markyen001/DR4/IMG_20181126_221511.jpg

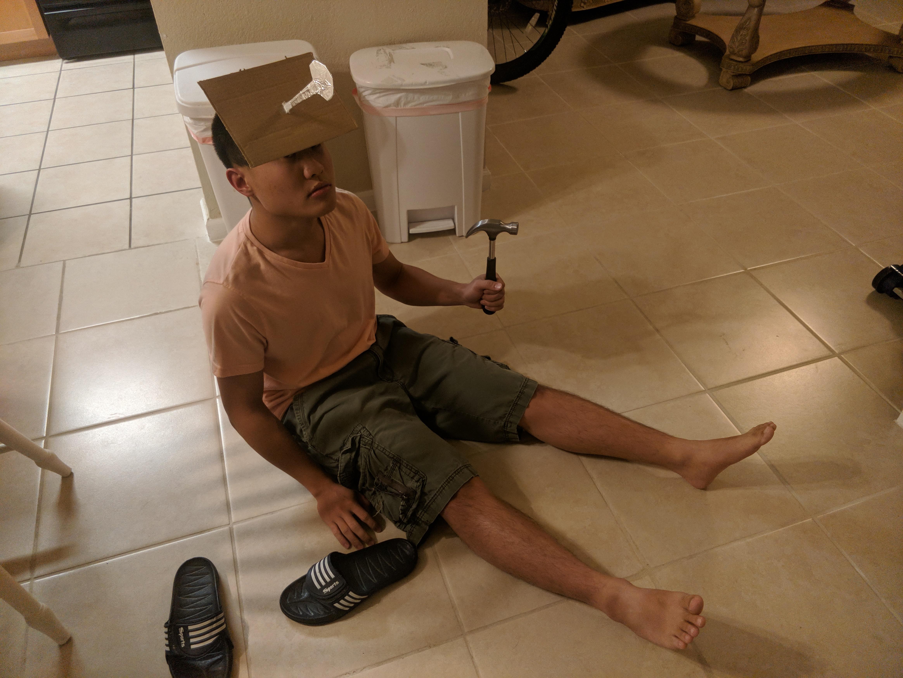
IMG_20181126_221511.jpg
