markyen001/DR4/IMG-1021442271.jpg

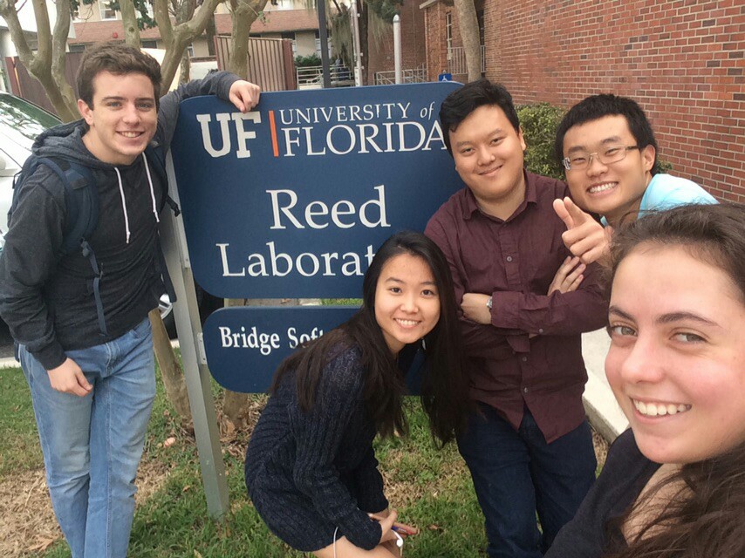
IMG-1021442271.jpg
