markyen001/DR4/Cover Pages.docx

Appendix E: Final Budget & Purchase Orders

Appendix F: Engineering Change Notice Forms

Appendix H: Final Assembly Drawings & BOM
