markyen001/DR4/Memes.docx

When you pull a few all-nighters in succession for a DR submission.

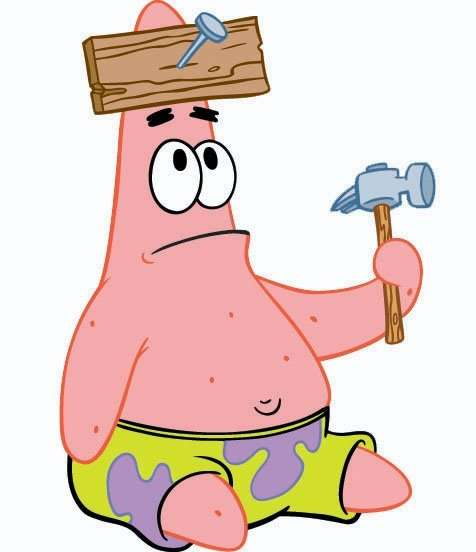
[picture p3: figure]
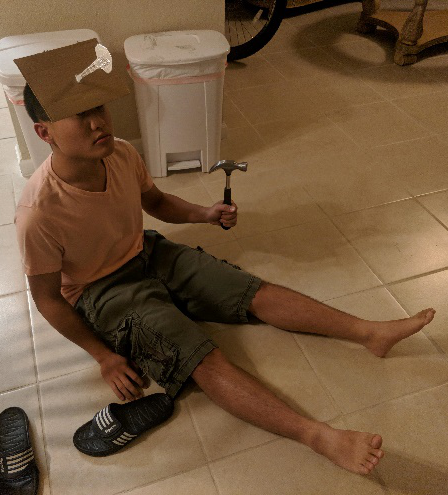
[picture p4: figure]
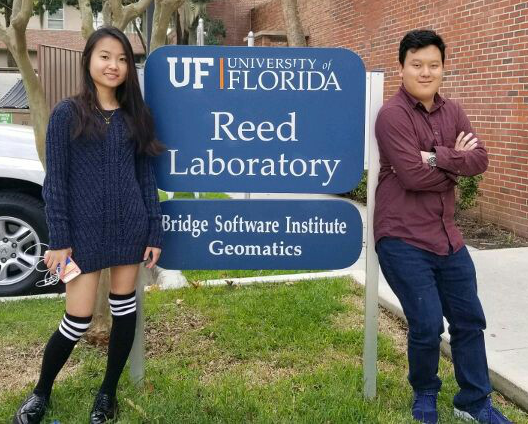
[picture p5: figure]
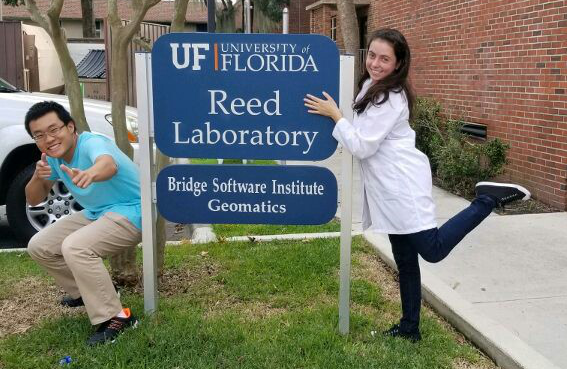
[picture p6: figure]
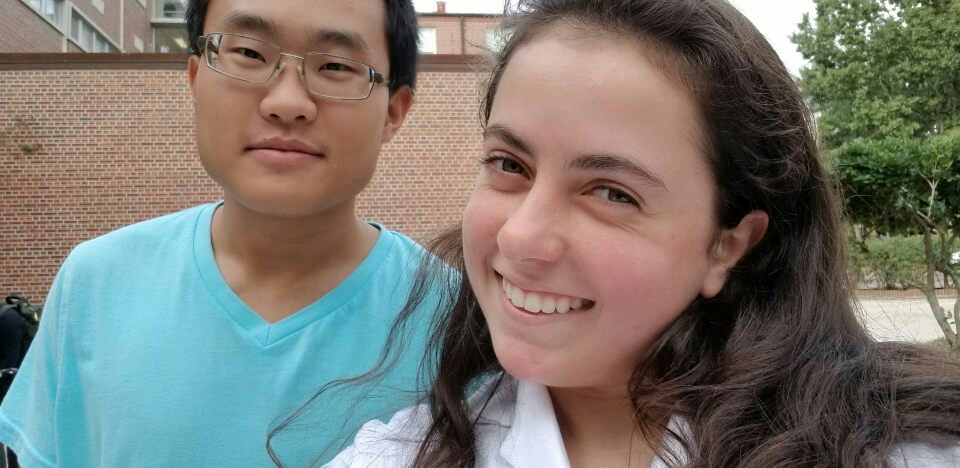
[picture p7: figure]
