markyen001/DR4/IMG714396138.jpg

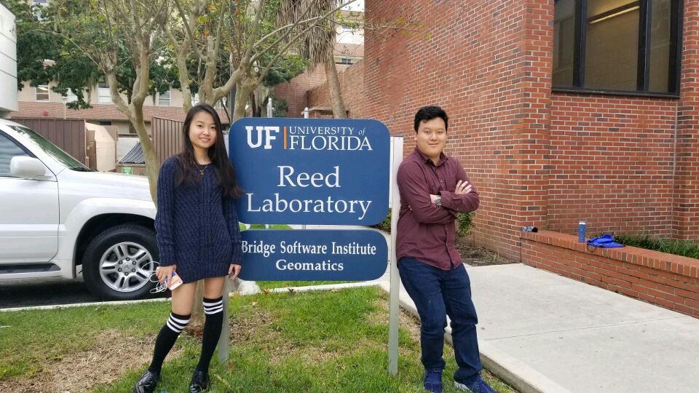
IMG714396138.jpg
