markyen001/DR4/IMG-729822996.jpg

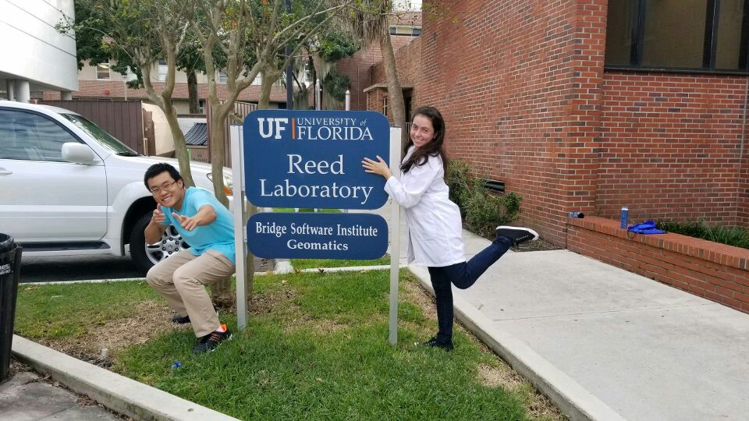
IMG-729822996.jpg
