markyen001/DR4/Drawings for PRINT/order of documents.docx

1. 0001 – 80/20 EXTRUSION
2. TITANIUM COUNTERWEIGHT
3. RUBBER PADS
4. A9 – BALL MANIPULATOR TOTAL ASSEMBLY
  a. 0034 – BALL MANIPULATOR CHANNEL
  b. A6 – CLAW ASSEMBLY
    i. 0004 – 80/20 90 DEG ANGLE BRACKET
    ii. 0007 – 80/20 STRAIGHT BRACKET
    iii. 0037 – 80/20 LINEAR SLIDE
    iv. 0039 – 10-24 LINEAR ACTUATOR MOUNT
    v. 0040 – 30 IPM SPAL LINEAR ACTUATOR (2in)
  c. A7 – CLAW MOUNT
  d. A8 – GLOBE MOTOR BRACKET ASSEMBLY
  e. A12 – 4.5 RPM GLOBE MOTOR
5. A16 – PLATFORM WITH BOX/HOPPER/BUCKET
  a. A14 – HOPPER/BUCKET ASSEMBLY
    i. A5 – BUCKET MANIPULATOR TOTAL ASSEMBLY
      1. A4 – BUCKET MANIPULATOR
        a. A10 – 90-DEGREE BRACKET ASSEMBLY
        b. A11 – STRAIGHT BRACKET ASSEMBLY
    ii. A13 – HOPPER ASSEMBLY
      1. 0018 – BALL HOPPER
  b. A15 – PLATFORM WITH CONTROL BOX
    i. 0017 – CONTROL BOX
    ii. A3 – PLATFORM WITH WHEELS
      1. 0016 – 5 in CASTER WHEEL
      2. A1 – MOBILE PLATFORM FRAME
      3. A2 – WHEEL AND MOTOR ASSEMBLY
        a. 0008 – 44 RPM ENTSTORT RIGHT ANGLE MOTOR
        b. 0009 – ENTSTORT MOTOR MOUNT
        c. 0011 – DRIVE WHEEL HUB
        d. 0012 – 10 in WHEEL
