markyen001/DR4/Drawings for PRINT/Assembly BOM.xls

ITEM NO. | PART NUMBER | DESCRIPTION | QTY.
A0 | EML2322L-A-000 | FINAL TOTAL ASSEMBLY | 1
A1 | EML2322L-A-001 | MOBILE PLATFORM FRAME ASSEMBLY | 1
A2 | EML2322L-A-002 | WHEEL AND MOTOR ASSEMBLY | 1
A3 | EML2322L-A-003 | PLATFORM WITH WHEELS ASSEMBLY | 1
A4 | EML2322L-A-004 | BUCKET MANIPULATOR ASSEMBLY | 1
A5 | EML2322L-A-005 | BUCKET MANIPULATOR TOTAL ASSEMBLY | 1
A6 | EML2322L-A-006 | CLAW ASSEMBLY | 1
A7 | EML2322L-A-007 | CLAW MOUNT ASSEMBLY | 1
A8 | EML2322L-A-008 | GLOBE MOTOR BRACKET ASSEMBLY | 1
A9 | EML2322L-A-009 | BALL MANIPULATOR TOTAL ASSEMBLY | 1
A10 | EML2322L-A-010 | 90-DEGREE BRACKET ASSEMBLY | 1
A11 | EML2322L-A-011 | STRAIGHT BRACKET ASSEMBLY | 1
A12 | EML2322L-A-012 | 4.5 RPM GLOBE MOTOR ASSEMBLY | 1
A13 | EML2322L-A-013 | HOPPER ASSEMBLY | 1
A14 | EML2322L-A-014 | HOPPER/BUCKET ASSEMBLY | 1
A15 | EML2322L-A-015 | PLATFORM WITH CONTROL BOX ASSEMBLY | 1
A16 | EML2322L-A-016 | PLATFORM WITH BOX/HOPPER/BUCKET ASSEMBLY | 1
