markyen001/DR4/Part and Assembly Files/BM MASTER ASM.SLDASM

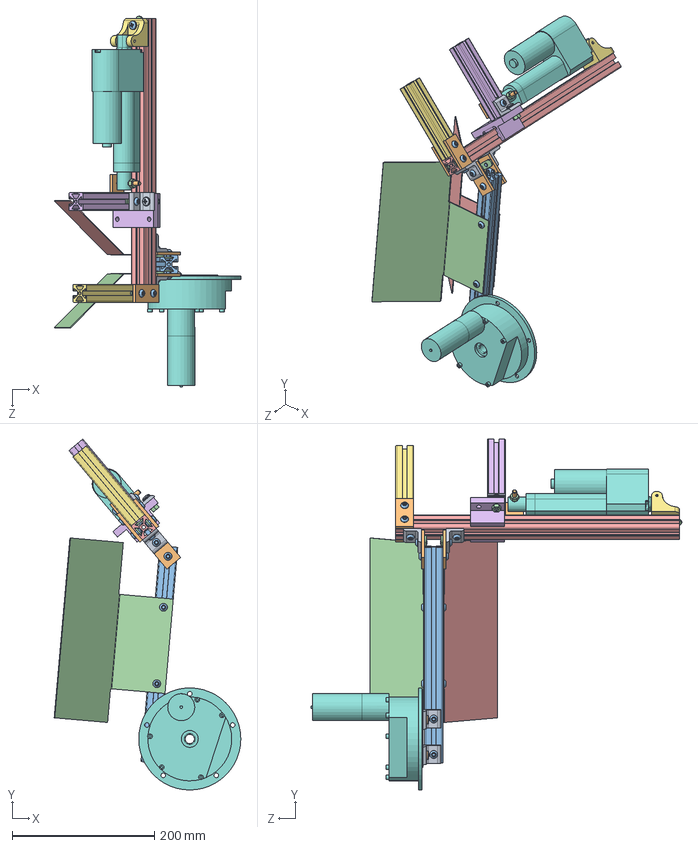
[picture p10: CAD file, 2018-11-24]
Part and Assembly Files/BM MASTER ASM.SLDASM
262.6 x 493.8 x 521.4 mm
80-20 90 Degree Angle Bracket x 5
80-20 Straight Bracket x 5
0.25-20 Button Head Cap Screw (BHCS) x 18
80-20 0.25-20 T-NUT x 17
BM 8020
80-20 Linear Slide
Linear Actuator Mount (10-24)
30 IPM Spal Linear Actuator (2in)
90272A540_ZINC-PLTD STL PAN HEAD PHILLIPS MACHINE SCREW
91306A281_ZINC-PLATED ALLOY STEEL BUTTON-HEAD CAP SCREW
90272A539_ZINC-PLTD STL PAN HEAD PHILLIPS MACHINE SCREW
94895A029_ZINC YELLOW-CHROMATE PLATED STEEL HEX NUT x 2
91251A249_BLACK-OXIDE ALLOY STEEL SOCKET HEAD SCREW
80-20 Extrusion 4.5 inch
80-20 Extrusion 5 inch (simplified)
4.5 RPM Globe Gear Motor
4.5 RPM Globe Gear Motor Face Hub
M6x1 - 12mm GLOBE MOTOR SCREW x 2
BM ARM
BM ARM CHANNEL GM SIDE
BM ARM CHANNEL LEFT, ECN 15
