markyen001/DR4/Part and Assembly Files/BM Mounting SUBASM.SLDASM

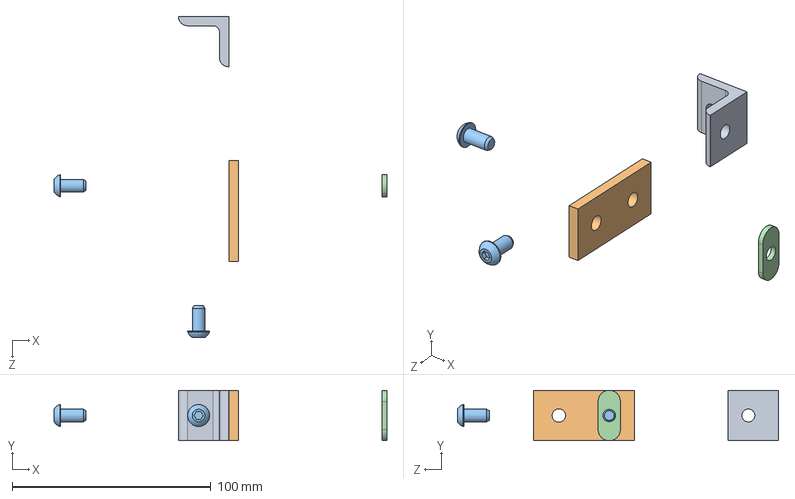
[picture p11: CAD file, 2018-11-24]
Part and Assembly Files/BM Mounting SUBASM.SLDASM
167.6 x 25.4 x 161.7 mm
80-20 90 Degree Angle Bracket
80-20 Straight Bracket
0.25-20 Button Head Cap Screw (BHCS) x 2
80-20 0.25-20 T-NUT
