markyen001/DR4/Globe Motor Drawings/4.5 RPM Globe Gear Motor Assembly.SLDASM

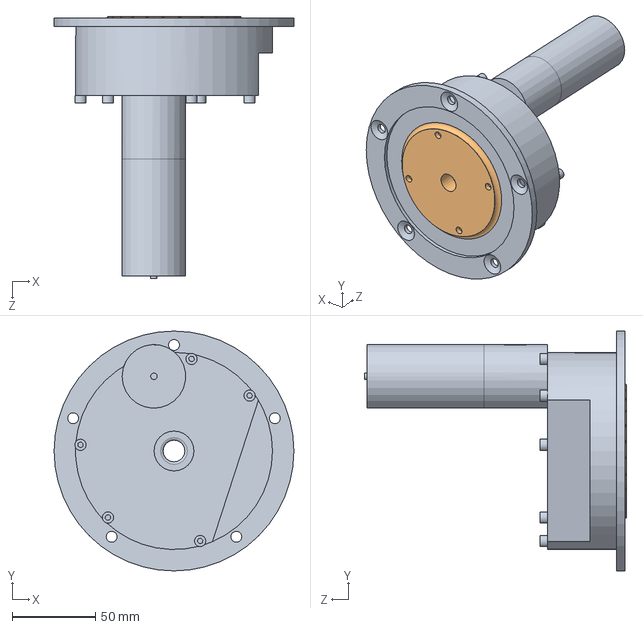
[picture p12: CAD file, 2018-11-23]
Globe Motor Drawings/4.5 RPM Globe Gear Motor Assembly.SLDASM
143.6 x 143.6 x 156.9 mm
4.5 RPM Globe Gear Motor
4.5 RPM Globe Gear Motor Face Hub
