markyen001/DR4/Part and Assembly Files/BM Claw SUBASM.SLDASM

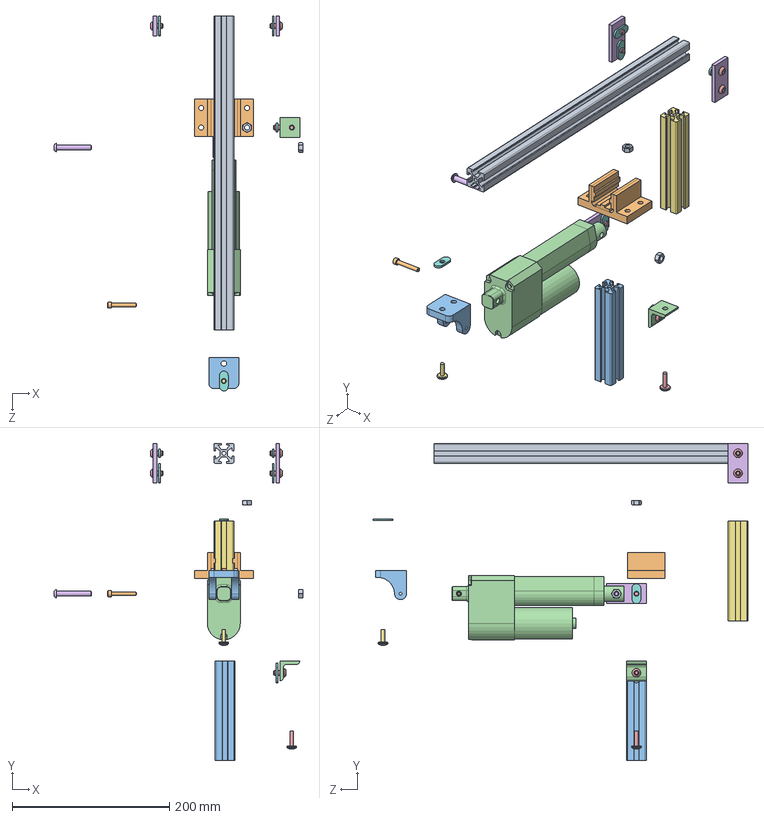
[picture p13: CAD file, 2018-11-24]
Part and Assembly Files/BM Claw SUBASM.SLDASM
316.6 x 403.7 x 476.9 mm
BM 8020
80-20 Linear Slide
Linear Actuator Mount (10-24)
30 IPM Spal Linear Actuator (2in)
90272A540_ZINC-PLTD STL PAN HEAD PHILLIPS MACHINE SCREW
91306A281_ZINC-PLATED ALLOY STEEL BUTTON-HEAD CAP SCREW
90272A539_ZINC-PLTD STL PAN HEAD PHILLIPS MACHINE SCREW
80-20 0.25-20 T-NUT x 7
94895A029_ZINC YELLOW-CHROMATE PLATED STEEL HEX NUT x 2
91251A249_BLACK-OXIDE ALLOY STEEL SOCKET HEAD SCREW
80-20 Extrusion 4.5 inch
80-20 90 Degree Angle Bracket
0.25-20 Button Head Cap Screw (BHCS) x 6
80-20 Straight Bracket x 3
80-20 Extrusion 5 inch (simplified)
