markyen001/DR4/Part and Assembly Files/Bucket Manipulator Total Assembly.SLDASM

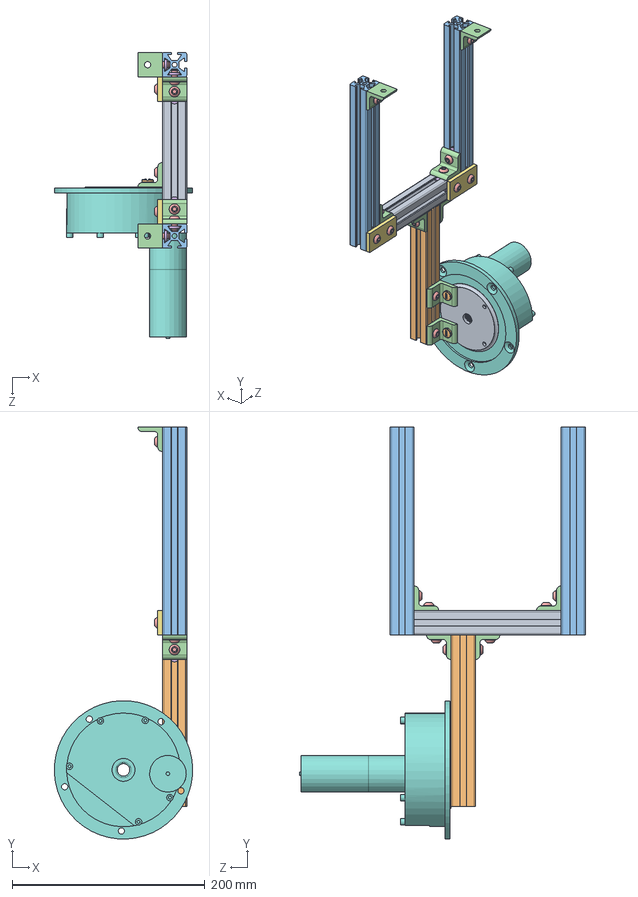
[picture p14: CAD file, 2018-11-23]
Part and Assembly Files/Bucket Manipulator Total Assembly.SLDASM
143.5 x 427.7 x 296.9 mm
80-20 Extrusion 6 in
80-20 Extrusion 7 inch (simplified)
80-20 Extrusion 8.5 inch (simplified) x 2
80-20 90 Degree Angle Bracket x 8
0.25-20 Button Head Cap Screw (BHCS) x 16
80-20 0.25-20 T-NUT x 16
80-20 Straight Bracket x 2
4.5 RPM Globe Gear Motor
4.5 RPM Globe Gear Motor Face Hub
M6x1 - 12mm GLOBE MOTOR SCREW x 2
