markyen001/DR4/Part and Assembly Files/Hopper and Bucket Manipulator Assembly.SLDASM

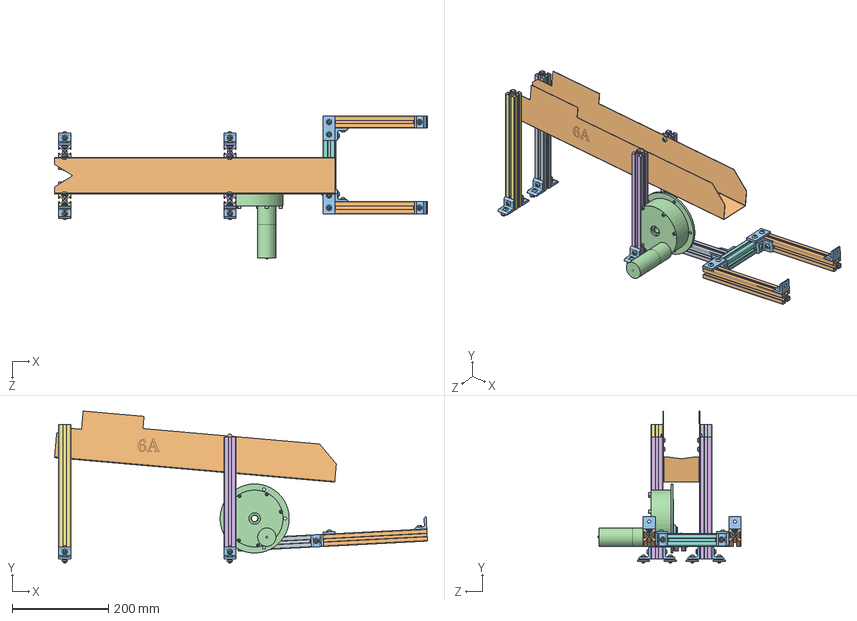
[picture p15: CAD file, 2018-11-23]
Part and Assembly Files/Hopper and Bucket Manipulator Assembly.SLDASM
774.5 x 315.4 x 296.9 mm
0019 BALL HOPPER
80-20 90 Degree Angle Bracket x 16
0.25-20 Button Head Cap Screw (BHCS) x 36
80-20 0.25-20 T-NUT x 38
80-20 Extrusion 10 in x 2
80-20 Extrusion 11 in x 2
80-20 Extrusion 6 in
80-20 Extrusion 7 inch (simplified)
80-20 Extrusion 8.5 inch (simplified) x 2
80-20 Straight Bracket x 2
4.5 RPM Globe Gear Motor
4.5 RPM Globe Gear Motor Face Hub
M6x1 - 12mm GLOBE MOTOR SCREW x 2
0.25-20 x 1 in FLAT HEAD SCREW x 2
