markyen001/DR4/Part and Assembly Files/GM ASM.SLDASM

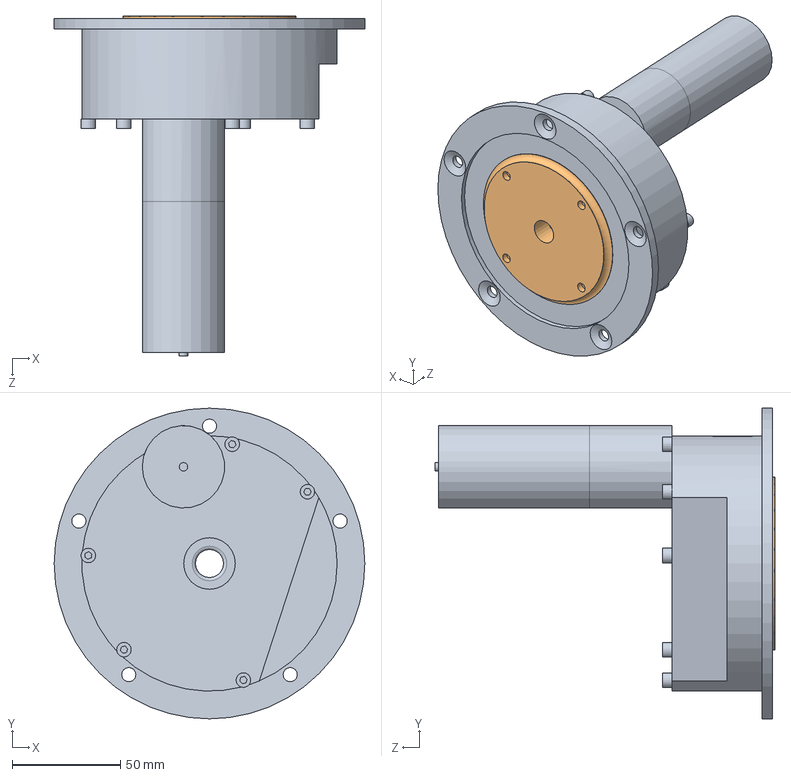
[picture p16: CAD file, 2018-11-23]
Part and Assembly Files/GM ASM.SLDASM
143.6 x 143.6 x 157.2 mm
4.5 RPM Globe Gear Motor
4.5 RPM Globe Gear Motor Face Hub
