markyen001/DR4/Part and Assembly Files/PLATFORM WITH WHEELS.SLDASM

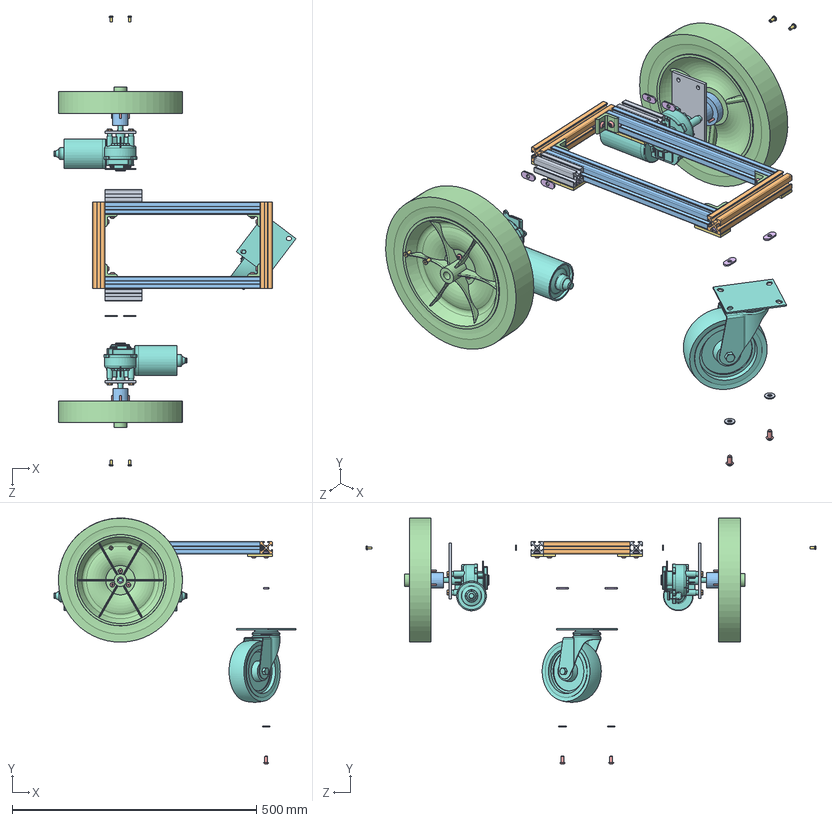
[picture p17: CAD file, 2018-11-23]
Part and Assembly Files/PLATFORM WITH WHEELS.SLDASM
495.7 x 503.6 x 920.9 mm
80-20 Extrusion 3 inch (simplified) x 2
80-20 Extrusion 7 inch (simplified) x 2
80-20 Extrusion 12.5 inch (simplified) x 2
80-20 90 Degree Angle Bracket x 4
0.25-20 Button Head Cap Screw (BHCS) x 26
80-20 0.25-20 T-NUT x 30
80-20 Straight Bracket x 8
44 RPM Entstort Right Angle Gear Motor x 2
Motor Mount x 2
Entstort Screw x 6
Wheel Hub x 2
10 Inch Wheel x 2
0013 10-24 x 1.25 in PHILIPS HEAD SCREW x 6
M8 x 1.25 mm HEX NUT x 2
10-24 x 3-8 Socket Screw for Mount x 4
Caster Wheel
WASHER x 2
