markyen001/DR4/Part and Assembly Files/90-DEGREE BRACKET ASSEMBLY.SLDASM

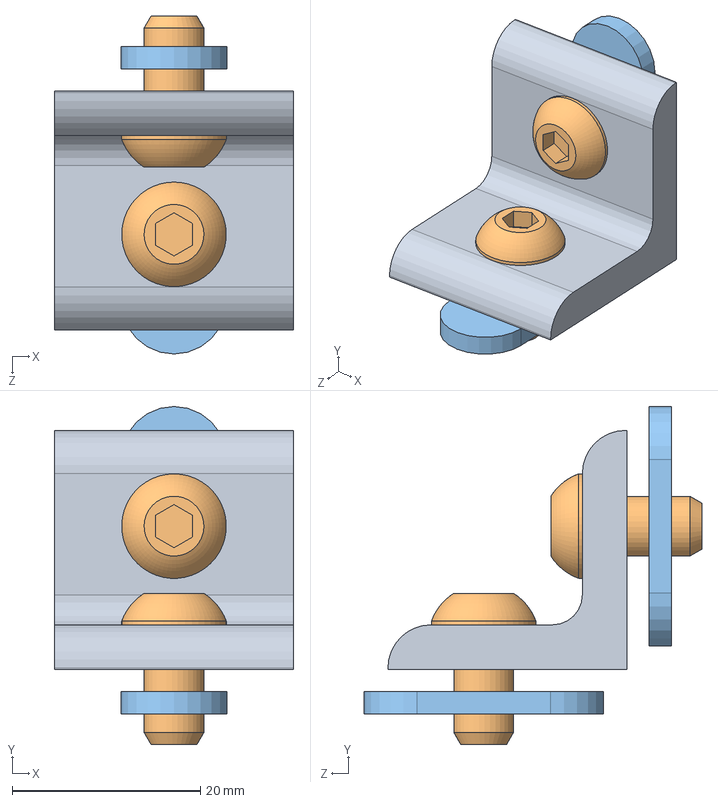
[picture p18: CAD file, 2018-11-22]
Part and Assembly Files/90-DEGREE BRACKET ASSEMBLY.SLDASM
25.4 x 35.9 x 35.9 mm
80-20 90 Degree Angle Bracket
0.25-20 Button Head Cap Screw (BHCS) x 2
80-20 0.25-20 T-NUT x 2
