markyen001/DR4/Part and Assembly Files/MOBILE PLATFORM FRAME.SLDASM

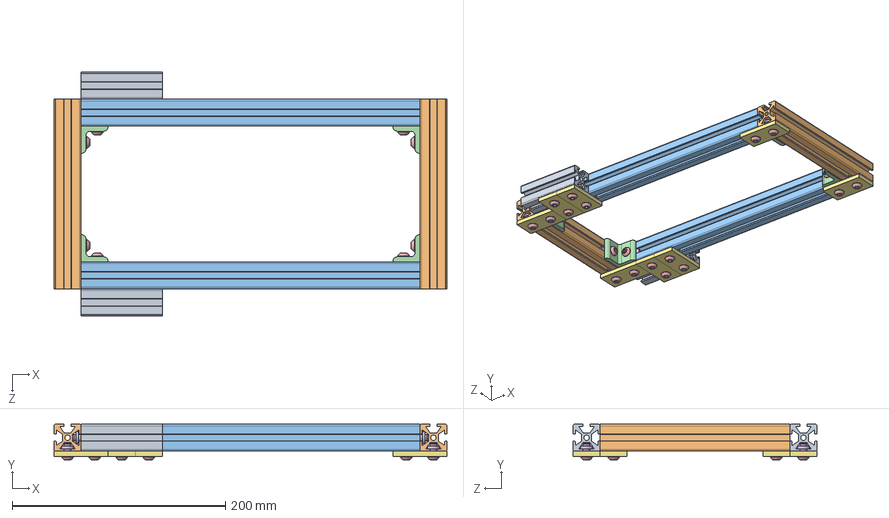
[picture p19: CAD file, 2018-11-22]
Part and Assembly Files/MOBILE PLATFORM FRAME.SLDASM
368.3 x 33.5 x 228.6 mm
80-20 Extrusion 3 inch (simplified) x 2
80-20 Extrusion 7 inch (simplified) x 2
80-20 Extrusion 12.5 inch (simplified) x 2
80-20 90 Degree Angle Bracket x 4
0.25-20 Button Head Cap Screw (BHCS) x 24
80-20 0.25-20 T-NUT x 24
80-20 Straight Bracket x 8
