markyen001/DR4/Part and Assembly Files/STRAIGHT BRACKET ASSEMBLY.SLDASM

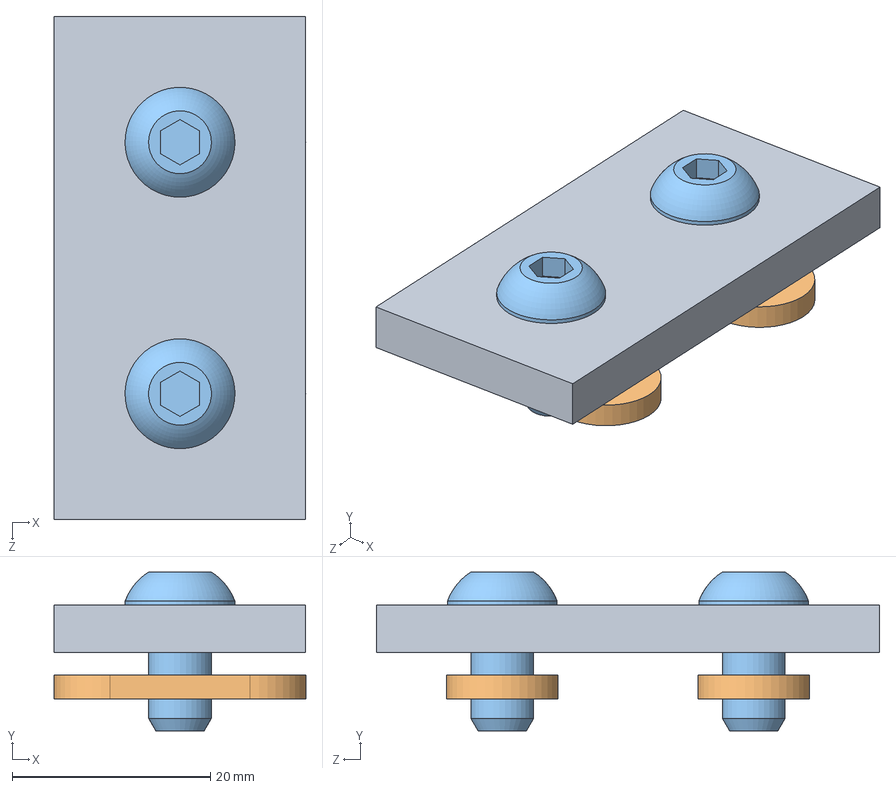
[picture p20: CAD file, 2018-11-22]
Part and Assembly Files/STRAIGHT BRACKET ASSEMBLY.SLDASM
25.4 x 16.1 x 50.8 mm
80-20 Straight Bracket
80-20 0.25-20 T-NUT x 2
0.25-20 Button Head Cap Screw (BHCS) x 2
