markyen001/DR4/Part and Assembly Files/BUCKET GRABBER ASSEMBLY.SLDASM

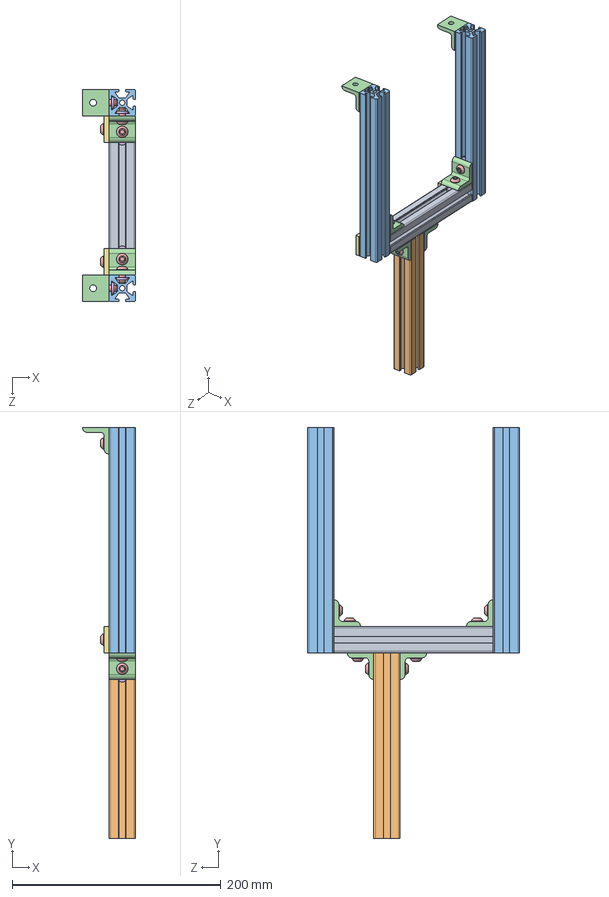
[picture p21: CAD file, 2018-11-22]
Part and Assembly Files/BUCKET GRABBER ASSEMBLY.SLDASM
50.8 x 393.7 x 203.2 mm
80-20 Extrusion 6 in
80-20 Extrusion 7 inch (simplified)
80-20 Extrusion 8.5 inch (simplified) x 2
80-20 90 Degree Angle Bracket x 6
0.25-20 Button Head Cap Screw (BHCS) x 14
80-20 0.25-20 T-NUT x 14
80-20 Straight Bracket x 2
