markyen001/DR4/Part and Assembly Files/80-20 Extrusion - List.SLDASM

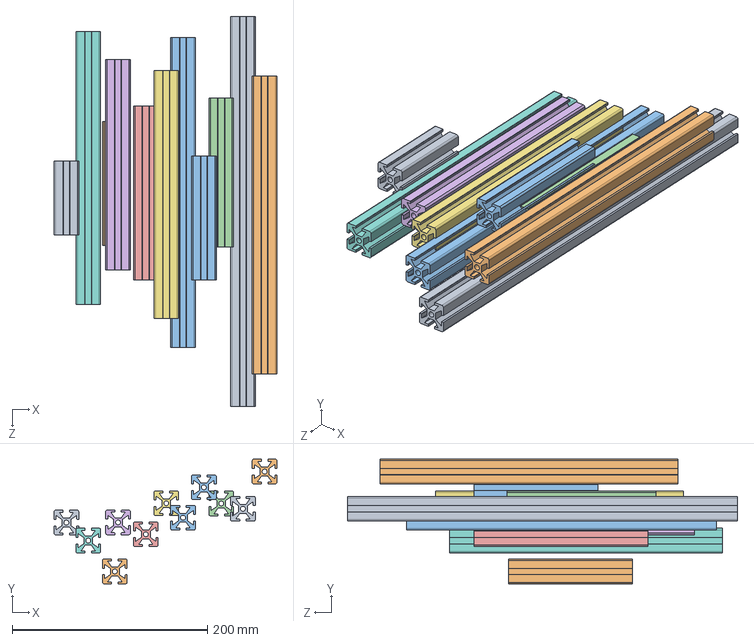
[picture p22: CAD file, 2018-11-22]
Part and Assembly Files/80-20 Extrusion - List.SLDASM
228.4 x 127.7 x 399.5 mm
