markyen001/DR4/Part and Assembly Files/A013 HOPPER ASSEMBLY.SLDASM

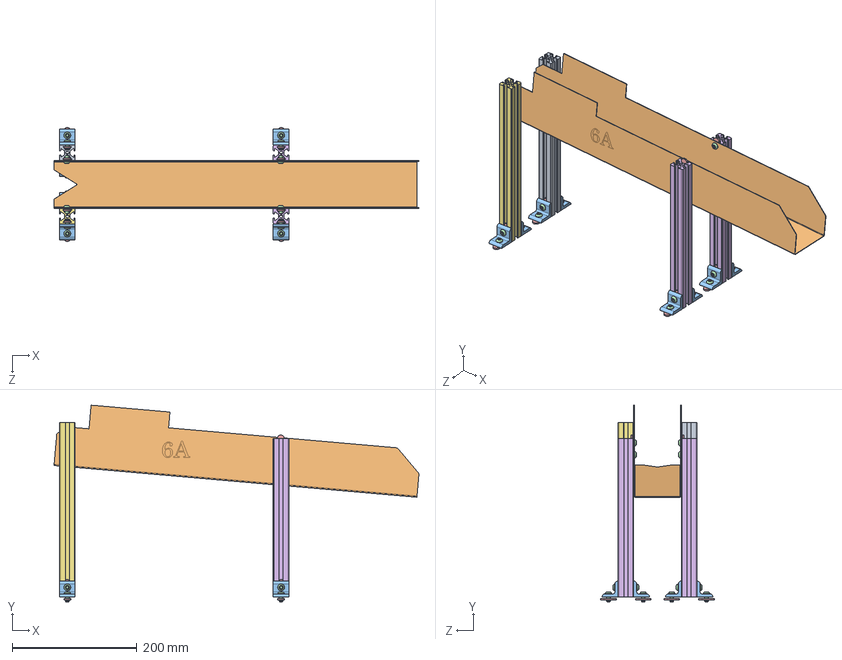
[picture p23: CAD file, 2018-11-22]
Part and Assembly Files/A013 HOPPER ASSEMBLY.SLDASM
585.3 x 315.4 x 182.9 mm
0019 BALL HOPPER
80-20 90 Degree Angle Bracket x 8
0.25-20 Button Head Cap Screw (BHCS) x 20
80-20 0.25-20 T-NUT x 20
80-20 Extrusion 10 in x 2
80-20 Extrusion 11 in x 2
