markyen001/DR4/Part and Assembly Files/Wheel Hub Assembly.SLDASM

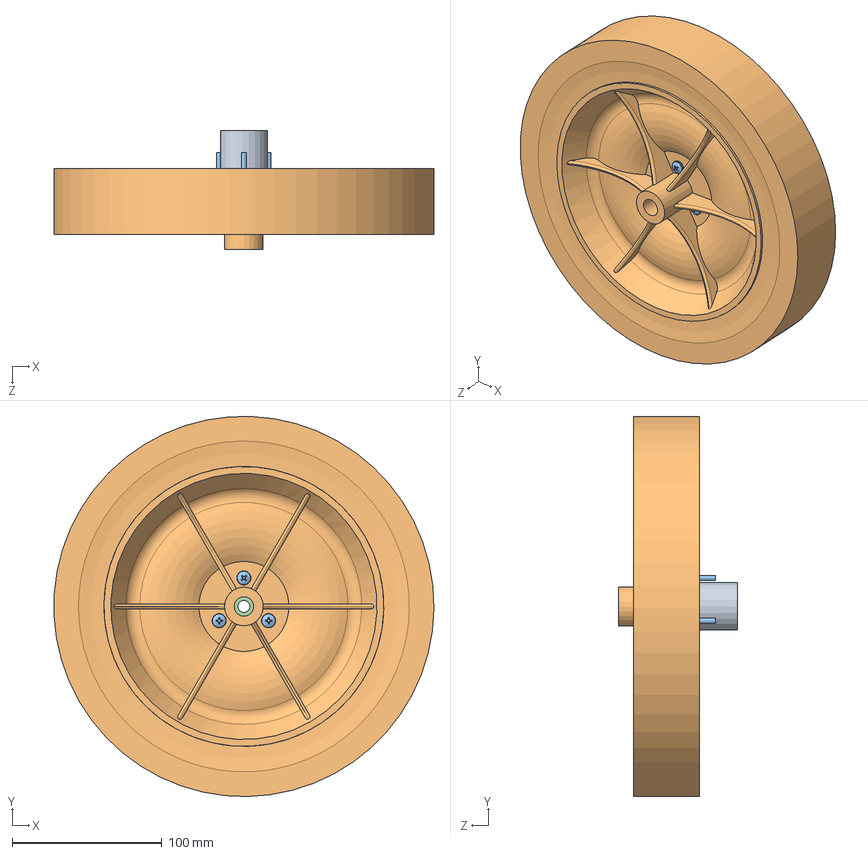
[picture p25: CAD file, 2018-11-03]
Part and Assembly Files/Wheel Hub Assembly.SLDASM
253.8 x 253.9 x 79.4 mm
Wheel Hub
10 Inch Wheel
0013 10-24 x 1.25 in PHILIPS HEAD SCREW x 3
M8 x 1.25 mm HEX NUT
