markyen001/DR4/Part and Assembly Files/Wheel and Motor Total Assembly.SLDASM

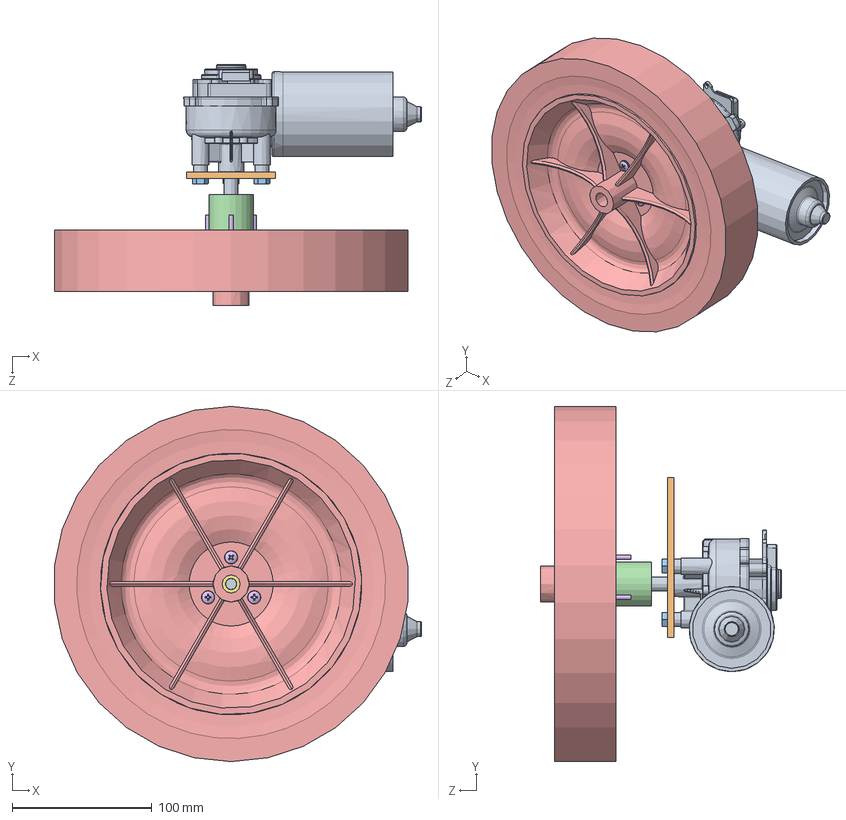
[picture p26: CAD file, 2018-11-03]
Part and Assembly Files/Wheel and Motor Total Assembly.SLDASM
262.4 x 254.0 x 172.4 mm
44 RPM Entstort Right Angle Gear Motor
Motor Mount
Entstort Screw x 3
Wheel Hub
10 Inch Wheel
0013 10-24 x 1.25 in PHILIPS HEAD SCREW x 3
M8 x 1.25 mm HEX NUT
