markyen001/DR4/Part and Assembly Files/Motor Mount Assembly.SLDASM

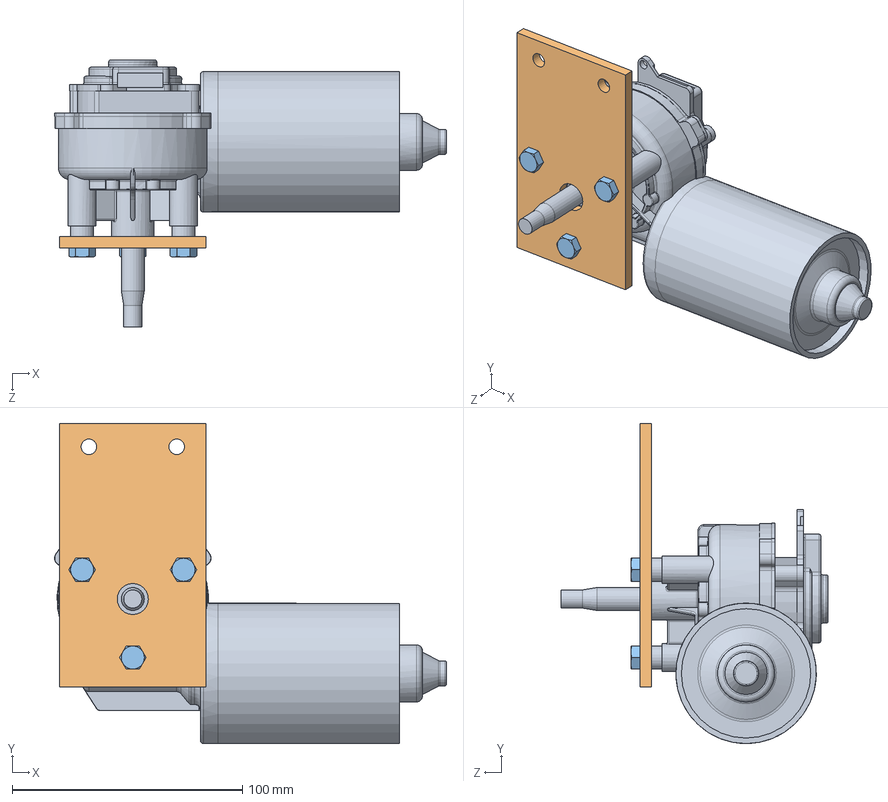
[picture p27: CAD file, 2018-11-03]
Part and Assembly Files/Motor Mount Assembly.SLDASM
170.1 x 138.9 x 116.0 mm
44 RPM Entstort Right Angle Gear Motor
Motor Mount
Entstort Screw x 3
