markyen001/DR4/Part and Assembly Files/BM 5IN CLAW SUBASM.SLDASM

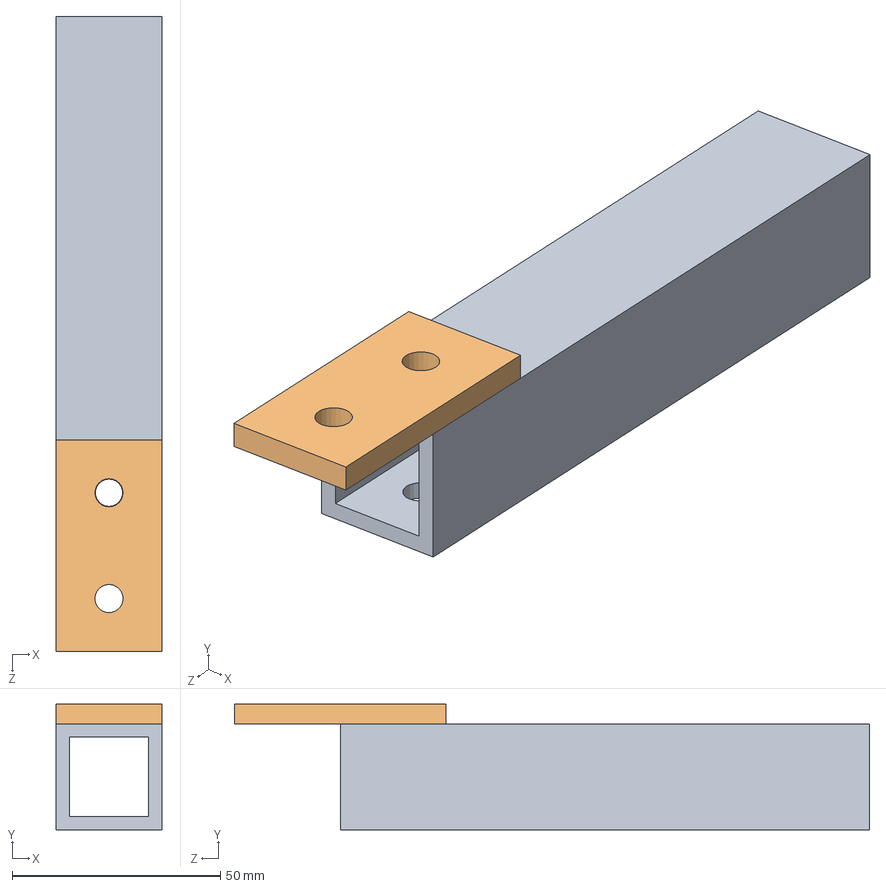
[picture p28: CAD file, 2018-10-13]
Part and Assembly Files/BM 5IN CLAW SUBASM.SLDASM
25.4 x 30.2 x 152.4 mm
BM 5in CLAW
80-20 Straight Bracket
