markyen001/DR4/Globe Motor Drawings/4.5 RPM Globe Gear Motor.SLDPRT

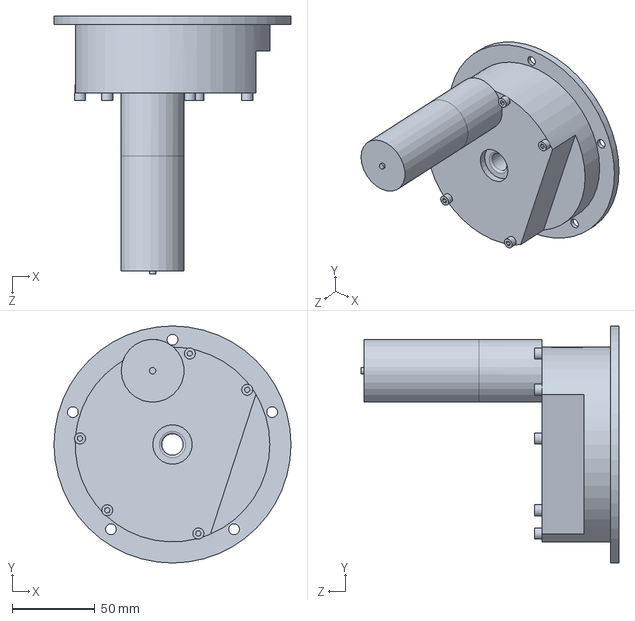
[picture p29: CAD file, 2018-11-23]
Globe Motor Drawings/4.5 RPM Globe Gear Motor.SLDPRT
143.6 x 143.6 x 156.1 mm
