markyen001/DR4/Globe Motor Drawings/4.5 RPM Globe Gear Motor Face Hub.SLDPRT

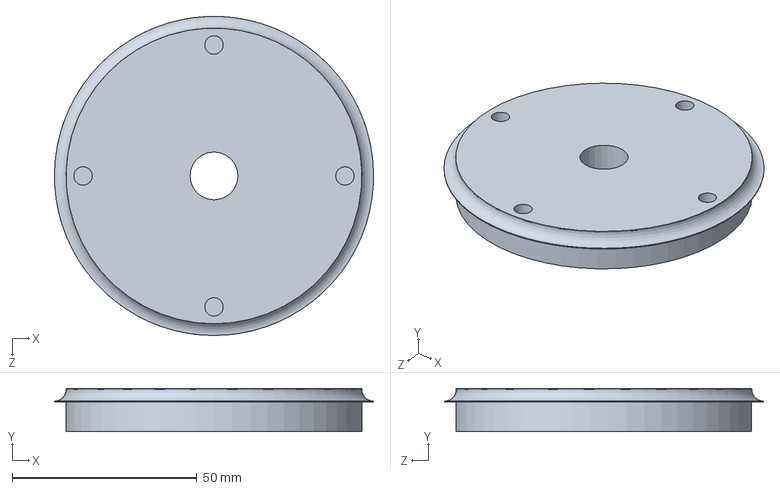
[picture p30: CAD file, 2018-11-23]
Globe Motor Drawings/4.5 RPM Globe Gear Motor Face Hub.SLDPRT
86.3 x 11.7 x 86.3 mm
