markyen001/DR4/Part and Assembly Files/RUBBER PADS.SLDPRT

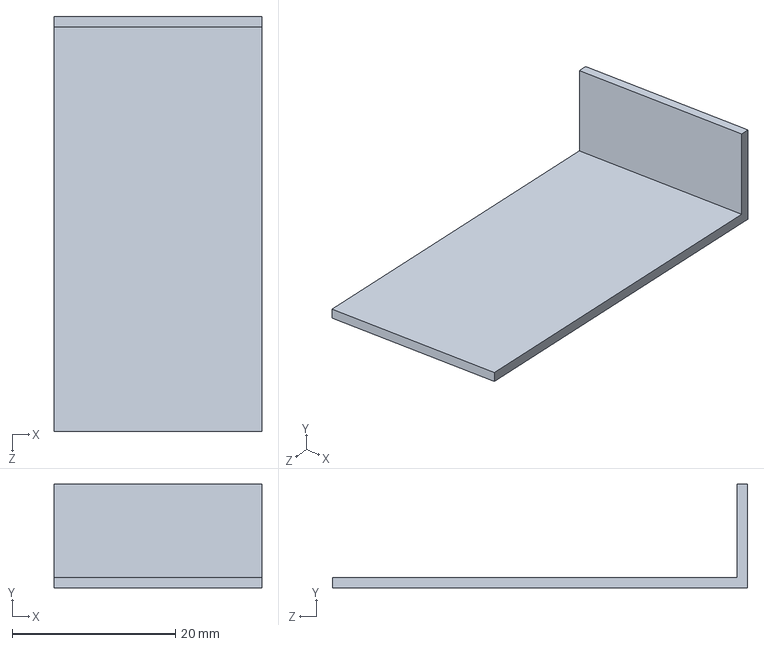
[picture p31: CAD file, 2018-11-23]
Part and Assembly Files/RUBBER PADS.SLDPRT
25.4 x 12.7 x 50.8 mm
