markyen001/DR4/Part and Assembly Files/TITANIUM COUNTERWEIGHT.SLDPRT

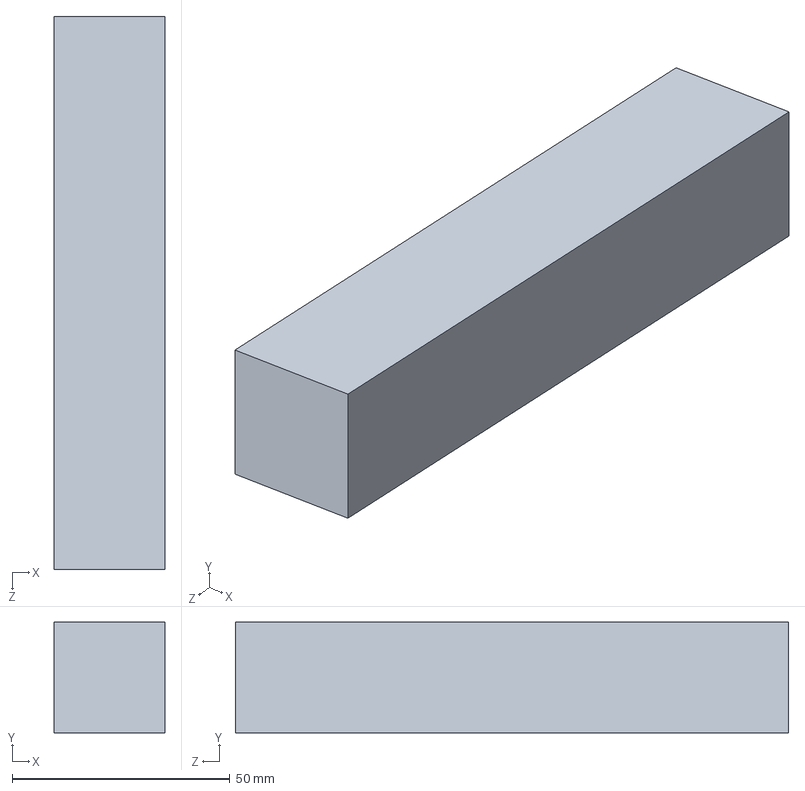
[picture p32: CAD file, 2018-11-23]
Part and Assembly Files/TITANIUM COUNTERWEIGHT.SLDPRT
25.4 x 25.4 x 127.0 mm
