markyen001/DR4/Part and Assembly Files/80-20 Extrusion 11 in.SLDPRT

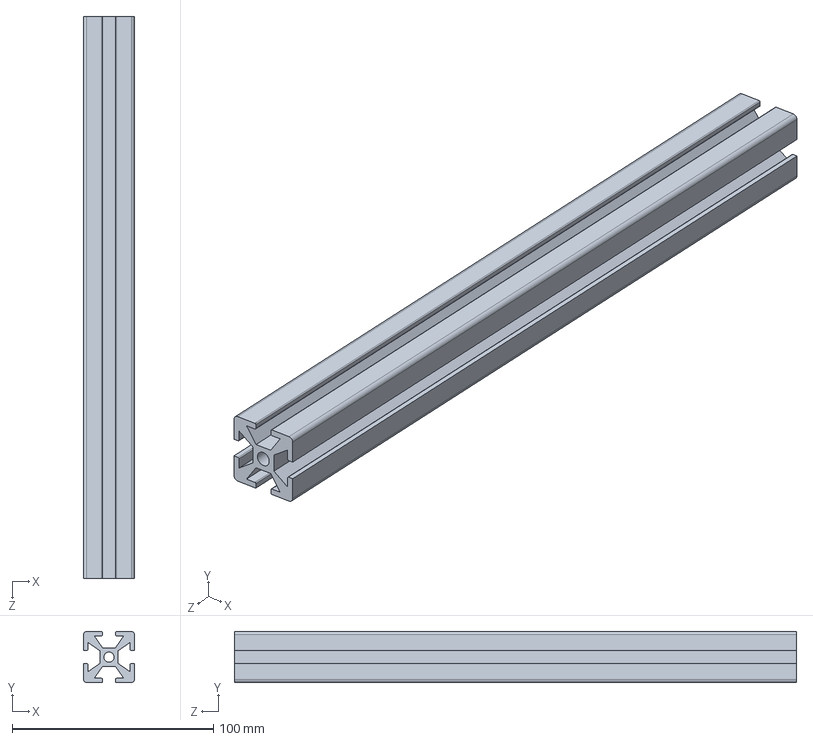
[picture p33: CAD file, 2018-11-22]
Part and Assembly Files/80-20 Extrusion 11 in.SLDPRT
25.4 x 25.4 x 279.4 mm
