markyen001/DR4/Part and Assembly Files/0019 BALL HOPPER.SLDPRT

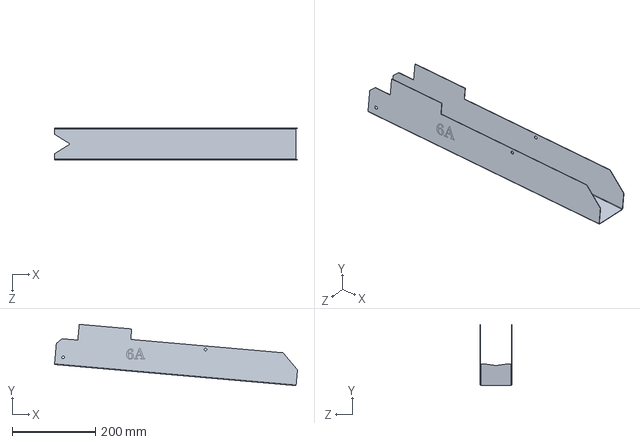
[picture p34: CAD file, 2018-11-08]
Part and Assembly Files/0019 BALL HOPPER.SLDPRT
585.3 x 147.7 x 76.2 mm
