markyen001/DR4/Part and Assembly Files/BM ARM CHANNEL UNFOLDED.SLDPRT

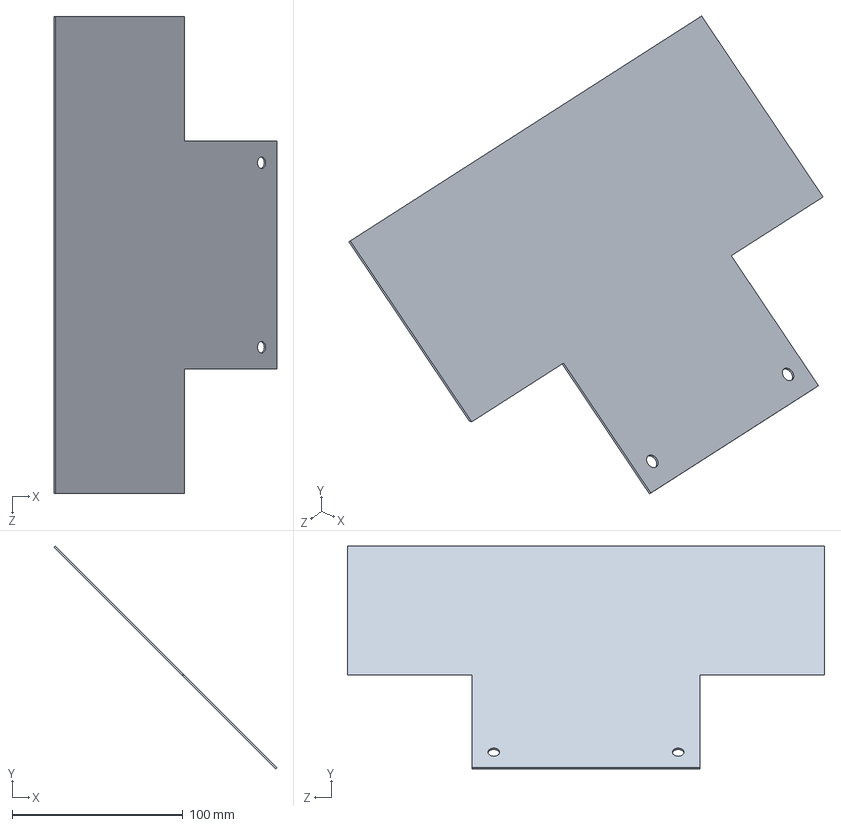
[picture p35: CAD file, 2018-11-07]
Part and Assembly Files/BM ARM CHANNEL UNFOLDED.SLDPRT
130.5 x 130.5 x 279.4 mm
