markyen001/DR4/Part and Assembly Files/BM ARM CHANNEL LEFT, ECN 15.SLDPRT

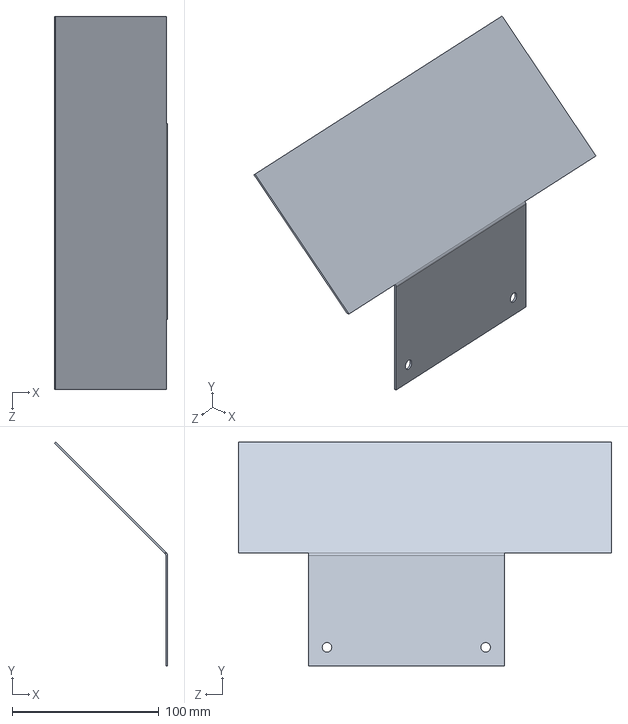
[picture p36: CAD file, 2018-11-01]
Part and Assembly Files/BM ARM CHANNEL LEFT, ECN 15.SLDPRT
77.1 x 152.4 x 254.0 mm
