markyen001/DR4/Part and Assembly Files/BM ARM CHANNEL LEFT, UNFOLDED,  ECN 15.SLDPRT

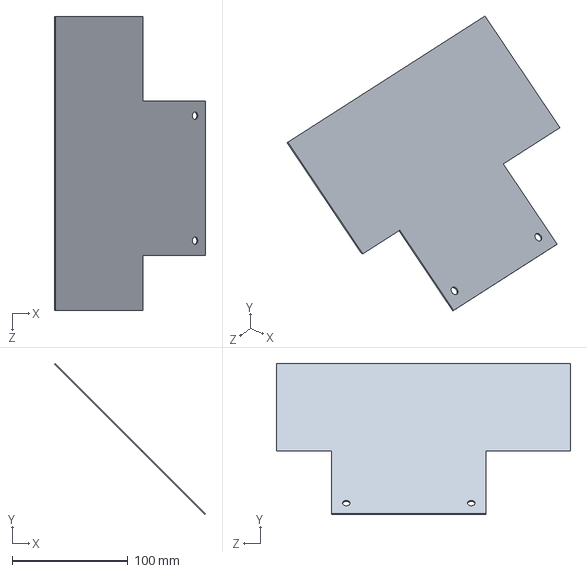
[picture p37: CAD file, 2018-11-01]
Part and Assembly Files/BM ARM CHANNEL LEFT, UNFOLDED, ECN 15.SLDPRT
130.5 x 130.5 x 254.0 mm
