markyen001/DR4/Part and Assembly Files/80-20 Extrusion 6 in.SLDPRT

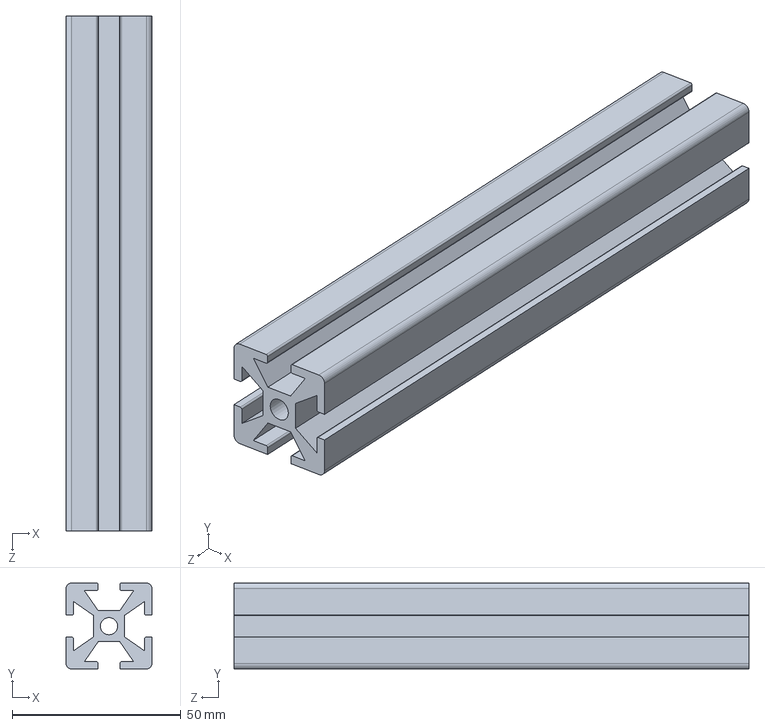
[picture p38: CAD file, 2018-11-01]
Part and Assembly Files/80-20 Extrusion 6 in.SLDPRT
25.4 x 25.4 x 152.4 mm
