markyen001/DR4/Part and Assembly Files/Caster Wheel.SLDPRT

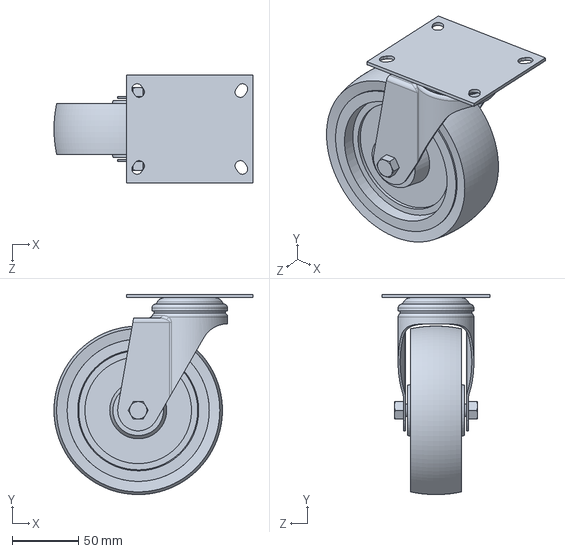
[picture p39: CAD file, 2018-10-30]
Part and Assembly Files/Caster Wheel.SLDPRT
149.9 x 150.8 x 81.3 mm
