markyen001/DR4/Part and Assembly Files/4.5 RPM Globe Gear Motor Face Hub.SLDPRT

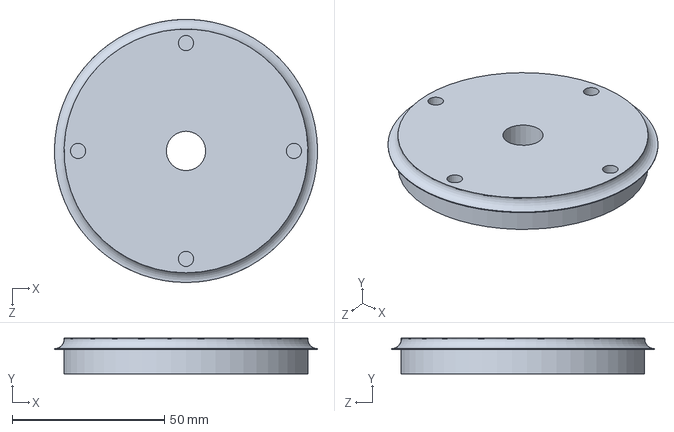
[picture p40: CAD file, 2018-10-25]
Part and Assembly Files/4.5 RPM Globe Gear Motor Face Hub.SLDPRT
86.3 x 11.7 x 86.3 mm
