markyen001/DR4/Part and Assembly Files/30 IPM Spal Linear Actuator (2in).SLDPRT

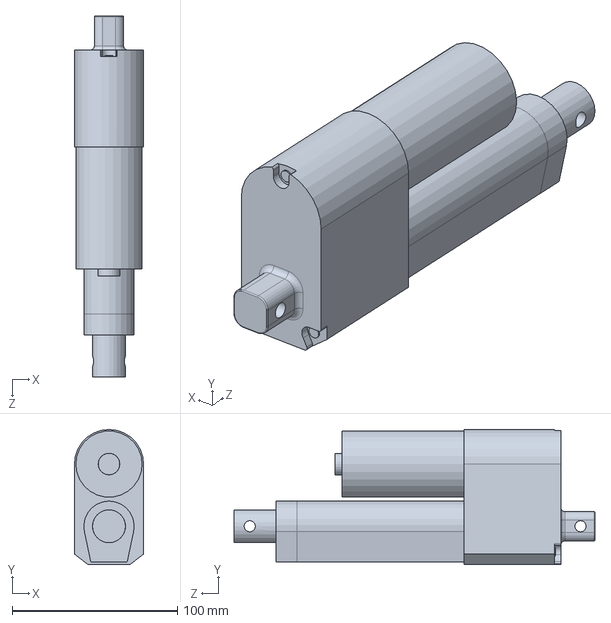
[picture p41: CAD file, 2018-10-25]
Part and Assembly Files/30 IPM Spal Linear Actuator (2in).SLDPRT
41.9 x 81.8 x 218.6 mm
