markyen001/DR4/Part and Assembly Files/Linear Actuator Mount (10-24).SLDPRT

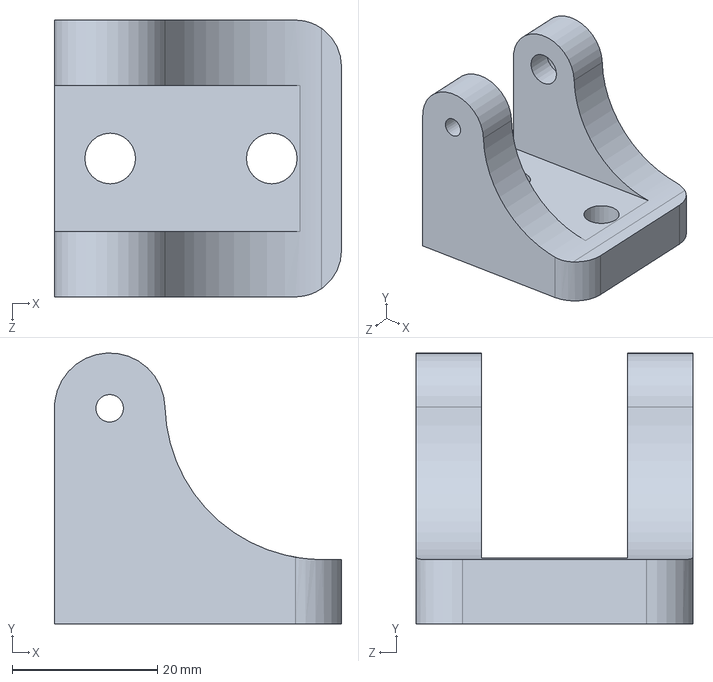
[picture p42: CAD file, 2018-10-25]
Part and Assembly Files/Linear Actuator Mount (10-24).SLDPRT
39.5 x 37.3 x 38.1 mm
