markyen001/DR4/Part and Assembly Files/80-20 Extrusion 4.5 inch.SLDPRT

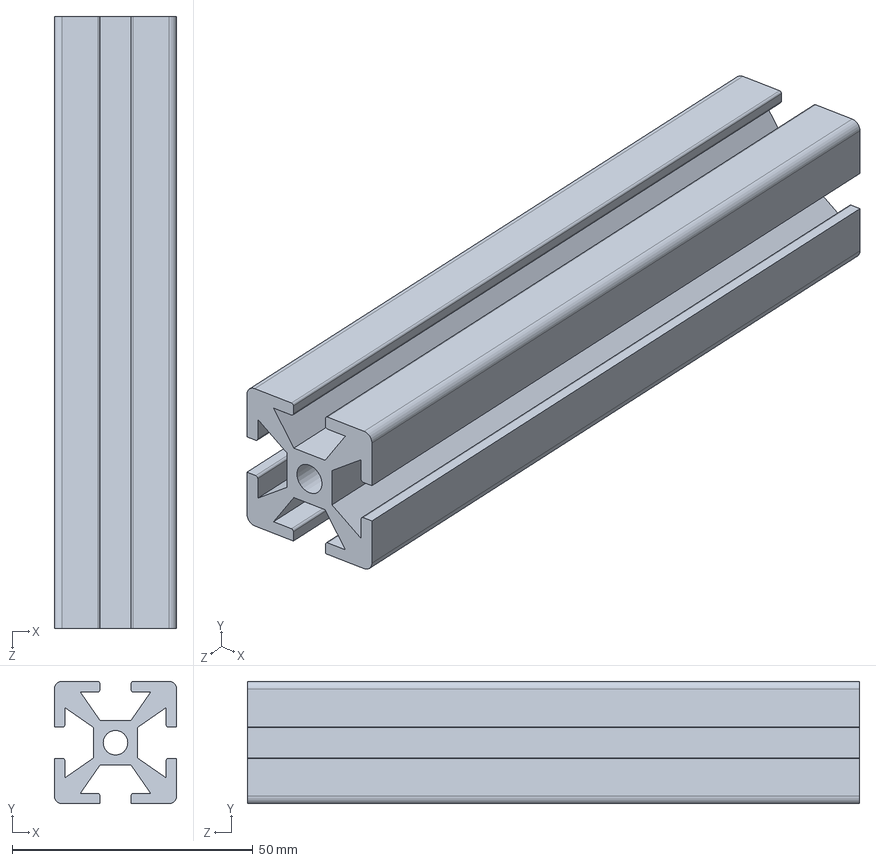
[picture p43: CAD file, 2018-10-25]
Part and Assembly Files/80-20 Extrusion 4.5 inch.SLDPRT
25.4 x 25.4 x 127.0 mm
