markyen001/DR4/Part and Assembly Files/80-20 Extrusion 8.5 inch (simplified).SLDPRT

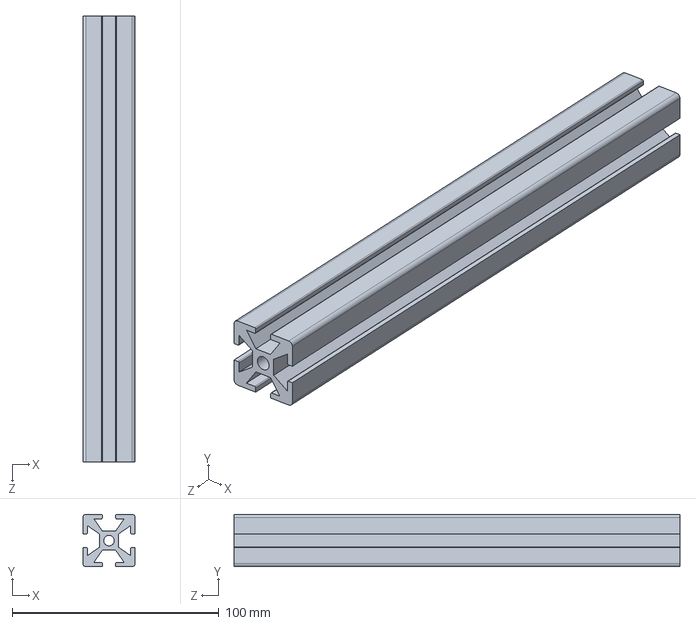
[picture p44: CAD file, 2018-10-15]
Part and Assembly Files/80-20 Extrusion 8.5 inch (simplified).SLDPRT
25.4 x 25.4 x 215.9 mm
