markyen001/DR4/Part and Assembly Files/BM 8020.SLDPRT

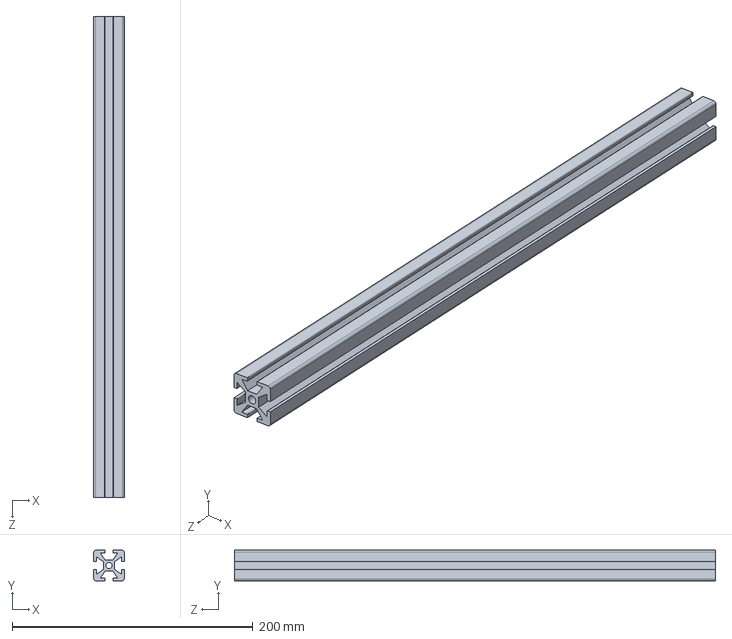
[picture p45: CAD file, 2018-10-15]
Part and Assembly Files/BM 8020.SLDPRT
25.4 x 25.4 x 399.5 mm
