markyen001/DR4/Part and Assembly Files/80-20 Extrusion 3 inch (simplified).SLDPRT

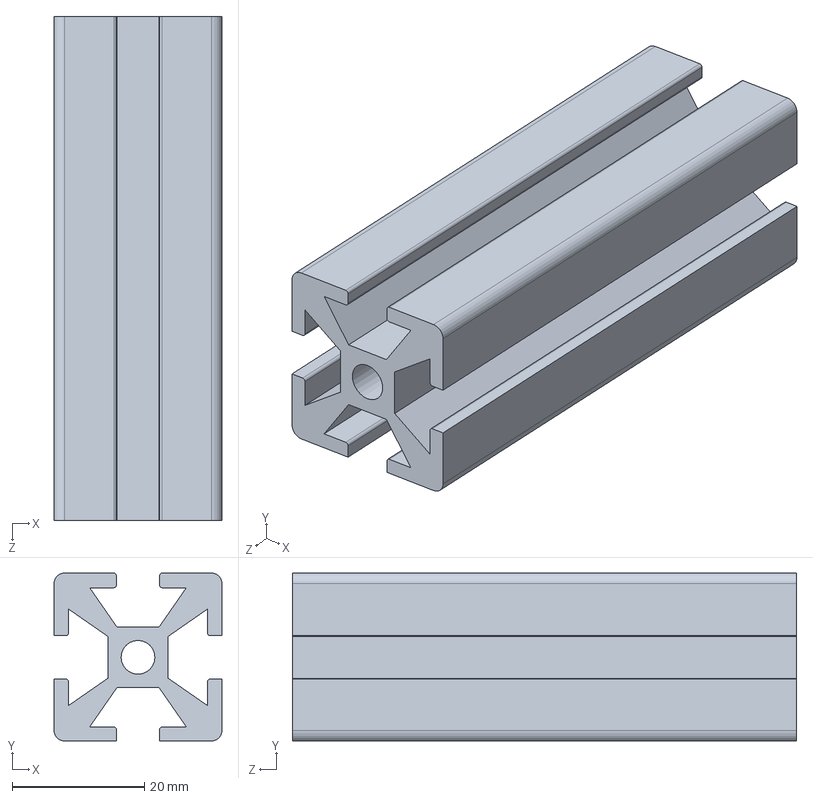
[picture p46: CAD file, 2018-10-15]
Part and Assembly Files/80-20 Extrusion 3 inch (simplified).SLDPRT
25.4 x 25.4 x 76.2 mm
