markyen001/DR4/Part and Assembly Files/80-20 Extrusion 10 in.SLDPRT

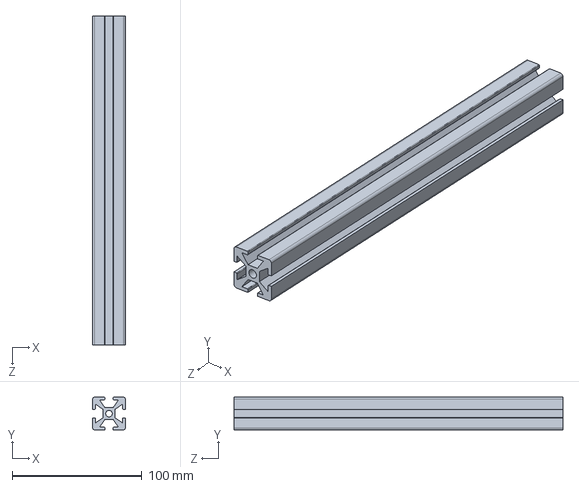
[picture p47: CAD file, 2018-10-15]
Part and Assembly Files/80-20 Extrusion 10 in.SLDPRT
25.4 x 25.4 x 254.0 mm
