markyen001/DR4/Part and Assembly Files/80-20 Extrusion 7 inch (simplified).SLDPRT

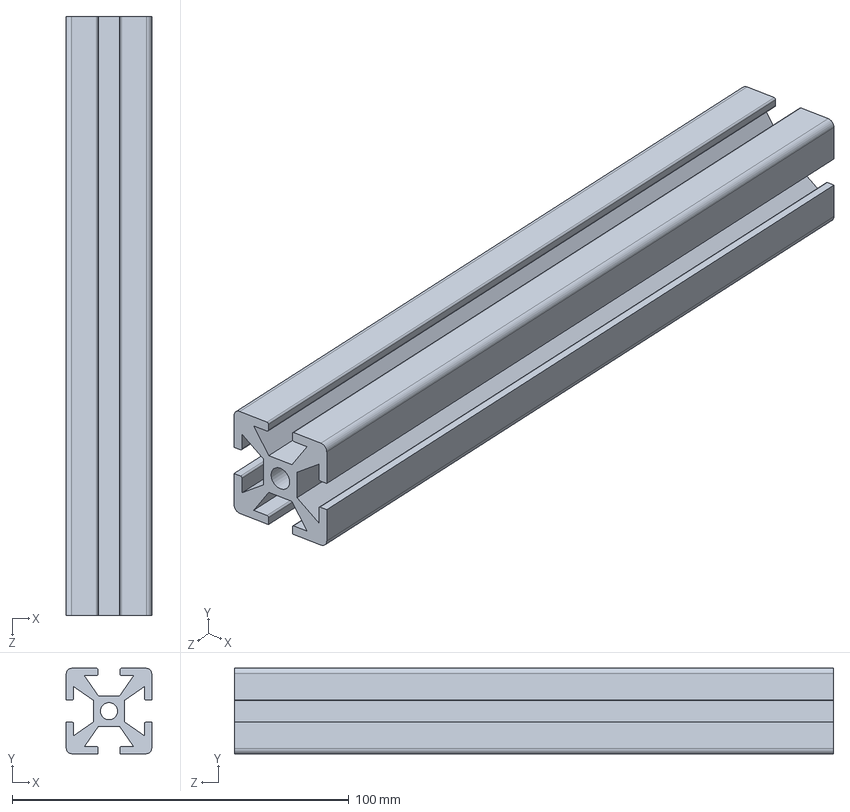
[picture p49: CAD file, 2018-10-15]
Part and Assembly Files/80-20 Extrusion 7 inch (simplified).SLDPRT
25.4 x 25.4 x 177.8 mm
