markyen001/DR4/Part and Assembly Files/BM ARM.SLDPRT

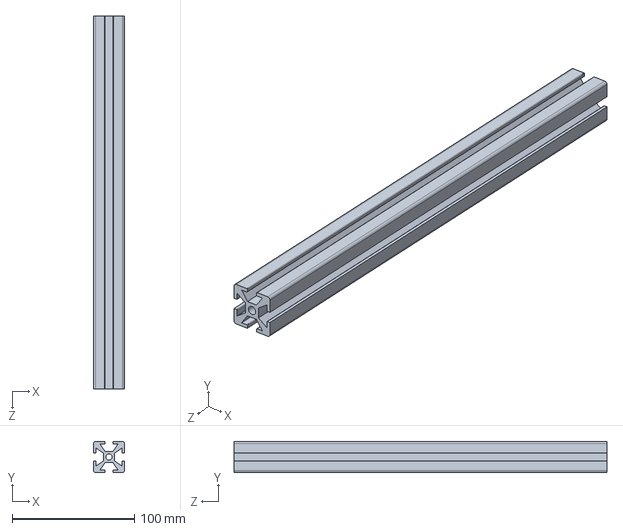
[picture p50: CAD file, 2018-10-15]
Part and Assembly Files/BM ARM.SLDPRT
25.4 x 25.4 x 304.8 mm
