markyen001/DR4/Part and Assembly Files/Wheel Hub.SLDPRT

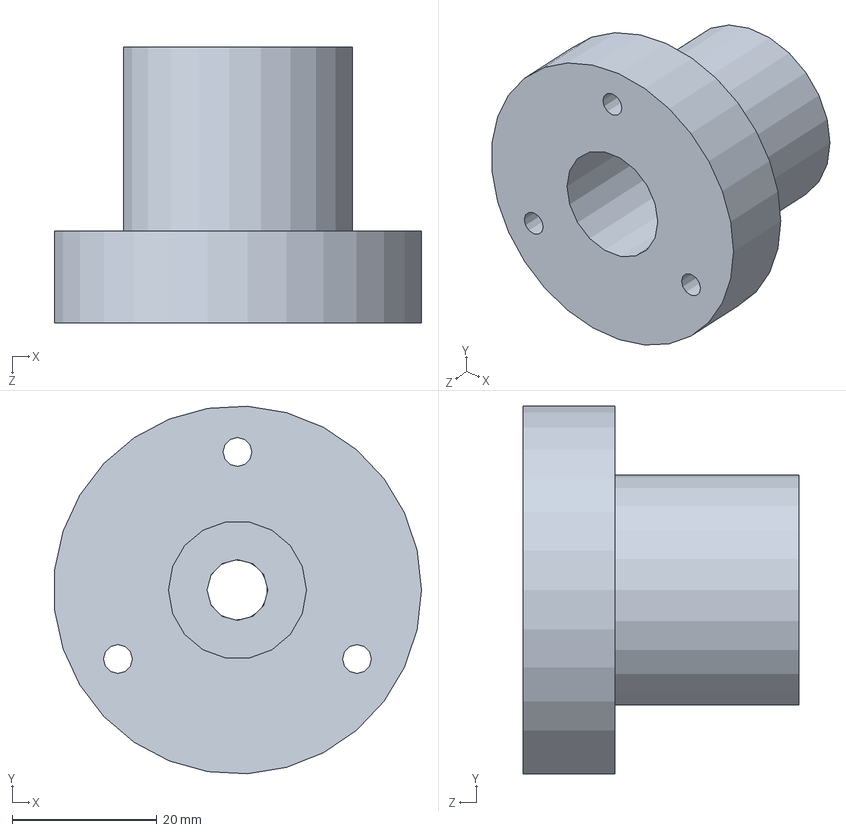
[picture p51: CAD file, 2018-10-15]
Part and Assembly Files/Wheel Hub.SLDPRT
50.7 x 50.7 x 38.1 mm
