markyen001/DR4/Part and Assembly Files/80-20 Linear Slide.SLDPRT

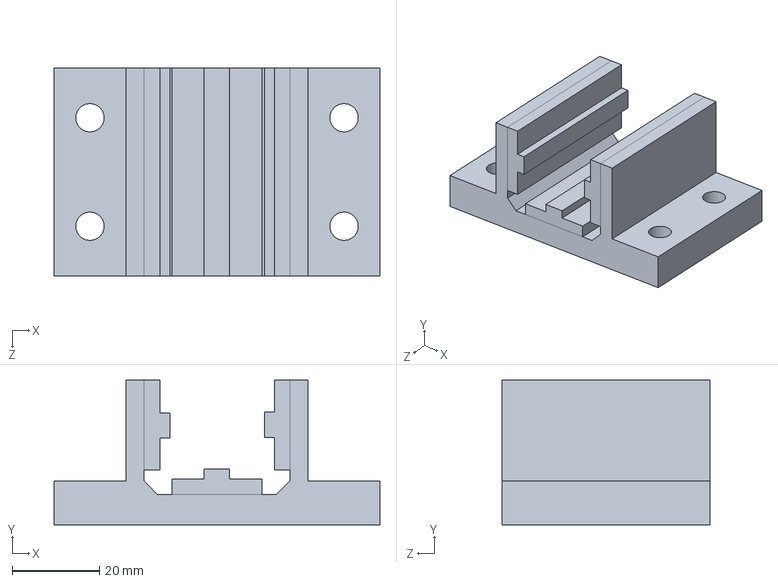
[picture p52: CAD file, 2018-10-14]
Part and Assembly Files/80-20 Linear Slide.SLDPRT
74.8 x 33.2 x 47.8 mm
