markyen001/DR4/Part and Assembly Files/BM 4.5in CLAW.SLDPRT

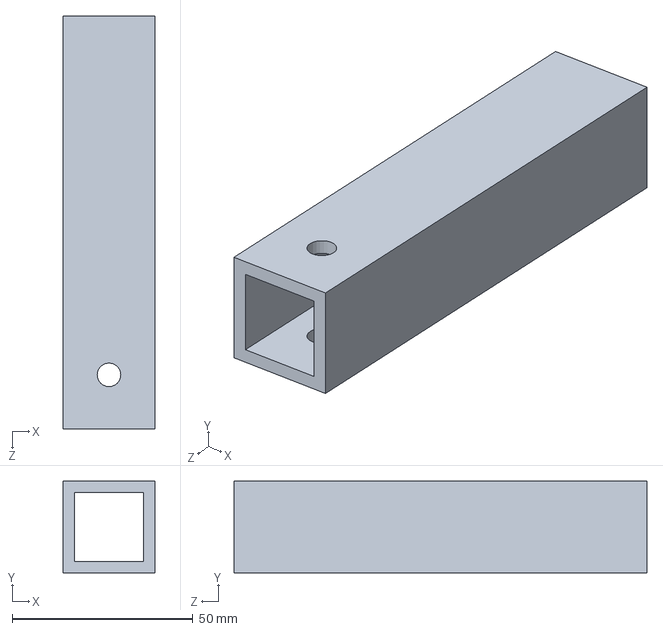
[picture p54: CAD file, 2018-10-14]
Part and Assembly Files/BM 4.5in CLAW.SLDPRT
25.4 x 25.4 x 114.3 mm
