markyen001/DR4/Part and Assembly Files/80-20 Straight Bracket.SLDPRT

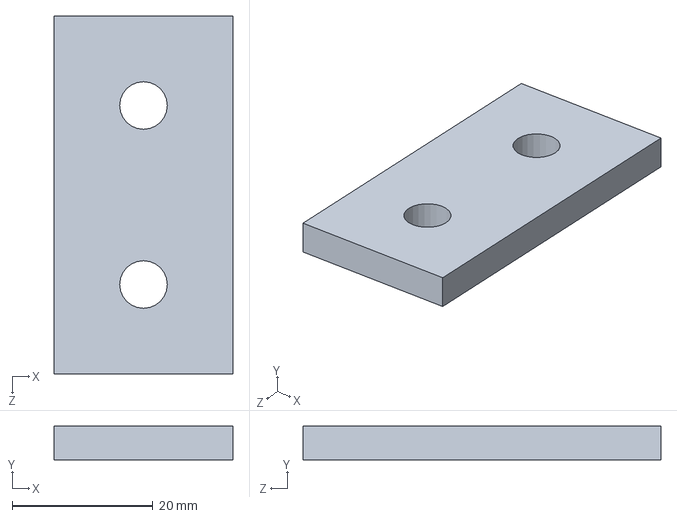
[picture p55: CAD file, 2018-10-13]
Part and Assembly Files/80-20 Straight Bracket.SLDPRT
25.4 x 4.76 x 50.8 mm
