markyen001/DR4/Part and Assembly Files/BM ARM CHANNEL.SLDPRT

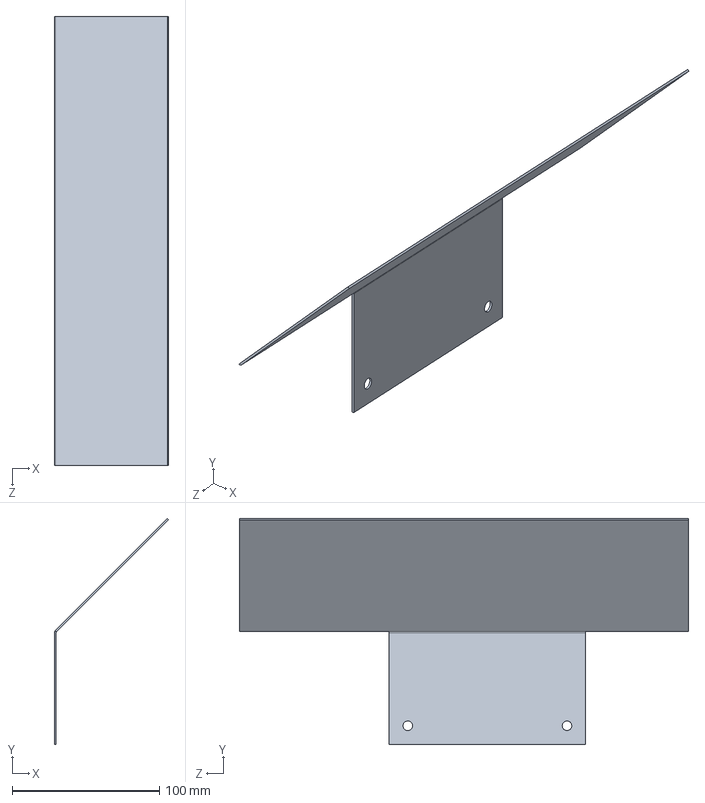
[picture p56: CAD file, 2018-10-13]
Part and Assembly Files/BM ARM CHANNEL.SLDPRT
77.4 x 153.3 x 304.8 mm
