markyen001/DR4/Part and Assembly Files/80-20 90 Degree Angle Bracket.SLDPRT

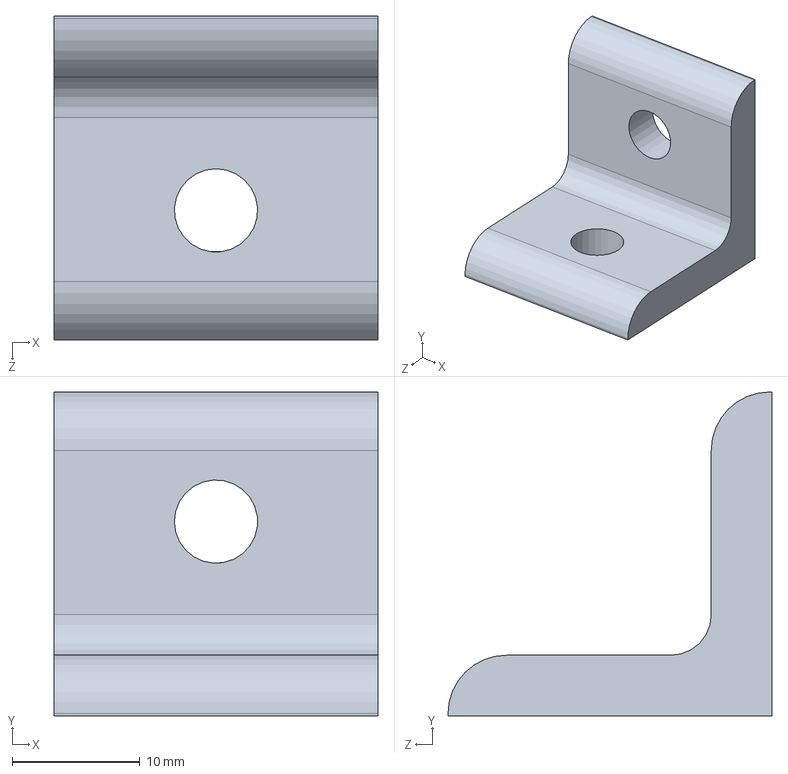
[picture p57: CAD file, 2018-10-13]
Part and Assembly Files/80-20 90 Degree Angle Bracket.SLDPRT
25.4 x 25.4 x 25.4 mm
