markyen001/DR4/Part and Assembly Files/Motor Mount.SLDPRT

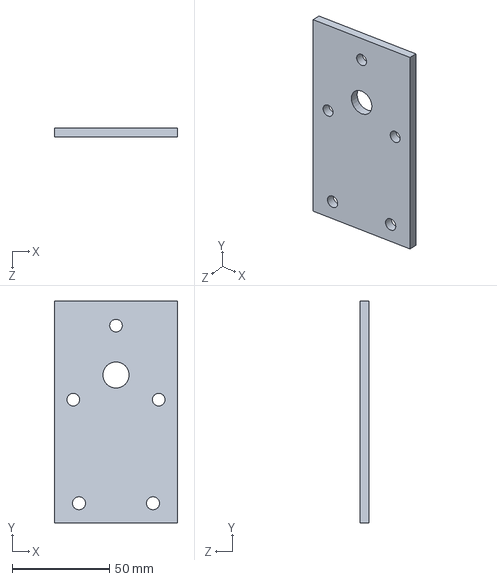
[picture p58: CAD file, 2018-10-13]
Part and Assembly Files/Motor Mount.SLDPRT
63.5 x 114.3 x 4.83 mm
