markyen001/DR4/Part and Assembly Files/ALSQ TUBING.SLDPRT

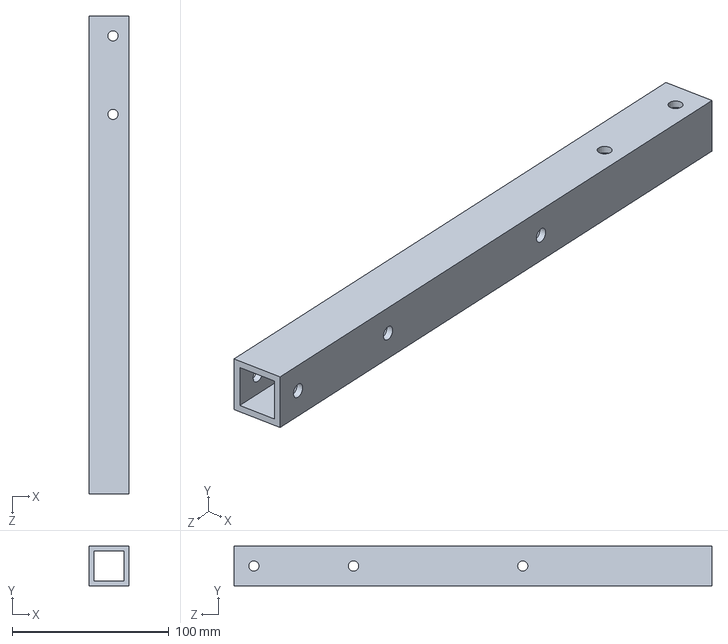
[picture p59: CAD file, 2018-10-13]
Part and Assembly Files/ALSQ TUBING.SLDPRT
25.4 x 25.4 x 304.8 mm
