markyen001/DR4/Part and Assembly Files/10 Inch Wheel.SLDPRT

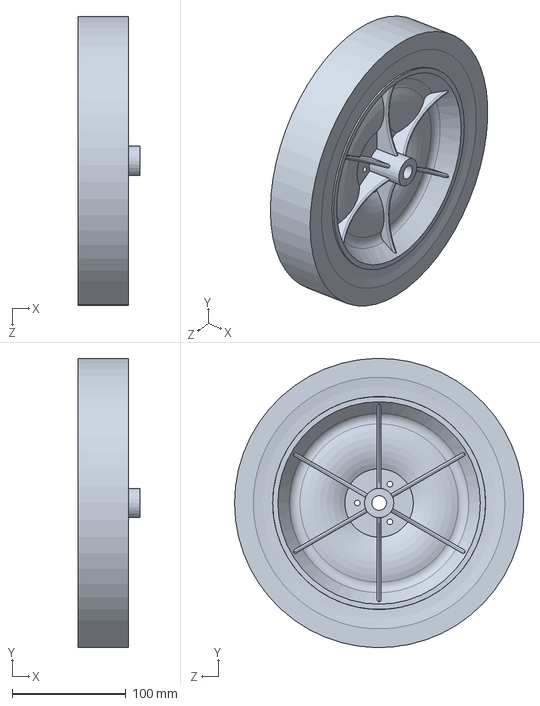
[picture p60: CAD file, 2018-10-13]
Part and Assembly Files/10 Inch Wheel.SLDPRT
54.2 x 253.9 x 253.8 mm
