markyen001/DR4/Part and Assembly Files/44 RPM Entstort Right Angle Gear Motor.SLDPRT

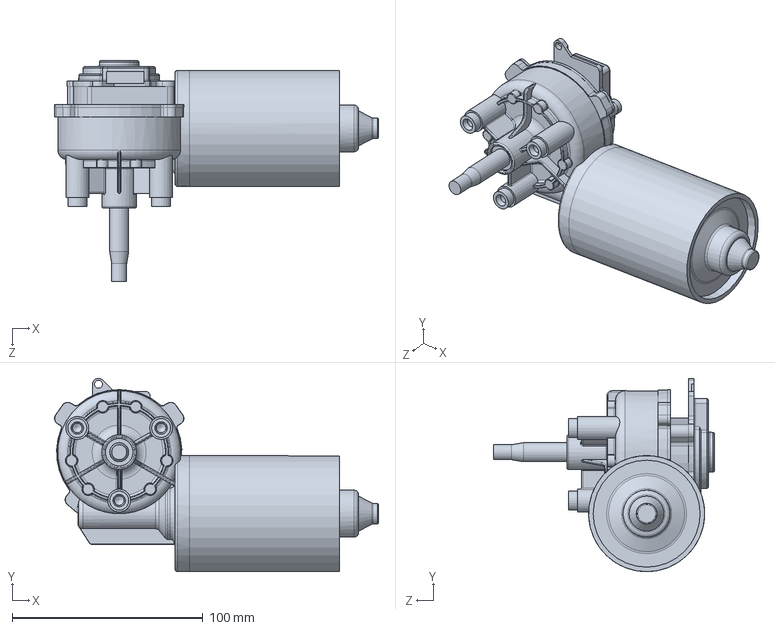
[picture p61: CAD file, 2018-10-13]
Part and Assembly Files/44 RPM Entstort Right Angle Gear Motor.SLDPRT
170.1 x 101.5 x 116.0 mm
