markyen001/DR4/(list of files, cad)

Other CAD files:
Part and Assembly Files/BM ARM CHANNEL GM SIDE.SLDPRT
Part and Assembly Files/4.5 RPM Globe Gear Motor.SLDPRT
Part and Assembly Files/80-20 Extrusion 5 inch (simplified).SLDPRT
Part and Assembly Files/5-inch AL tube.SLDPRT
Part and Assembly Files/BM ARM CHANNEL GM SIDE UNFOLDED.SLDPRT
Globe Motor Drawings/4.5 RPM Globe Gear Motor Specs.SLDDRW
Globe Motor Drawings/4.5 RPM Globe Gear Motor.SLDDRW
Part and Assembly Files/0.25-20 Button Head Cap Screw (BHCS).SLDPRT
Part and Assembly Files/0.25-20 x 1 in FLAT HEAD SCREW.SLDPRT
Part and Assembly Files/0013 10-24 x 1.25 in PHILIPS HEAD SCREW.SLDPRT
Part and Assembly Files/0019 BALL HOPPER True Scale.SLDDRW
Part and Assembly Files/0019 BALL HOPPER.SLDDRW
Part and Assembly Files/10-24 HEX NUT.SLDPRT
Part and Assembly Files/10-24 Thread 0.5 Inch Length Screw for Motor Hub.SLDPRT
Part and Assembly Files/10-24 Thread 1.25 Length Socket Screw.SLDPRT
Part and Assembly Files/10-24 Thread 1.5 Length Socket Head Screw.SLDPRT
Part and Assembly Files/10-24 Thread 2 Length Socket Head Screw.SLDPRT
Part and Assembly Files/10-24 x 3-8 Socket Screw for Mount.SLDPRT
Part and Assembly Files/30 IPM Spal Linear Actuator.SLDDRW
Part and Assembly Files/4.5 RPM Globe Gear Motor.SLDDRW
Part and Assembly Files/44 RPM Entstort Right Angle Gear Motor.SLDDRW
Part and Assembly Files/80-20 0.25-20 T-NUT.SLDPRT
Part and Assembly Files/80-20 90 Degree Angle Bracket.SLDDRW
Part and Assembly Files/80-20 Extrusion DRAWING.SLDDRW
Part and Assembly Files/80-20 Linear Slide.SLDDRW
Part and Assembly Files/80-20 Straight Bracket.SLDDRW
Part and Assembly Files/80-20 Straight Degree Bracket Assy.SLDDRW
Part and Assembly Files/90 degree both parallel.SLDDRW
Part and Assembly Files/90272A539_ZINC-PLTD STL PAN HEAD PHILLIPS MACHINE SCREW.SLDPRT
Part and Assembly Files/90272A540_ZINC-PLTD STL PAN HEAD PHILLIPS MACHINE SCREW.SLDPRT
Part and Assembly Files/91251A249_BLACK-OXIDE ALLOY STEEL SOCKET HEAD SCREW.SLDPRT
Part and Assembly Files/91306A281_ZINC-PLATED ALLOY STEEL BUTTON-HEAD CAP SCREW.SLDPRT
Part and Assembly Files/94895A029_ZINC YELLOW-CHROMATE PLATED STEEL HEX NUT.SLDPRT
Part and Assembly Files/A014.SLDDRW
Part and Assembly Files/BM Drawings.SLDDRW
Part and Assembly Files/BUCKET MANIPULATOR ASSEMBLY.SLDDRW
Part and Assembly Files/Bucket Manipulator Total Assembly.SLDDRW
Part and Assembly Files/Caster Wheel.SLDDRW
Part and Assembly Files/Control Box.SLDDRW
Part and Assembly Files/Drive Wheel Hex Nut.SLDPRT
Part and Assembly Files/Drive Wheel Socket Screws.SLDPRT
Part and Assembly Files/Entstort Screw.SLDPRT
Part and Assembly Files/Entstort Shaft Nut.SLDPRT
Part and Assembly Files/FINAL TOTAL ASSEMBLY - ALL CONFIGURATIONS.SLDDRW
Part and Assembly Files/Globe motor screw.SLDPRT
Part and Assembly Files/HOPPER AND BUCKET ASSEMBLY.SLDDRW
Part and Assembly Files/Linear Actuaor Mount (10-24).SLDDRW
Part and Assembly Files/M3 x 0.5 - 10mm Button Screw for Bucket Motor Mount.SLDPRT
Part and Assembly Files/M3 x 0.5 - 8 mm ROUND HEAD SCREW.SLDPRT
Part and Assembly Files/M6 X 14MM PHILLIPS SCREW.SLDPRT
Part and Assembly Files/M6x1 - 12mm GLOBE MOTOR SCREW.SLDPRT
Part and Assembly Files/M8 x 1.25 mm HEX NUT.SLDPRT
Part and Assembly Files/MOBILE PLATFORM FRAME ASSEMBLY.SLDDRW
Part and Assembly Files/Motor Mount.SLDDRW
Part and Assembly Files/PLATFORM WITH WHEELS ASSEMBLY.SLDDRW
Part and Assembly Files/Platform Wheels Box Hopper Bucket Assembly.SLDDRW
Part and Assembly Files/Platform with Wheels and Control Box.SLDDRW
Part and Assembly Files/RUBBER PADS.SLDDRW
Part and Assembly Files/TITANIUM COUNTERWEIGHT.SLDDRW
Part and Assembly Files/Template for Bill of Materials.SLDDRW
Part and Assembly Files/WASHER.SLDPRT
Part and Assembly Files/Wheel Hub.SLDDRW
Part and Assembly Files/Wheel and Motor Total Assembly.SLDDRW
Part and Assembly Files/hopper assembly.SLDDRW
