markyen001/DR4/Drawings for PRINT/MERGED 0-30.pdf

1. 0001 – 80/20 EXTRUSION
2. TITANIUM COUNTERWEIGHT
3. RUBBER PADS
4. A9 – BALL MANIPULATOR TOTAL ASSEMBLY
a. 0034 – BALL MANIPULATOR CHANNEL
b. A6 – CLAW ASSEMBLY
i. 0004 – 80/20 90 DEG ANGLE BRACKET ii. 0007 – 80/20 STRAIGHT BRACKET
iii. 0037 – 80/20 LINEAR SLIDE
iv. 0039 – 10-24 LINEAR ACTUATOR MOUNT
v. 0040 – 30 IPM SPAL LINEAR ACTUATOR (2in)
c. A7 – CLAW MOUNT
d. A8 – GLOBE MOTOR BRACKET ASSEMBLY
e. A12 – 4.5 RPM GLOBE MOTOR
5. A16 – PLATFORM WITH BOX/HOPPER/BUCKET
a. A14 – HOPPER/BUCKET ASSEMBLY
i. A5 – BUCKET MANIPULATOR TOTAL ASSEMBLY
1. A4 – BUCKET MANIPULATOR
a. A10 – 90-DEGREE BRACKET ASSEMBLY
b. A11 – STRAIGHT BRACKET ASSEMBLY ii. A13 – HOPPER ASSEMBLY
1. 0018 – BALL HOPPER
b. A15 – PLATFORM WITH CONTROL BOX
i. 0017 – CONTROL BOX
ii. A3 – PLATFORM WITH WHEELS
1. 0016 – 5 in CASTER WHEEL
2. A1 – MOBILE PLATFORM FRAME
3. A2 – WHEEL AND MOTOR ASSEMBLY
a. 0008 – 44 RPM ENTSTORT RIGHT ANGLE MOTOR
b. 0009 – ENTSTORT MOTOR MOUNT
c. 0011 – DRIVE WHEEL HUB
d. 0012 – 10 in WHEEL

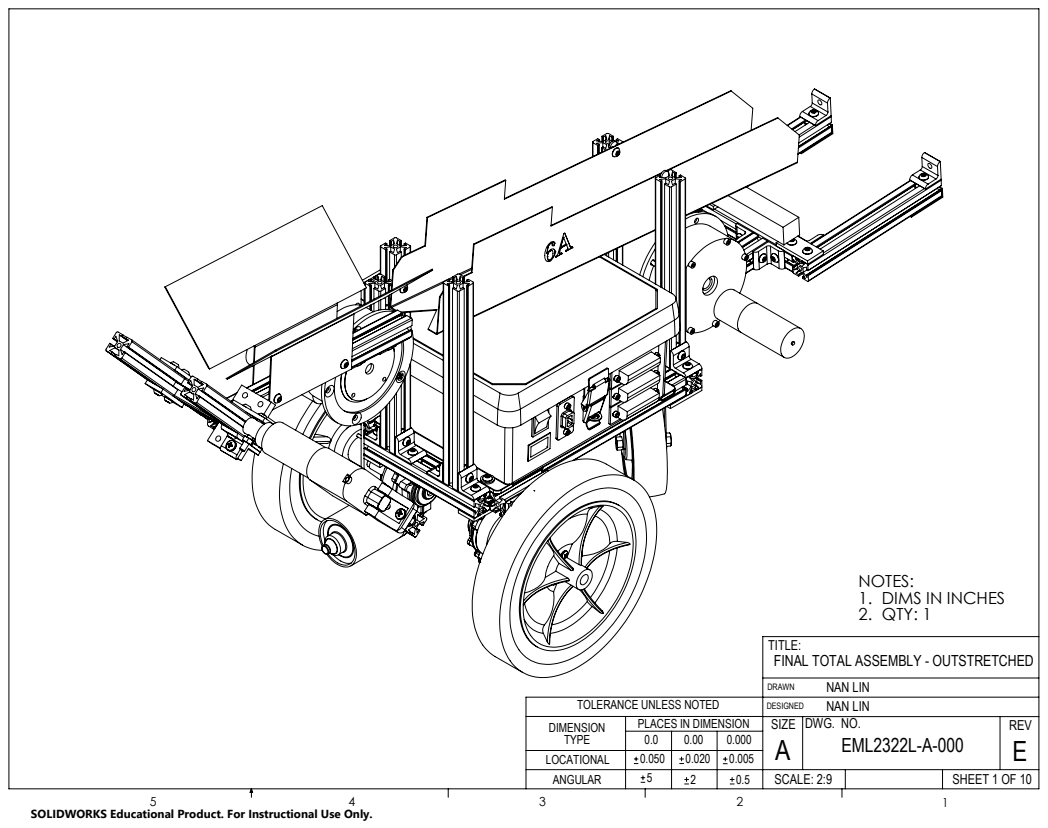
[picture p62: page 2]
SHEET 1 OF 10; REV E; EML2322L-A-000; DRAWN; DESIGNED; ANGULAR; LOCATIONAL; TOLERANCE UNLESS NOTED DIMENSION TYPE; SCALE: 2:9; DIMS IN INCHES; NOTES: 1. 2. QTY: 1

TITLE:
FINAL TOTAL ASSEMBLY - OUTSTRETCHED
NAN LIN
DWG. NO.
SIZE

PLACES IN DIMENSION

SOLIDWORKS Educational Product. For Instructional Use Only.

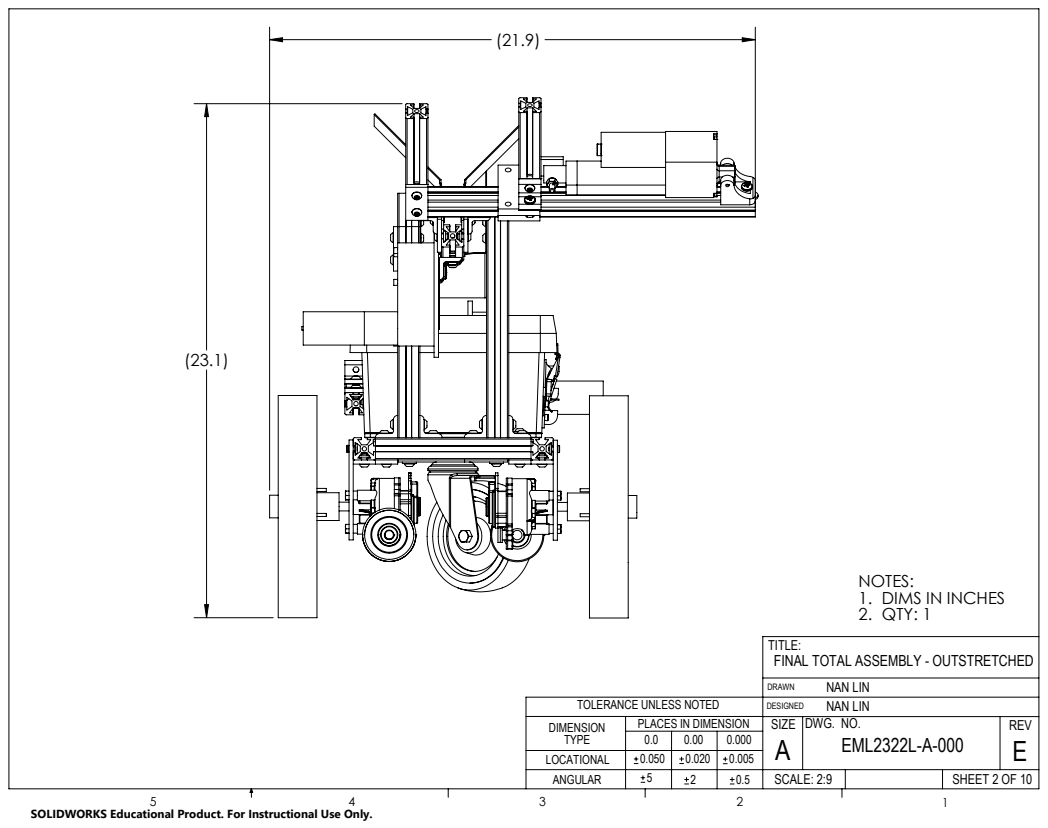
[picture p63: page 3]
REV E; EML2322L-A-000; DRAWN; DESIGNED; SCALE: 2:9; DIMS IN INCHES; NOTES: 1. 2. QTY: 1

TITLE:
FINAL TOTAL ASSEMBLY - OUTSTRETCHED
NAN LIN
DWG. NO.
SIZE

TOLERANCE UNLESS NOTED
DIMENSION
TYPE
LOCATIONAL

PLACES IN DIMENSION

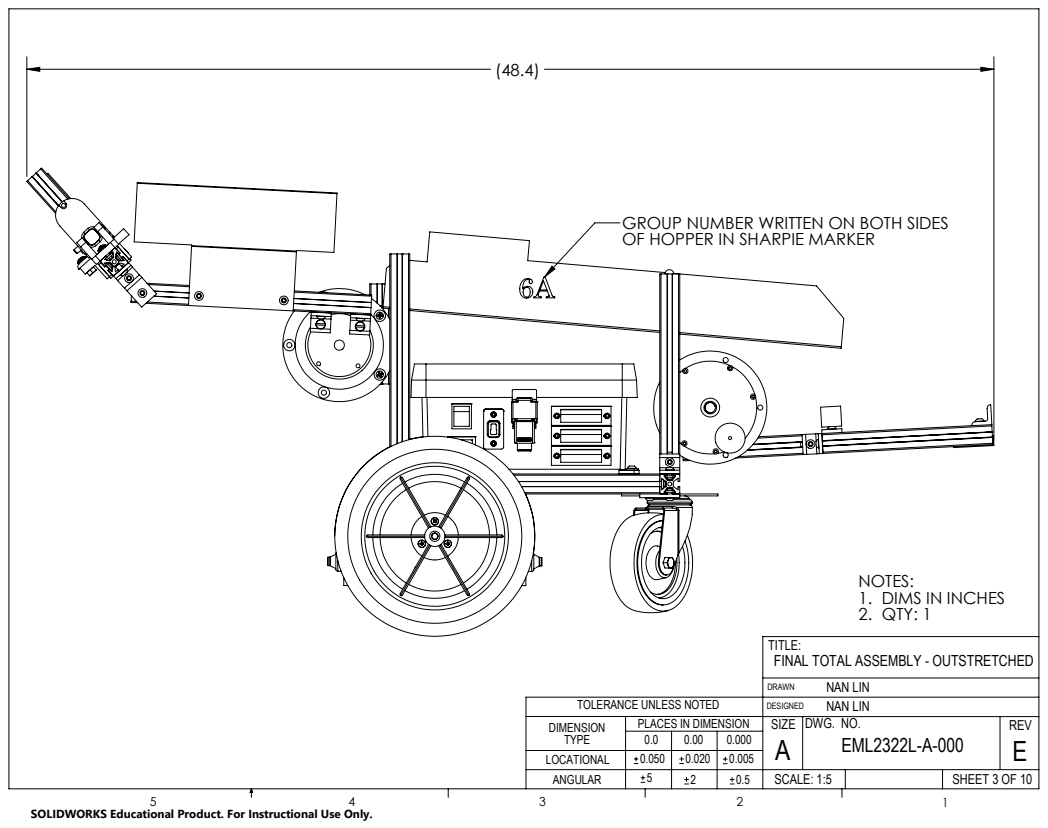
[picture p64: page 4]
REV E; EML2322L-A-000; DRAWN; DESIGNED; SCALE: 1:5; DIMS IN INCHES; NOTES: 1. 2. QTY: 1

GROUP NUMBER WRITTEN ON BOTH SIDES
OF HOPPER IN SHARPIE MARKER

TITLE:
FINAL TOTAL ASSEMBLY - OUTSTRETCHED
NAN LIN
DWG. NO.
SIZE

TOLERANCE UNLESS NOTED
DIMENSION
TYPE
LOCATIONAL

PLACES IN DIMENSION

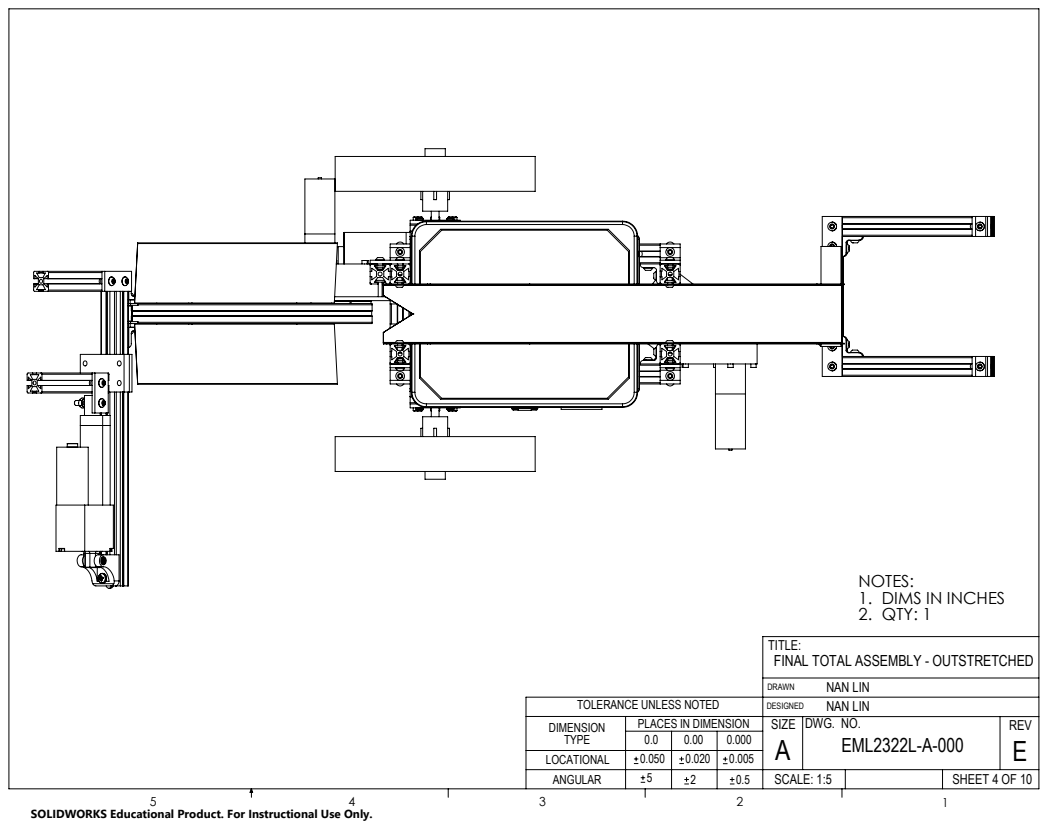
[picture p65: page 5]
REV E; EML2322L-A-000; DRAWN; DESIGNED; SCALE: 1:5; DIMS IN INCHES; NOTES: 1. 2. QTY: 1

TITLE:
FINAL TOTAL ASSEMBLY - OUTSTRETCHED
NAN LIN
DWG. NO.
SIZE

TOLERANCE UNLESS NOTED
DIMENSION
TYPE
LOCATIONAL

PLACES IN DIMENSION

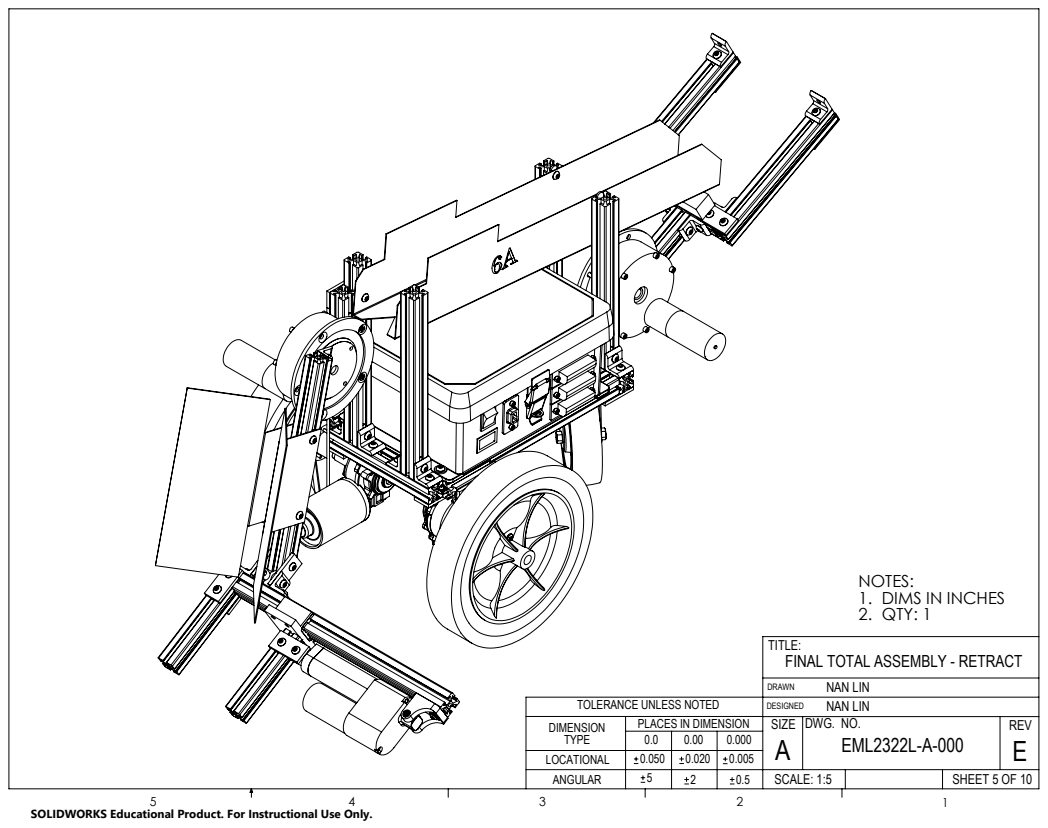
[picture p66: page 6]
REV E; EML2322L-A-000; DRAWN; DESIGNED; SCALE: 1:5; DIMS IN INCHES; NOTES: 1. 2. QTY: 1

TITLE:
FINAL TOTAL ASSEMBLY - RETRACT
NAN LIN
DWG. NO.
SIZE

TOLERANCE UNLESS NOTED
DIMENSION
TYPE
LOCATIONAL

PLACES IN DIMENSION

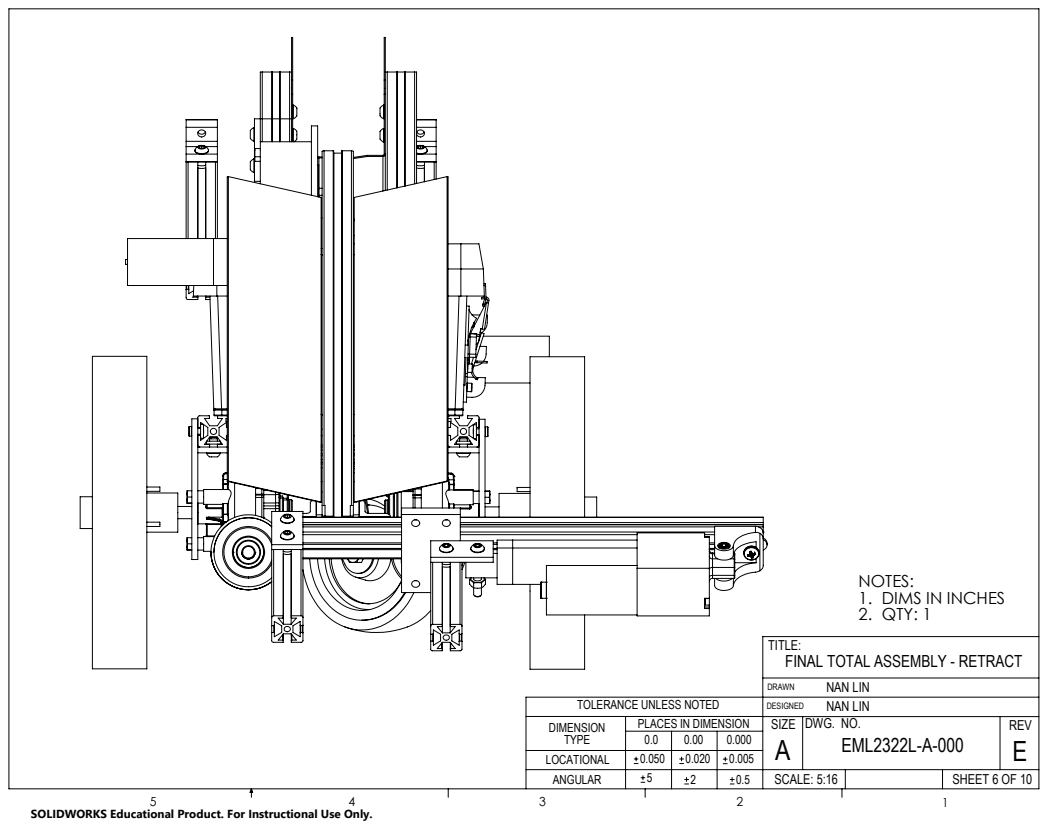
[picture p67: page 7]
REV E; EML2322L-A-000; DRAWN; DESIGNED; SCALE: 5:16; DIMS IN INCHES; NOTES: 1. 2. QTY: 1

TITLE:
FINAL TOTAL ASSEMBLY - RETRACT
NAN LIN
DWG. NO.
SIZE

TOLERANCE UNLESS NOTED
DIMENSION
TYPE
LOCATIONAL

PLACES IN DIMENSION

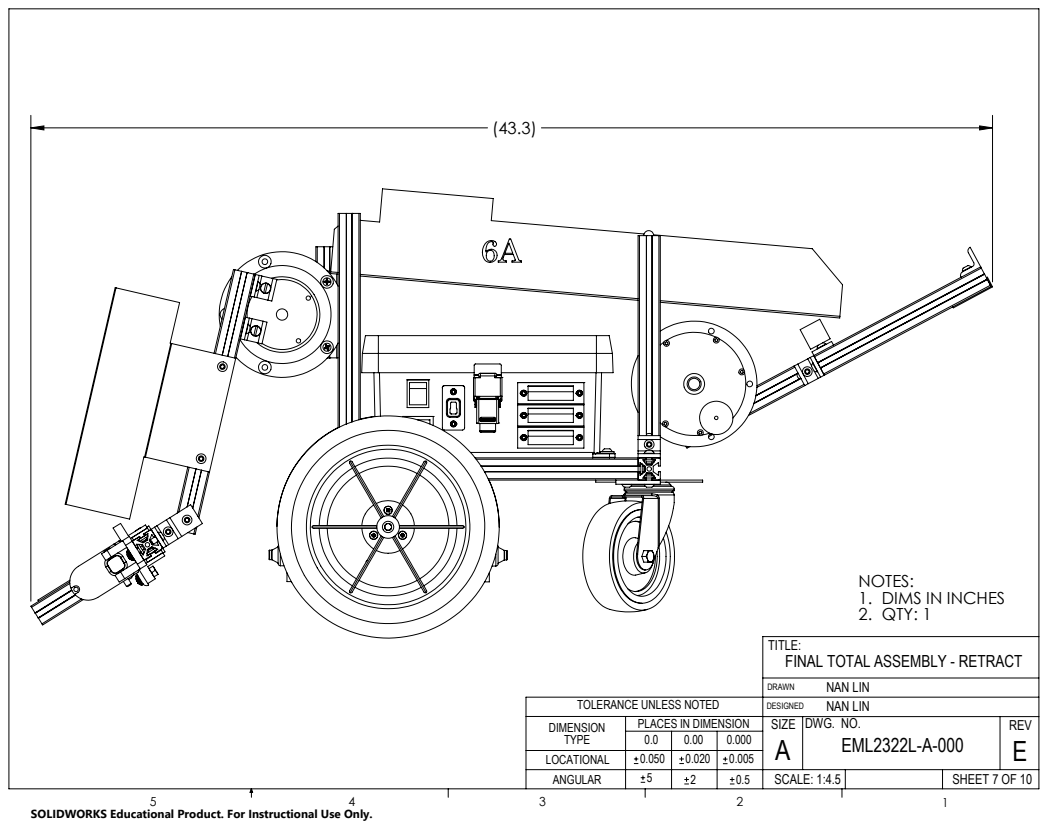
[picture p68: page 8]
REV E; EML2322L-A-000; DRAWN; DESIGNED; SCALE: 1:4.5; DIMS IN INCHES; NOTES: 1. 2. QTY: 1

TITLE:
FINAL TOTAL ASSEMBLY - RETRACT
NAN LIN
DWG. NO.
SIZE

TOLERANCE UNLESS NOTED
DIMENSION
TYPE
LOCATIONAL

PLACES IN DIMENSION

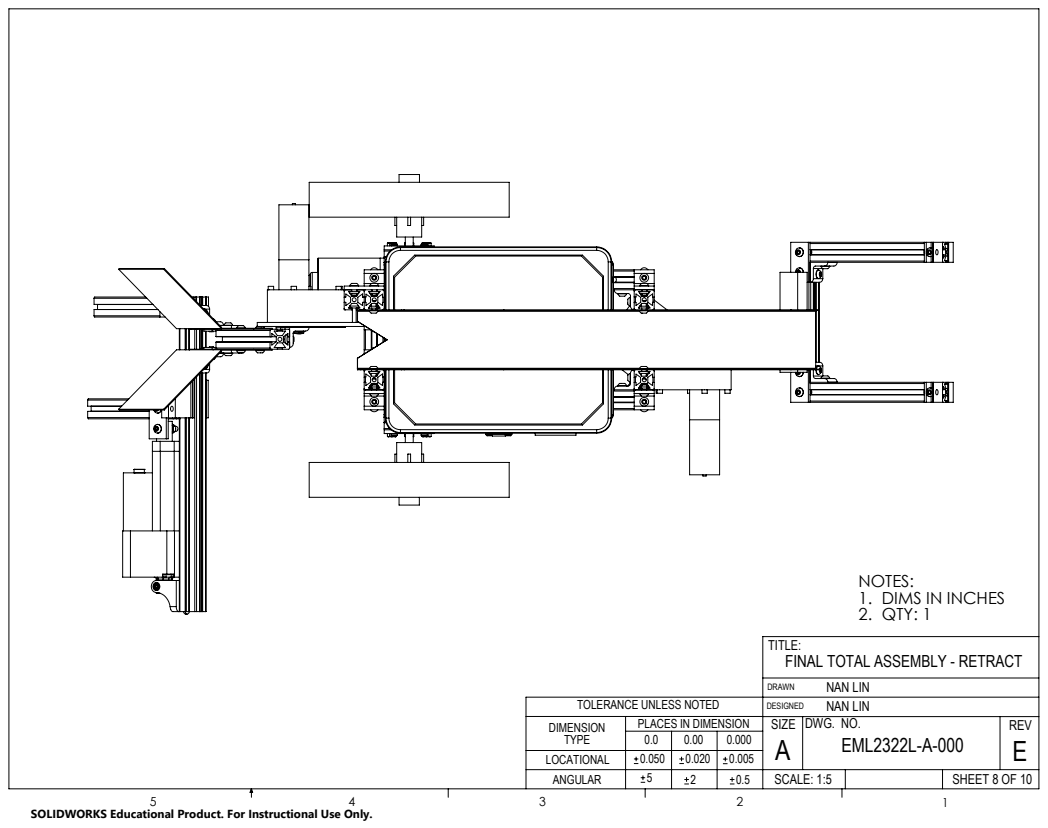
[picture p69: page 9]
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

TITLE:
FINAL TOTAL ASSEMBLY - RETRACT
NAN LIN
DWG. NO.
SIZE

TOLERANCE UNLESS NOTED
DIMENSION
TYPE
LOCATIONAL

PLACES IN DIMENSION

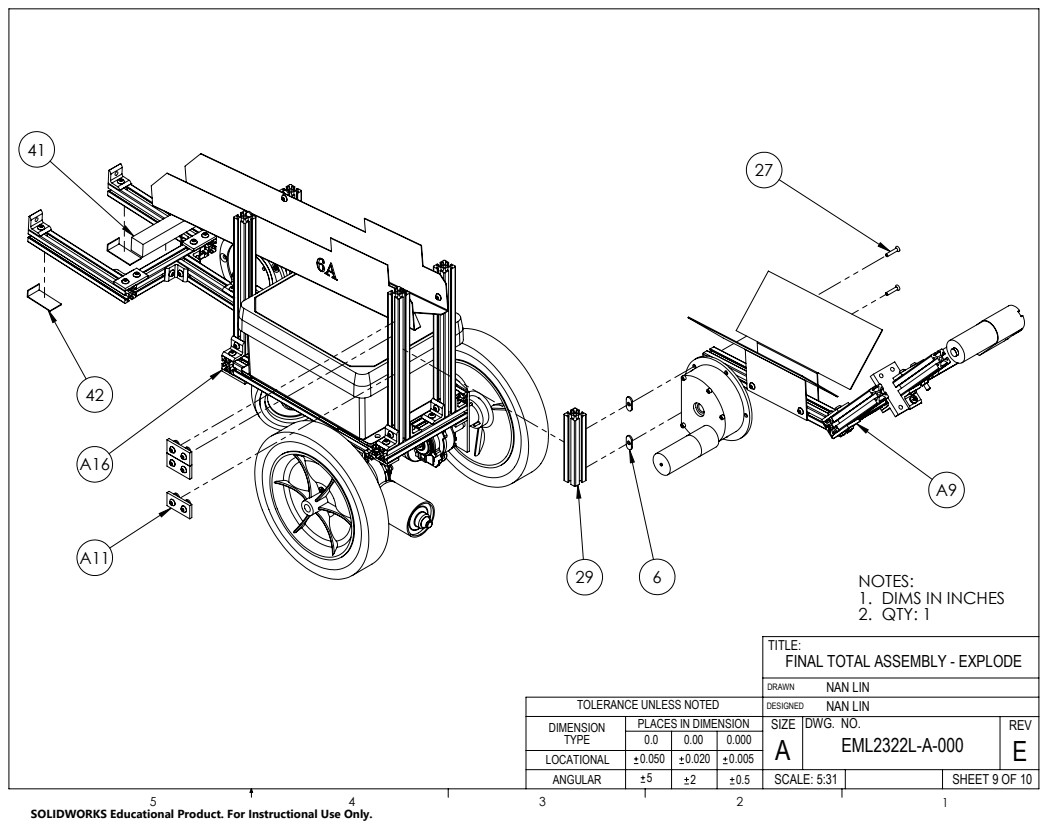
[picture p70: page 10]
REV E; EML2322L-A-000; DRAWN; DESIGNED; SCALE: 5:31; DIMS IN INCHES; NOTES: 1. 2. QTY: 1

TITLE:
FINAL TOTAL ASSEMBLY - EXPLODE
NAN LIN
DWG. NO.
SIZE

TOLERANCE UNLESS NOTED
DIMENSION
TYPE
LOCATIONAL

PLACES IN DIMENSION

ITEM NO. | PART NUMBER | DESCRIPTION | EXPLODE/QTY.
6 | EML2322L-0006 | 1/4-20 T-NUT | 2
27 | EML2322L-0027 | 1/4-20 x 1.0 in FLAT HEAD SCREW | 2
29 | EML2322L-0029 | 80-20 EXTRUSION - 5.0 in | 1
41 | EML2322L-0041 | TITANIUM COUNTERWEIGHT | 1
42 | EML2322L-0042 | RUBBER PADS | 2
A9 | EML2322L-A-009 | BALL MANIPULATOR TOTAL ASSEMBLY | 1
A11 | EML2322L-A-011 | STRAIGHT BRACKET ASSEMBLY | 3
A16 | EML2322L-A-016 | PLATFORM WITH BOX/HOPPER/BUCKET ASSEMBLY | 1

FINAL TOTAL ASSEMBLY - EXPLODE

DWG. NO.

TITLE:

REV
E

SIZE

### A EML2322L-A-000

DRAWN
DESIGNED

NAN LIN
NAN LIN
0.0 | 0.00 | 0.000
0.050 0.020 0.005
LOCATIONAL

TOLERANCE UNLESS NOTED
DIMENSION
TYPE
5 | 2 | SCALE: 1:15

PLACES IN DIMENSION

DIMS IN INCHES

NOTES:
1.
2. QTY: 1

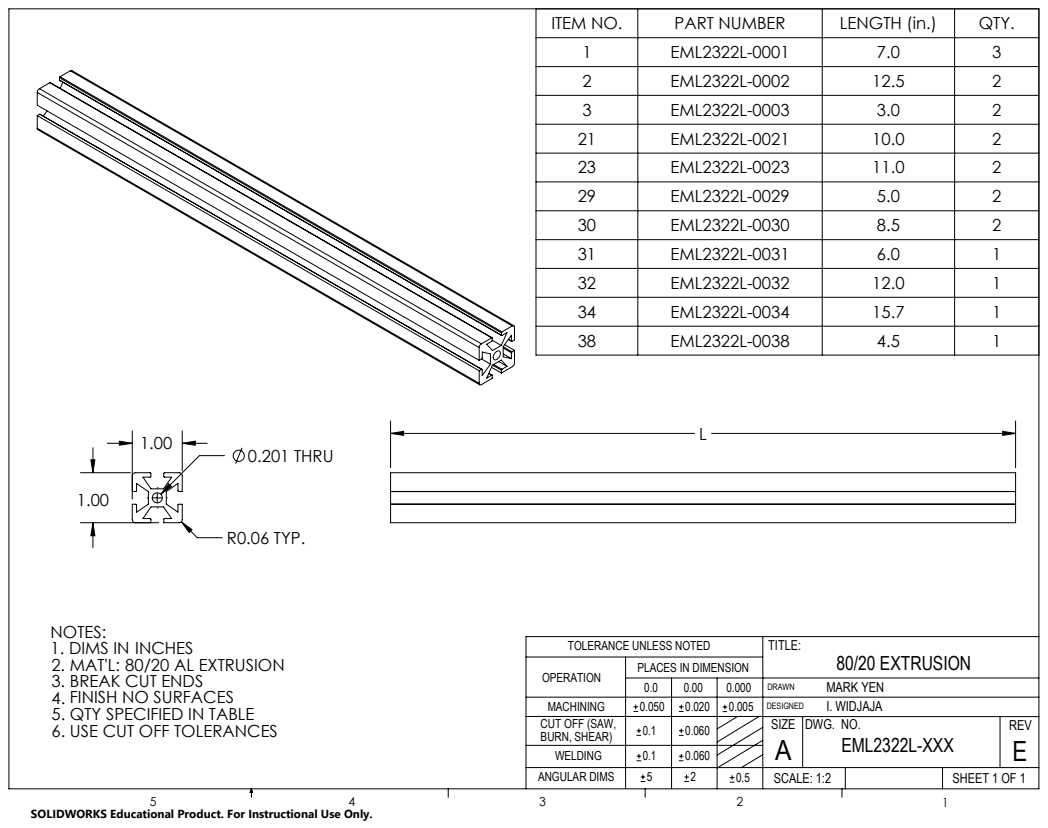
[picture p71: page 12]
R0.06 TYP.; 0.201 THRU; 80/20 EXTRUSION; DWG. NO.; TITLE:; REV E; SIZE; EML2322L-XXX; DRAWN; DESIGNED; MARK YEN I. WIDJAJA; SCALE: 1:2; INCHES

ITEM NO. | PART NUMBER | LENGTH (in.) | QTY.
1 | EML2322L-0001 | 7.0 | 3
2 | EML2322L-0002 | 12.5 | 2
3 | EML2322L-0003 | 3.0 | 2
21 | EML2322L-0021 | 10.0 | 2
23 | EML2322L-0023 | 11.0 | 2
29 | EML2322L-0029 | 5.0 | 2
30 | EML2322L-0030 | 8.5 | 2
31 | EML2322L-0031 | 6.0 | 1
32 | EML2322L-0032 | 12.0 | 1
34 | EML2322L-0034 | 15.7 | 1
38 | EML2322L-0038 | 4.5 | 1

NOTES:
1. DIMS IN
2. MAT'L: 80/20 AL EXTRUSION
3. BREAK CUT ENDS
FINISH NO SURFACES
5. QTY SPECIFIED IN TABLE
6. USE CUT OFF TOLERANCES

TOLERANCE UNLESS NOTED
OPERATION
MACHINING
CUT OFF (SAW,
BURN, SHEAR)
WELDING
ANGULAR DIMS

PLACES IN DIMENSION

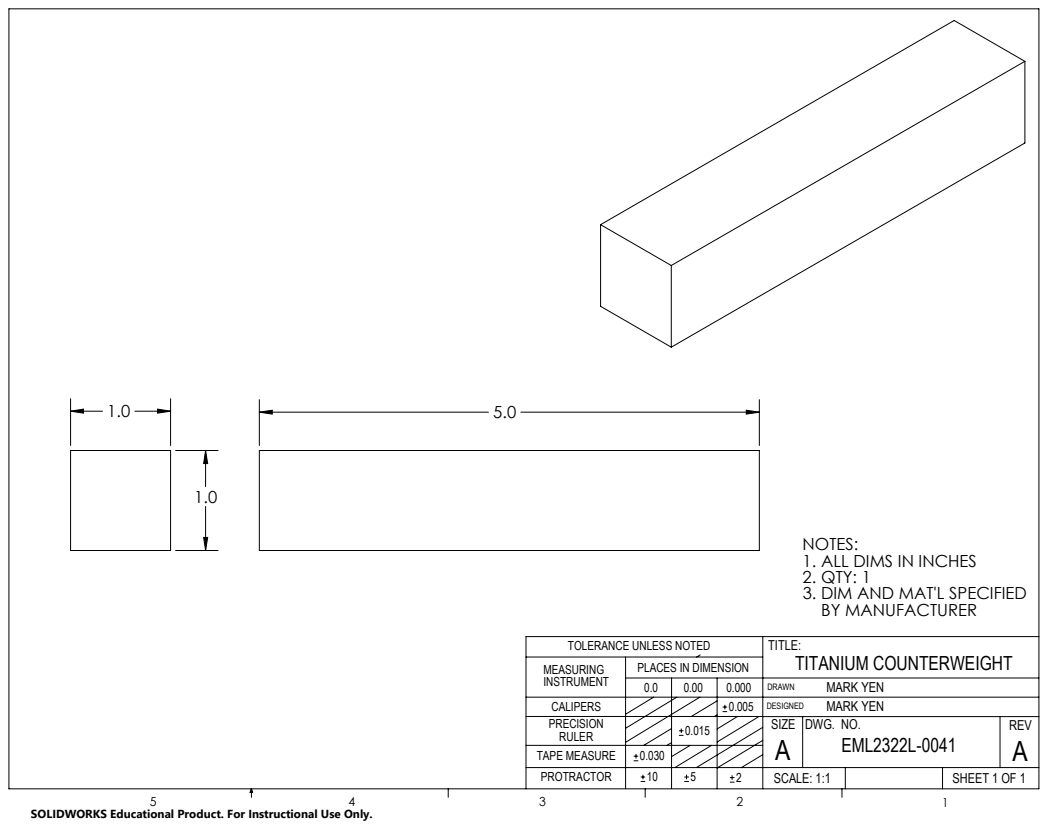
[picture p72: page 13]
SHEET 1 OF 1; TITLE:; REV A; SIZE; EML2322L-0041; DRAWN; DESIGNED; PROTRACTOR; TAPE MEASURE; PRECISION RULER; CALIPERS; TOLERANCE UNLESS NOTED MEASURING INSTRUMENT; SCALE: 1:1

NOTES:
ALL DIMS IN INCHES
QTY: 1
3. DIM AND MAT'L SPECIFIED
BY MANUFACTURER
TITANIUM COUNTERWEIGHT
MARK YEN
DWG. NO.

PLACES IN DIMENSION

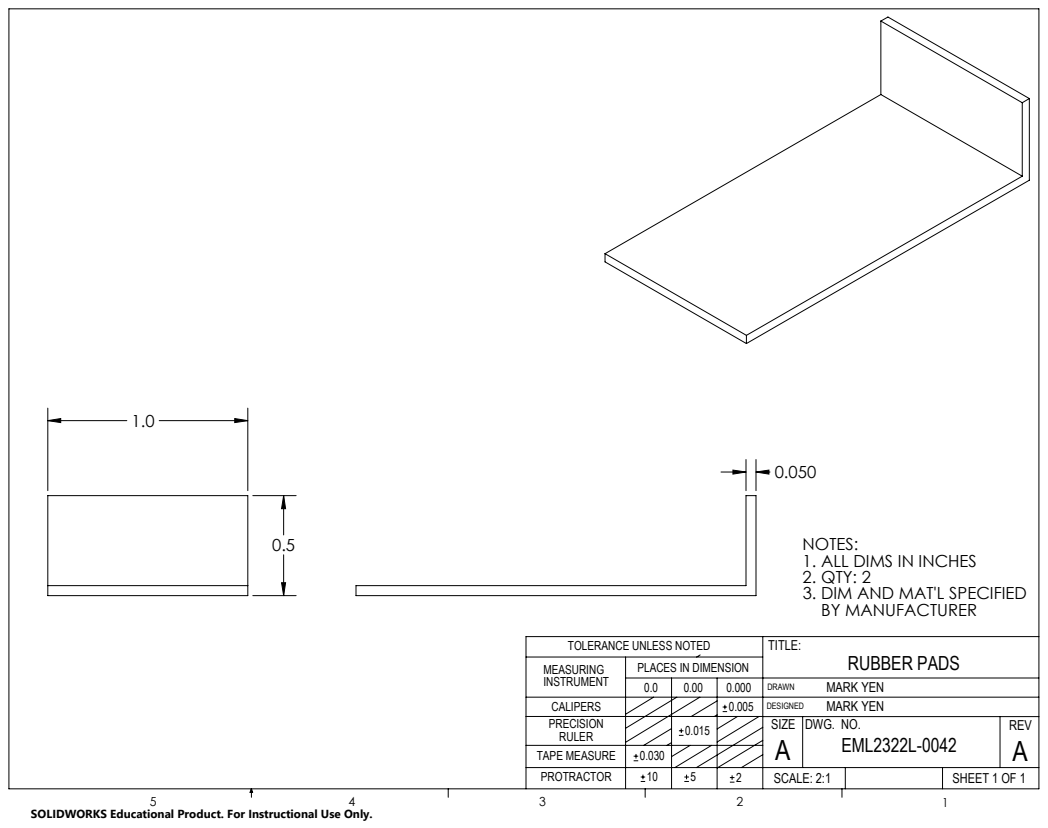
[picture p73: page 14]
SHEET 1 OF 1; TITLE:; REV A; SIZE; EML2322L-0042; DRAWN; DESIGNED; PROTRACTOR; TAPE MEASURE; PRECISION RULER; CALIPERS; TOLERANCE UNLESS NOTED MEASURING INSTRUMENT; SCALE: 2:1

NOTES:
ALL DIMS IN INCHES
QTY: 2
3. DIM AND MAT'L SPECIFIED
BY MANUFACTURER
RUBBER PADS
MARK YEN
DWG. NO.

PLACES IN DIMENSION

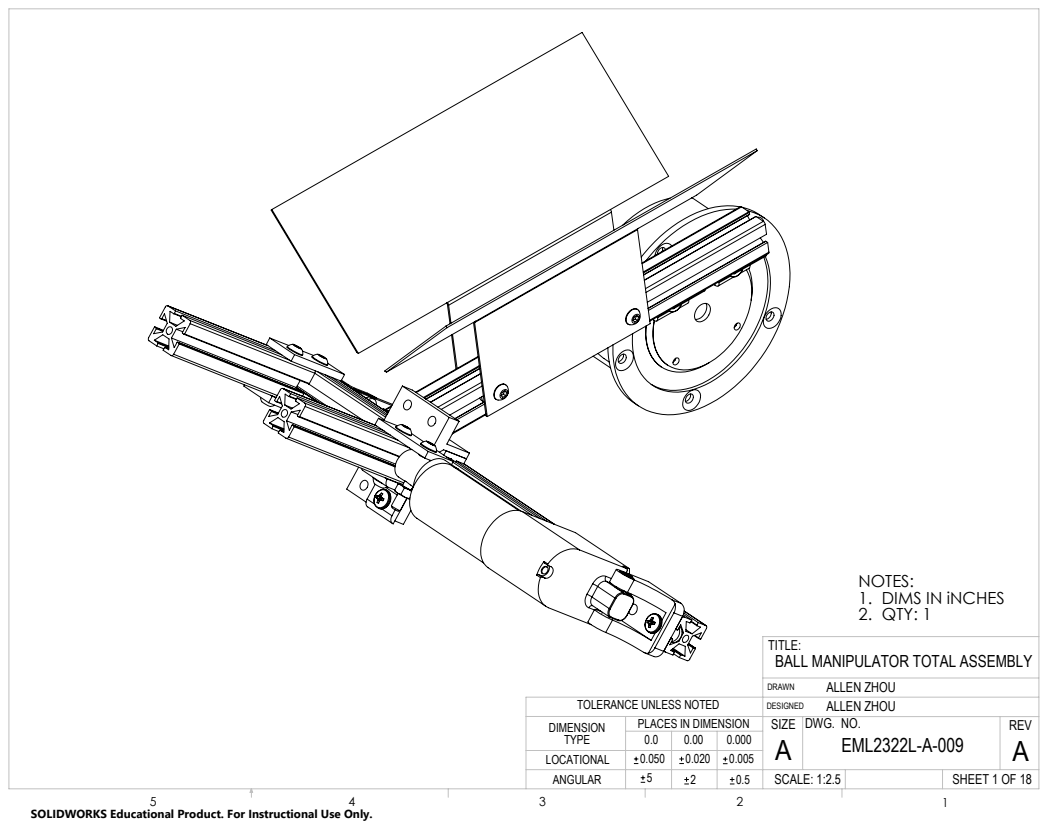
[picture p74: page 15]
REV A; EML2322L-A-009; DRAWN; DESIGNED; SCALE: 1:2.5; DIMS IN iNCHES; NOTES: 1. 2. QTY: 1

TITLE:
BALL MANIPULATOR TOTAL ASSEMBLY
ALLEN ZHOU
DWG. NO.
SIZE

TOLERANCE UNLESS NOTED
DIMENSION
TYPE
LOCATIONAL

PLACES IN DIMENSION

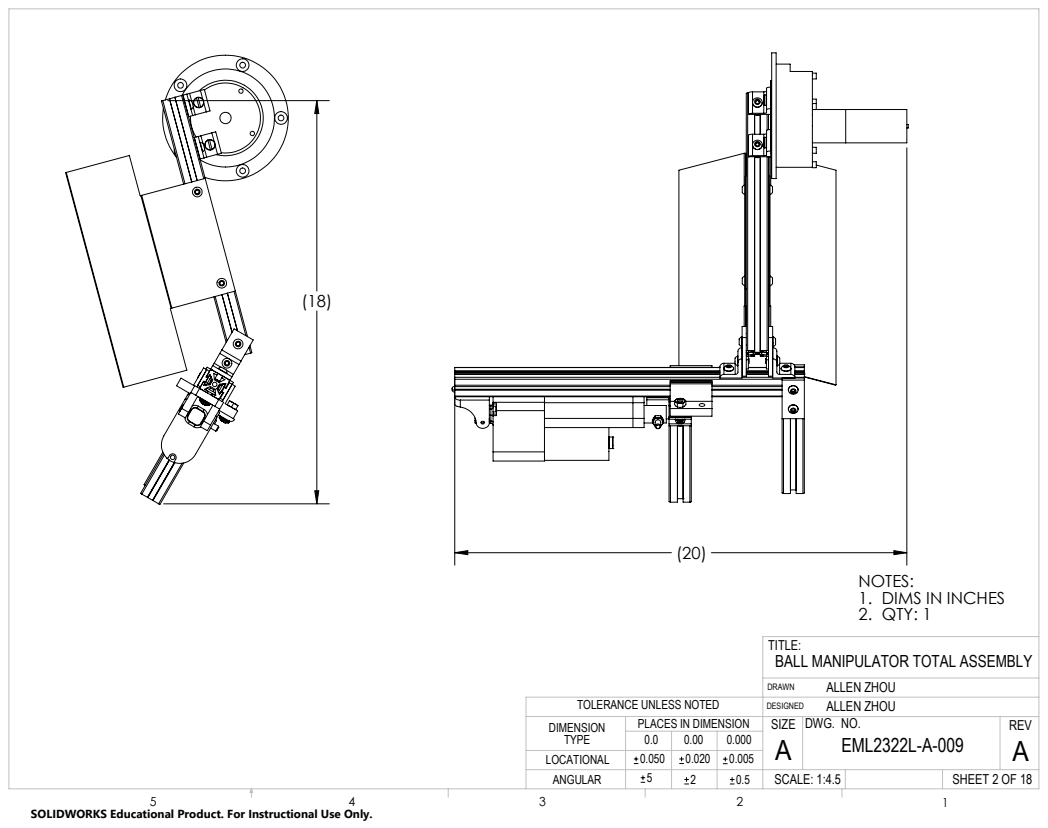
[picture p75: page 16]
REV A; EML2322L-A-009; DRAWN; DESIGNED; SCALE: 1:4.5; DIMS IN INCHES; NOTES: 1. 2. QTY: 1

TITLE:
BALL MANIPULATOR TOTAL ASSEMBLY
ALLEN ZHOU
DWG. NO.
SIZE

TOLERANCE UNLESS NOTED
DIMENSION
TYPE
LOCATIONAL

PLACES IN DIMENSION

ITEM NO. | PART NUMBER | DESCRIPTION | STRETCH/Q TY.
5 | EML2322L-0005 | 1/4-20 x 1/2 in BUTTON HEAD CAP SCREW | 6
6 | EML2322L-0006 | 1/4-20 T-NUT | 8
33 | EML2322L-0033 | BALL MANIPULATOR CHANNEL | 2
32 | EML2322L-0032 | 80/20 EXTRUSION - 12 in | 1
A6 | EML2322L-A-006 | CLAW ASSEMBLY | 1
A7 | EML2322L-A-007 | CLAW MOUNT ASSEMBLY | 2
A8 | EML2322L-A-008 | GLOBE MOTOR BRACKET ASSEMBLY | 2
A12 | EML2322L-A-012 | 4.5 RPM GLOBE MOTOR ASSEMBLY | 1
33 | EML2322L-0033 | BALL MANIPULATOR CHANNEL MOTOR SIDE | 1

BALL MANIPULATOR TOTAL ASSEMBLY

DWG. NO.

TITLE:

REV
A

SIZE

### A EML2322L-A-009

DRAWN
DESIGNED

ALLEN ZHOU
ALLEN ZHOU
0.0 | 0.00 | 0.000
0.050 0.020 0.005
LOCATIONAL

TOLERANCE UNLESS NOTED
DIMENSION
TYPE
5 | 2 | SCALE: 1:8

PLACES IN DIMENSION

DIMS IN INCHES

NOTES:
1.
2. QTY: 1

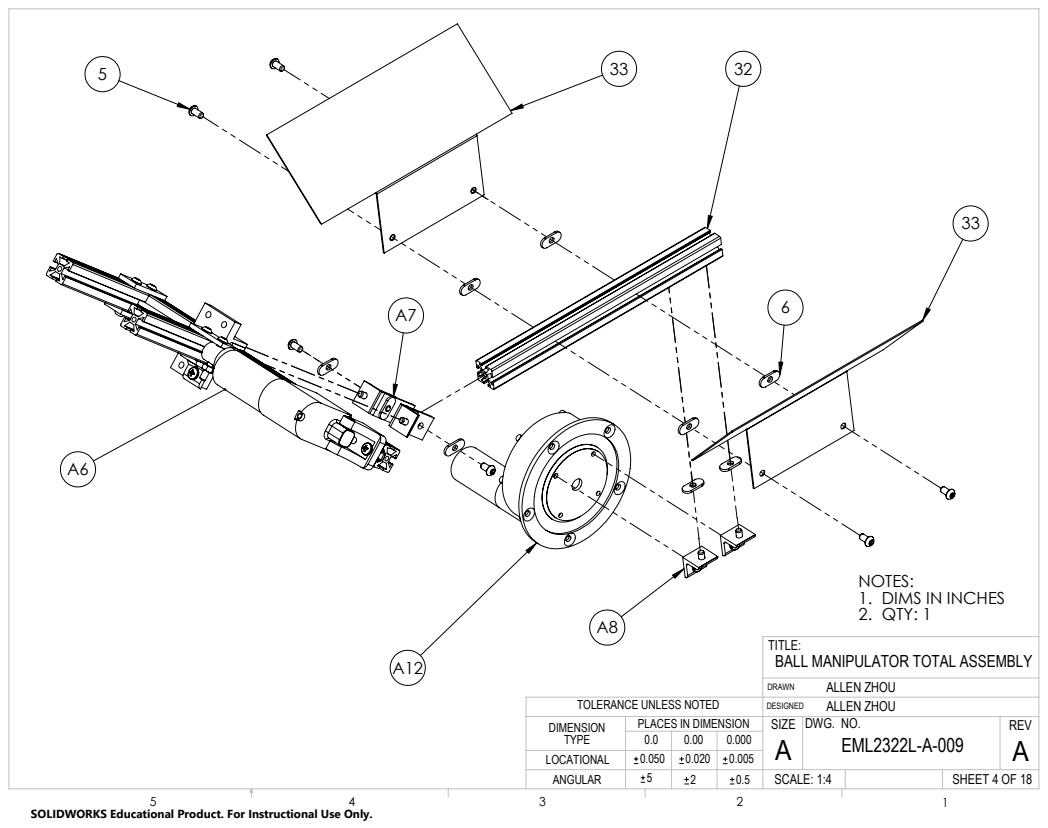
[picture p76: page 18]
REV A; EML2322L-A-009; DRAWN; DESIGNED; SCALE: 1:4; DIMS IN INCHES; NOTES: 1. 2. QTY: 1

TITLE:
BALL MANIPULATOR TOTAL ASSEMBLY
ALLEN ZHOU
DWG. NO.
SIZE

TOLERANCE UNLESS NOTED
DIMENSION
TYPE
LOCATIONAL

PLACES IN DIMENSION

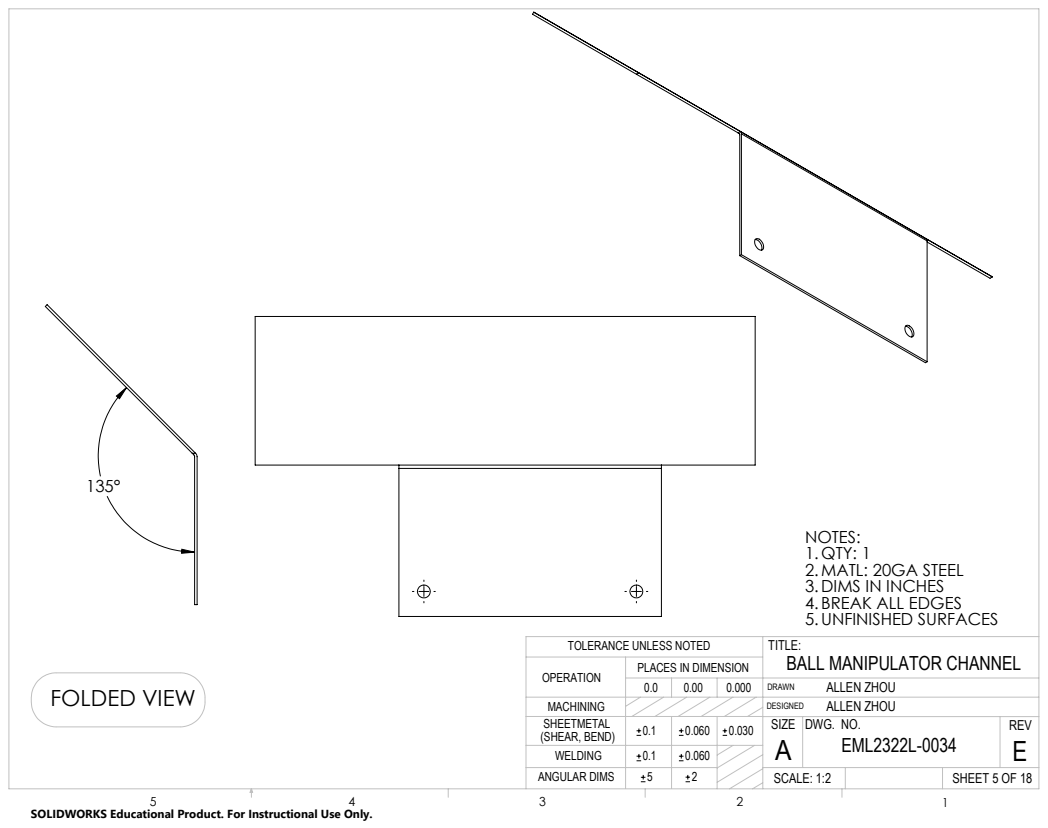
[picture p77: page 19]
BALL MANIPULATOR CHANNEL; SHEET 5 OF 18; DWG. NO.; TITLE:; REV E; SIZE; EML2322L-0034; DRAWN; DESIGNED; ALLEN ZHOU ALLEN ZHOU; SCALE: 1:2; FOLDED VIEW; NOTES: 1. 2. 3. 4. 5.; QTY: 1 DIMS IN INCHES BREAK ALL EDGES; MATL: 20GA STEEL; UNFINISHED SURFACES

TOLERANCE UNLESS NOTED
OPERATION
MACHINING
SHEETMETAL
(SHEAR, BEND)
WELDING
ANGULAR DIMS

PLACES IN DIMENSION

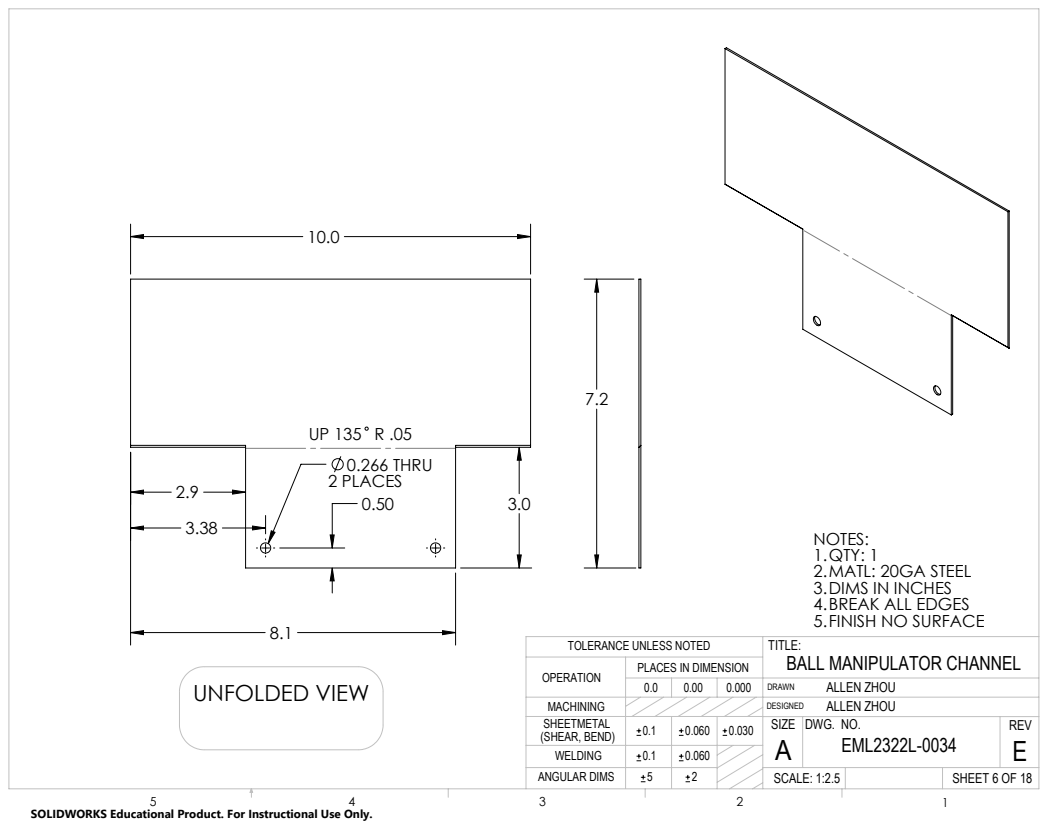
[picture p78: page 20]
0.266 THRU 2 PLACES; BALL MANIPULATOR CHANNEL; SHEET 6 OF 18; DWG. NO.; TITLE:; REV E; SIZE; EML2322L-0034; DRAWN; DESIGNED; ALLEN ZHOU ALLEN ZHOU; SCALE: 1:2.5; UNFOLDED VIEW; QTY: 1; NOTES: 1. 2. 3. 4. 5.; BREAK ALL EDGES; MATL: 20GA STEEL DIMS IN INCHES

FINISH NO SURFACE

TOLERANCE UNLESS NOTED
OPERATION
MACHINING
SHEETMETAL
(SHEAR, BEND)
WELDING
ANGULAR DIMS

PLACES IN DIMENSION

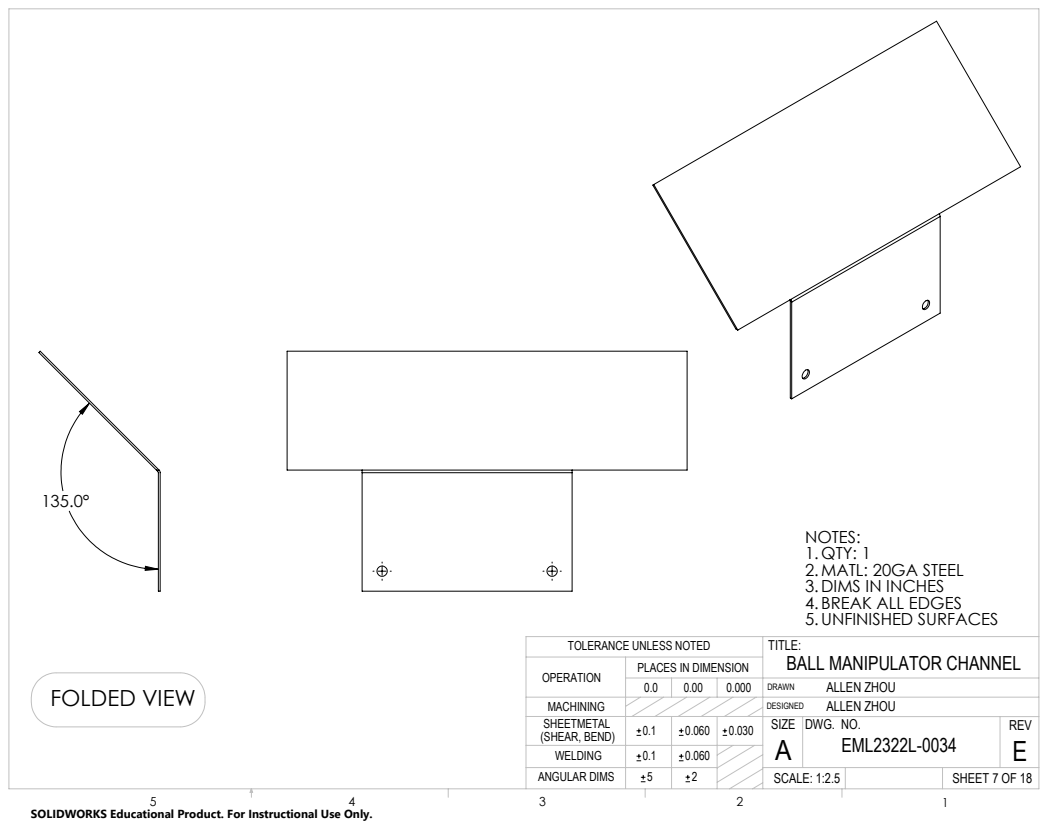
[picture p79: page 21]
BALL MANIPULATOR CHANNEL; SHEET 7 OF 18; DWG. NO.; TITLE:; REV E; SIZE; EML2322L-0034; DRAWN; DESIGNED; ALLEN ZHOU ALLEN ZHOU; SCALE: 1:2.5; FOLDED VIEW; NOTES: 1. 2. 3. 4. 5.; QTY: 1 DIMS IN INCHES BREAK ALL EDGES; MATL: 20GA STEEL; UNFINISHED SURFACES

TOLERANCE UNLESS NOTED
OPERATION
MACHINING
SHEETMETAL
(SHEAR, BEND)
WELDING
ANGULAR DIMS

PLACES IN DIMENSION

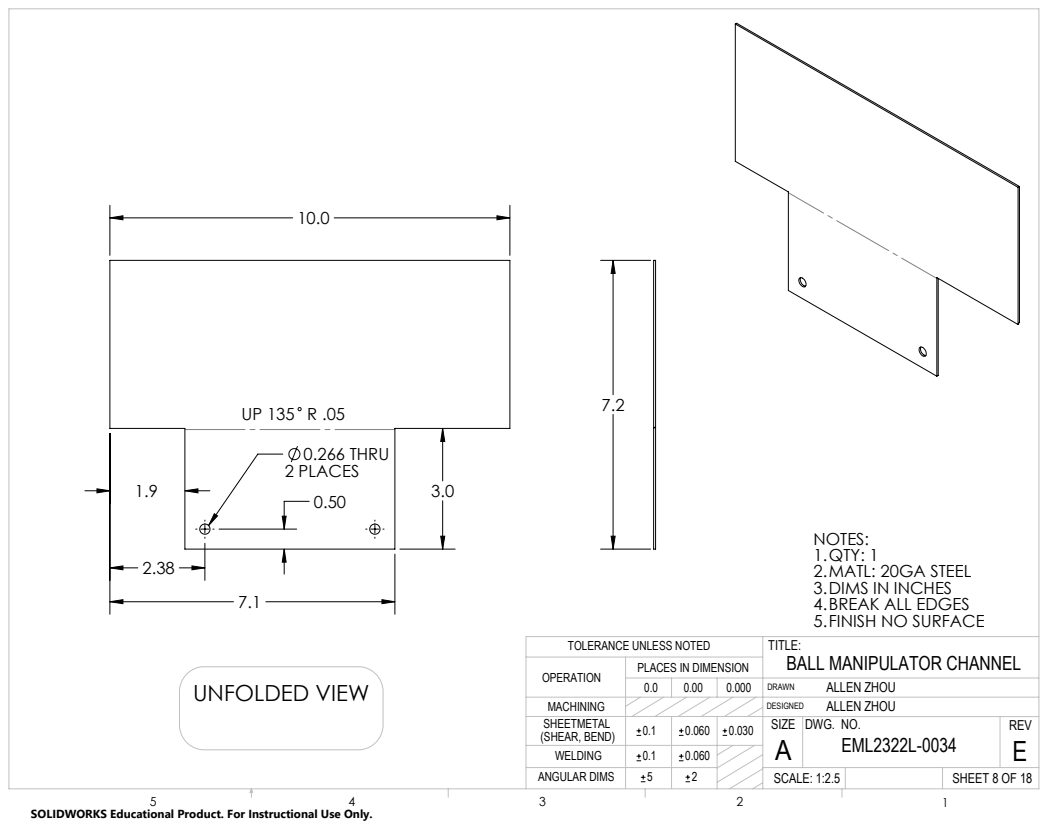
[picture p80: page 22]
0.266 THRU 2 PLACES; BALL MANIPULATOR CHANNEL; SHEET 8 OF 18; DWG. NO.; TITLE:; REV E; SIZE; EML2322L-0034; DRAWN; DESIGNED; ALLEN ZHOU ALLEN ZHOU; SCALE: 1:2.5; UNFOLDED VIEW; QTY: 1; NOTES: 1. 2. 3. 4. 5.; BREAK ALL EDGES; MATL: 20GA STEEL DIMS IN INCHES

FINISH NO SURFACE

TOLERANCE UNLESS NOTED
OPERATION
MACHINING
SHEETMETAL
(SHEAR, BEND)
WELDING
ANGULAR DIMS

PLACES IN DIMENSION

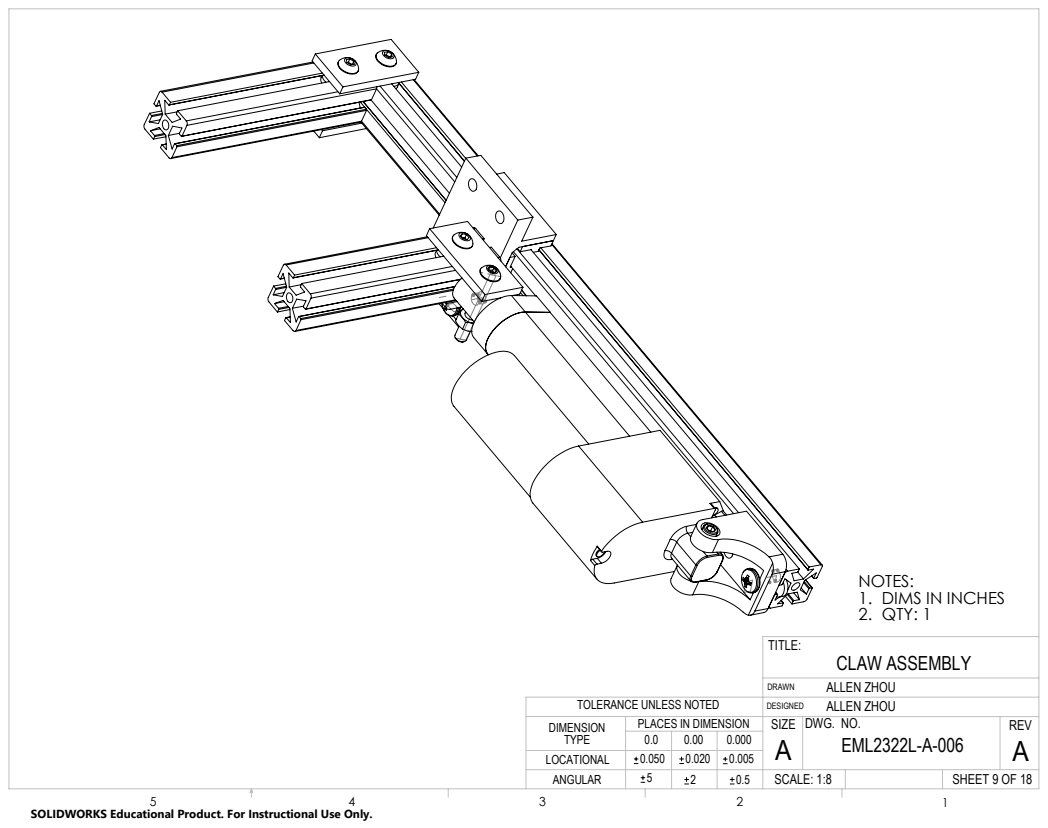
[picture p81: page 23]
TITLE:; REV A; EML2322L-A-006; DRAWN; DESIGNED; SCALE: 1:8

NOTES:
DIMS IN INCHES
2. QTY: 1
CLAW ASSEMBLY
ALLEN ZHOU
DWG. NO.
SIZE

TOLERANCE UNLESS NOTED
DIMENSION
TYPE
LOCATIONAL

PLACES IN DIMENSION

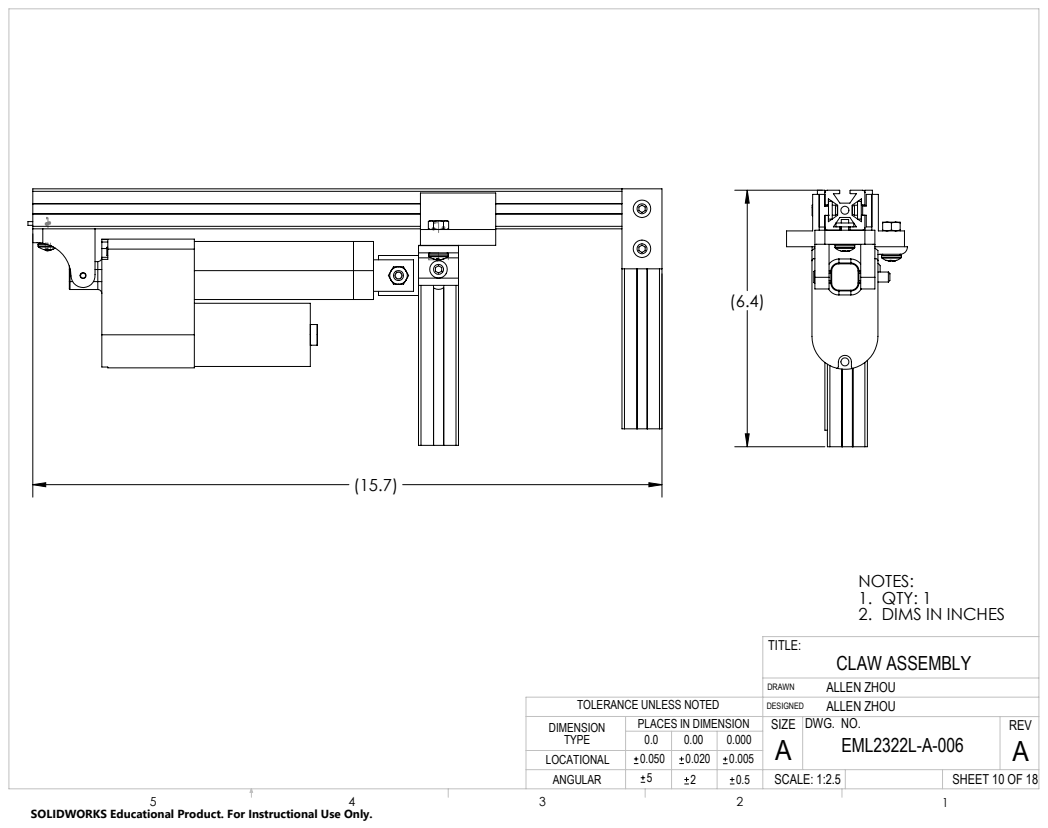
[picture p82: page 24]
TITLE:; REV A; EML2322L-A-006; DRAWN; DESIGNED; SCALE: 1:2.5

NOTES:
QTY: 1
2. DIMS IN INCHES
CLAW ASSEMBLY
ALLEN ZHOU
DWG. NO.
SIZE

TOLERANCE UNLESS NOTED
DIMENSION
TYPE
LOCATIONAL

PLACES IN DIMENSION

ITEM NO. | PART NUMBER | DESCRIPTION | QTY.
6 | EML2322L-0006 | 1/4-20 T-NUT | 1
34 | EML2322L-0034 | 80/20 EXTRUSION - 15.7 in | 1
36 | EML2322L-0036 | 80/20 LINEAR SLIDE | 1
37 | EML2322L-0037 | 10-24 LINEAR ACTUATOR MOUNT | 1
35 | EML2322L-0035 | 30 IPM SPAL LINEAR ACTUATOR (2in) | 1
28 | EML2322L-0028 | 1/4-20 x 3/4 in PAN HEAD SCREW | 1
24 | EML2322L-0024 | 1/4-20 x 1.75 in BUTTON HEAD SCREW | 1
22 | EML2322L-0022 | 1/4-20 x 5/8 in PAN HEAD SCREW | 1
20 | EML2322L-0020 | 1/4-20 in HEX NUT | 2
19 | EML2322L-0019 | 10-24 x 1.25 in SOCKET HEAD SCREW | 1
38 | EML2322L-0038 | 80-20 EXTRUSION - 4.5 in | 1
A10 | EML2322L-A-010 | 90-DEGREE BRACKET ASSEMBLY | 1
A11 | EML2322L-A-011 | STRAIGHT BRACKET ASSEMBLY | 1
29 | EML2322L-0029 | 80-20 EXTRUSION - 5.0 in | 1
A11 | EML2322L-A-011 | STRAIGHT BRACKET ASSEMBLY | 2

### CLAW ASSEMBLY

DWG. NO.

TITLE:

REV
A

SIZE

### A EML2322L-A-006

DRAWN
DESIGNED

ALLEN ZHOU
ALLEN ZHOU
0.0 | 0.00 | 0.000
0.050 0.020 0.005
LOCATIONAL

TOLERANCE UNLESS NOTED
DIMENSION
TYPE
5 | 2 | SCALE: 1:8

PLACES IN DIMENSION

QTY: 1

NOTES:
1.
2. ALL DIMS IN INCHES

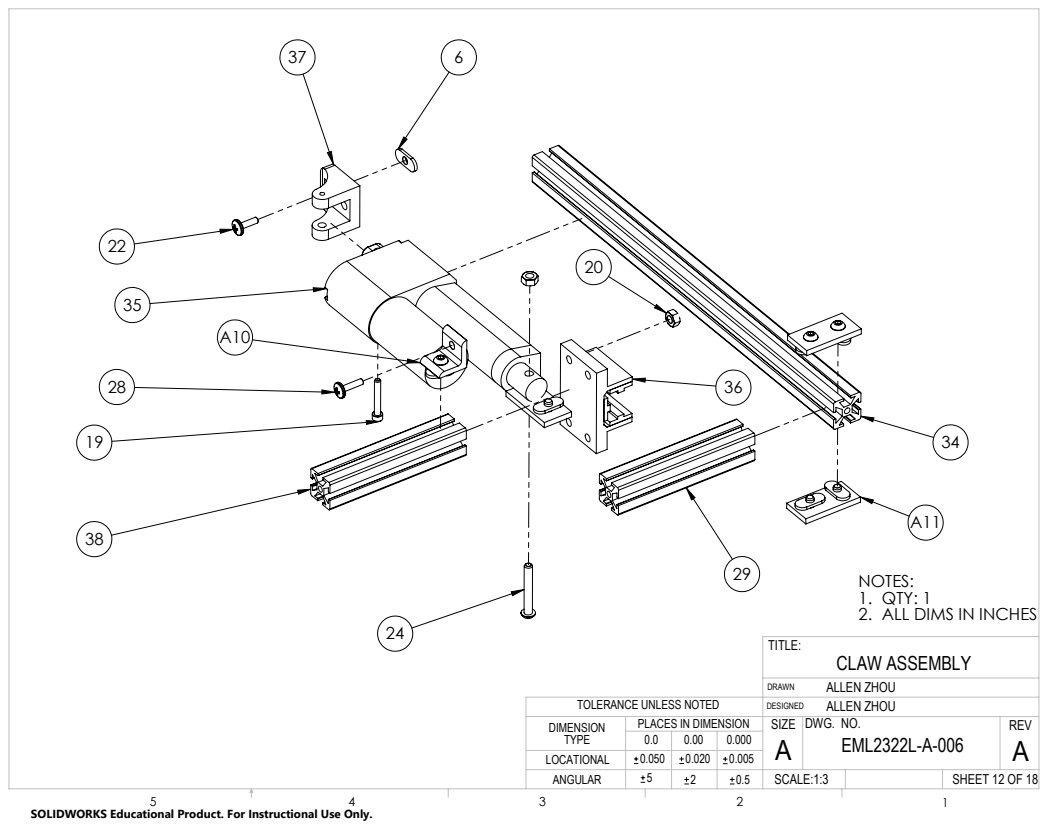
[picture p83: page 26]
TITLE:; REV A; EML2322L-A-006; DRAWN; DESIGNED; SCALE:1:3

NOTES:
QTY: 1
2. ALL DIMS IN INCHES
CLAW ASSEMBLY
ALLEN ZHOU
DWG. NO.
SIZE

TOLERANCE UNLESS NOTED
DIMENSION
TYPE
LOCATIONAL

PLACES IN DIMENSION

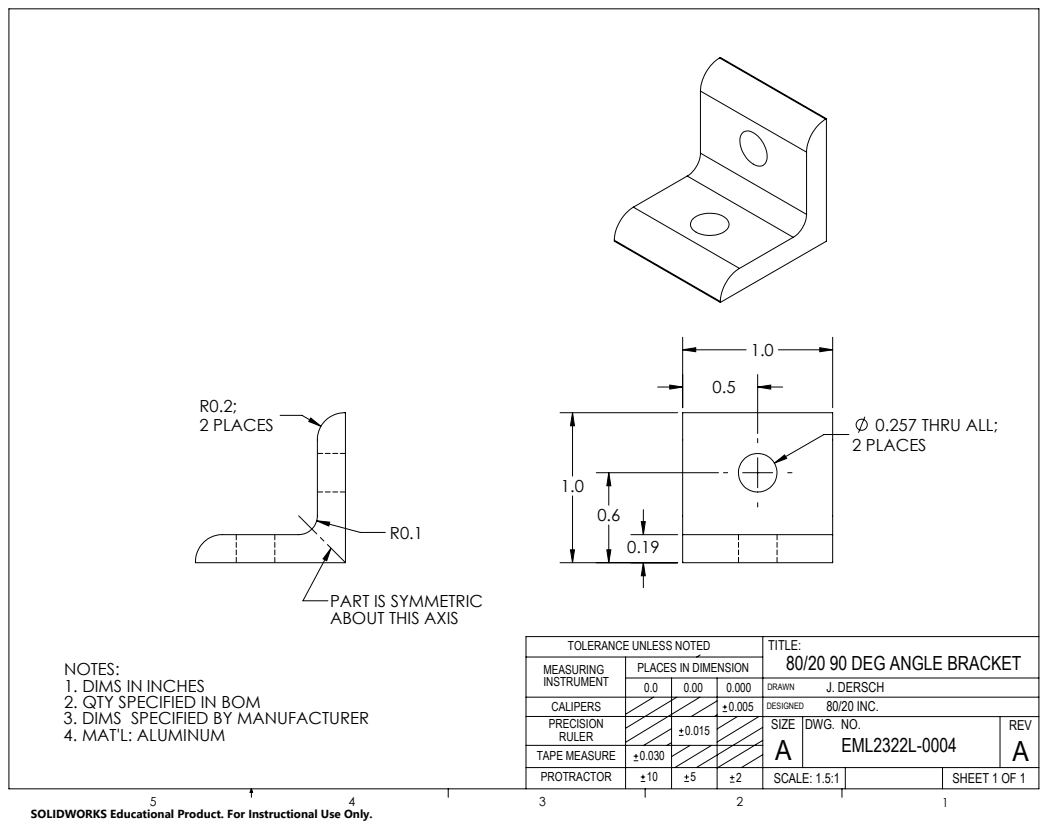
[picture p84: page 27]
R0.2; 2 PLACES; 0.257 THRU ALL; 2 PLACES; SHEET 1 OF 1; REV A; SIZE; EML2322L-0004; DRAWN; DESIGNED; PROTRACTOR; TAPE MEASURE; PRECISION RULER; CALIPERS; TOLERANCE UNLESS NOTED MEASURING INSTRUMENT; SCALE: 1.5:1; INCHES

PART IS SYMMETRIC
ABOUT THIS AXIS

TITLE:
80/20 90 DEG ANGLE BRACKET
J. DERSCH
80/20 INC.
DWG. NO.

NOTES:
1. DIMS IN
2. QTY SPECIFIED IN BOM
3. DIMS SPECIFIED BY MANUFACTURER
4. MAT'L: ALUMINUM

PLACES IN DIMENSION

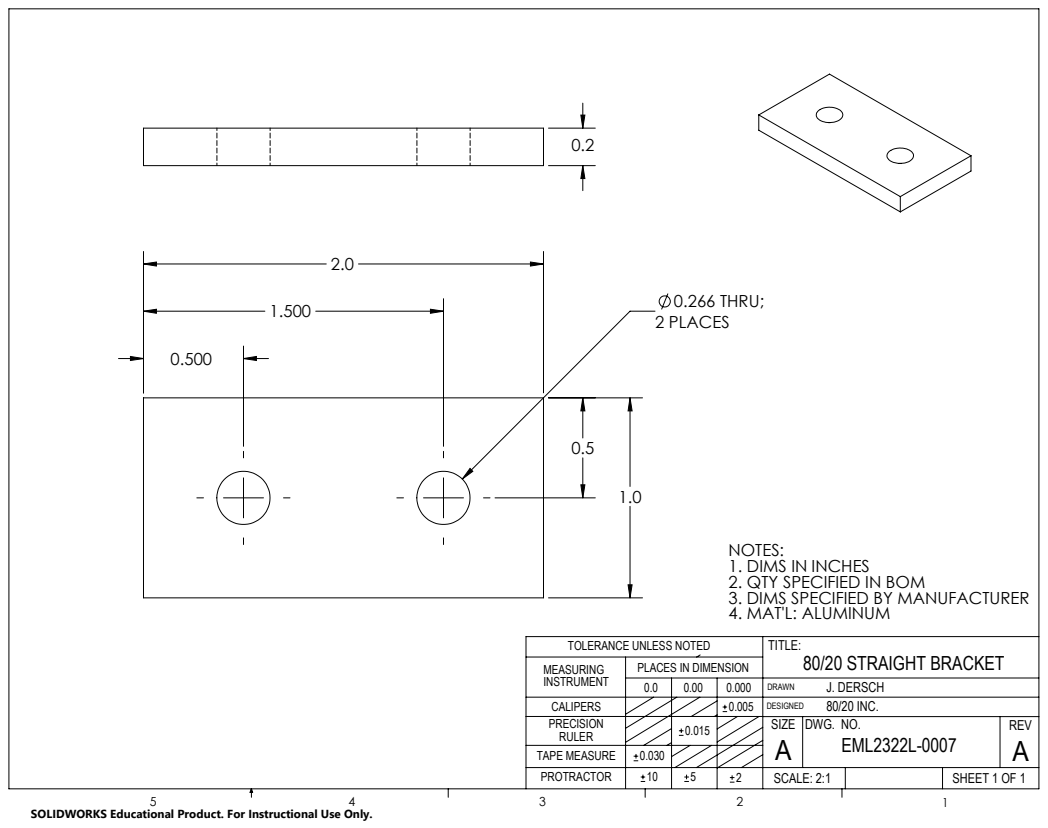
[picture p85: page 28]
0.266 THRU; 2 PLACES; SHEET 1 OF 1; REV A; SIZE; EML2322L-0007; DRAWN; DESIGNED; PROTRACTOR; TAPE MEASURE; PRECISION RULER; CALIPERS; TOLERANCE UNLESS NOTED MEASURING INSTRUMENT; SCALE: 2:1; INCHES

NOTES:
1. DIMS IN
2. QTY SPECIFIED IN BOM
3. DIMS SPECIFIED BY MANUFACTURER
4. MAT'L: ALUMINUM
TITLE:
80/20 STRAIGHT BRACKET
J. DERSCH
80/20 INC.
DWG. NO.

PLACES IN DIMENSION

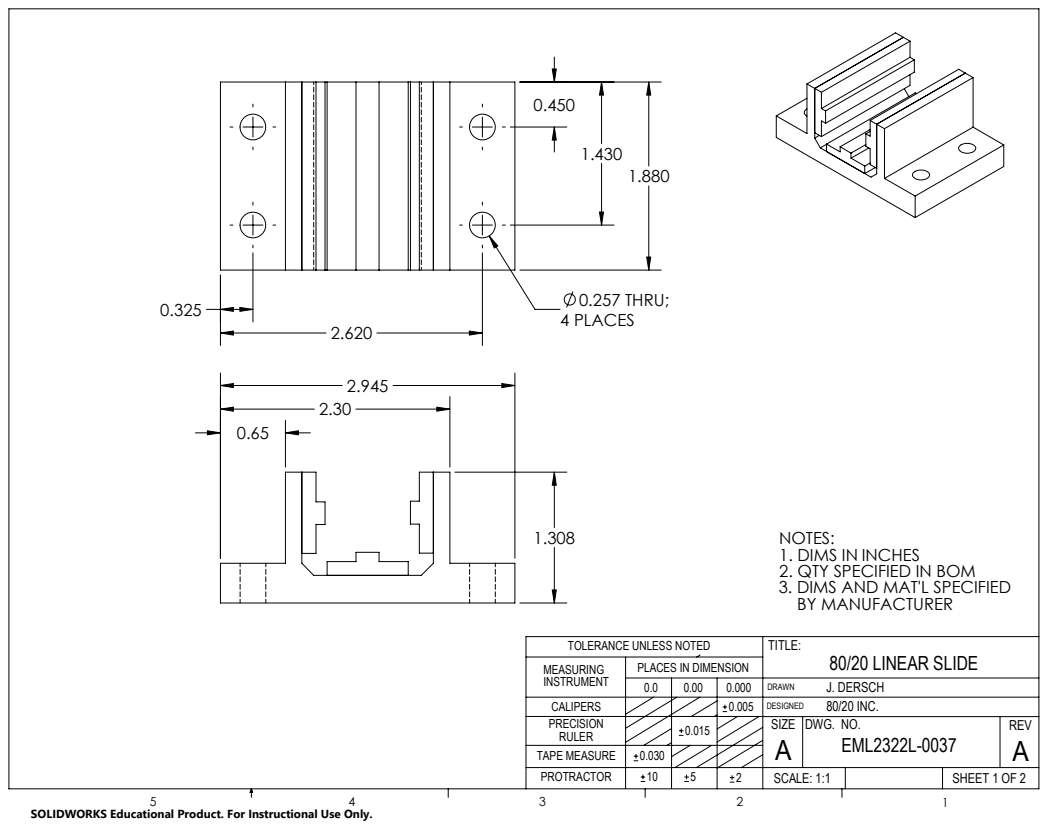
[picture p86: page 29]
0.257 THRU; 4 PLACES; 80/20 LINEAR SLIDE; SHEET 1 OF 2; DWG. NO.; TITLE:; REV A; SIZE; EML2322L-0037; DRAWN; DESIGNED; J. DERSCH 80/20 INC.; PROTRACTOR; TAPE MEASURE; PRECISION RULER; CALIPERS; TOLERANCE UNLESS NOTED MEASURING INSTRUMENT; SCALE: 1:1; INCHES

NOTES:
1. DIMS IN
2. QTY SPECIFIED IN BOM
3. DIMS AND MAT'L SPECIFIED
BY MANUFACTURER

PLACES IN DIMENSION

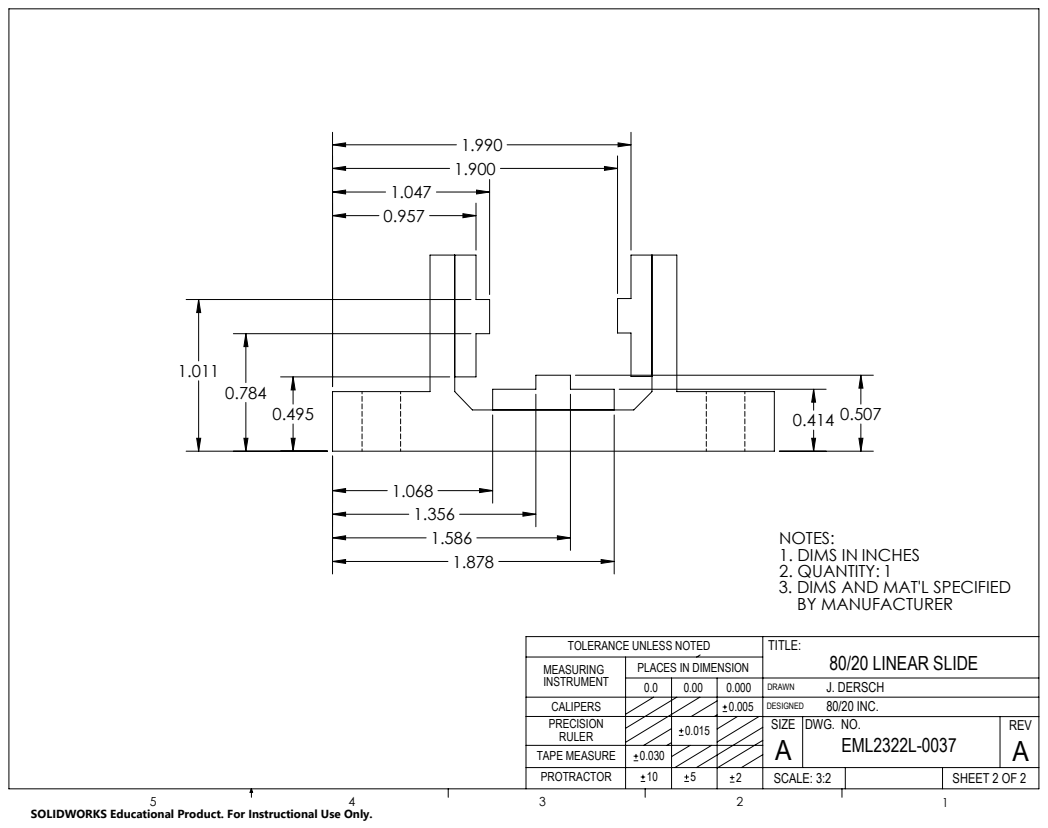
[picture p87: page 30]
80/20 LINEAR SLIDE; SHEET 2 OF 2; DWG. NO.; TITLE:; REV A; SIZE; EML2322L-0037; DRAWN; DESIGNED; J. DERSCH 80/20 INC.; PROTRACTOR; TAPE MEASURE; PRECISION RULER; CALIPERS; TOLERANCE UNLESS NOTED MEASURING INSTRUMENT; SCALE: 3:2; INCHES 1

NOTES:
1. DIMS IN
2. QUANTITY:
3. DIMS AND MAT'L SPECIFIED
BY MANUFACTURER

PLACES IN DIMENSION

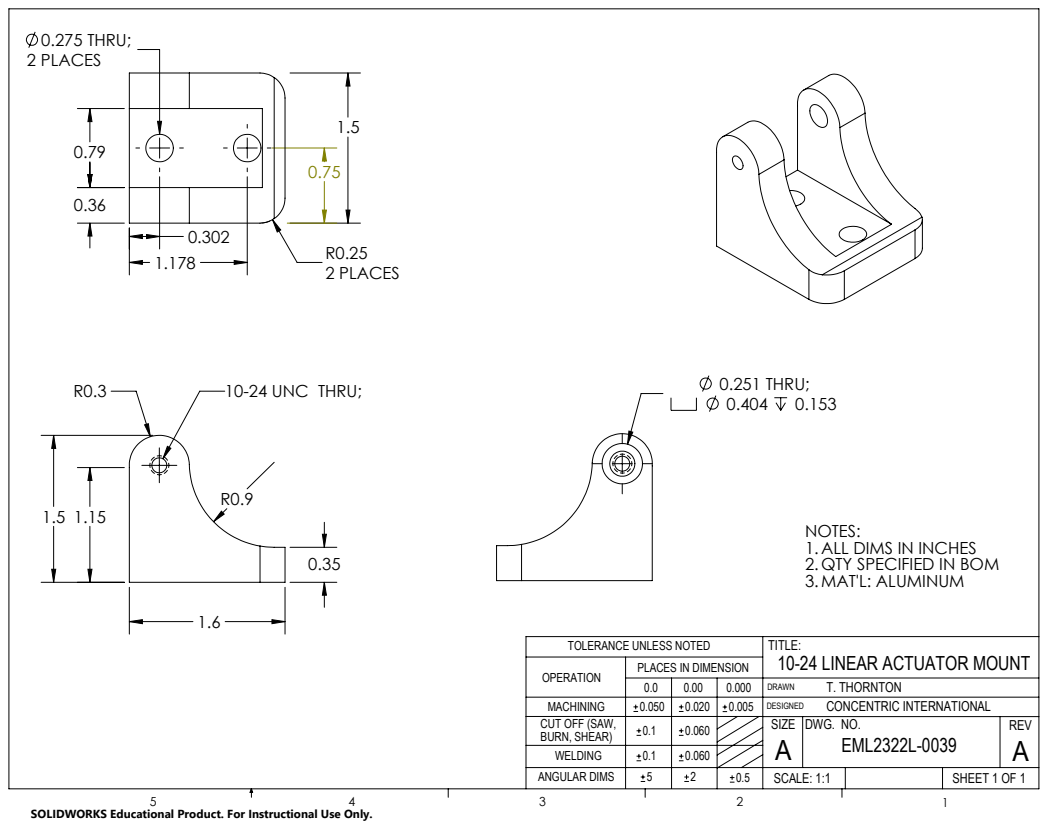
[picture p88: page 31]
10-24 UNC THRU;; 0.275 THRU; 2 PLACES; R0.25 2 PLACES; 0.251 THRU; 0.404 0.153; REV A; SIZE; EML2322L-0039; DRAWN; DESIGNED; SCALE: 1:1

NOTES:
ALL DIMS IN INCHES
QTY SPECIFIED IN BOM
MAT'L: ALUMINUM

TOLERANCE UNLESS NOTED
OPERATION
MACHINING
CUT OFF (SAW,
BURN, SHEAR)
WELDING
ANGULAR DIMS

TITLE:
10-24 LINEAR ACTUATOR MOUNT
T. THORNTON
CONCENTRIC INTERNATIONAL
DWG. NO.

PLACES IN DIMENSION

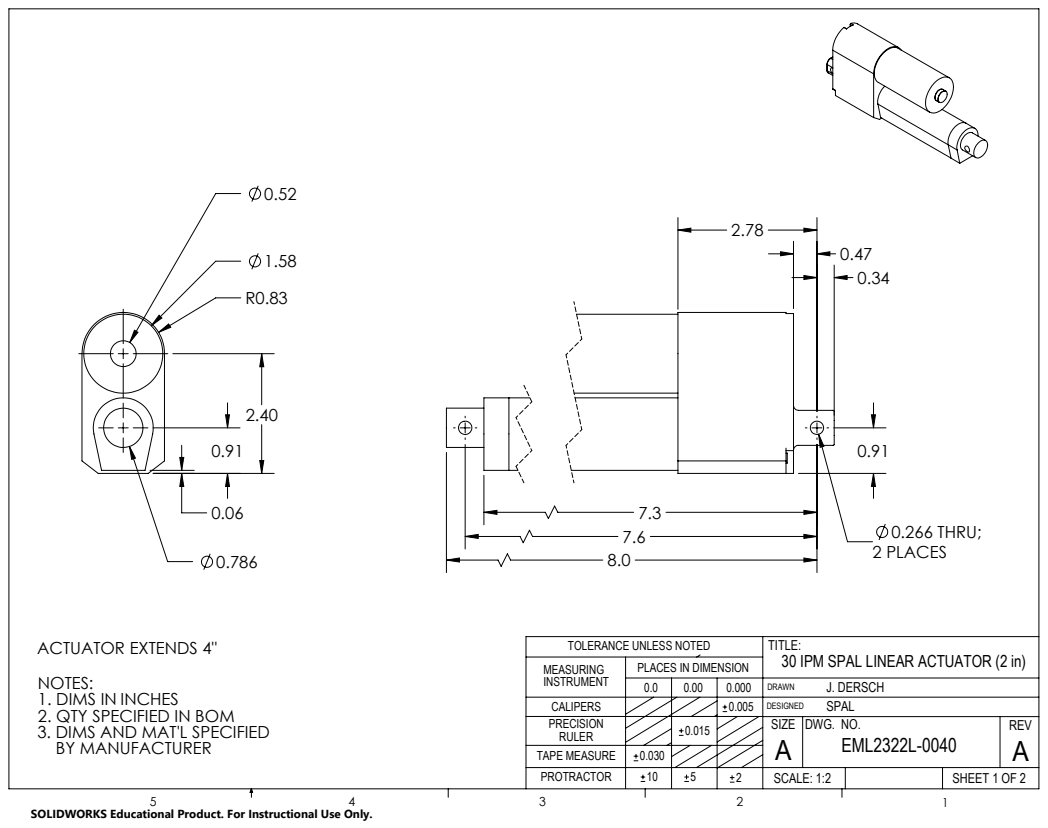
[picture p89: page 32]
0.266 THRU; 2 PLACES; SHEET 1 OF 2; REV A; SIZE; EML2322L-0040; DRAWN; DESIGNED; PROTRACTOR; TAPE MEASURE; PRECISION RULER; CALIPERS; TOLERANCE UNLESS NOTED MEASURING INSTRUMENT; SCALE: 1:2; INCHES

ACTUATOR EXTENDS 4"
NOTES:
1. DIMS IN
2. QTY SPECIFIED IN BOM
3. DIMS AND MAT'L SPECIFIED
BY MANUFACTURER

TITLE:
30 IPM SPAL LINEAR ACTUATOR (2 in)
J. DERSCH
SPAL
DWG. NO.

PLACES IN DIMENSION

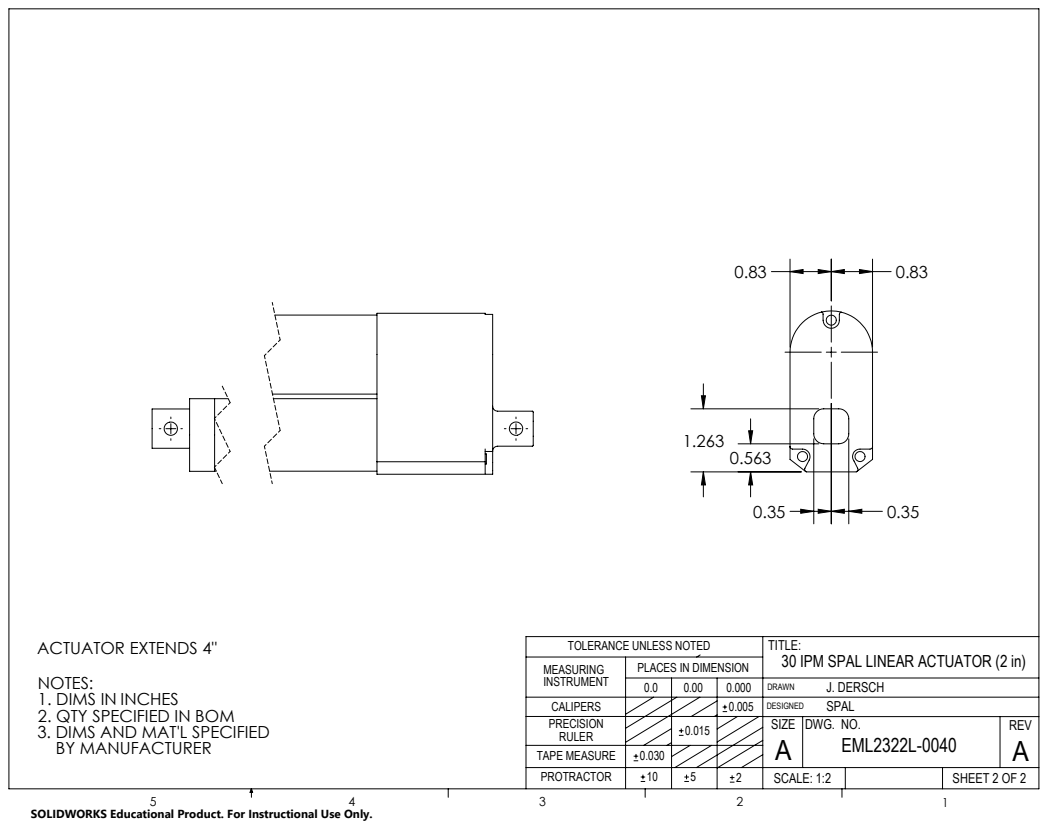
[picture p90: page 33]
SHEET 2 OF 2; REV A; SIZE; EML2322L-0040; DRAWN; DESIGNED; PROTRACTOR; TAPE MEASURE; PRECISION RULER; CALIPERS; TOLERANCE UNLESS NOTED MEASURING INSTRUMENT; SCALE: 1:2; INCHES

ACTUATOR EXTENDS 4"
NOTES:
1. DIMS IN
2. QTY SPECIFIED IN BOM
3. DIMS AND MAT'L SPECIFIED
BY MANUFACTURER

TITLE:
30 IPM SPAL LINEAR ACTUATOR (2 in)
J. DERSCH
SPAL
DWG. NO.

PLACES IN DIMENSION

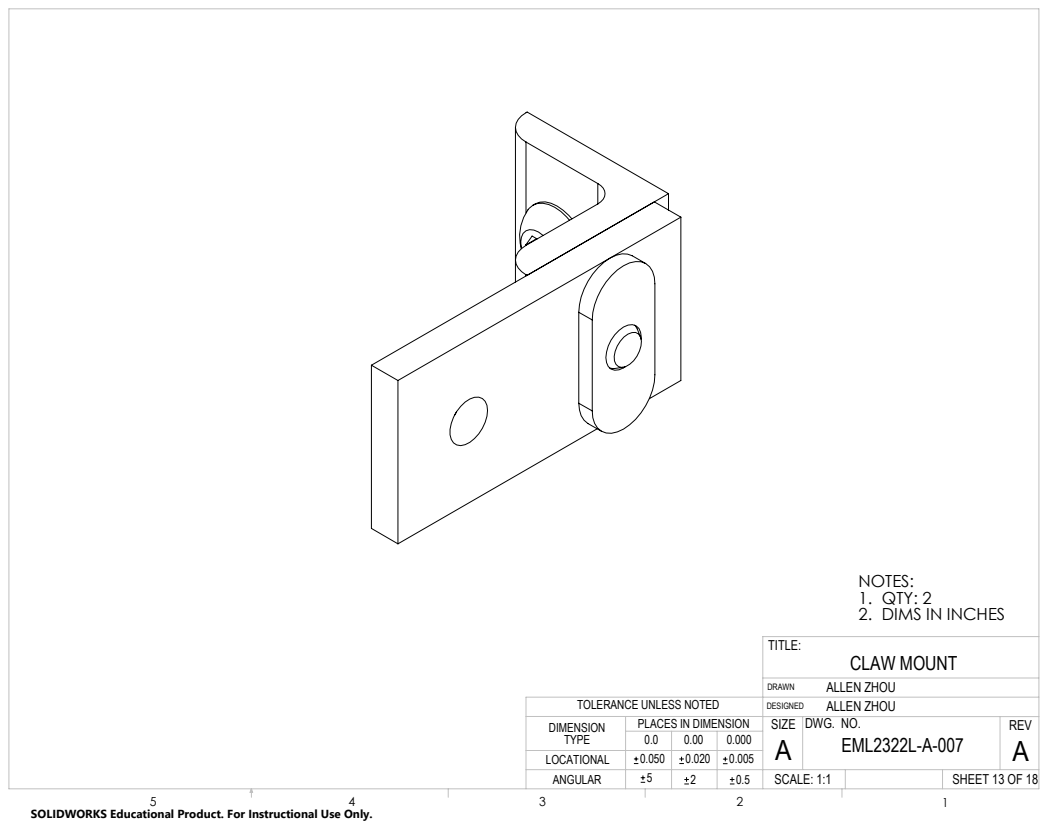
[picture p91: page 34]
TITLE:; REV A; EML2322L-A-007; DRAWN; DESIGNED; SCALE: 1:1

NOTES:
QTY: 2
2. DIMS IN INCHES
CLAW MOUNT
ALLEN ZHOU
DWG. NO.
SIZE

TOLERANCE UNLESS NOTED
DIMENSION
TYPE
LOCATIONAL

PLACES IN DIMENSION

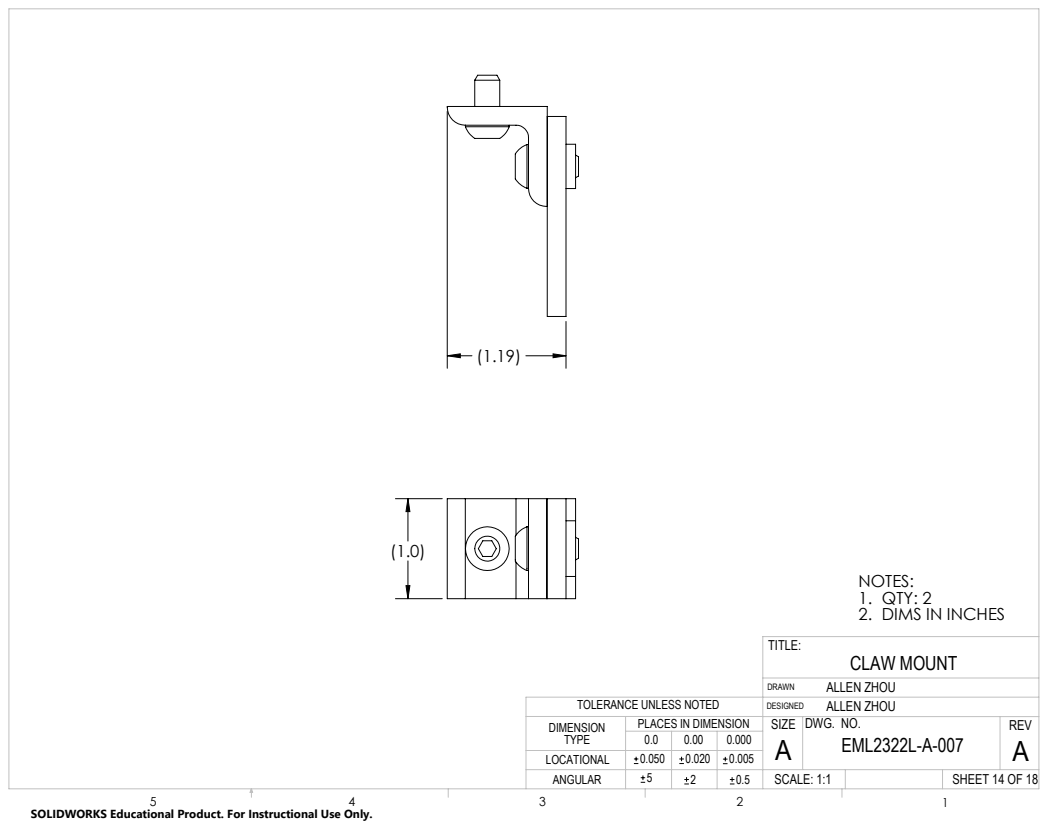
[picture p92: page 35]
TITLE:; REV A; EML2322L-A-007; DRAWN; DESIGNED; SCALE: 1:1

NOTES:
QTY: 2
2. DIMS IN INCHES
CLAW MOUNT
ALLEN ZHOU
DWG. NO.
SIZE

TOLERANCE UNLESS NOTED
DIMENSION
TYPE
LOCATIONAL

PLACES IN DIMENSION

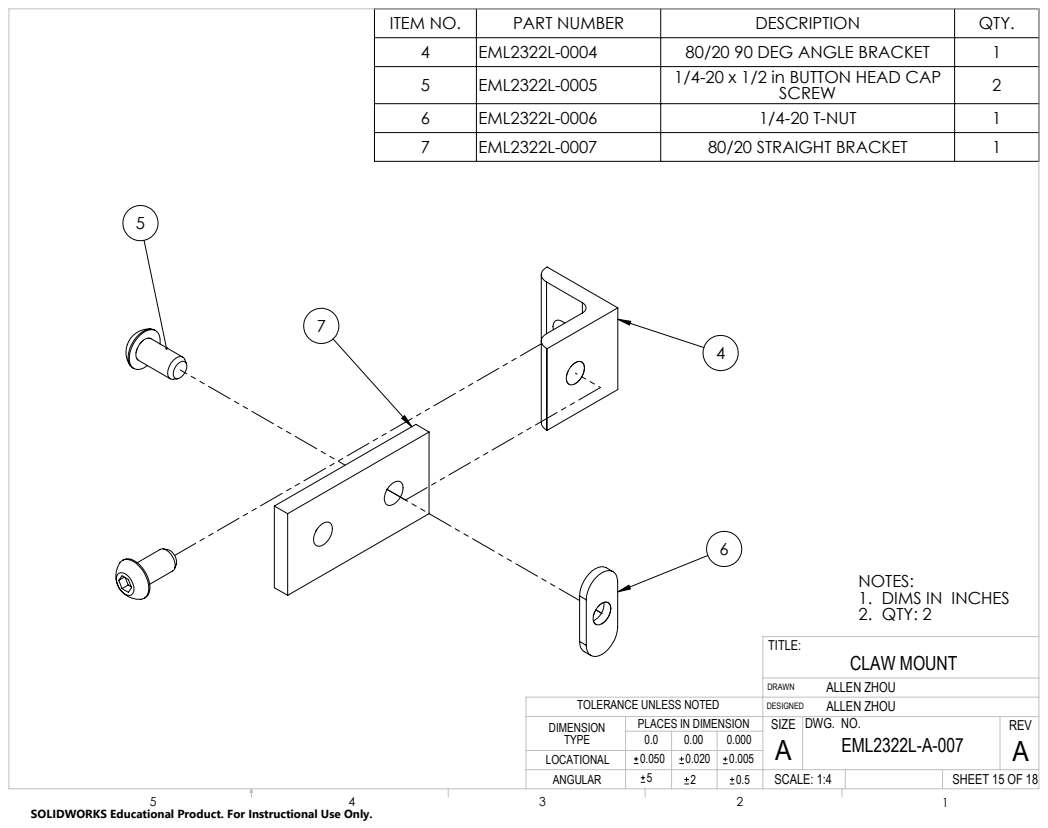
[picture p93: page 36]
TITLE:; REV A; EML2322L-A-007; DRAWN; DESIGNED; SCALE: 1:4

ITEM NO. | PART NUMBER | DESCRIPTION | QTY.
4 | EML2322L-0004 | 80/20 90 DEG ANGLE BRACKET | 1
5 | EML2322L-0005 | 1/4-20 x 1/2 in BUTTON HEAD CAP SCREW | 2
6 | EML2322L-0006 | 1/4-20 T-NUT | 1
7 | EML2322L-0007 | 80/20 STRAIGHT BRACKET | 1

NOTES:
DIMS IN INCHES
2. QTY: 2
CLAW MOUNT
ALLEN ZHOU
DWG. NO.
SIZE

TOLERANCE UNLESS NOTED
DIMENSION
TYPE
LOCATIONAL

PLACES IN DIMENSION

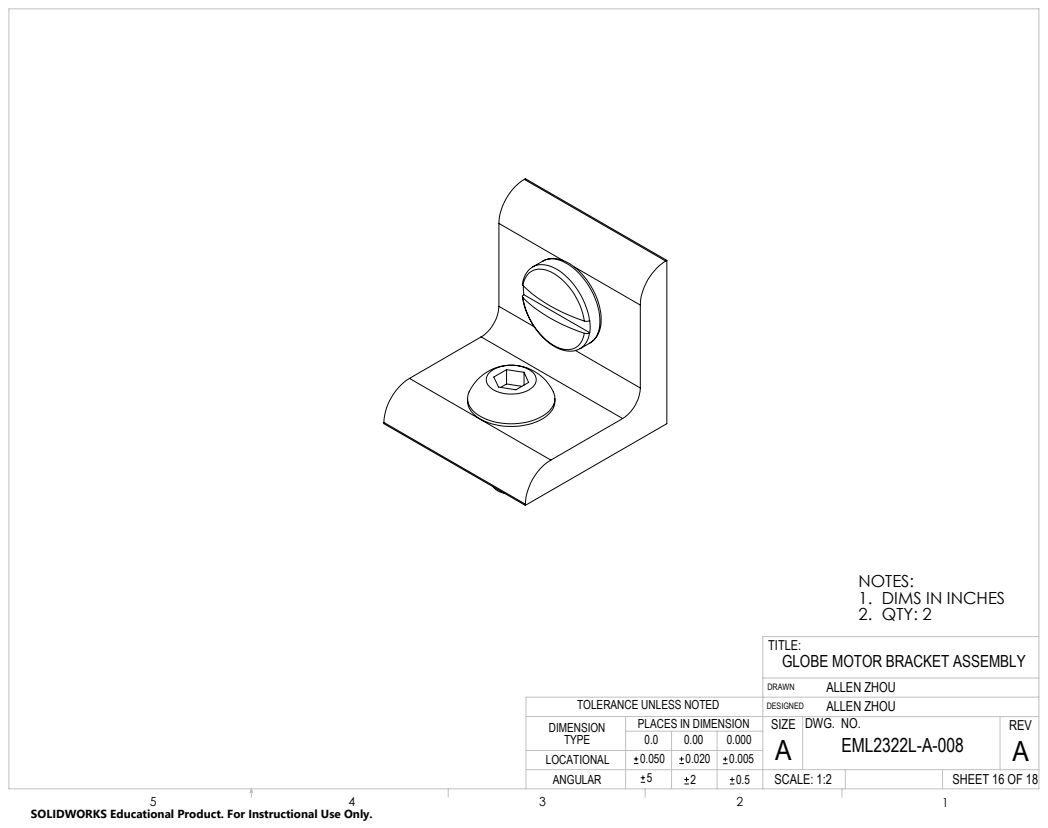
[picture p94: page 37]
REV A; EML2322L-A-008; DRAWN; DESIGNED; SCALE: 1:2; DIMS IN INCHES; NOTES: 1. 2. QTY: 2

TITLE:
GLOBE MOTOR BRACKET ASSEMBLY
ALLEN ZHOU
DWG. NO.
SIZE

TOLERANCE UNLESS NOTED
DIMENSION
TYPE
LOCATIONAL

PLACES IN DIMENSION

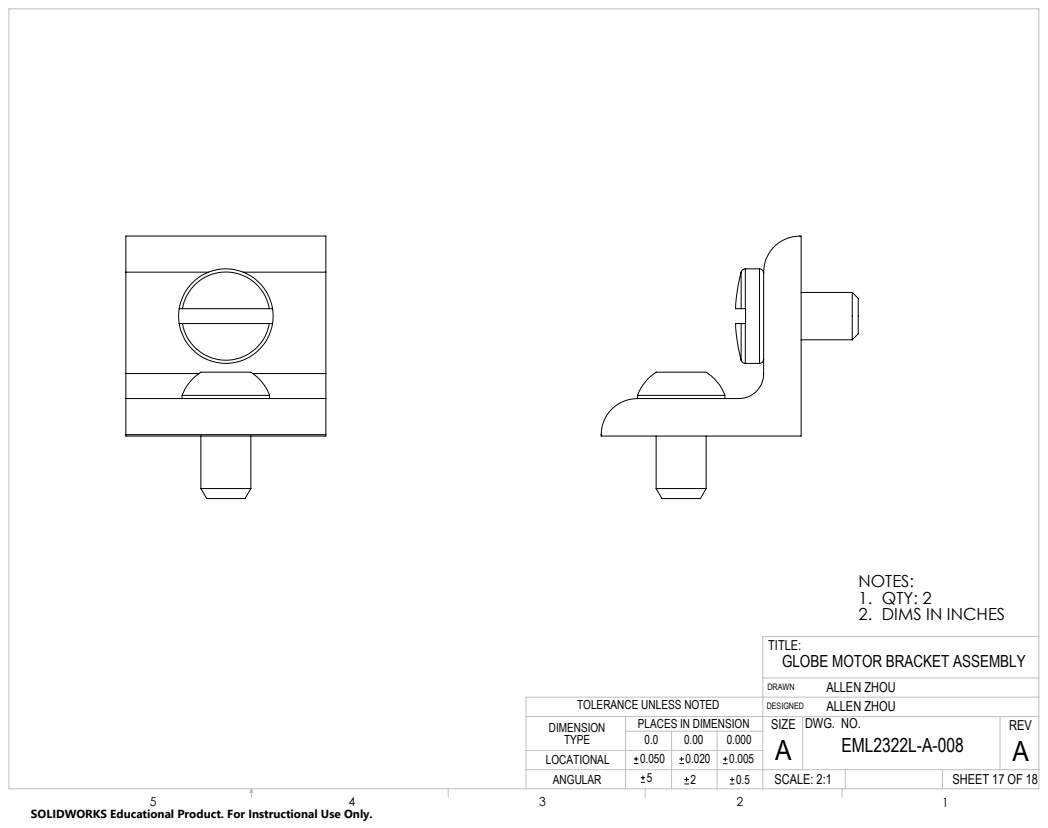
[picture p95: page 38]
REV A; EML2322L-A-008; DRAWN; DESIGNED; SCALE: 2:1; QTY: 2; NOTES: 1. 2. DIMS IN INCHES

TITLE:
GLOBE MOTOR BRACKET ASSEMBLY
ALLEN ZHOU
DWG. NO.
SIZE

TOLERANCE UNLESS NOTED
DIMENSION
TYPE
LOCATIONAL

PLACES IN DIMENSION

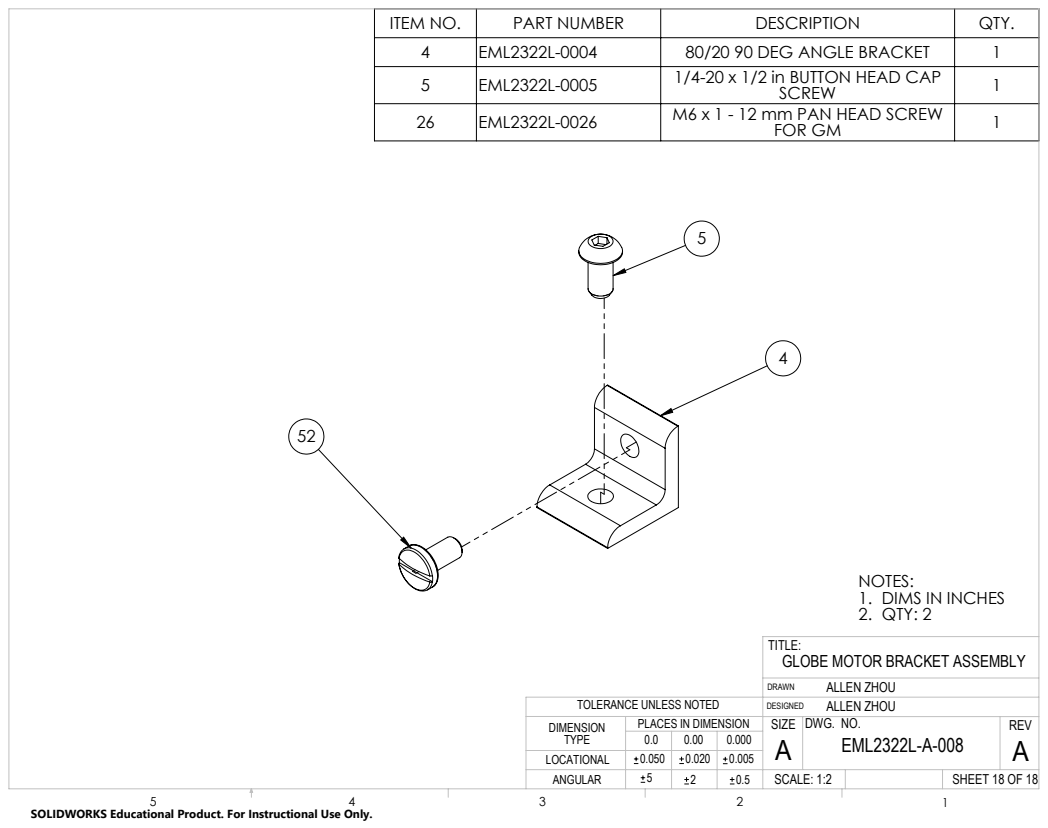
[picture p96: page 39]
REV A; EML2322L-A-008; DRAWN; DESIGNED; SCALE: 1:2; DIMS IN INCHES; NOTES: 1. 2. QTY: 2

ITEM NO. | PART NUMBER | DESCRIPTION | QTY.
4 | EML2322L-0004 | 80/20 90 DEG ANGLE BRACKET | 1
5 | EML2322L-0005 | 1/4-20 x 1/2 in BUTTON HEAD CAP SCREW | 1
26 | EML2322L-0026 | M6 x 1 - 12 mm PAN HEAD SCREW FOR GM | 1

TITLE:
GLOBE MOTOR BRACKET ASSEMBLY
ALLEN ZHOU
DWG. NO.
SIZE

TOLERANCE UNLESS NOTED
DIMENSION
TYPE
LOCATIONAL

PLACES IN DIMENSION

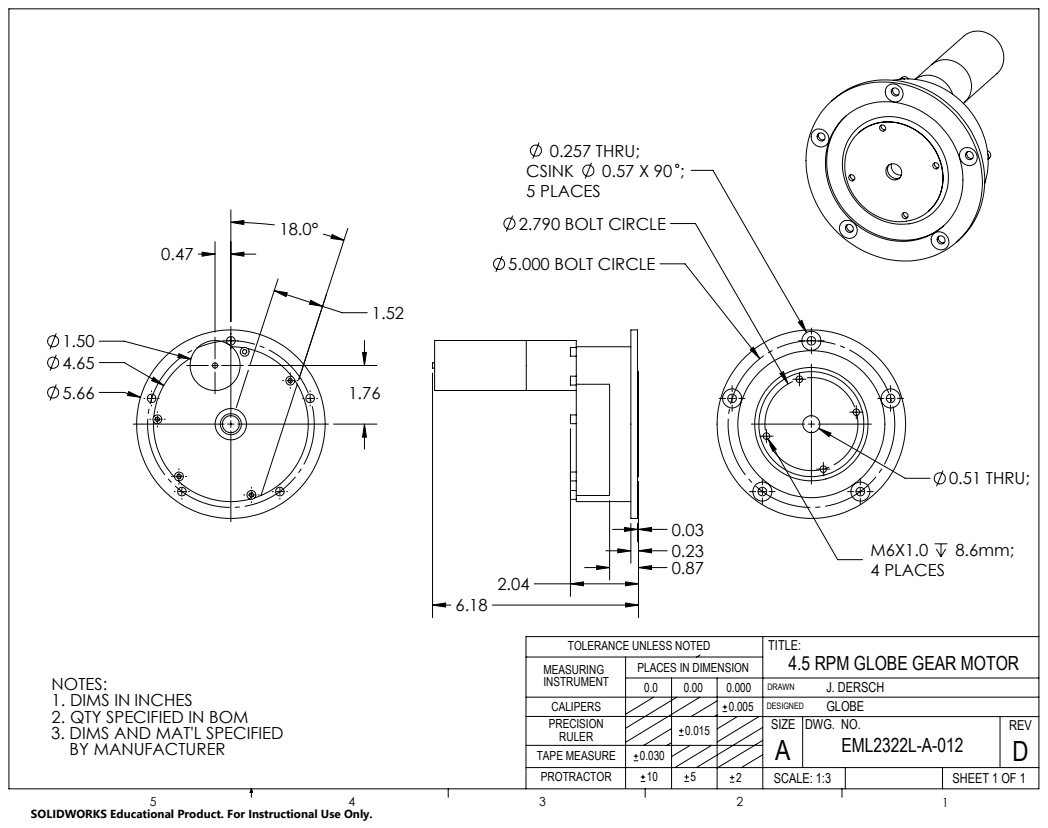
[picture p97: page 40]
0.257 THRU;; CSINK; 5 PLACES; 0.51 THRU;; M6X1.0 8.6mm; 4 PLACES; 2.790 BOLT CIRCLE; 5.000 BOLT CIRCLE; SHEET 1 OF 1; REV D; SIZE; EML2322L-A-012; DRAWN; DESIGNED; PROTRACTOR; TAPE MEASURE; PRECISION RULER; CALIPERS; TOLERANCE UNLESS NOTED MEASURING INSTRUMENT; SCALE: 1:3; INCHES

TITLE:
4.5 RPM GLOBE GEAR MOTOR
J. DERSCH
GLOBE
DWG. NO.

PLACES IN DIMENSION

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

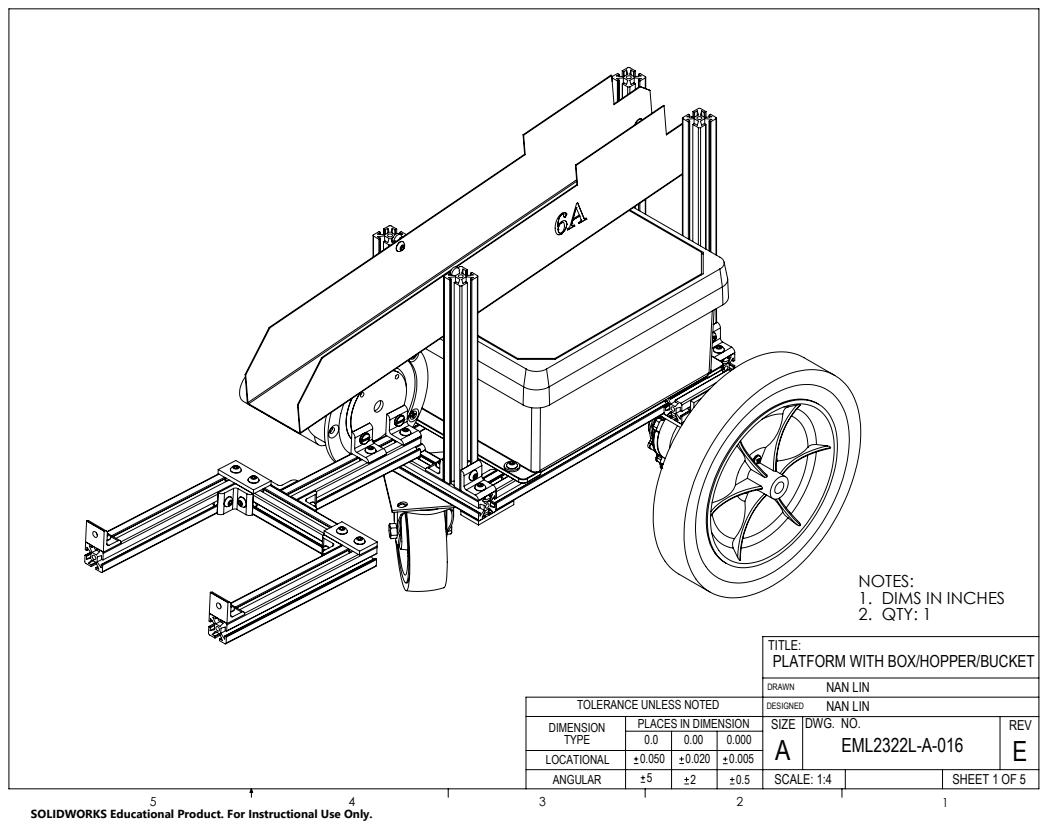
[picture p98: page 41]
REV E; EML2322L-A-016; DRAWN; DESIGNED; SCALE: 1:4; DIMS IN INCHES; NOTES: 1. 2. QTY: 1

TITLE:
PLATFORM WITH BOX/HOPPER/BUCKET
NAN LIN
DWG. NO.
SIZE

TOLERANCE UNLESS NOTED
DIMENSION
TYPE
LOCATIONAL

PLACES IN DIMENSION

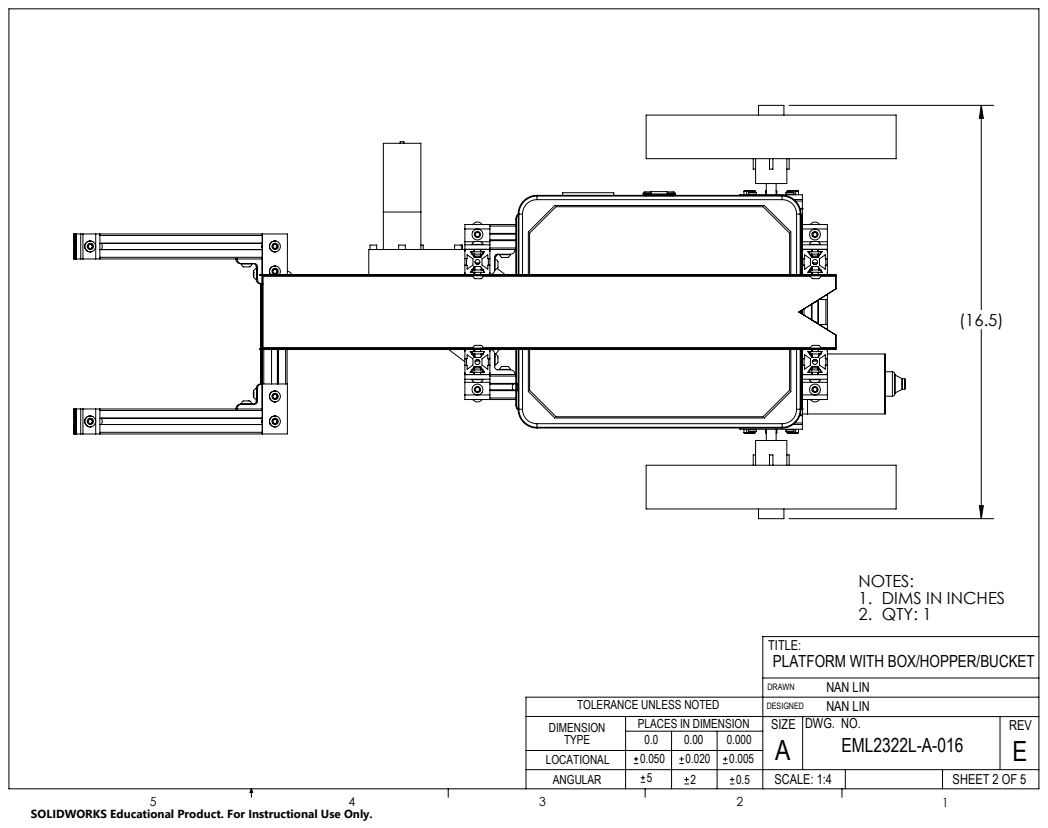
[picture p99: page 42]
REV E; EML2322L-A-016; DRAWN; DESIGNED; SCALE: 1:4; DIMS IN INCHES; NOTES: 1. 2. QTY: 1

TITLE:
PLATFORM WITH BOX/HOPPER/BUCKET
NAN LIN
DWG. NO.
SIZE

TOLERANCE UNLESS NOTED
DIMENSION
TYPE
LOCATIONAL

PLACES IN DIMENSION

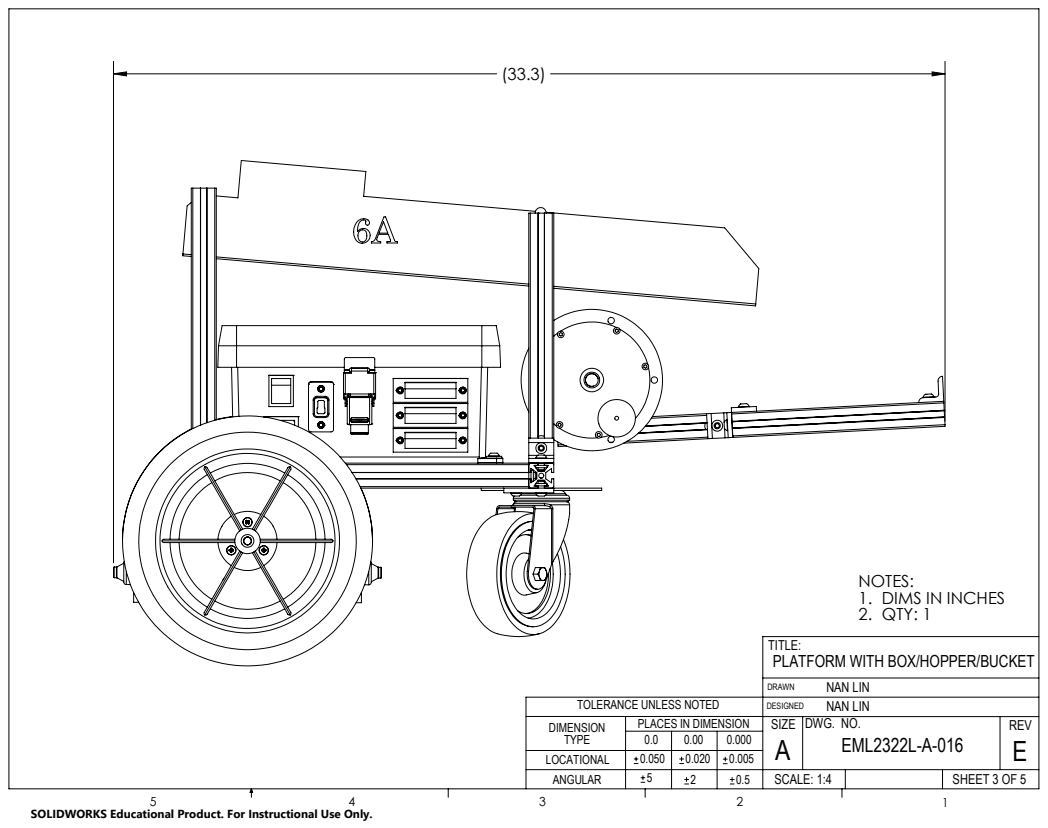
[picture p100: page 43]
REV E; EML2322L-A-016; DRAWN; DESIGNED; SCALE: 1:4; DIMS IN INCHES; NOTES: 1. 2. QTY: 1

TITLE:
PLATFORM WITH BOX/HOPPER/BUCKET
NAN LIN
DWG. NO.
SIZE

TOLERANCE UNLESS NOTED
DIMENSION
TYPE
LOCATIONAL

PLACES IN DIMENSION

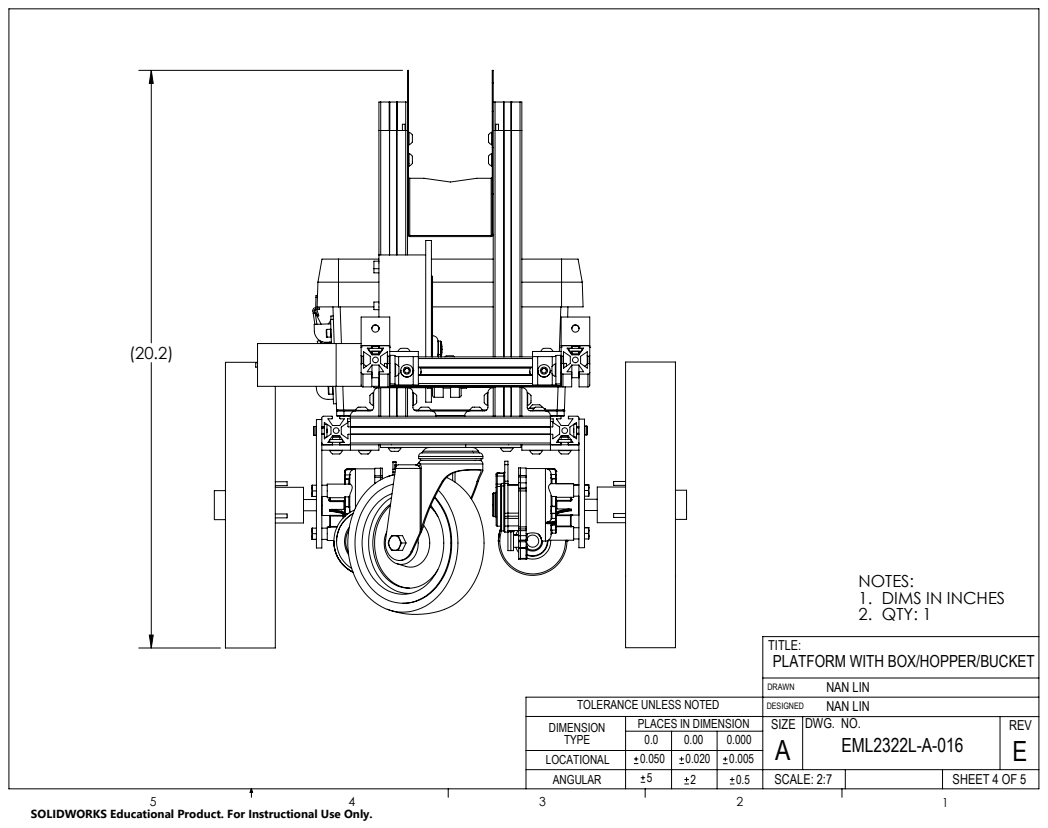
[picture p101: page 44]
REV E; EML2322L-A-016; DRAWN; DESIGNED; SCALE: 2:7; DIMS IN INCHES; NOTES: 1. 2. QTY: 1

TITLE:
PLATFORM WITH BOX/HOPPER/BUCKET
NAN LIN
DWG. NO.
SIZE

TOLERANCE UNLESS NOTED
DIMENSION
TYPE
LOCATIONAL

PLACES IN DIMENSION

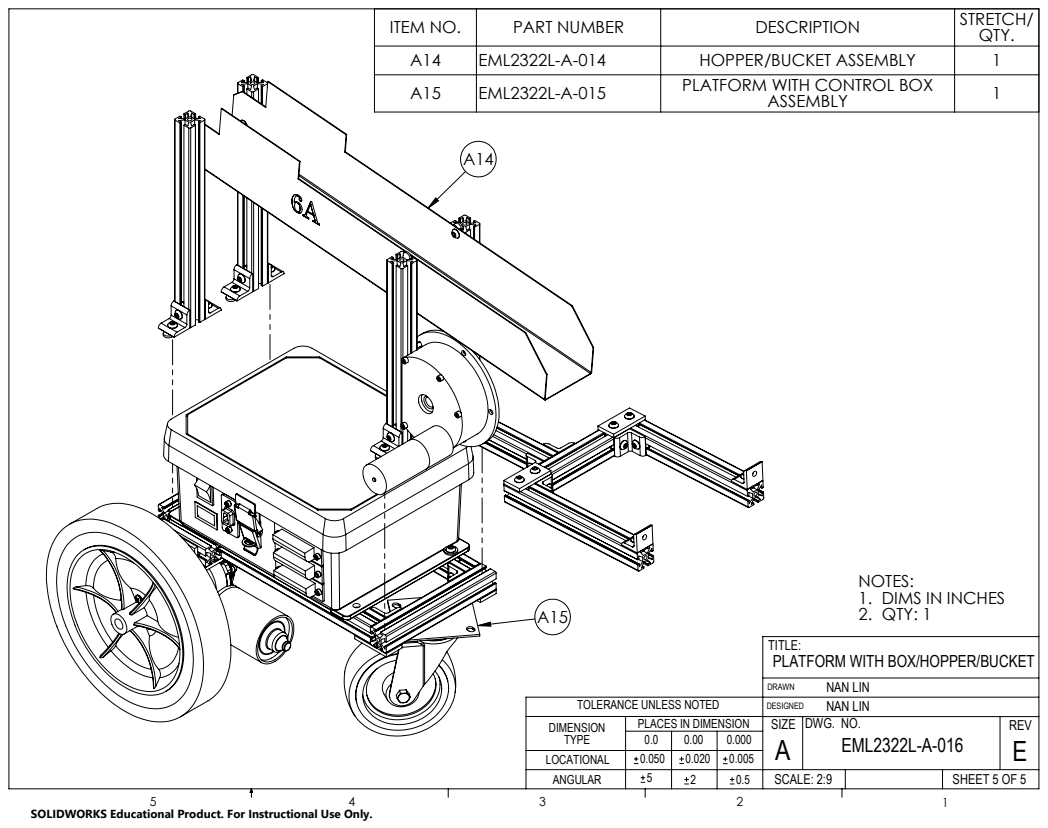
[picture p102: page 45]
REV E; EML2322L-A-016; DRAWN; DESIGNED; SCALE: 2:9; DIMS IN INCHES; NOTES: 1. 2. QTY: 1

ITEM NO. | PART NUMBER | DESCRIPTION | STRETCH/ QTY.
A14 | EML2322L-A-014 | HOPPER/BUCKET ASSEMBLY | 1
A15 | EML2322L-A-015 | PLATFORM WITH CONTROL BOX ASSEMBLY | 1

TITLE:
PLATFORM WITH BOX/HOPPER/BUCKET
NAN LIN
DWG. NO.
SIZE

TOLERANCE UNLESS NOTED
DIMENSION
TYPE
LOCATIONAL

PLACES IN DIMENSION

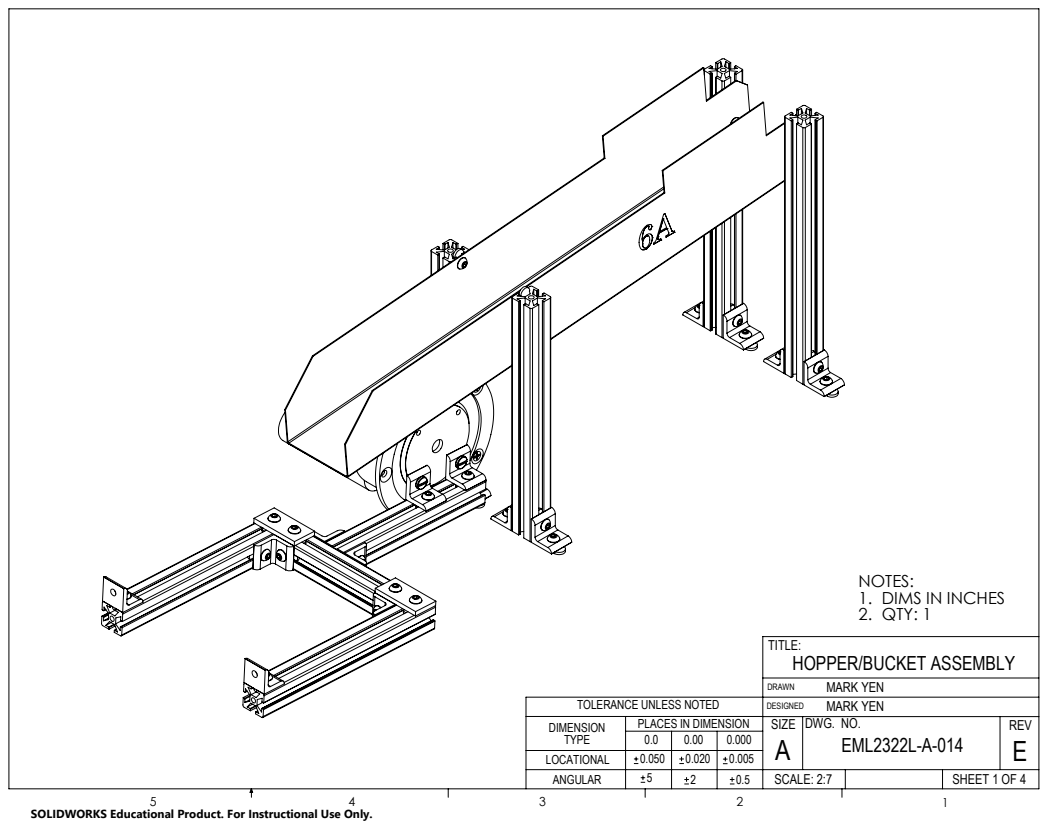
[picture p103: page 46]
TITLE:; REV E; EML2322L-A-014; DRAWN; DESIGNED; SCALE: 2:7

NOTES:
DIMS IN INCHES
2. QTY: 1
HOPPER/BUCKET ASSEMBLY
MARK YEN
DWG. NO.
SIZE

TOLERANCE UNLESS NOTED
DIMENSION
TYPE
LOCATIONAL

PLACES IN DIMENSION

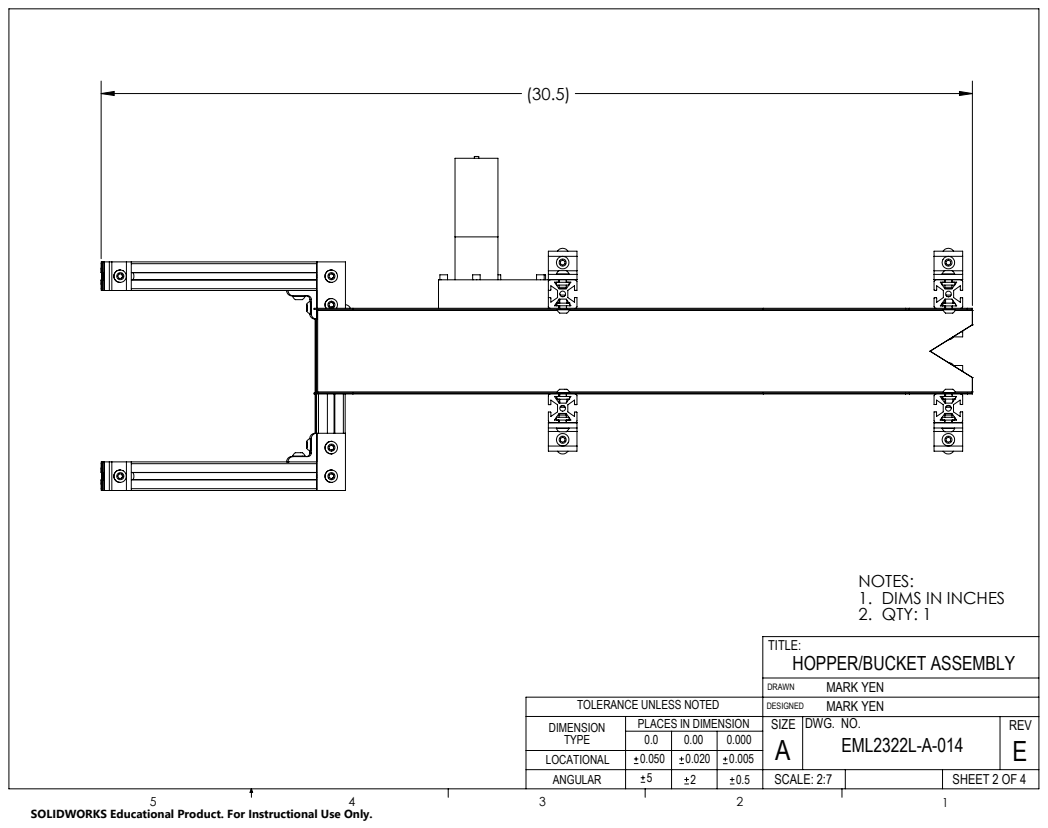
[picture p104: page 47]
TITLE:; REV E; EML2322L-A-014; DRAWN; DESIGNED; SCALE: 2:7

NOTES:
DIMS IN INCHES
2. QTY: 1
HOPPER/BUCKET ASSEMBLY
MARK YEN
DWG. NO.
SIZE

TOLERANCE UNLESS NOTED
DIMENSION
TYPE
LOCATIONAL

PLACES IN DIMENSION

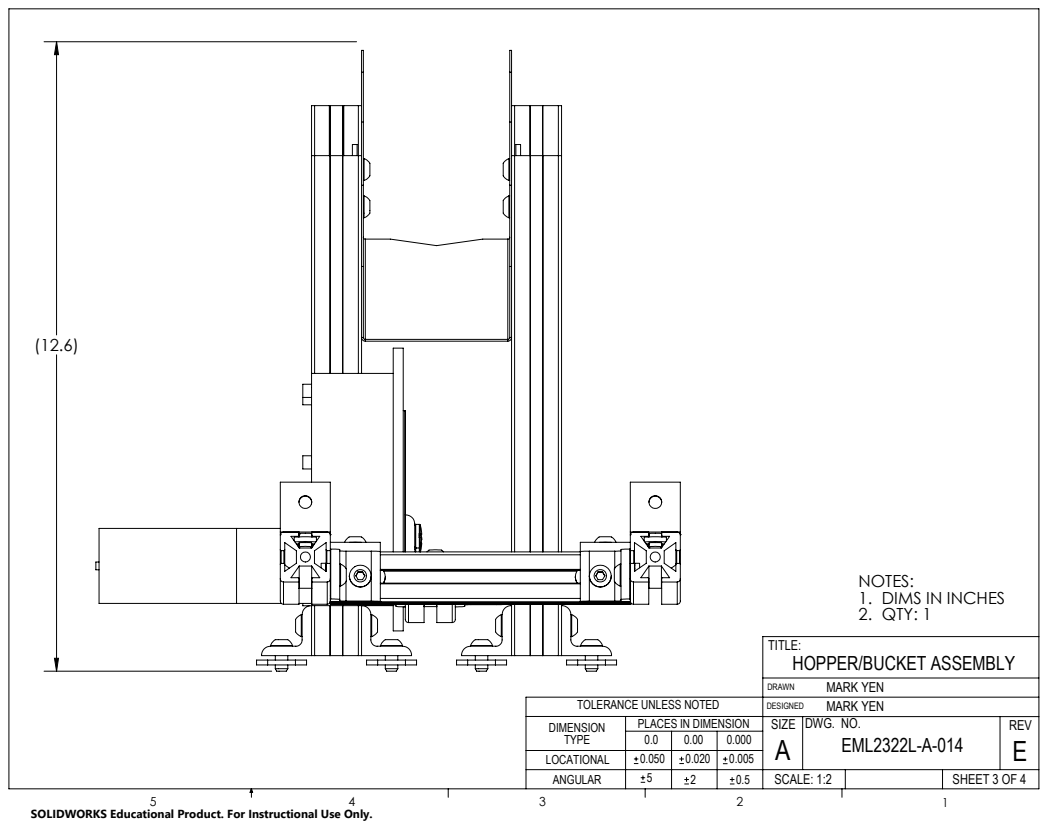
[picture p105: page 48]
TITLE:; REV E; EML2322L-A-014; DRAWN; DESIGNED; SCALE: 1:2

NOTES:
DIMS IN INCHES
2. QTY: 1
HOPPER/BUCKET ASSEMBLY
MARK YEN
DWG. NO.
SIZE

TOLERANCE UNLESS NOTED
DIMENSION
TYPE
LOCATIONAL

PLACES IN DIMENSION

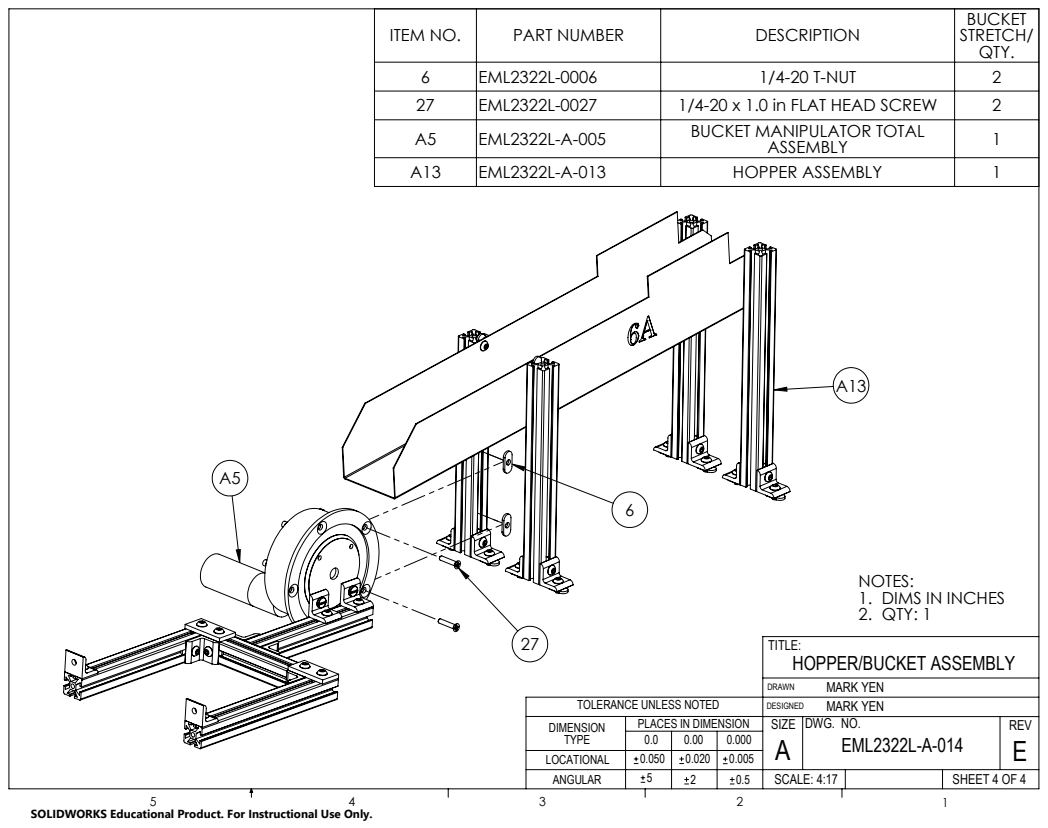
[picture p106: page 49]
TITLE:; REV E; EML2322L-A-014; DRAWN; DESIGNED; SCALE: 4:17

ITEM NO. | PART NUMBER | DESCRIPTION | BUCKET STRETCH/ QTY.

6 | EML2322L-0006 | 1/4-20 T-NUT | 2
27 | EML2322L-0027 | 1/4-20 x 1.0 in FLAT HEAD SCREW | 2
A5 | EML2322L-A-005 | BUCKET MANIPULATOR TOTAL ASSEMBLY | 1
A13 | EML2322L-A-013 | HOPPER ASSEMBLY | 1

NOTES:
DIMS IN INCHES
2. QTY: 1
HOPPER/BUCKET ASSEMBLY
MARK YEN
DWG. NO.
SIZE

TOLERANCE UNLESS NOTED
DIMENSION
TYPE
LOCATIONAL

PLACES IN DIMENSION

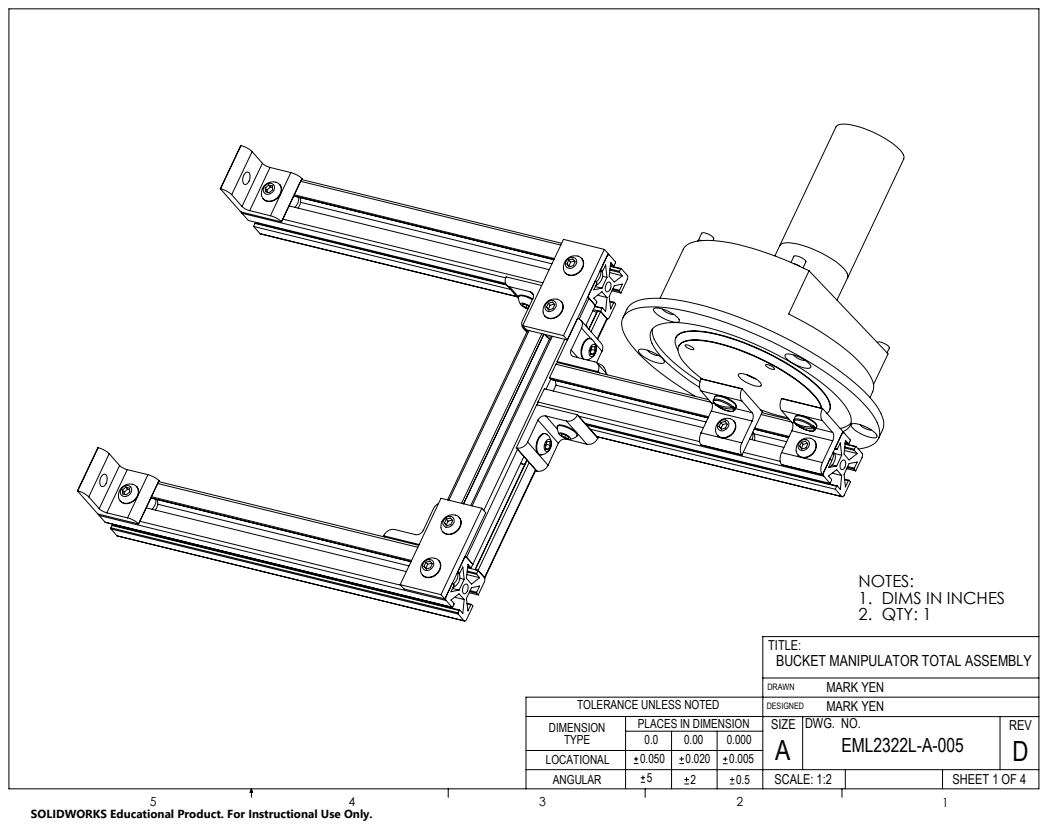
[picture p107: page 50]
REV D; EML2322L-A-005; DRAWN; DESIGNED; SCALE: 1:2; DIMS IN INCHES; NOTES: 1. 2. QTY: 1

TITLE:
BUCKET MANIPULATOR TOTAL ASSEMBLY
MARK YEN
DWG. NO.
SIZE

TOLERANCE UNLESS NOTED
DIMENSION
TYPE
LOCATIONAL

PLACES IN DIMENSION

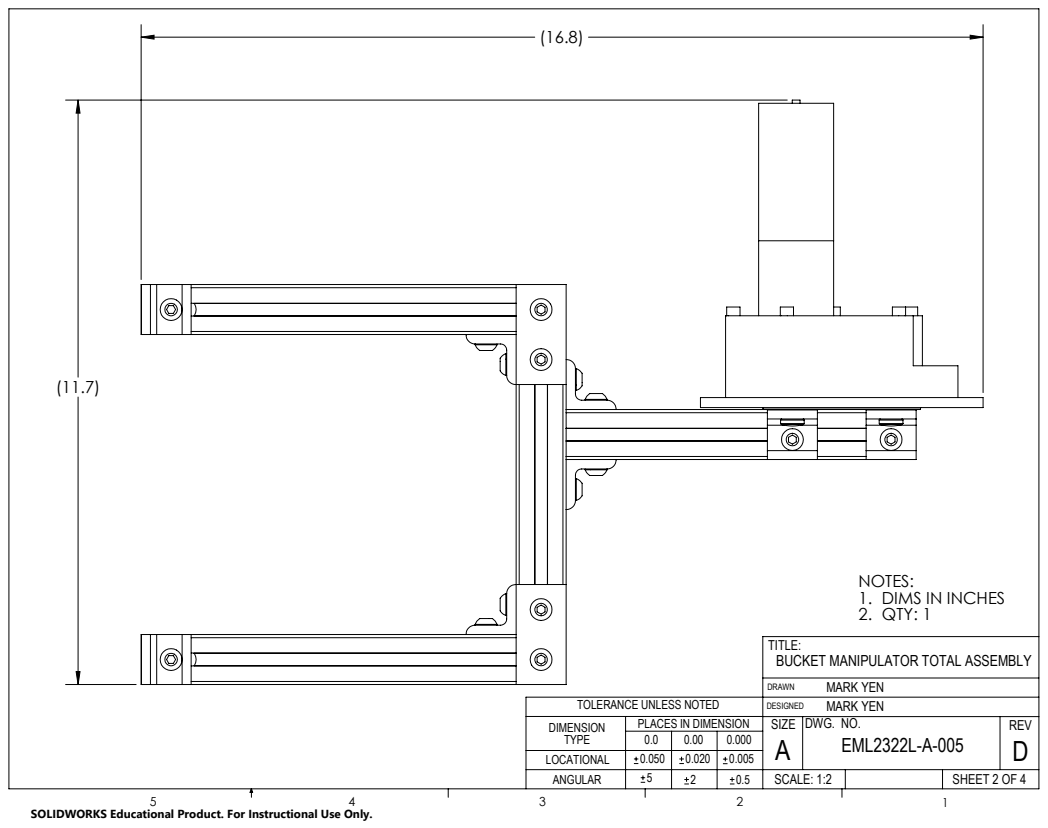
[picture p108: page 51]
REV D; EML2322L-A-005; DRAWN; DESIGNED; SCALE: 1:2; DIMS IN INCHES; NOTES: 1. 2. QTY: 1

TITLE:
BUCKET MANIPULATOR TOTAL ASSEMBLY
MARK YEN
DWG. NO.
SIZE

TOLERANCE UNLESS NOTED
DIMENSION
TYPE
LOCATIONAL

PLACES IN DIMENSION

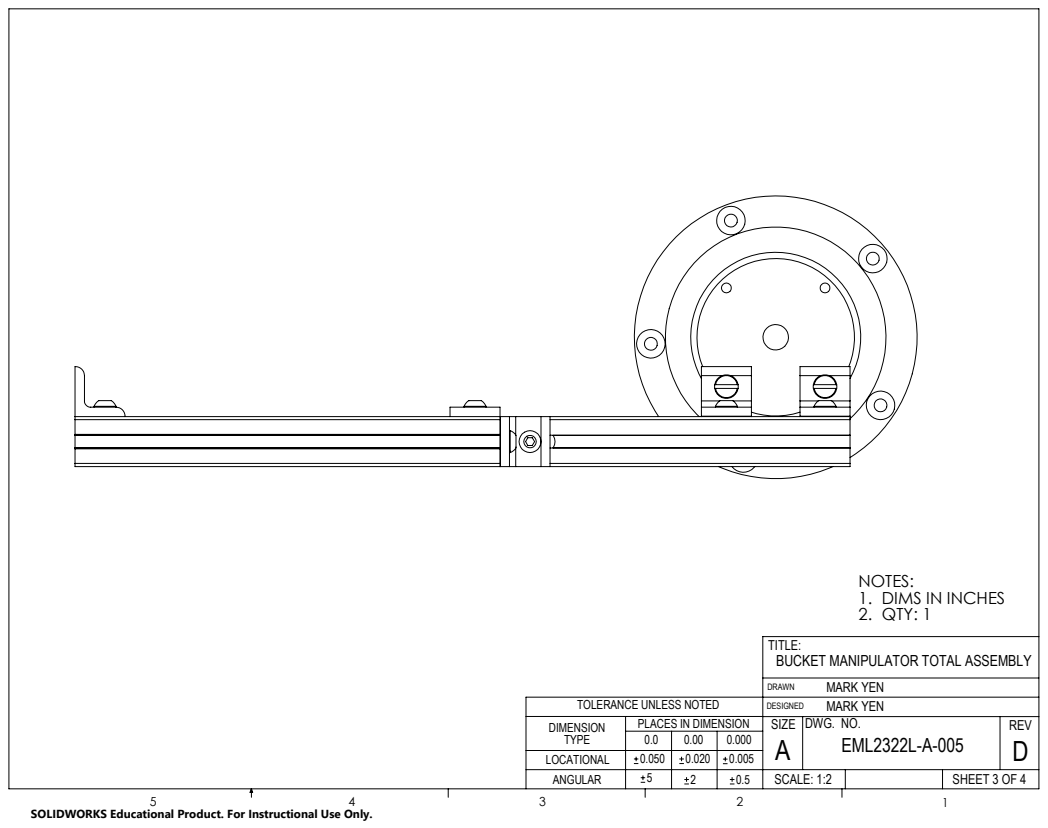
[picture p109: page 52]
REV D; EML2322L-A-005; DRAWN; DESIGNED; SCALE: 1:2; DIMS IN INCHES; NOTES: 1. 2. QTY: 1

TITLE:
BUCKET MANIPULATOR TOTAL ASSEMBLY
MARK YEN
DWG. NO.
SIZE

TOLERANCE UNLESS NOTED
DIMENSION
TYPE
LOCATIONAL

PLACES IN DIMENSION

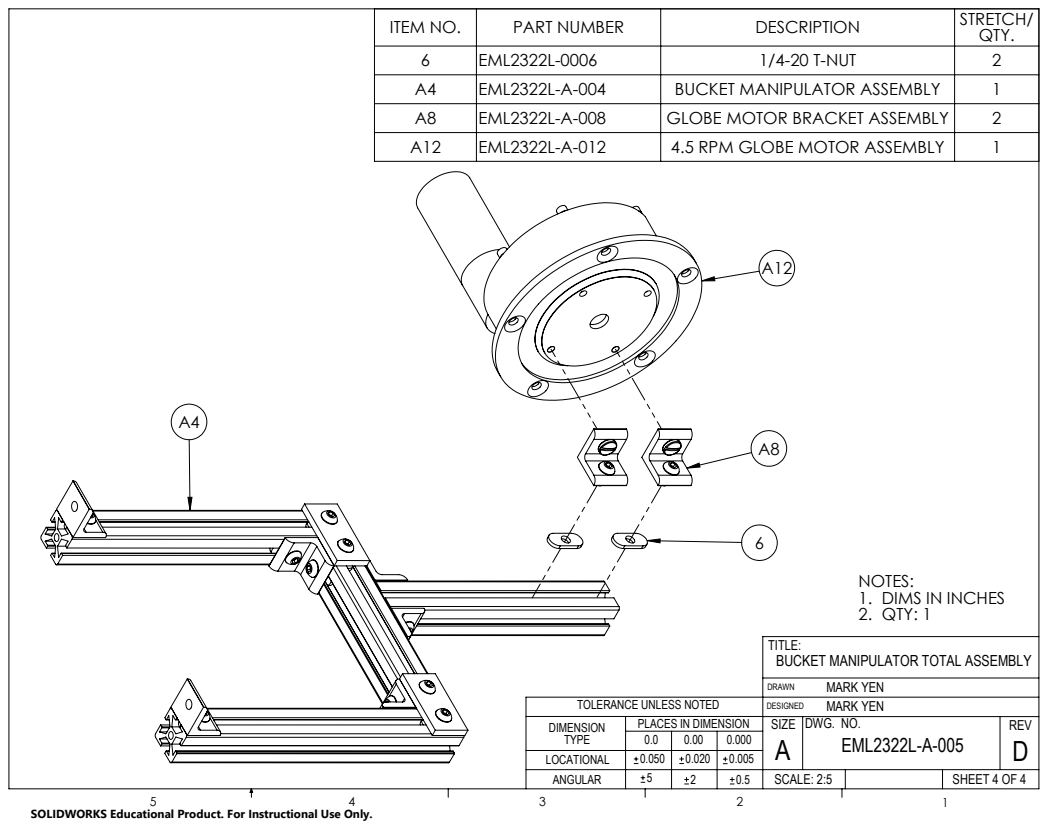
[picture p110: page 53]
REV D; EML2322L-A-005; DRAWN; DESIGNED; SCALE: 2:5; DIMS IN INCHES; NOTES: 1. 2. QTY: 1

ITEM NO. | PART NUMBER | DESCRIPTION | STRETCH/ QTY.
6 | EML2322L-0006 | 1/4-20 T-NUT | 2
A4 | EML2322L-A-004 | BUCKET MANIPULATOR ASSEMBLY | 1
A8 | EML2322L-A-008 | GLOBE MOTOR BRACKET ASSEMBLY | 2
A12 | EML2322L-A-012 | 4.5 RPM GLOBE MOTOR ASSEMBLY | 1

TITLE:
BUCKET MANIPULATOR TOTAL ASSEMBLY
MARK YEN
DWG. NO.
SIZE

TOLERANCE UNLESS NOTED
DIMENSION
TYPE
LOCATIONAL

PLACES IN DIMENSION

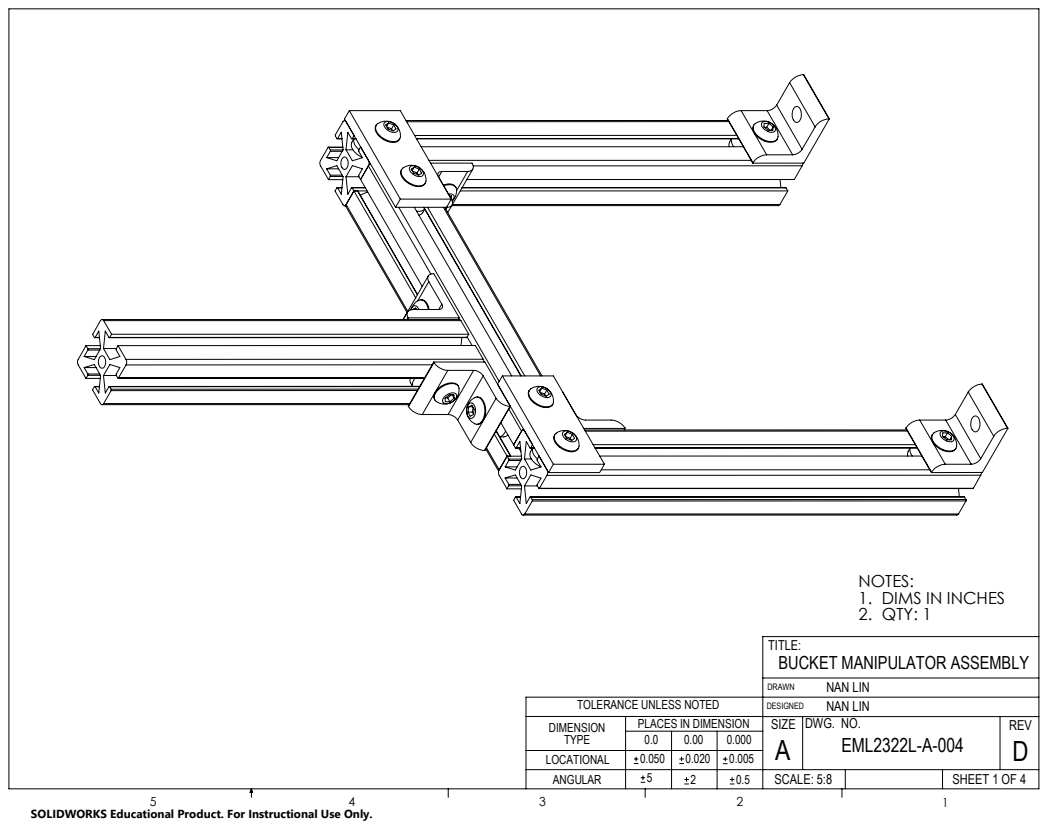
[picture p111: page 54]
REV D; EML2322L-A-004; DRAWN; DESIGNED; SCALE: 5:8; DIMS IN INCHES; NOTES: 1. 2. QTY: 1

TITLE:
BUCKET MANIPULATOR ASSEMBLY
NAN LIN
DWG. NO.
SIZE

TOLERANCE UNLESS NOTED
DIMENSION
TYPE
LOCATIONAL

PLACES IN DIMENSION

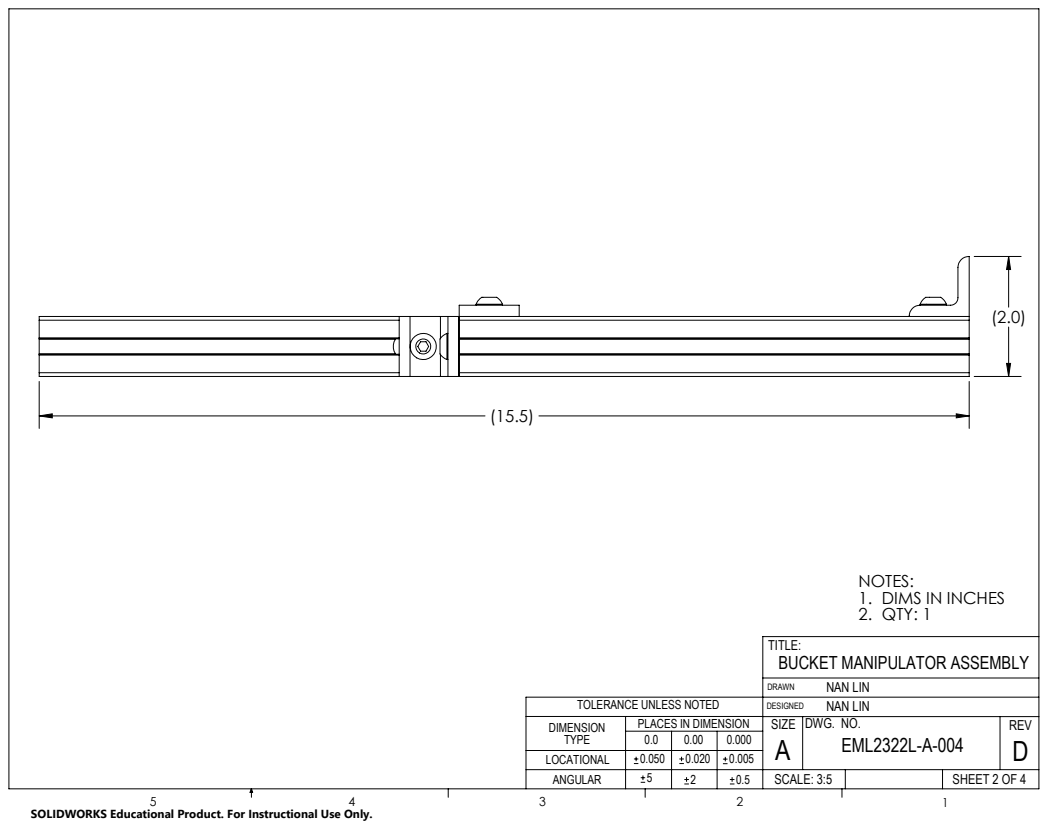
[picture p112: page 55]
REV D; EML2322L-A-004; DRAWN; DESIGNED; SCALE: 3:5; DIMS IN INCHES; NOTES: 1. 2. QTY: 1

TITLE:
BUCKET MANIPULATOR ASSEMBLY
NAN LIN
DWG. NO.
SIZE

TOLERANCE UNLESS NOTED
DIMENSION
TYPE
LOCATIONAL

PLACES IN DIMENSION

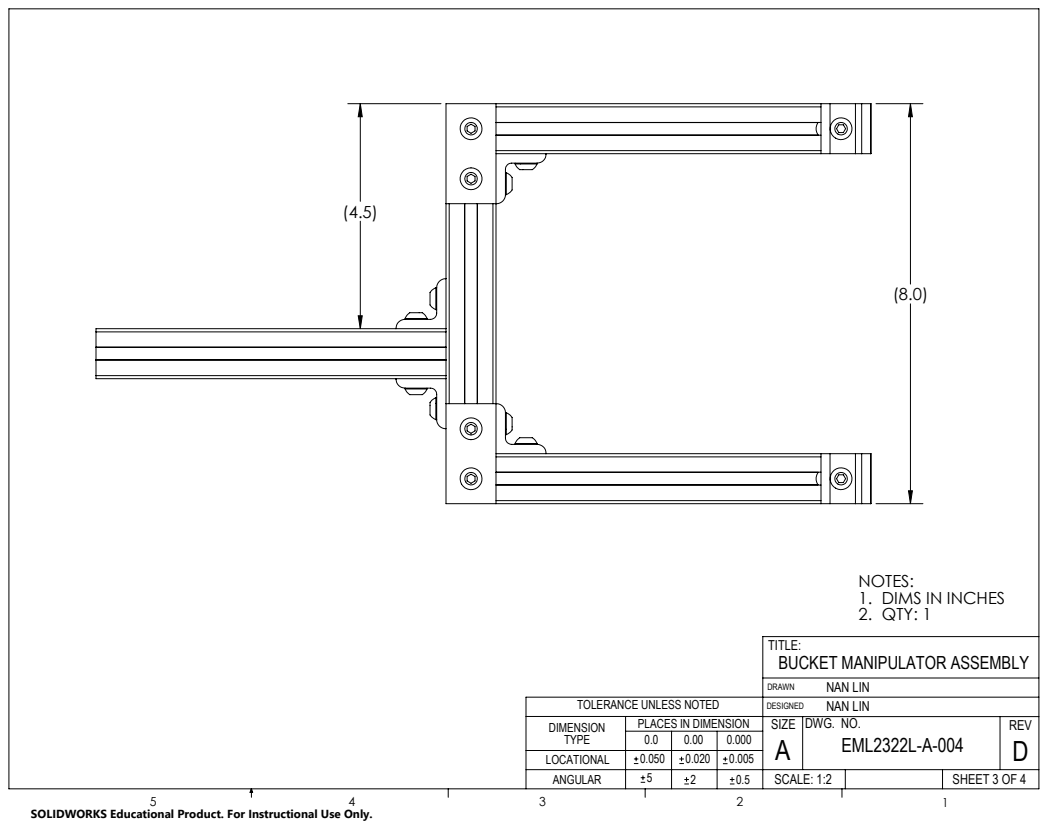
[picture p113: page 56]
REV D; EML2322L-A-004; DRAWN; DESIGNED; SCALE: 1:2; DIMS IN INCHES; NOTES: 1. 2. QTY: 1

TITLE:
BUCKET MANIPULATOR ASSEMBLY
NAN LIN
DWG. NO.
SIZE

TOLERANCE UNLESS NOTED
DIMENSION
TYPE
LOCATIONAL

PLACES IN DIMENSION

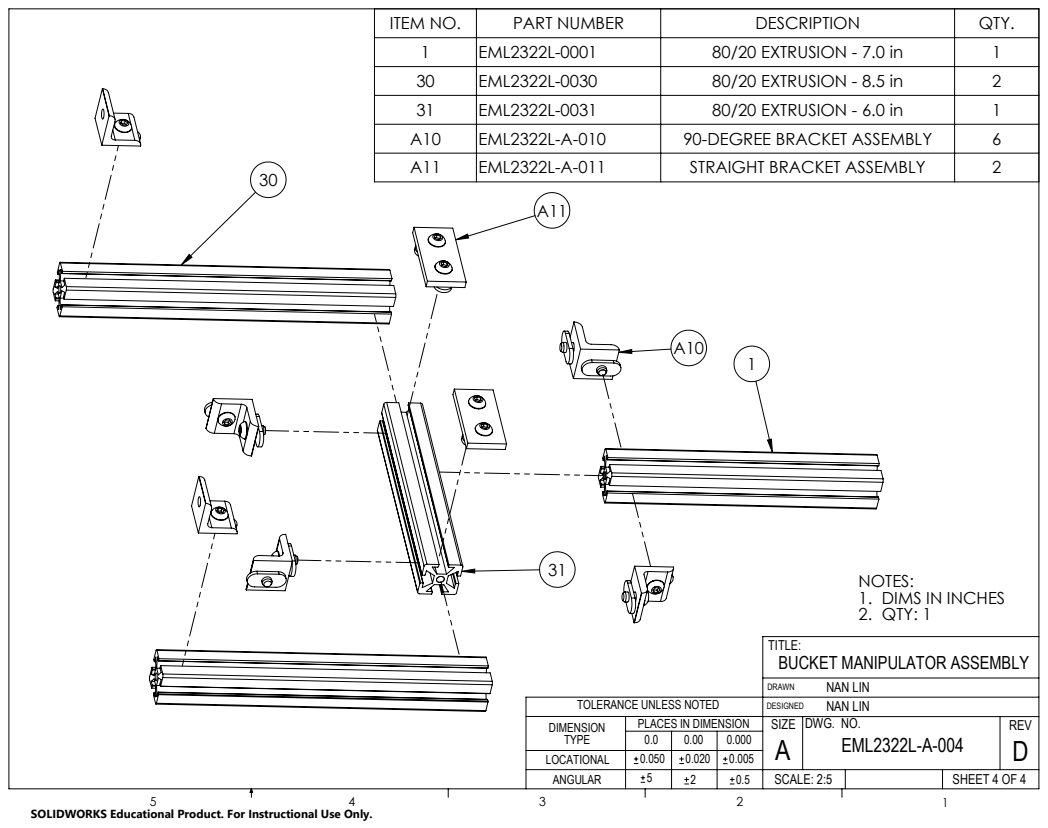
[picture p114: page 57]
REV D; EML2322L-A-004; DRAWN; DESIGNED; SCALE: 2:5; DIMS IN INCHES; NOTES: 1. 2. QTY: 1

ITEM NO. | PART NUMBER | DESCRIPTION | QTY.
1 | EML2322L-0001 | 80/20 EXTRUSION - 7.0 in | 1
30 | EML2322L-0030 | 80/20 EXTRUSION - 8.5 in | 2
31 | EML2322L-0031 | 80/20 EXTRUSION - 6.0 in | 1
A10 | EML2322L-A-010 | 90-DEGREE BRACKET ASSEMBLY | 6
A11 | EML2322L-A-011 | STRAIGHT BRACKET ASSEMBLY | 2

TITLE:
BUCKET MANIPULATOR ASSEMBLY
NAN LIN
DWG. NO.
SIZE

TOLERANCE UNLESS NOTED
DIMENSION
TYPE
LOCATIONAL

PLACES IN DIMENSION

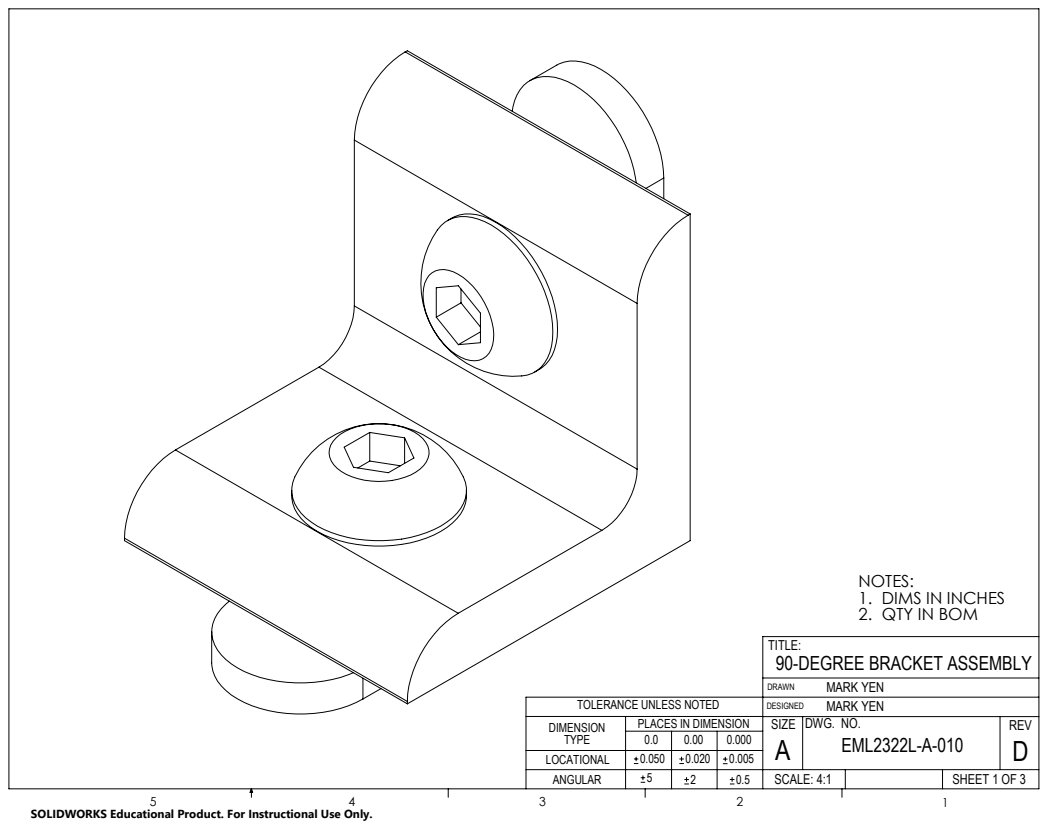
[picture p115: page 58]
REV D; EML2322L-A-010; DRAWN; DESIGNED; SCALE: 4:1

NOTES:
DIMS IN INCHES
2. QTY IN BOM

TITLE:
90-DEGREE BRACKET ASSEMBLY
MARK YEN
DWG. NO.
SIZE

TOLERANCE UNLESS NOTED
DIMENSION
TYPE
LOCATIONAL

PLACES IN DIMENSION

(1.4)

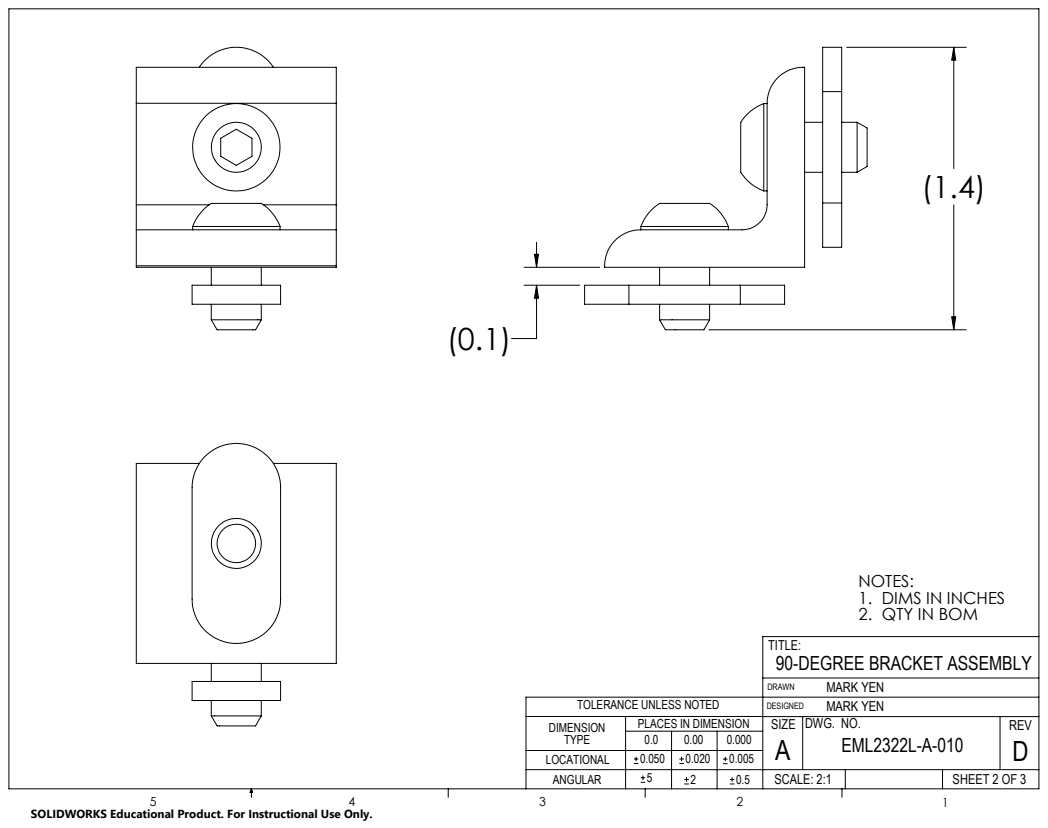
[picture p116: page 59]
REV D; EML2322L-A-010; DRAWN; DESIGNED; SCALE: 2:1

NOTES:
DIMS IN INCHES
2. QTY IN BOM

TITLE:
90-DEGREE BRACKET ASSEMBLY
MARK YEN
DWG. NO.
SIZE

TOLERANCE UNLESS NOTED
DIMENSION
TYPE
LOCATIONAL

PLACES IN DIMENSION

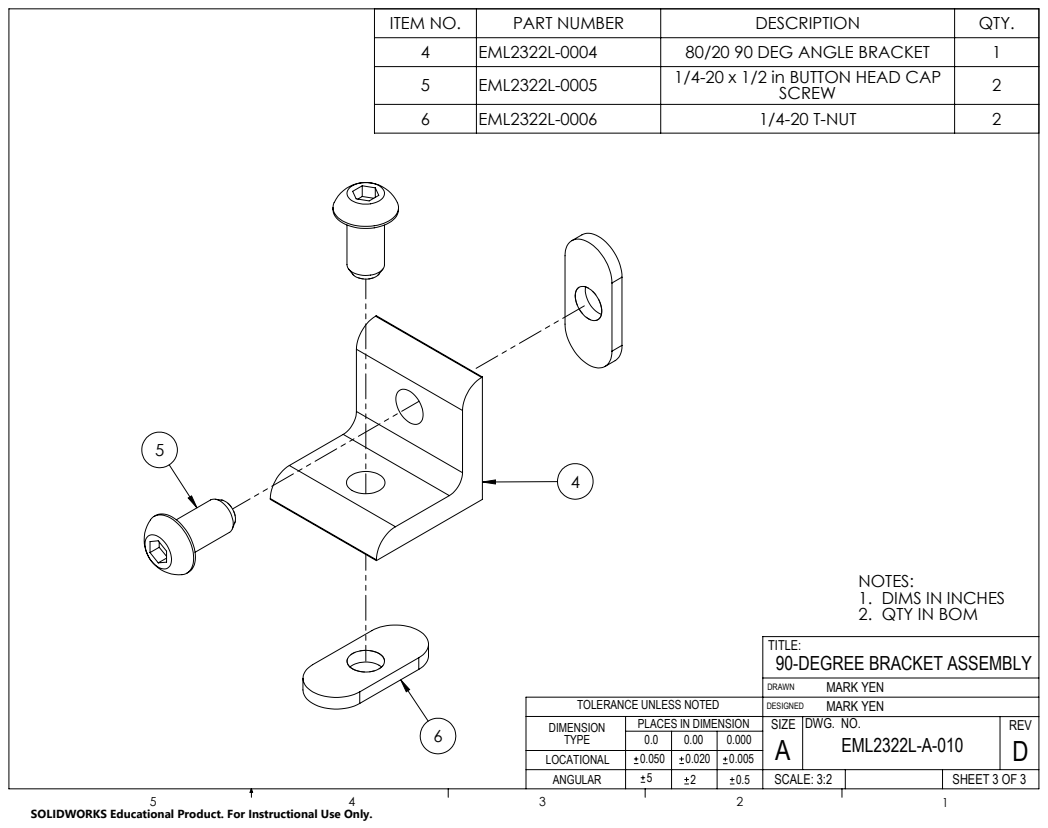
[picture p117: page 60]
REV D; EML2322L-A-010; DRAWN; DESIGNED; SCALE: 3:2

ITEM NO. | PART NUMBER | DESCRIPTION | QTY.
4 | EML2322L-0004 | 80/20 90 DEG ANGLE BRACKET | 1
5 | EML2322L-0005 | 1/4-20 x 1/2 in BUTTON HEAD CAP SCREW | 2
6 | EML2322L-0006 | 1/4-20 T-NUT | 2

NOTES:
DIMS IN INCHES
2. QTY IN BOM

TITLE:
90-DEGREE BRACKET ASSEMBLY
MARK YEN
DWG. NO.
SIZE

TOLERANCE UNLESS NOTED
DIMENSION
TYPE
LOCATIONAL

PLACES IN DIMENSION

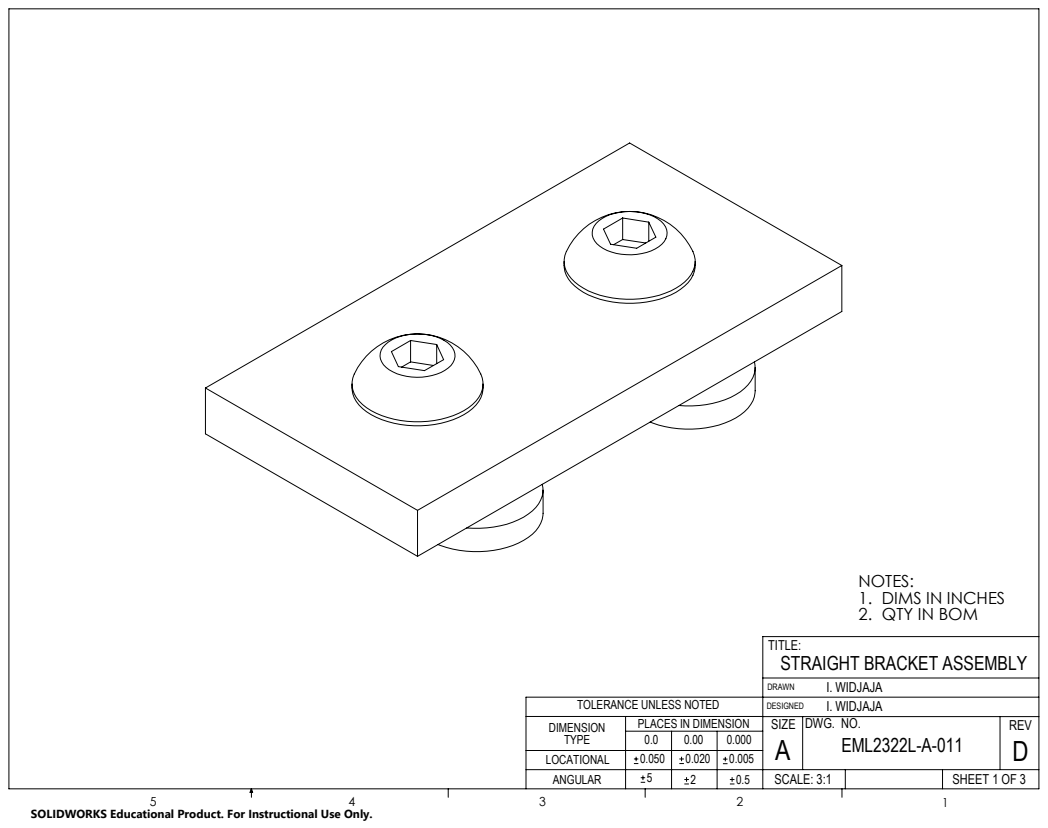
[picture p118: page 61]
TITLE:; REV D; EML2322L-A-011; DRAWN; DESIGNED; SCALE: 3:1

NOTES:
DIMS IN INCHES
2. QTY IN BOM
STRAIGHT BRACKET ASSEMBLY
I. WIDJAJA
DWG. NO.
SIZE

TOLERANCE UNLESS NOTED
DIMENSION
TYPE
LOCATIONAL

PLACES IN DIMENSION

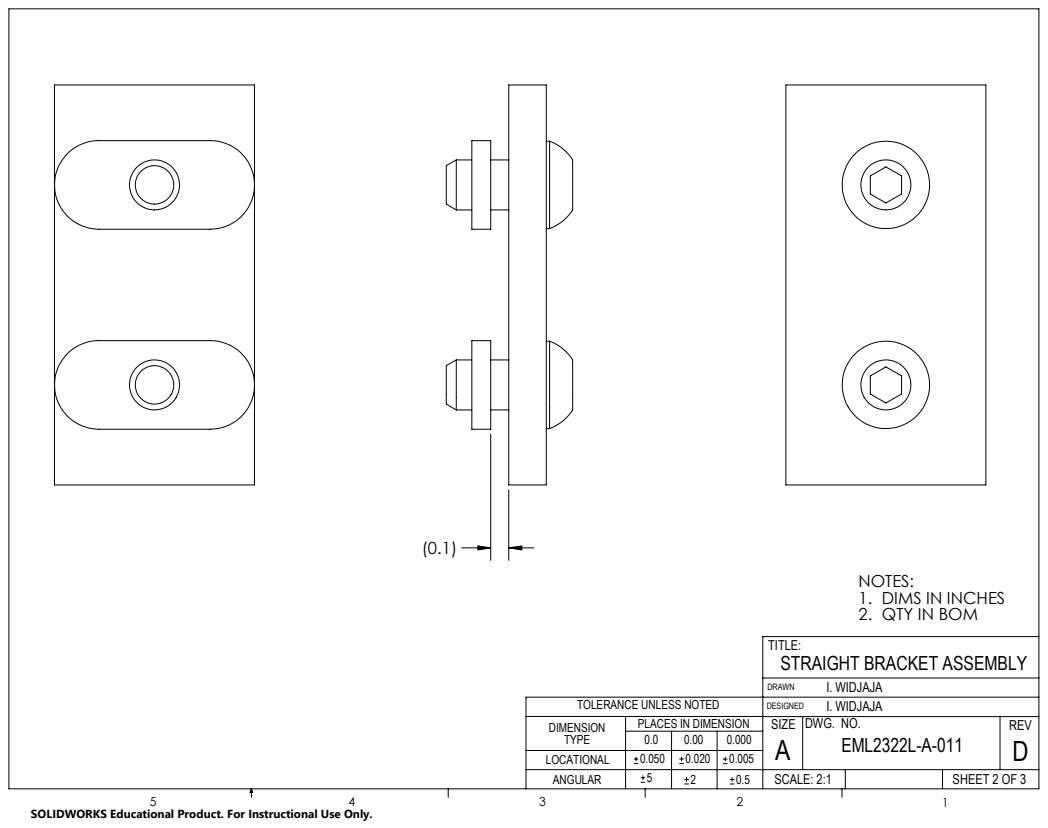
[picture p119: page 62]
TITLE:; REV D; EML2322L-A-011; DRAWN; DESIGNED; SCALE: 2:1

NOTES:
DIMS IN INCHES
2. QTY IN BOM
STRAIGHT BRACKET ASSEMBLY
I. WIDJAJA
DWG. NO.
SIZE

TOLERANCE UNLESS NOTED
DIMENSION
TYPE
LOCATIONAL

PLACES IN DIMENSION

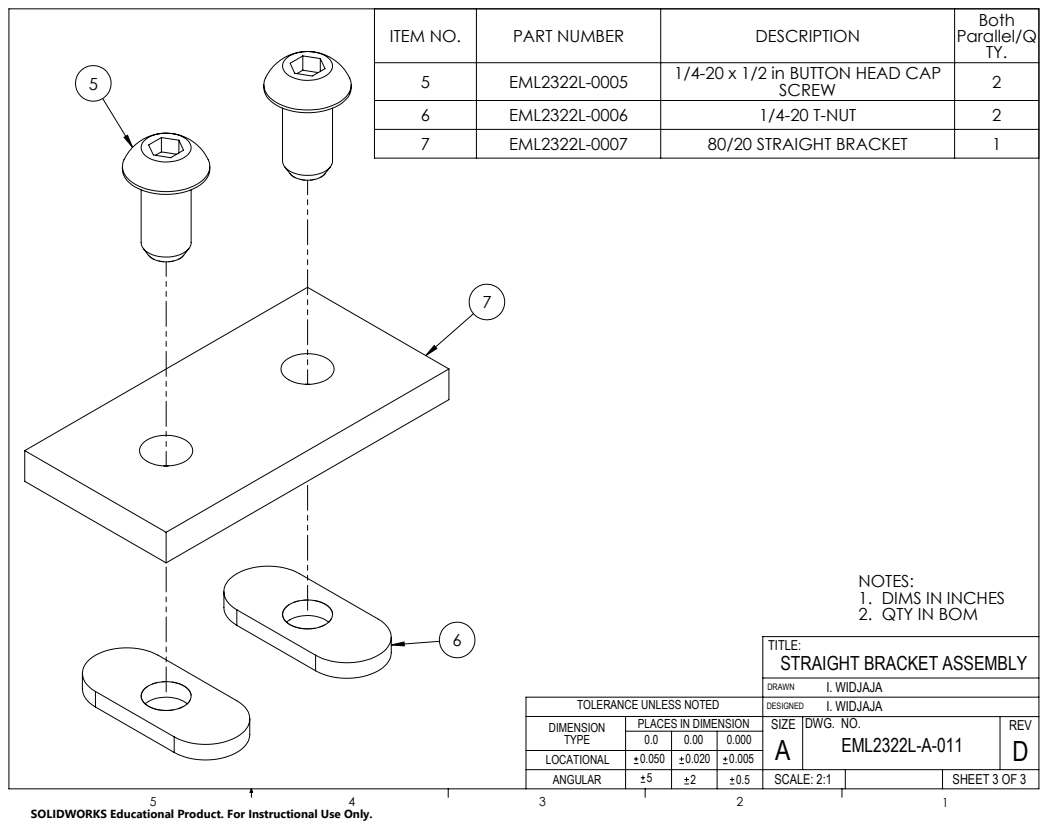
[picture p120: page 63]
TITLE:; REV D; EML2322L-A-011; DRAWN; DESIGNED; SCALE: 2:1

ITEM NO. | PART NUMBER | DESCRIPTION | Both Parallel/Q TY.

5 | EML2322L-0005 | 1/4-20 x 1/2 in BUTTON HEAD CAP SCREW | 2
6 | EML2322L-0006 | 1/4-20 T-NUT | 2
7 | EML2322L-0007 | 80/20 STRAIGHT BRACKET | 1

NOTES:
DIMS IN INCHES
2. QTY IN BOM
STRAIGHT BRACKET ASSEMBLY
I. WIDJAJA
DWG. NO.
SIZE

TOLERANCE UNLESS NOTED
DIMENSION
TYPE
LOCATIONAL

PLACES IN DIMENSION

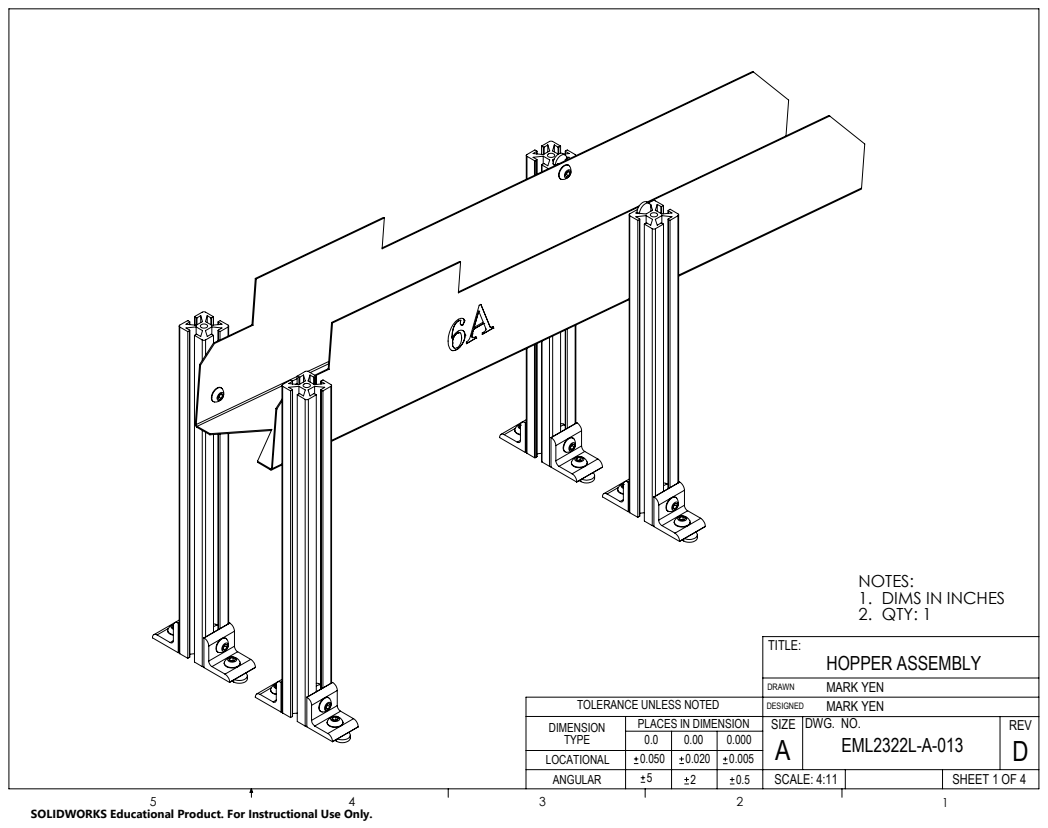
[picture p121: page 64]
TITLE:; REV D; EML2322L-A-013; DRAWN; DESIGNED; SCALE: 4:11

NOTES:
DIMS IN INCHES
2. QTY: 1
HOPPER ASSEMBLY
MARK YEN
DWG. NO.
SIZE

TOLERANCE UNLESS NOTED
DIMENSION
TYPE
LOCATIONAL

PLACES IN DIMENSION

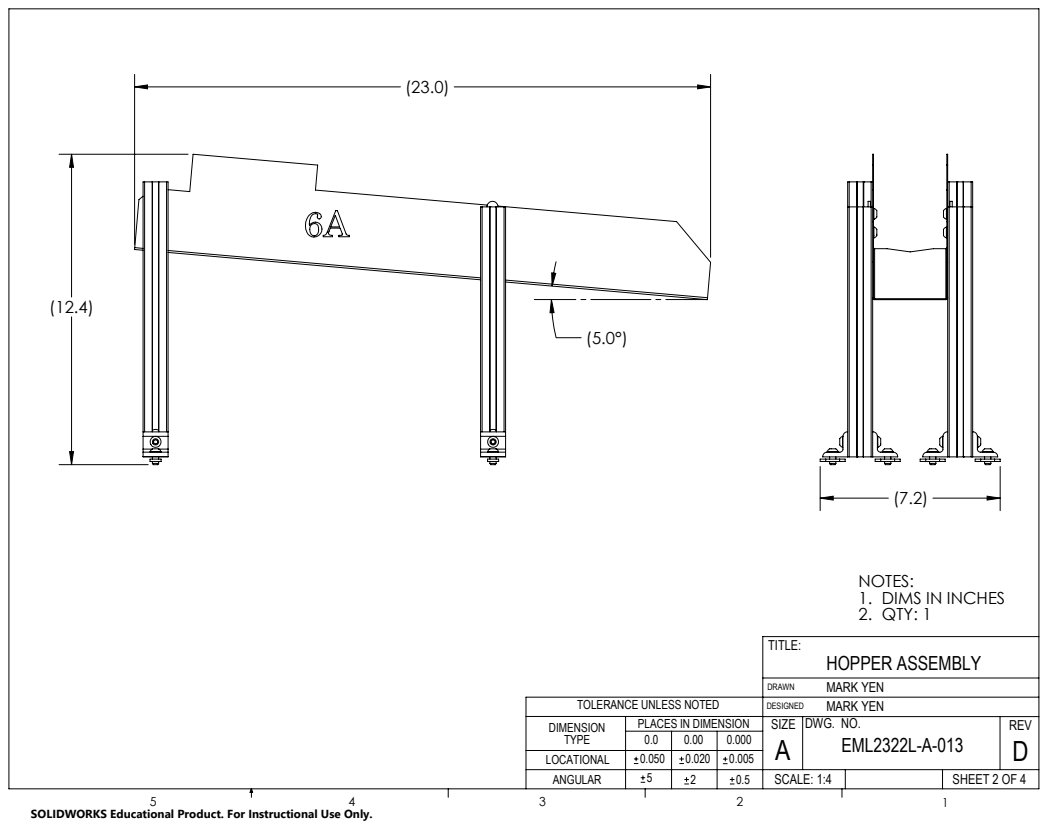
[picture p122: page 65]
TITLE:; REV D; EML2322L-A-013; DRAWN; DESIGNED; SCALE: 1:4

NOTES:
DIMS IN INCHES
2. QTY: 1
HOPPER ASSEMBLY
MARK YEN
DWG. NO.
SIZE

TOLERANCE UNLESS NOTED
DIMENSION
TYPE
LOCATIONAL

PLACES IN DIMENSION

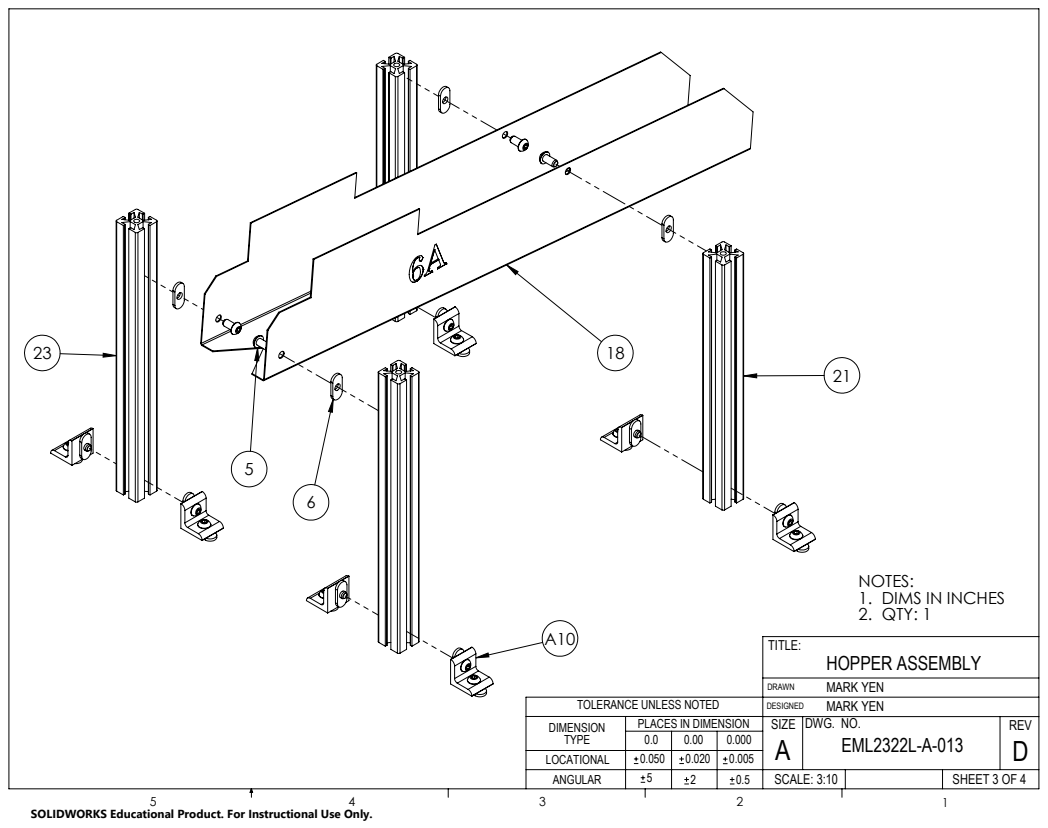
[picture p123: page 66]
TITLE:; REV D; EML2322L-A-013; DRAWN; DESIGNED; SCALE: 3:10

NOTES:
DIMS IN INCHES
2. QTY: 1
HOPPER ASSEMBLY
MARK YEN
DWG. NO.
SIZE

TOLERANCE UNLESS NOTED
DIMENSION
TYPE
LOCATIONAL

PLACES IN DIMENSION

ITEM NO. | PART NUMBER | DESCRIPTION | QTY.
5 | EML2322L-0005 | 1/4-20 x 1/2 in BUTTON HEAD CAP SCREW | 4
6 | EML2322L-0006 | 1/4-20 T-NUT | 4
18 | EML2322L-0018 | BALL HOPPER | 1
21 | EML2322L-0021 | 80/20 EXTRUSION - 10 in | 2
23 | EML2322L-0023 | 80/20 EXTRUSION - 11.0 in | 2
A10 | EML2322L-A-010 | 90-DEGREE BRACKET ASSEMBLY | 8

### HOPPER ASSEMBLY

DWG. NO.

TITLE:

REV
D

SIZE

### A EML2322L-A-013

DRAWN
DESIGNED

MARK YEN
MARK YEN
0.0 | 0.00 | 0.000
0.050 0.020 0.005
LOCATIONAL

TOLERANCE UNLESS NOTED
DIMENSION
TYPE
5 | 2 | SCALE: 1:8

PLACES IN DIMENSION

DIMS IN INCHES

NOTES:
1.
2. QTY: 1

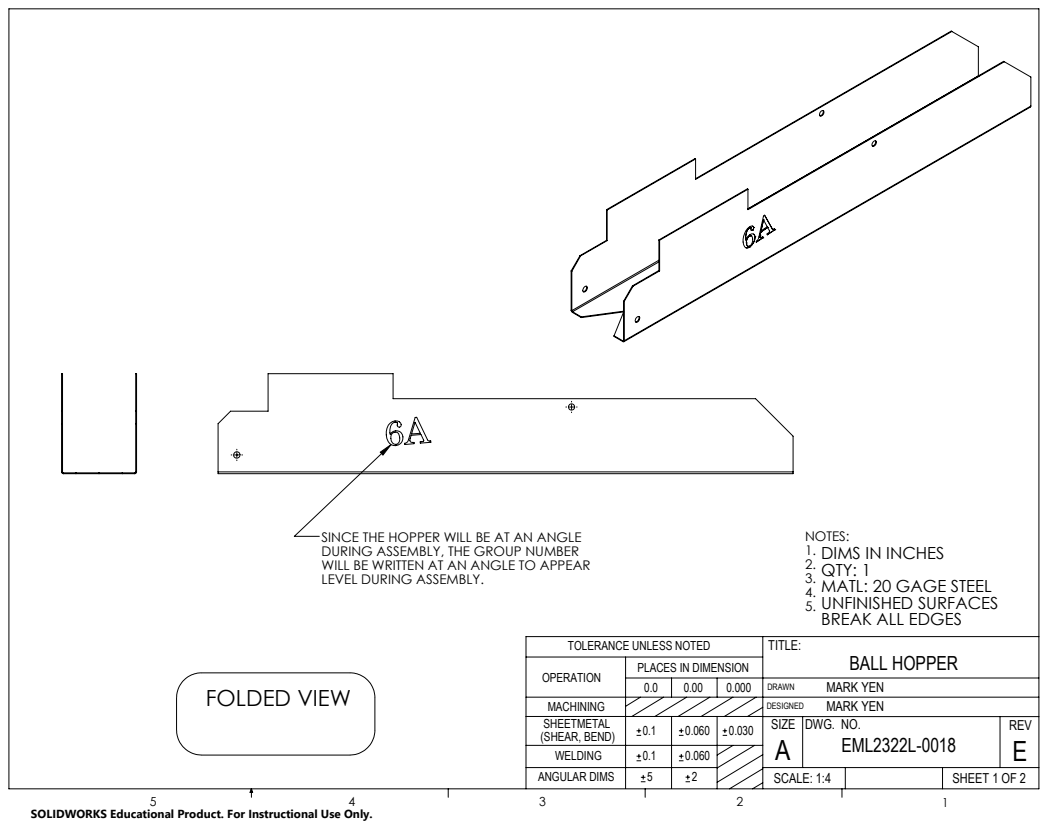
[picture p124: page 68]
BALL HOPPER; SHEET 1 OF 2; DWG. NO.; TITLE:; REV E; SIZE; EML2322L-0018; DRAWN; DESIGNED; MARK YEN MARK YEN; SCALE: 1:4; FOLDED VIEW; NOTES: 1. 2. 3. 4. 5.; DIMS IN INCHES MATL: 20 GAGE STEEL UNFINISHED SURFACES; QTY: 1; BREAK ALL EDGES

SINCE THE HOPPER WILL BE AT AN ANGLE
DURING ASSEMBLY, THE GROUP NUMBER
WILL BE WRITTEN AT AN ANGLE TO APPEAR
LEVEL DURING ASSEMBLY.

TOLERANCE UNLESS NOTED
OPERATION
MACHINING
SHEETMETAL
(SHEAR, BEND)
WELDING
ANGULAR DIMS

PLACES IN DIMENSION

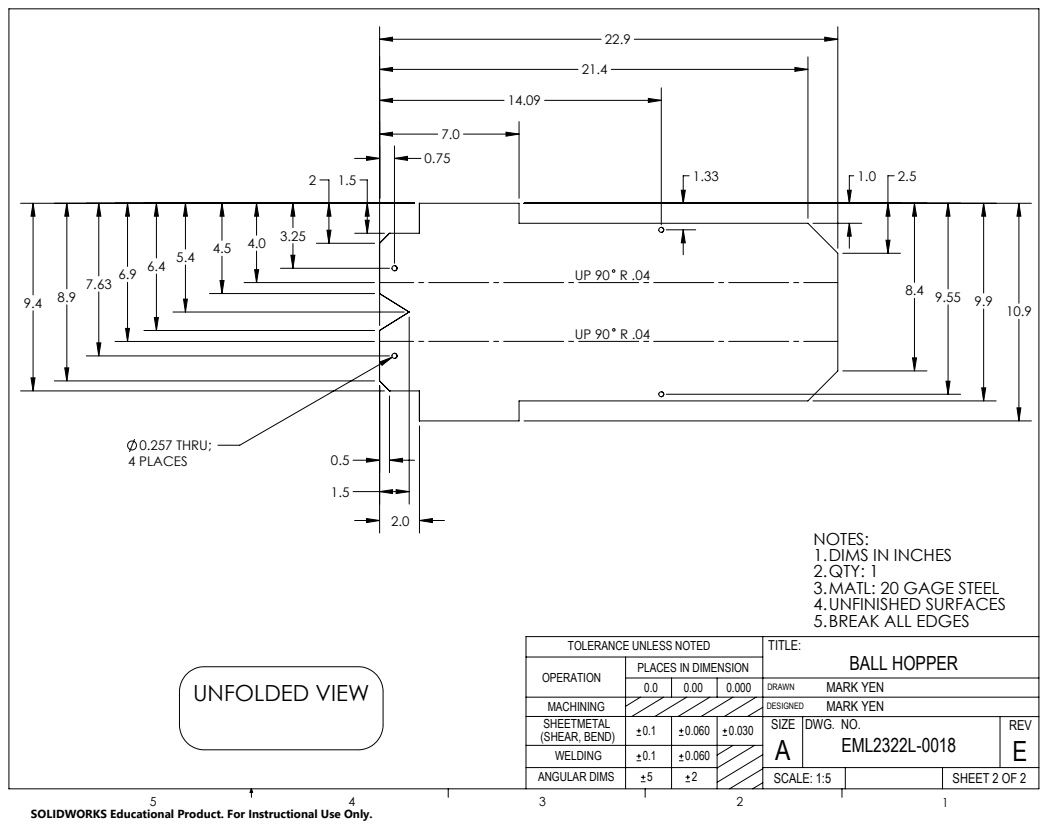
[picture p125: page 69]
0.257 THRU; 4 PLACES; BALL HOPPER; SHEET 2 OF 2; DWG. NO.; TITLE:; REV E; SIZE; EML2322L-0018; DRAWN; DESIGNED; MARK YEN MARK YEN; SCALE: 1:5; UNFOLDED VIEW; DIMS IN INCHES; NOTES: 1. 2. 3. 4. 5.; UNFINISHED SURFACES BREAK ALL EDGES; QTY: 1 MATL: 20 GAGE STEEL

TOLERANCE UNLESS NOTED
OPERATION
MACHINING
SHEETMETAL
(SHEAR, BEND)
WELDING
ANGULAR DIMS

PLACES IN DIMENSION

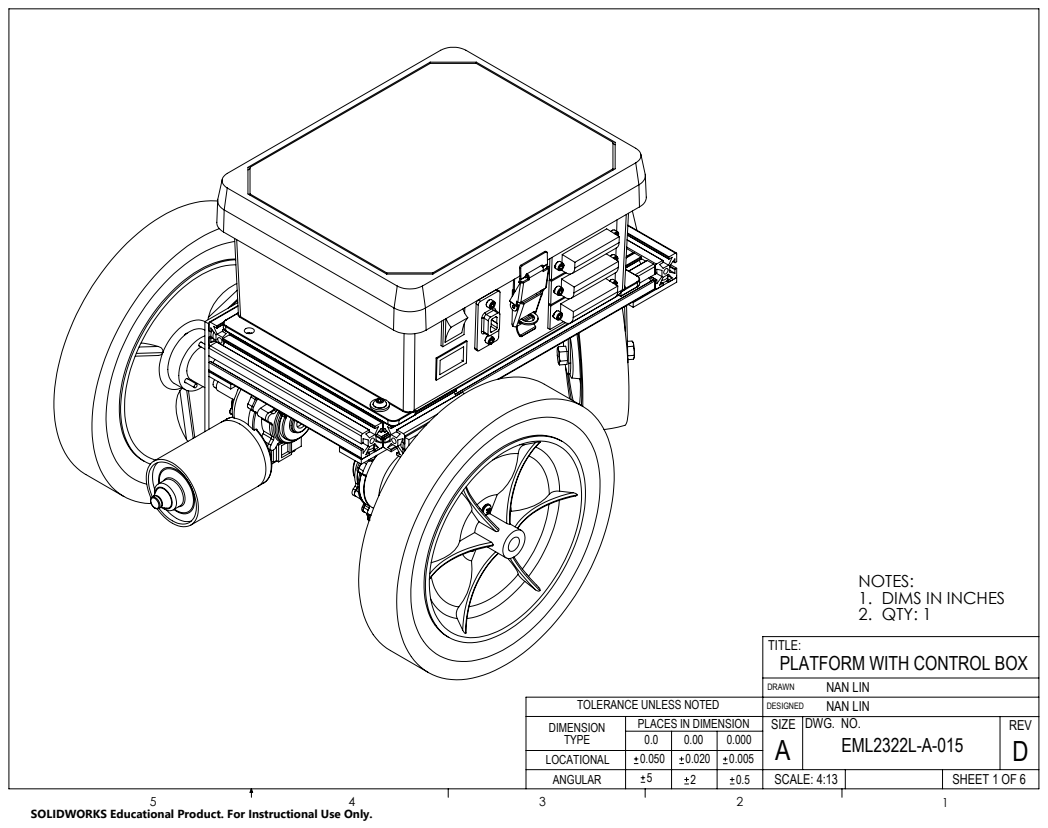
[picture p126: page 70]
TITLE:; REV D; EML2322L-A-015; DRAWN; DESIGNED; SCALE: 4:13

NOTES:
DIMS IN INCHES
2. QTY: 1
PLATFORM WITH CONTROL BOX
NAN LIN
DWG. NO.
SIZE

TOLERANCE UNLESS NOTED
DIMENSION
TYPE
LOCATIONAL

PLACES IN DIMENSION

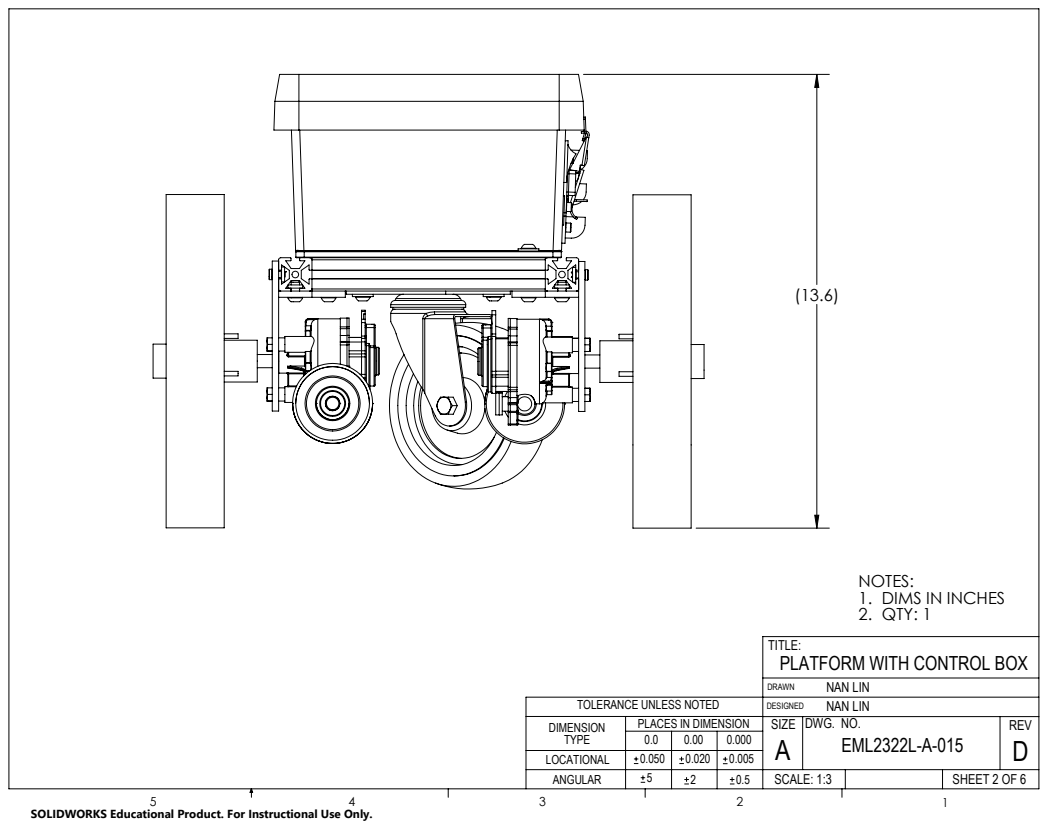
[picture p127: page 71]
TITLE:; REV D; EML2322L-A-015; DRAWN; DESIGNED; SCALE: 1:3

NOTES:
DIMS IN INCHES
2. QTY: 1
PLATFORM WITH CONTROL BOX
NAN LIN
DWG. NO.
SIZE

TOLERANCE UNLESS NOTED
DIMENSION
TYPE
LOCATIONAL

PLACES IN DIMENSION

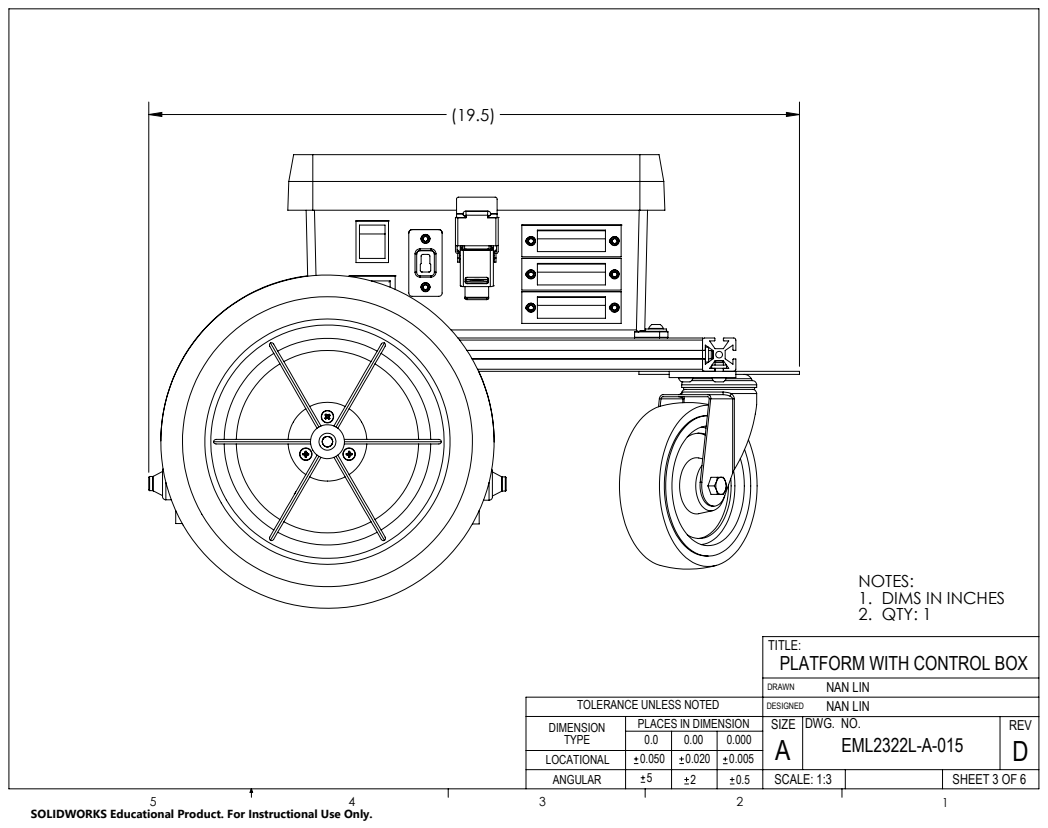
[picture p128: page 72]
TITLE:; REV D; EML2322L-A-015; DRAWN; DESIGNED; SCALE: 1:3

NOTES:
DIMS IN INCHES
2. QTY: 1
PLATFORM WITH CONTROL BOX
NAN LIN
DWG. NO.
SIZE

TOLERANCE UNLESS NOTED
DIMENSION
TYPE
LOCATIONAL

PLACES IN DIMENSION

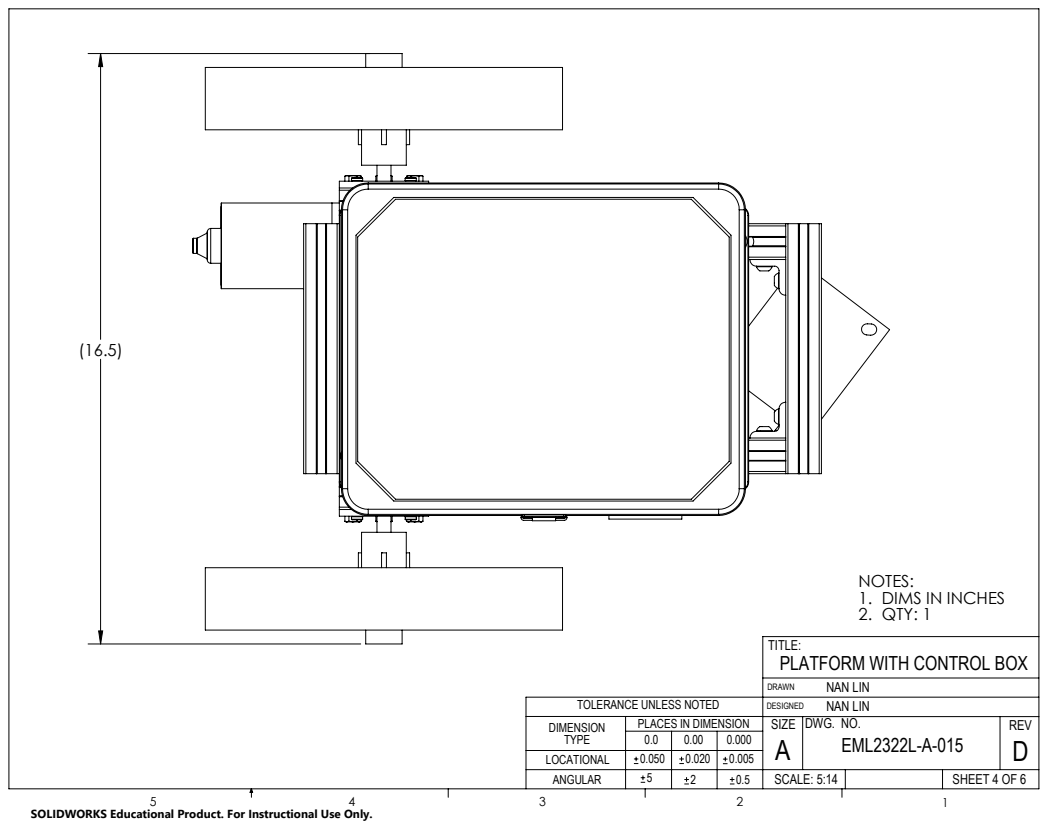
[picture p129: page 73]
TITLE:; REV D; EML2322L-A-015; DRAWN; DESIGNED; SCALE: 5:14

NOTES:
DIMS IN INCHES
2. QTY: 1
PLATFORM WITH CONTROL BOX
NAN LIN
DWG. NO.
SIZE

TOLERANCE UNLESS NOTED
DIMENSION
TYPE
LOCATIONAL

PLACES IN DIMENSION

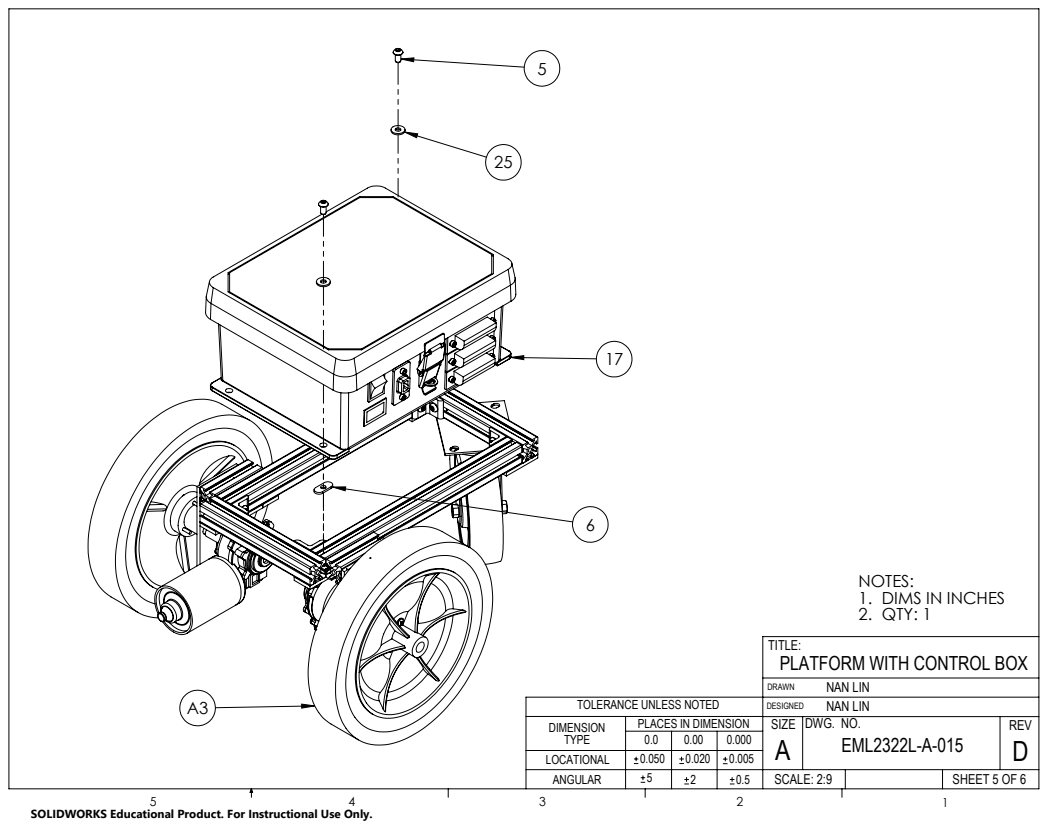
[picture p130: page 74]
TITLE:; REV D; EML2322L-A-015; DRAWN; DESIGNED; SCALE: 2:9

NOTES:
DIMS IN INCHES
2. QTY: 1
PLATFORM WITH CONTROL BOX
NAN LIN
DWG. NO.
SIZE

TOLERANCE UNLESS NOTED
DIMENSION
TYPE
LOCATIONAL

PLACES IN DIMENSION

ITEM NO. | PART NUMBER | DESCRIPTION | QTY.
5 | EML2322L-0005 | 1/4-20 x 1/2 in BUTTON HEAD CAP SCREW | 2
6 | EML2322L-0006 | 1/4-20 T-NUT | 2
17 | EML2322L-0017 | CONTROL BOX | 1
25 | EML2322L-0025 | 1/4 in WASHER | 2
A3 | EML2322L-A-003 | PLATFORM WITH WHEELS ASSEMBLY | 1

### PLATFORM WITH CONTROL BOX

DWG. NO.

TITLE:

REV
D

SIZE

### A EML2322L-A-015

DRAWN
DESIGNED

NAN LIN
NAN LIN
0.0 | 0.00 | 0.000
0.050 0.020 0.005
LOCATIONAL

TOLERANCE UNLESS NOTED
DIMENSION
TYPE
5 | 2 | SCALE: 1:8

PLACES IN DIMENSION

DIMS IN INCHES

NOTES:
1.
2. QTY: 1

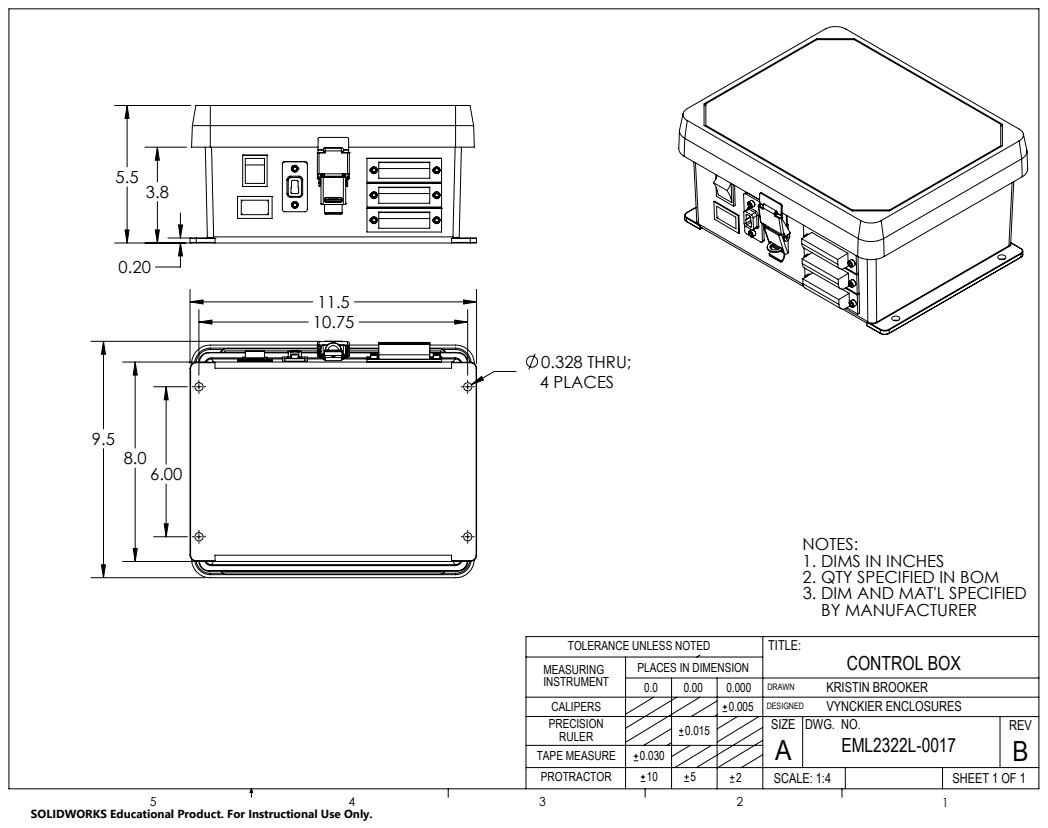
[picture p131: page 76]
0.328 THRU; 4 PLACES; SHEET 1 OF 1; TITLE:; REV B; SIZE; EML2322L-0017; DRAWN; DESIGNED; PROTRACTOR; TAPE MEASURE; PRECISION RULER; CALIPERS; TOLERANCE UNLESS NOTED MEASURING INSTRUMENT; SCALE: 1:4

NOTES:
DIMS IN INCHES
QTY SPECIFIED IN BOM
3. DIM AND MAT'L SPECIFIED
BY MANUFACTURER
CONTROL BOX
KRISTIN BROOKER
VYNCKIER ENCLOSURES
DWG. NO.

PLACES IN DIMENSION

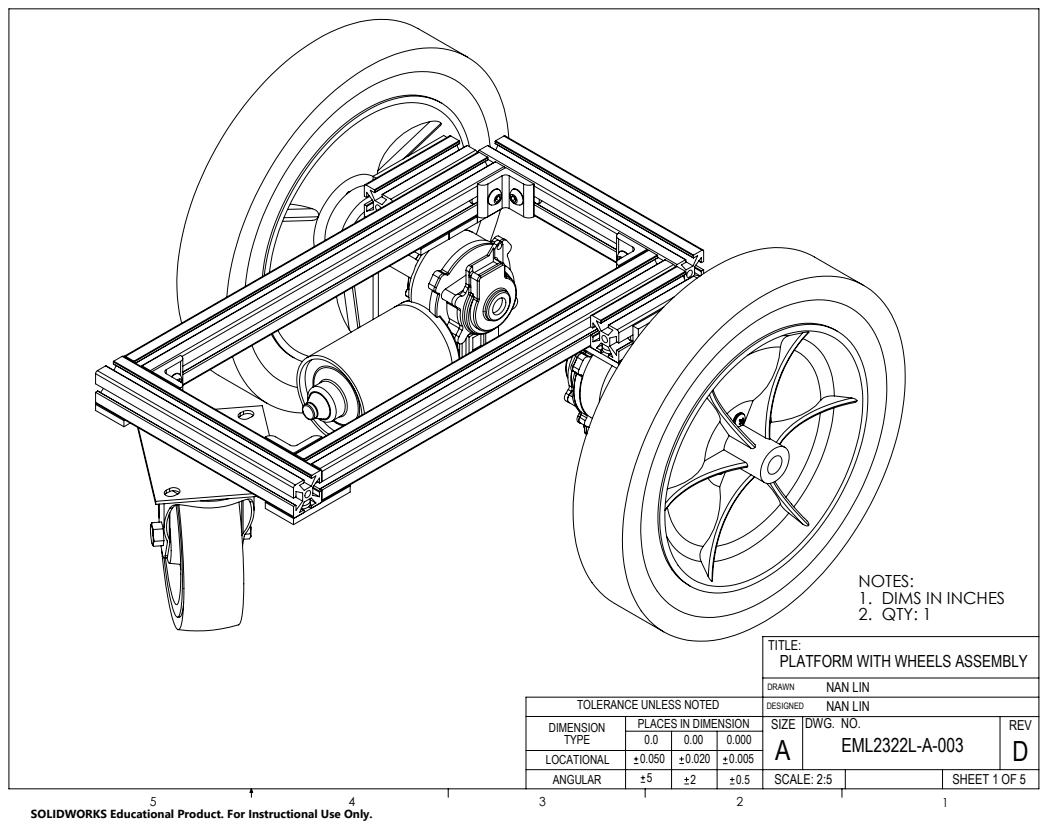
[picture p132: page 77]
REV D; EML2322L-A-003; DRAWN; DESIGNED; SCALE: 2:5; DIMS IN INCHES; NOTES: 1. 2. QTY: 1

TITLE:
PLATFORM WITH WHEELS ASSEMBLY
NAN LIN
DWG. NO.
SIZE

TOLERANCE UNLESS NOTED
DIMENSION
TYPE
LOCATIONAL

PLACES IN DIMENSION

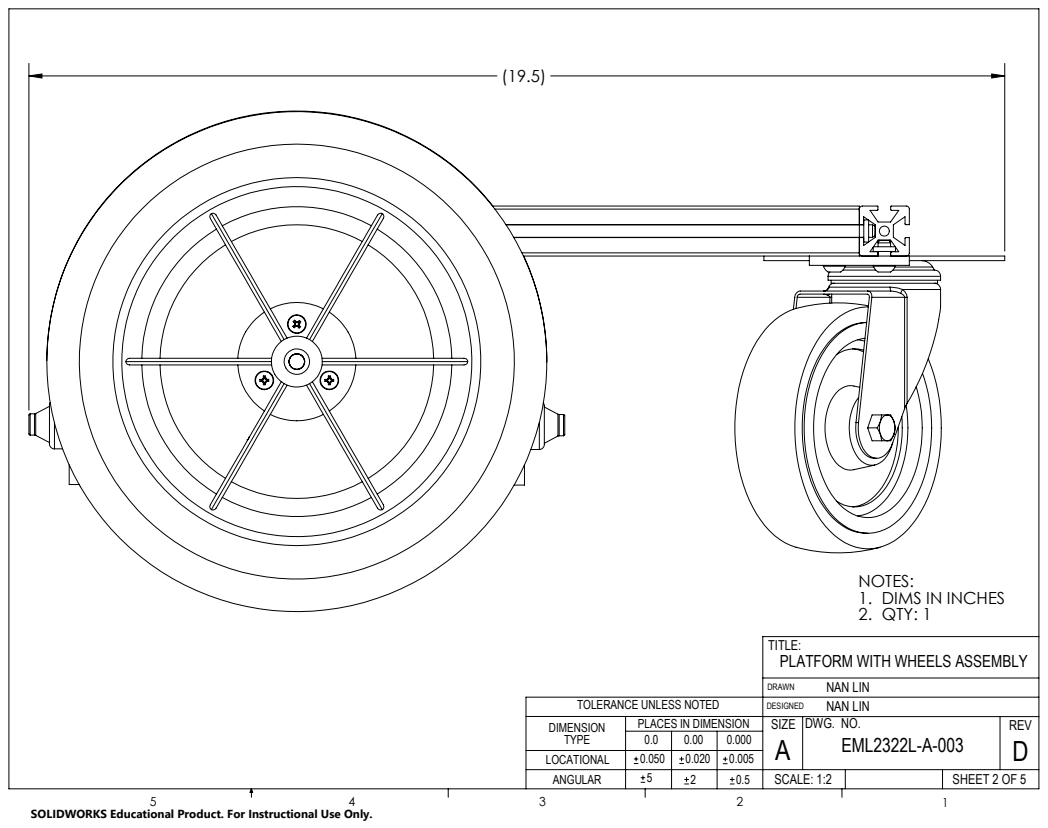
[picture p133: page 78]
REV D; EML2322L-A-003; DRAWN; DESIGNED; SCALE: 1:2; DIMS IN INCHES; NOTES: 1. 2. QTY: 1

TITLE:
PLATFORM WITH WHEELS ASSEMBLY
NAN LIN
DWG. NO.
SIZE

TOLERANCE UNLESS NOTED
DIMENSION
TYPE
LOCATIONAL

PLACES IN DIMENSION

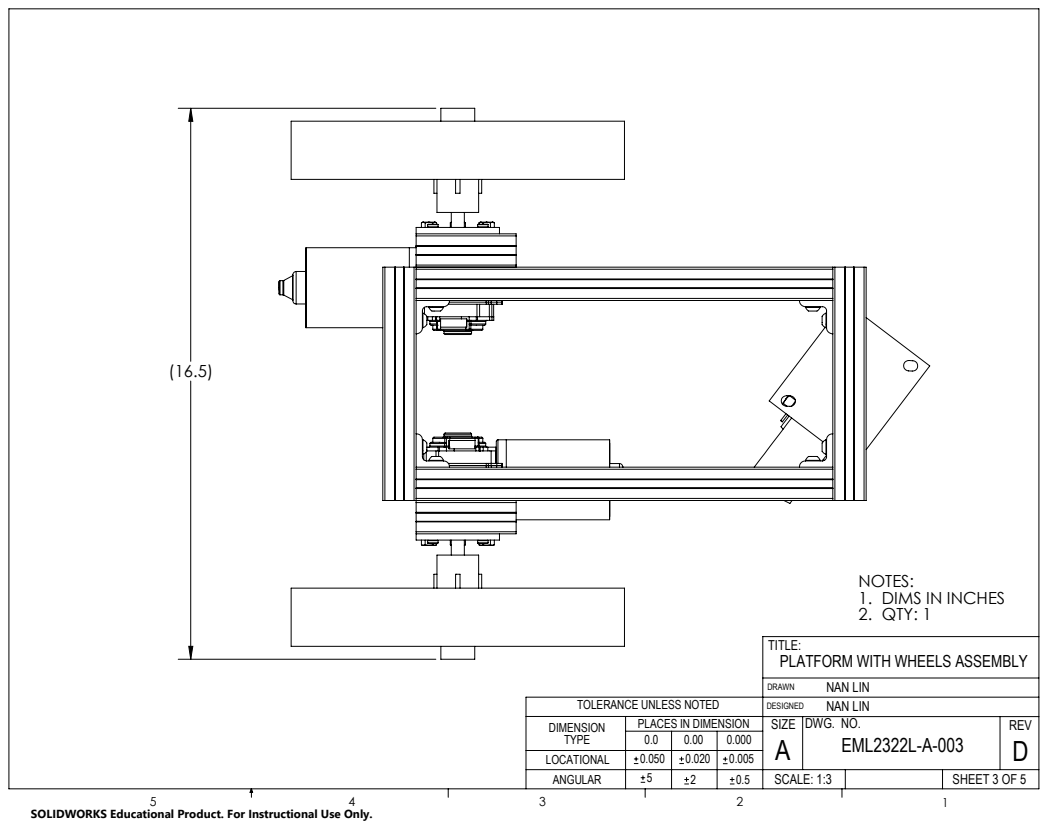
[picture p134: page 79]
REV D; EML2322L-A-003; DRAWN; DESIGNED; SCALE: 1:3; DIMS IN INCHES; NOTES: 1. 2. QTY: 1

TITLE:
PLATFORM WITH WHEELS ASSEMBLY
NAN LIN
DWG. NO.
SIZE

TOLERANCE UNLESS NOTED
DIMENSION
TYPE
LOCATIONAL

PLACES IN DIMENSION

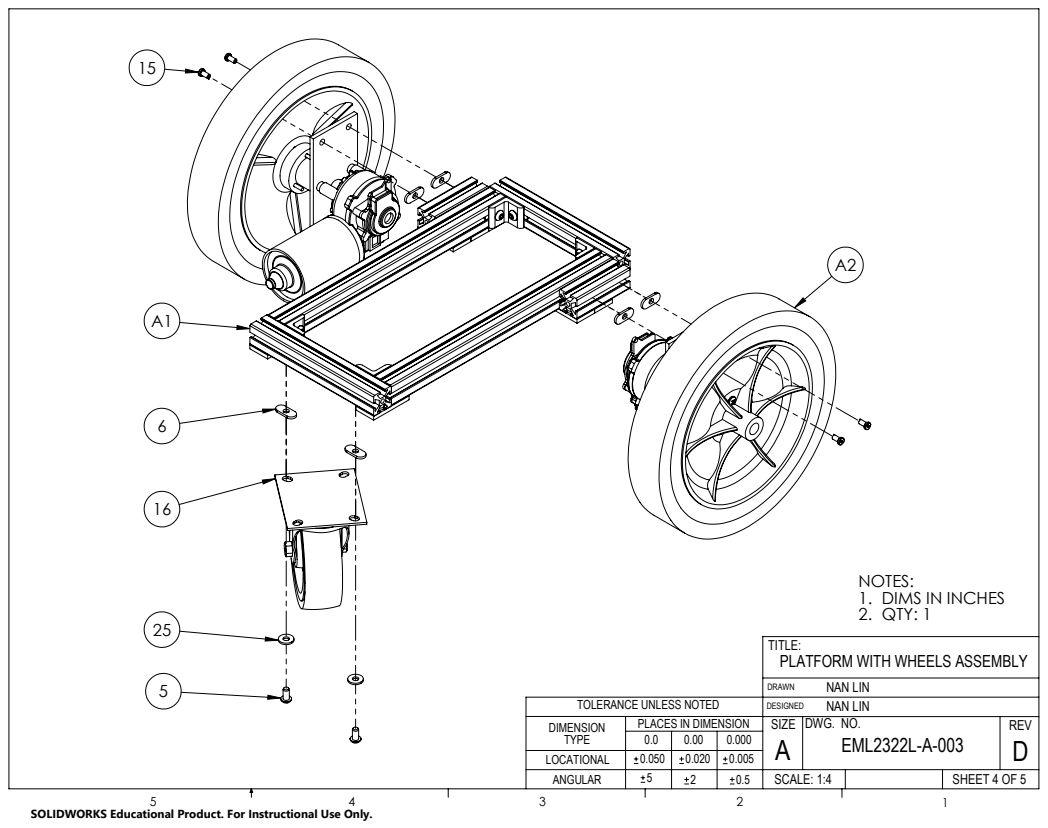
[picture p135: page 80]
REV D; EML2322L-A-003; DRAWN; DESIGNED; SCALE: 1:4; DIMS IN INCHES; NOTES: 1. 2. QTY: 1

TITLE:
PLATFORM WITH WHEELS ASSEMBLY
NAN LIN
DWG. NO.
SIZE

TOLERANCE UNLESS NOTED
DIMENSION
TYPE
LOCATIONAL

PLACES IN DIMENSION

ITEM NO. | PART NUMBER | DESCRIPTION | QTY.
5 | EML2322L-0005 | 1/4-20 x 1/2 in BUTTON HEAD CAP SCREW | 2
6 | EML2322L-0006 | 1/4-20 T-NUT | 6
15 | EML2322L-0015 | 10-24 x 3/8 in SOCKET HEAD SCREW | 4
16 | EML2322L-0016 | 5 in CASTER WHEEL | 1
25 | EML2322L-0025 | 1/4 in WASHER | 2
A1 | EML2322L-A-001 | MOBILE PLATFORM FRAME ASSEMBLY | 1
A2 | EML2322L-A-002 | WHEEL AND MOTOR ASSEMBLY | 2

PLATFORM WITH WHEELS ASSEMBLY

DWG. NO.

TITLE:

REV
D

SIZE

### A EML2322L-A-003

DRAWN
DESIGNED

NAN LIN
NAN LIN
0.0 | 0.00 | 0.000
0.050 0.020 0.005
LOCATIONAL

TOLERANCE UNLESS NOTED
DIMENSION
TYPE
5 | 2 | SCALE: 1:4

PLACES IN DIMENSION

DIMS IN INCHES

NOTES:
1.
2. QTY: 1

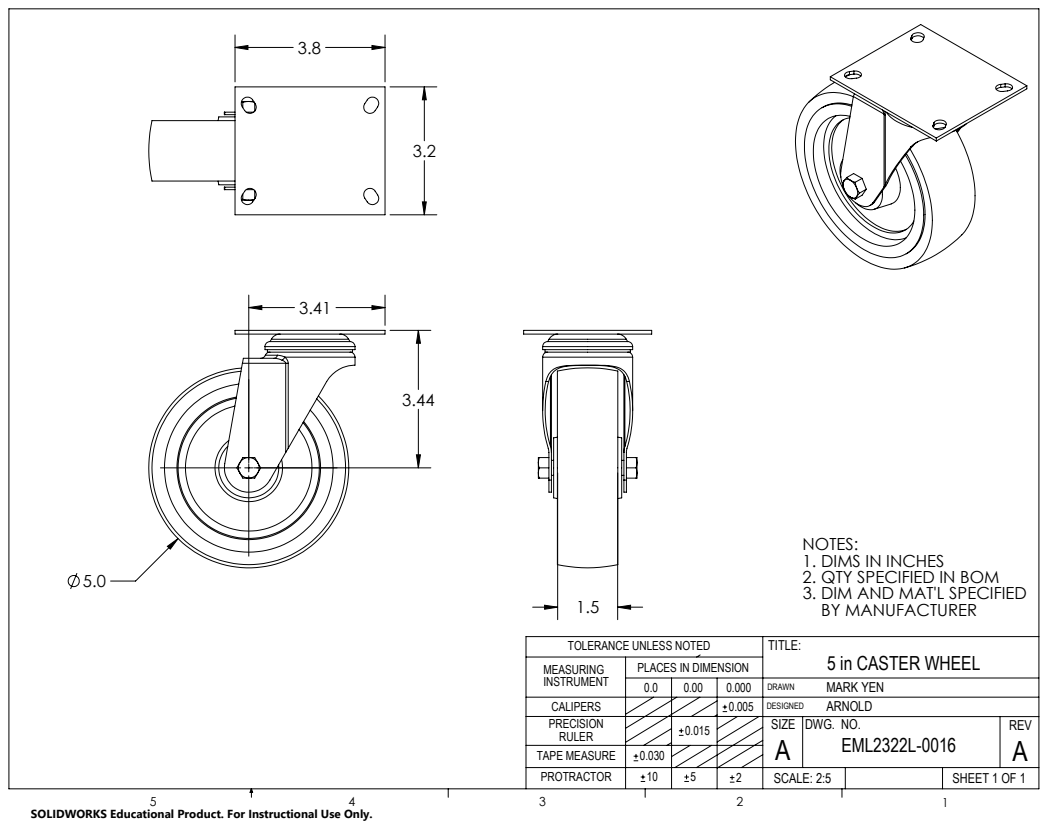
[picture p136: page 82]
SHEET 1 OF 1; TITLE:; REV A; SIZE; EML2322L-0016; DRAWN; DESIGNED; PROTRACTOR; TAPE MEASURE; PRECISION RULER; CALIPERS; TOLERANCE UNLESS NOTED MEASURING INSTRUMENT; SCALE: 2:5

NOTES:
DIMS IN INCHES
QTY SPECIFIED IN BOM
3. DIM AND MAT'L SPECIFIED
BY MANUFACTURER
5 in CASTER WHEEL
MARK YEN
ARNOLD
DWG. NO.

PLACES IN DIMENSION

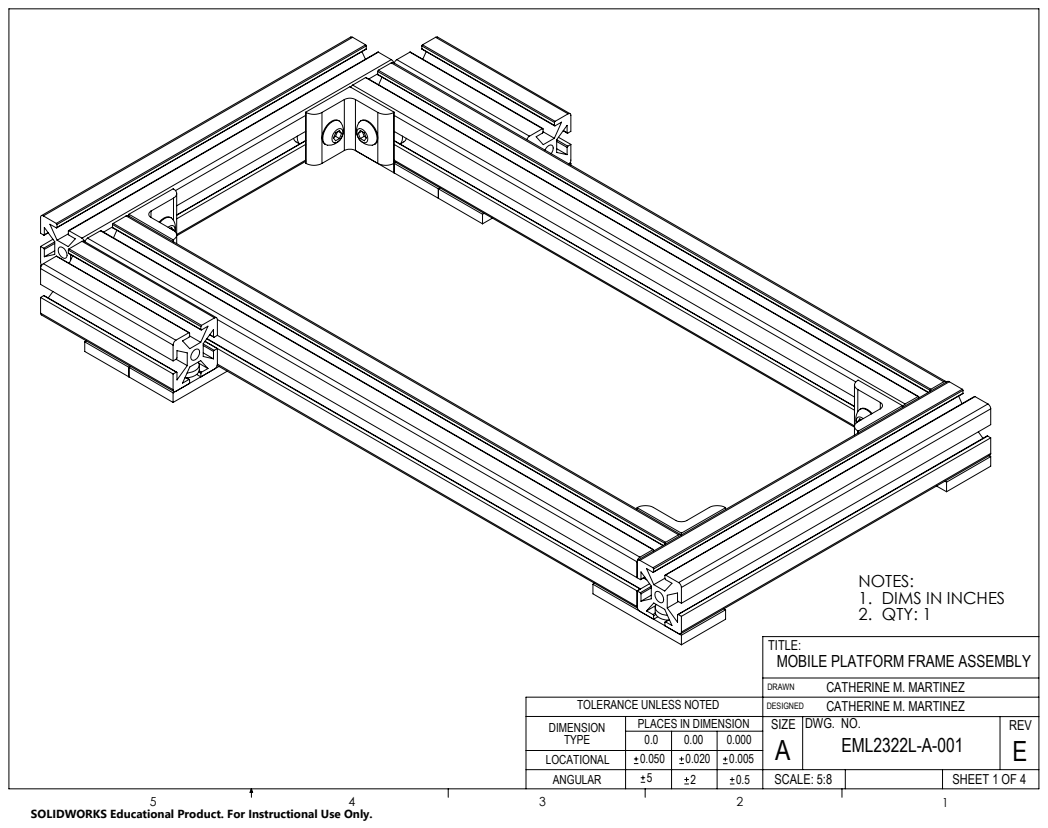
[picture p137: page 83]
REV E; EML2322L-A-001; DRAWN; DESIGNED; SCALE: 5:8; DIMS IN INCHES; NOTES: 1. 2. QTY: 1

TITLE:
MOBILE PLATFORM FRAME ASSEMBLY
CATHERINE M. MARTINEZ
DWG. NO.
SIZE

TOLERANCE UNLESS NOTED
DIMENSION
TYPE
LOCATIONAL

PLACES IN DIMENSION

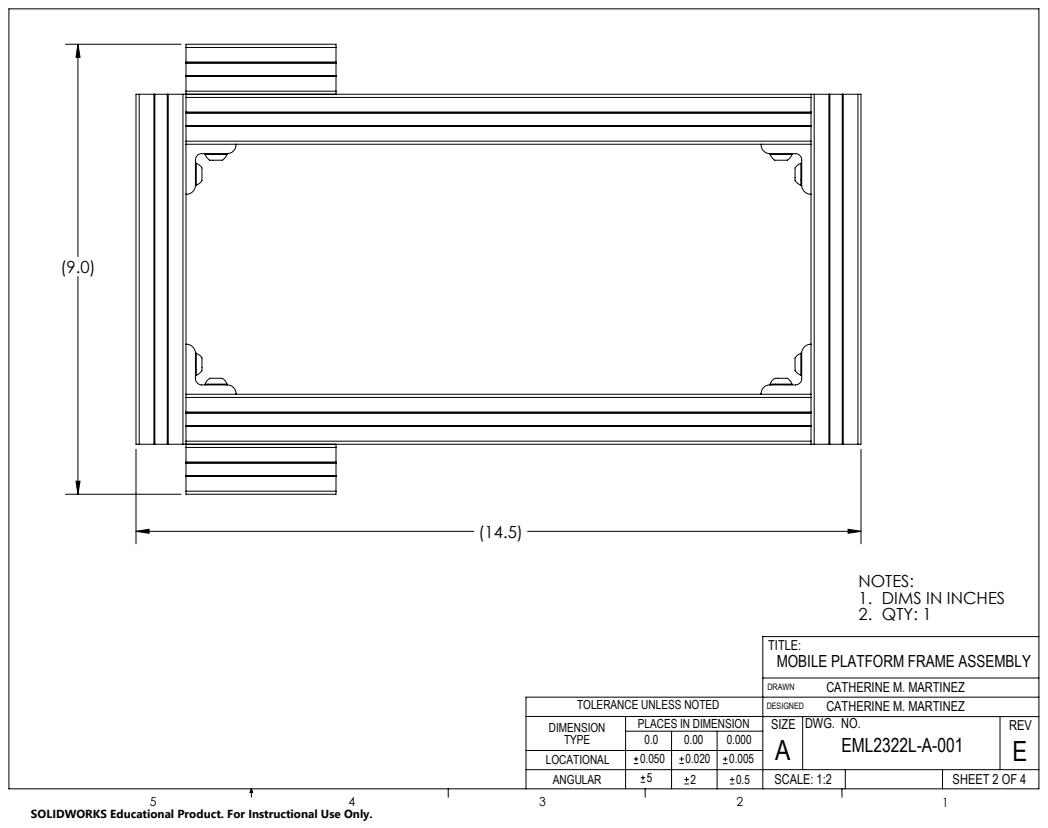
[picture p138: page 84]
REV E; EML2322L-A-001; DRAWN; DESIGNED; SCALE: 1:2; DIMS IN INCHES; NOTES: 1. 2. QTY: 1

TITLE:
MOBILE PLATFORM FRAME ASSEMBLY
CATHERINE M. MARTINEZ
DWG. NO.
SIZE

TOLERANCE UNLESS NOTED
DIMENSION
TYPE
LOCATIONAL

PLACES IN DIMENSION

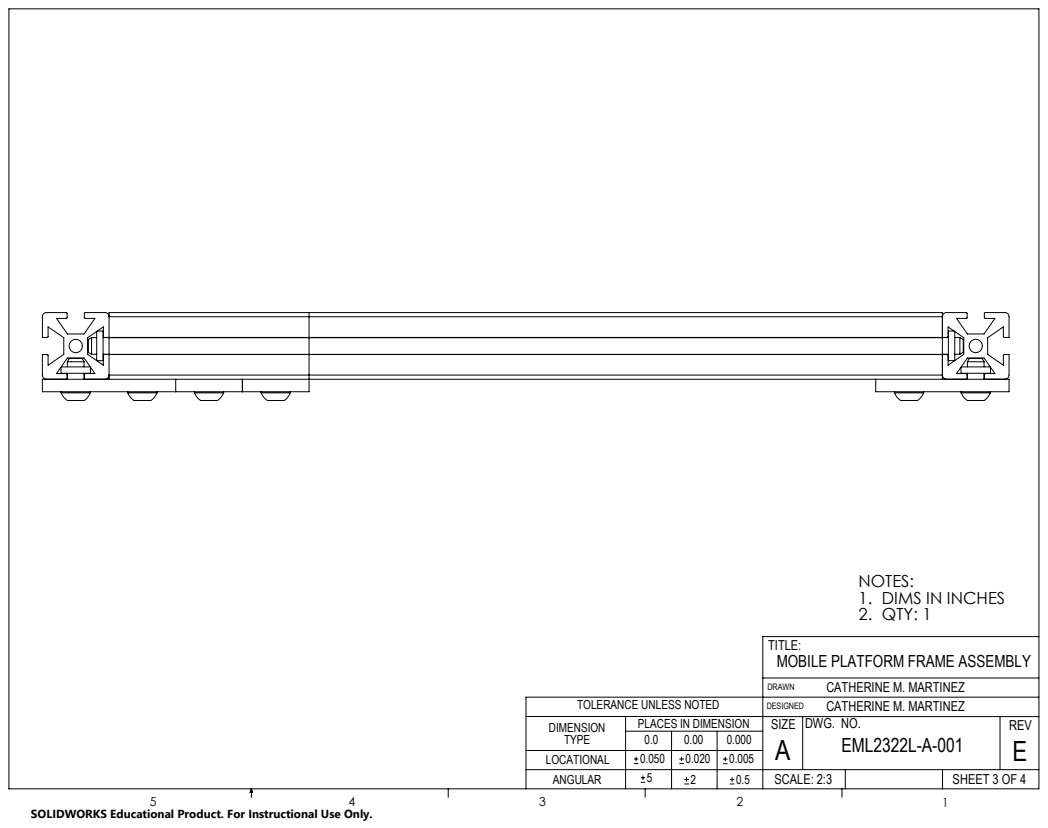
[picture p139: page 85]
REV E; EML2322L-A-001; DRAWN; DESIGNED; SCALE: 2:3; DIMS IN INCHES; NOTES: 1. 2. QTY: 1

TITLE:
MOBILE PLATFORM FRAME ASSEMBLY
CATHERINE M. MARTINEZ
DWG. NO.
SIZE

TOLERANCE UNLESS NOTED
DIMENSION
TYPE
LOCATIONAL

PLACES IN DIMENSION

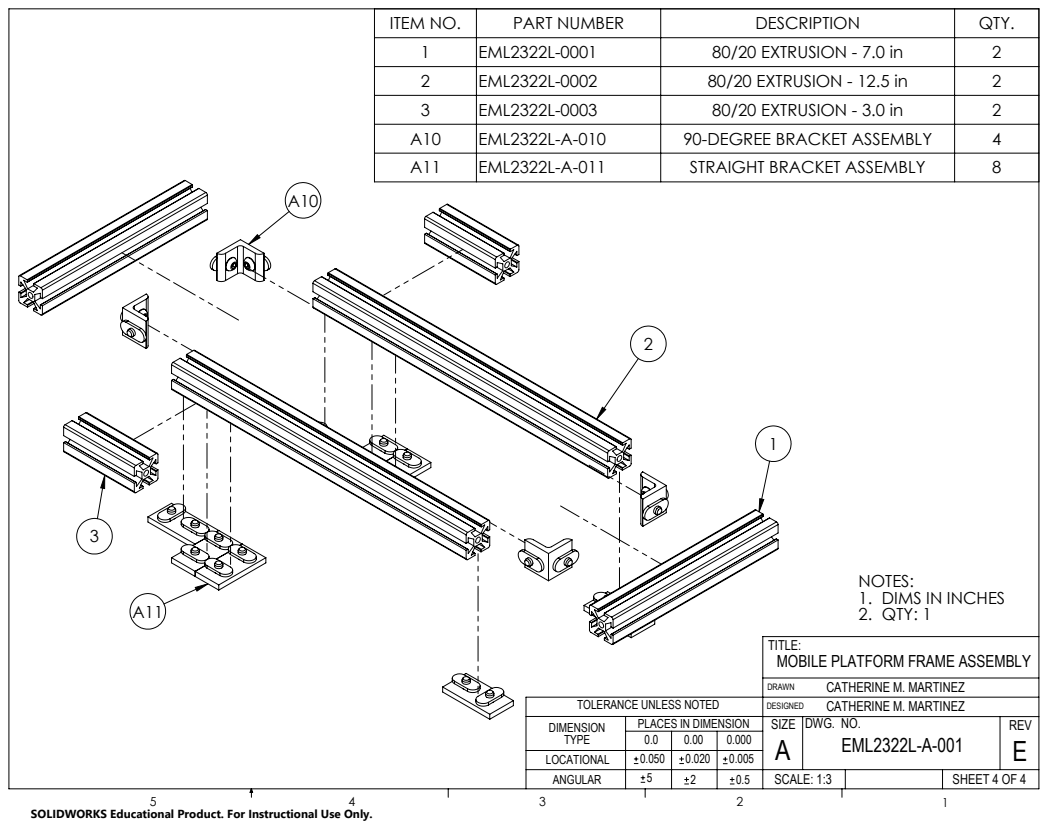
[picture p140: page 86]
REV E; EML2322L-A-001; DRAWN; DESIGNED; SCALE: 1:3; DIMS IN INCHES; NOTES: 1. 2. QTY: 1

ITEM NO. | PART NUMBER | DESCRIPTION | QTY.
1 | EML2322L-0001 | 80/20 EXTRUSION - 7.0 in | 2
2 | EML2322L-0002 | 80/20 EXTRUSION - 12.5 in | 2
3 | EML2322L-0003 | 80/20 EXTRUSION - 3.0 in | 2
A10 | EML2322L-A-010 | 90-DEGREE BRACKET ASSEMBLY | 4
A11 | EML2322L-A-011 | STRAIGHT BRACKET ASSEMBLY | 8

TITLE:
MOBILE PLATFORM FRAME ASSEMBLY
CATHERINE M. MARTINEZ
DWG. NO.
SIZE

TOLERANCE UNLESS NOTED
DIMENSION
TYPE
LOCATIONAL

PLACES IN DIMENSION

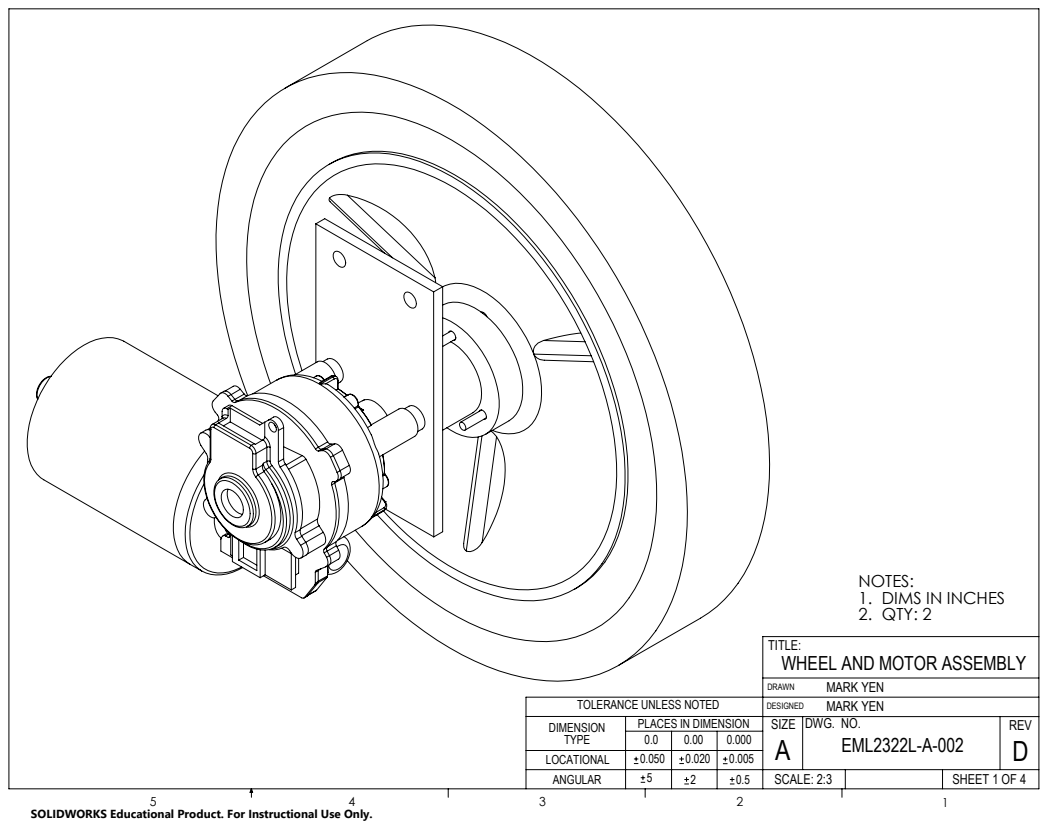
[picture p141: page 87]
TITLE:; REV D; EML2322L-A-002; DRAWN; DESIGNED; SCALE: 2:3

NOTES:
DIMS IN INCHES
2. QTY: 2
WHEEL AND MOTOR ASSEMBLY
MARK YEN
DWG. NO.
SIZE

TOLERANCE UNLESS NOTED
DIMENSION
TYPE
LOCATIONAL

PLACES IN DIMENSION

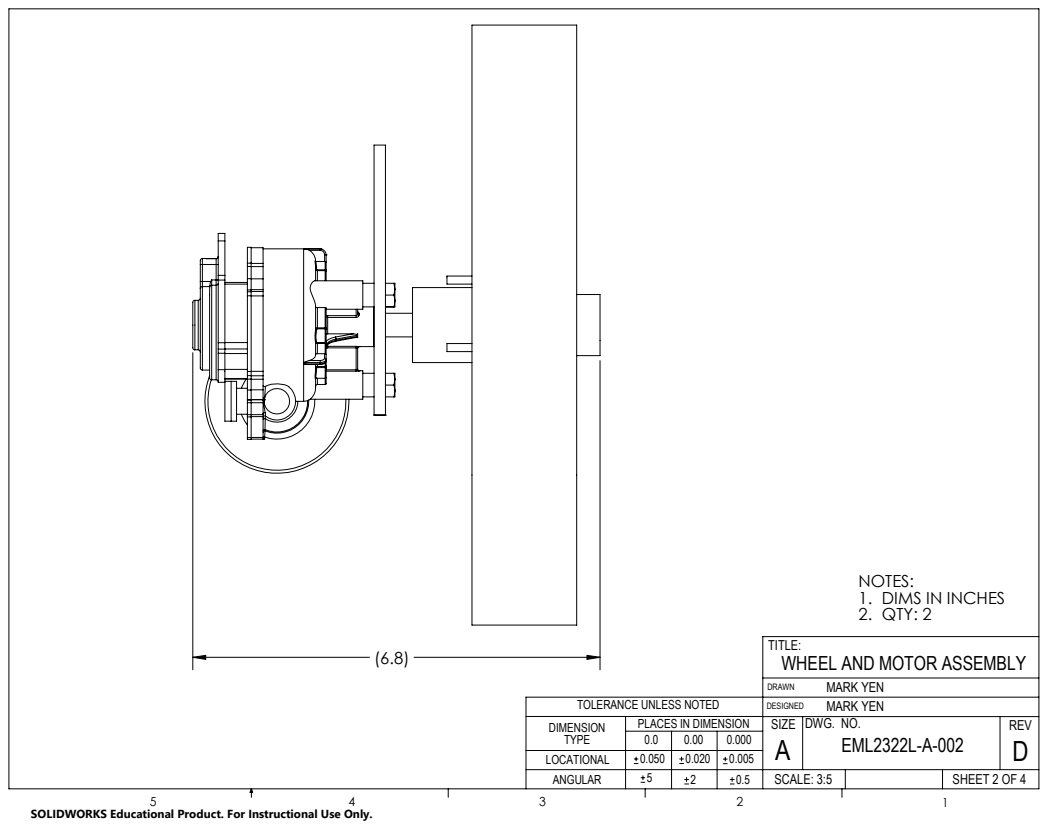
[picture p142: page 88]
DWG. NO.; TITLE:; REV D; SIZE; EML2322L-A-002; DRAWN; DESIGNED; MARK YEN MARK YEN; SCALE: 3:5; DIMS IN INCHES; NOTES: 1. 2. QTY: 2

(6.8) WHEEL AND MOTOR ASSEMBLY

TOLERANCE UNLESS NOTED
DIMENSION
TYPE
LOCATIONAL

PLACES IN DIMENSION

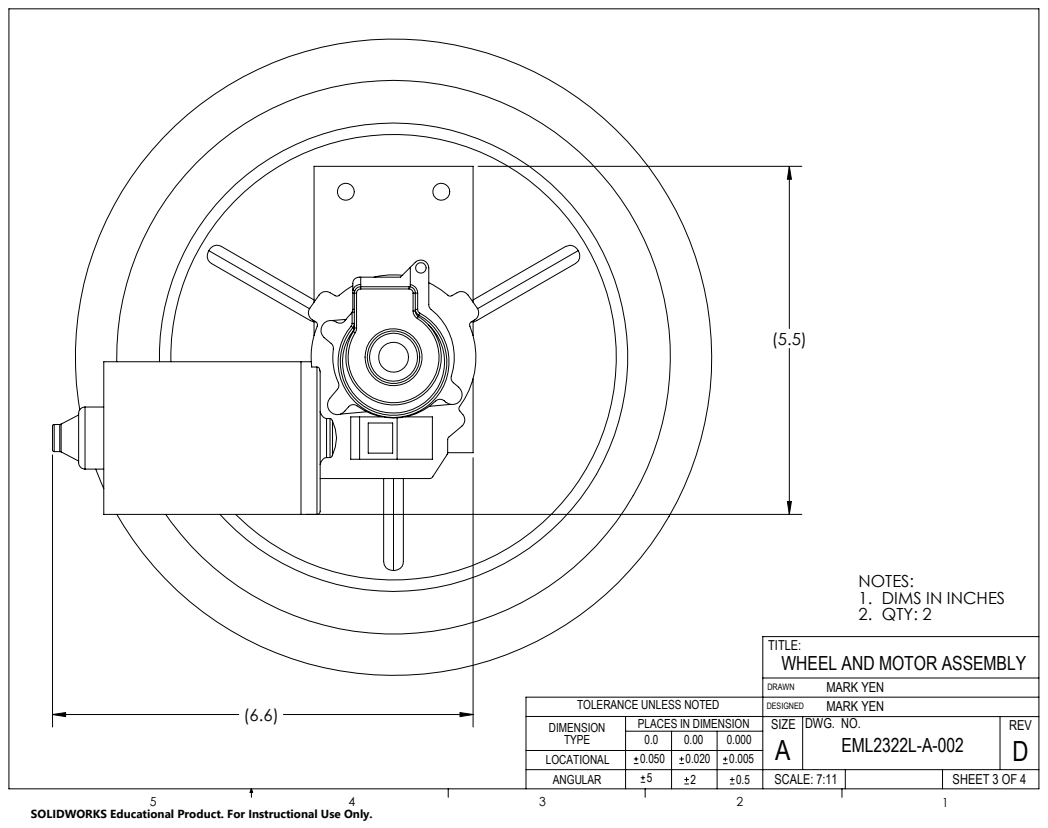
[picture p143: page 89]
TITLE:; REV D; EML2322L-A-002; DRAWN; DESIGNED; SCALE: 7:11

NOTES:
DIMS IN INCHES
2. QTY: 2
WHEEL AND MOTOR ASSEMBLY
MARK YEN
DWG. NO.
SIZE

TOLERANCE UNLESS NOTED
DIMENSION
TYPE
LOCATIONAL

PLACES IN DIMENSION

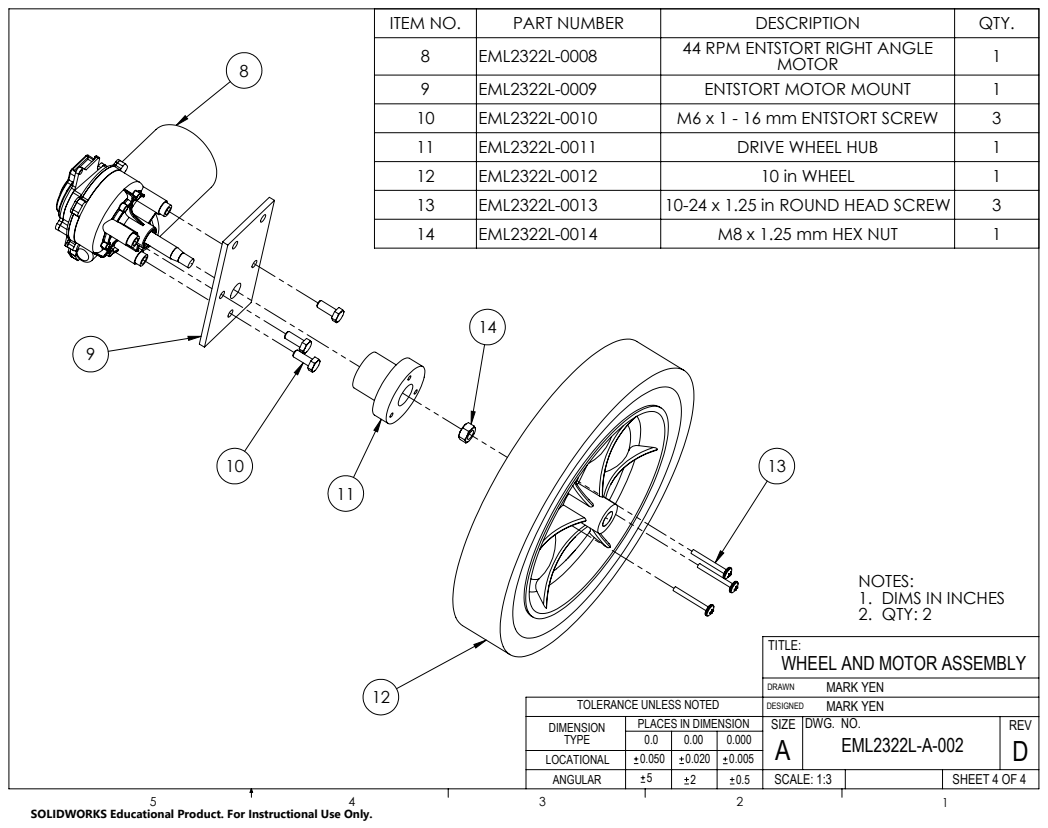
[picture p144: page 90]
TITLE:; REV D; EML2322L-A-002; DRAWN; DESIGNED; SCALE: 1:3

ITEM NO. | PART NUMBER | DESCRIPTION | QTY.
8 | EML2322L-0008 | 44 RPM ENTSTORT RIGHT ANGLE MOTOR | 1
9 | EML2322L-0009 | ENTSTORT MOTOR MOUNT | 1
10 | EML2322L-0010 | M6 x 1 - 16 mm ENTSTORT SCREW | 3
11 | EML2322L-0011 | DRIVE WHEEL HUB | 1
12 | EML2322L-0012 | 10 in WHEEL | 1
13 | EML2322L-0013 | 10-24 x 1.25 in ROUND HEAD SCREW | 3
14 | EML2322L-0014 | M8 x 1.25 mm HEX NUT | 1

NOTES:
DIMS IN INCHES
2. QTY: 2
WHEEL AND MOTOR ASSEMBLY
MARK YEN
DWG. NO.
SIZE

TOLERANCE UNLESS NOTED
DIMENSION
TYPE
LOCATIONAL

PLACES IN DIMENSION

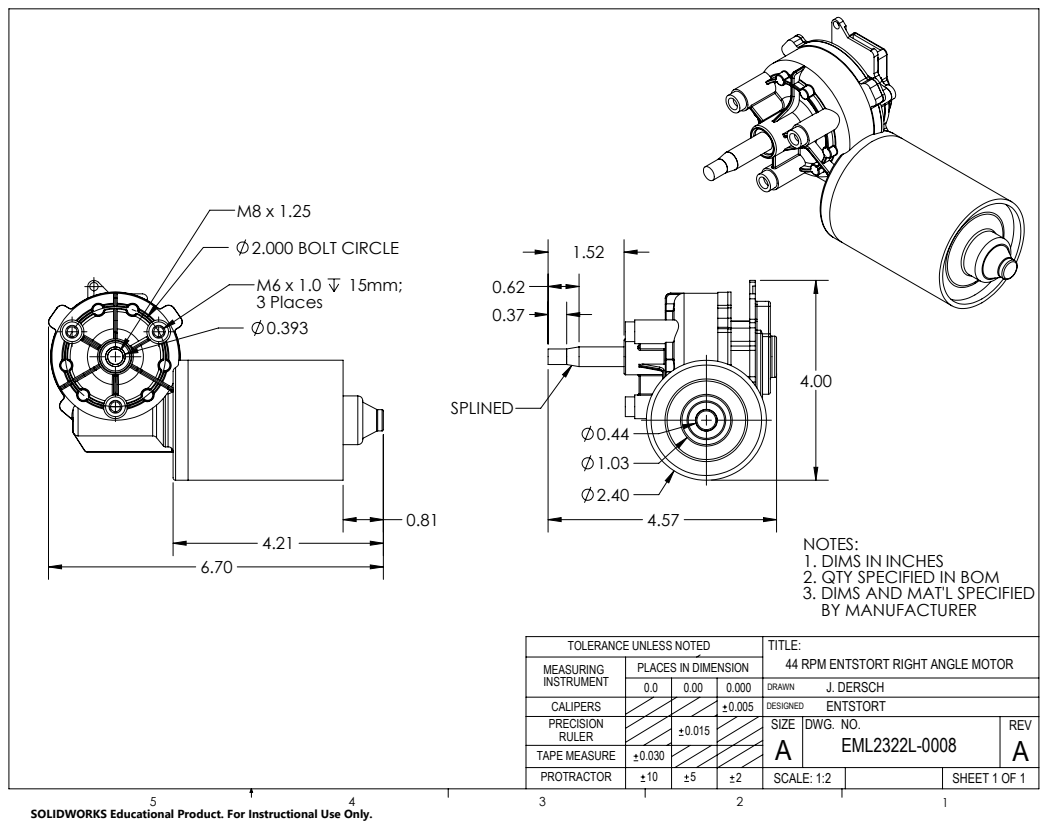
[picture p145: page 91]
2.000 BOLT CIRCLE; M6 x 1.0 15mm; 3 Places; SPLINED; SHEET 1 OF 1; REV A; SIZE; EML2322L-0008; DRAWN; DESIGNED; PROTRACTOR; TAPE MEASURE; PRECISION RULER; CALIPERS; TOLERANCE UNLESS NOTED MEASURING INSTRUMENT; SCALE: 1:2; INCHES

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

TITLE:
44 RPM ENTSTORT RIGHT ANGLE MOTOR
J. DERSCH
ENTSTORT
DWG. NO.

PLACES IN DIMENSION

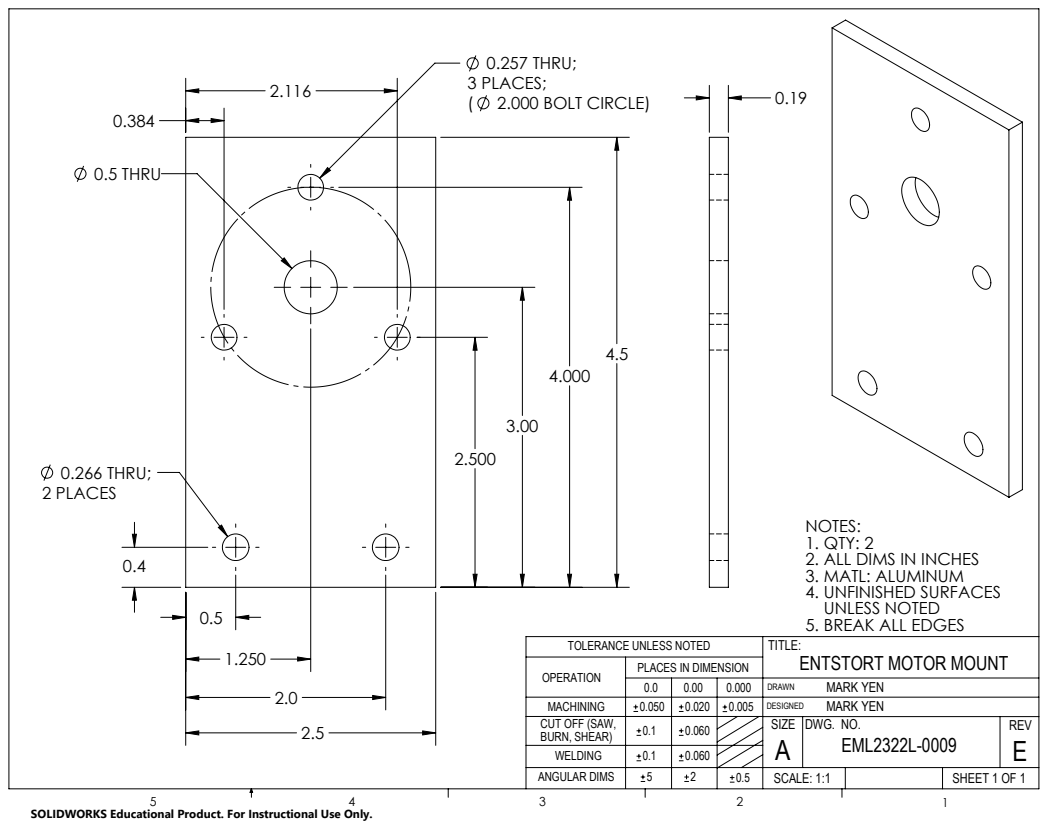
[picture p146: page 92]
0.266 THRU; 2 PLACES; 0.257 THRU; 3 PLACES; ( 2.000 BOLT CIRCLE); 0.5 THRU; REV E; SIZE; EML2322L-0009; DRAWN; DESIGNED; SCALE: 1:1

NOTES:
1. QTY: 2
2. ALL DIMS IN INCHES
3. MATL: ALUMINUM
4. UNFINISHED SURFACES
UNLESS NOTED
5. BREAK ALL EDGES
TITLE:
ENTSTORT MOTOR MOUNT
MARK YEN
DWG. NO.

TOLERANCE UNLESS NOTED
OPERATION
MACHINING
CUT OFF (SAW,
BURN, SHEAR)
WELDING
ANGULAR DIMS

PLACES IN DIMENSION

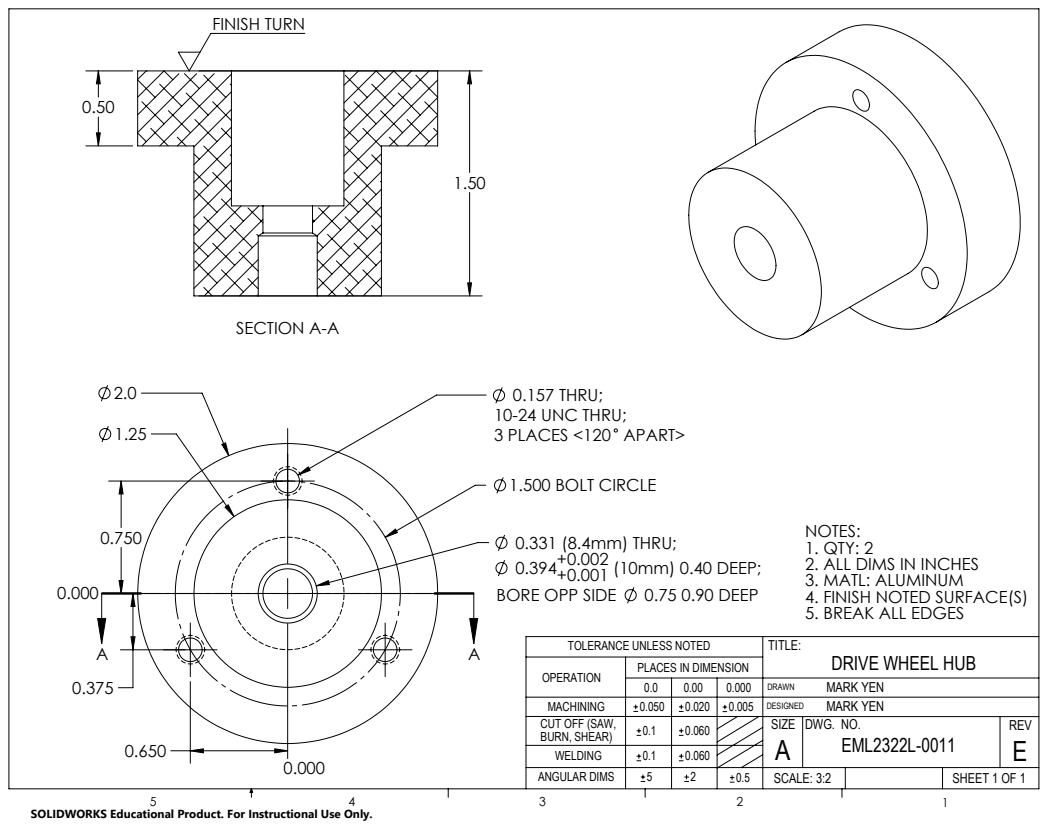
[picture p147: page 93]
0.157 THRU; 10-24 UNC THRU; 3 PLACES <120 APART>; 0.331 (8.4mm) THRU; 0.394+ +; 0.002 0.001 (10mm) 0.40 DEEP;; BORE OPP SIDE; 0.75 0.90 DEEP; 1.500 BOLT CIRCLE; SECTION A-A; FINISH TURN; REV E; SIZE; EML2322L-0011; DRAWN; DESIGNED; SCALE: 3:2

NOTES:
1. QTY: 2
2. ALL DIMS IN INCHES
3. MATL: ALUMINUM
4. FINISH NOTED SURFACE(S)
5. BREAK ALL EDGES
TITLE:
DRIVE WHEEL HUB
MARK YEN
DWG. NO.

TOLERANCE UNLESS NOTED
OPERATION
MACHINING
CUT OFF (SAW,
BURN, SHEAR)
WELDING
ANGULAR DIMS

PLACES IN DIMENSION

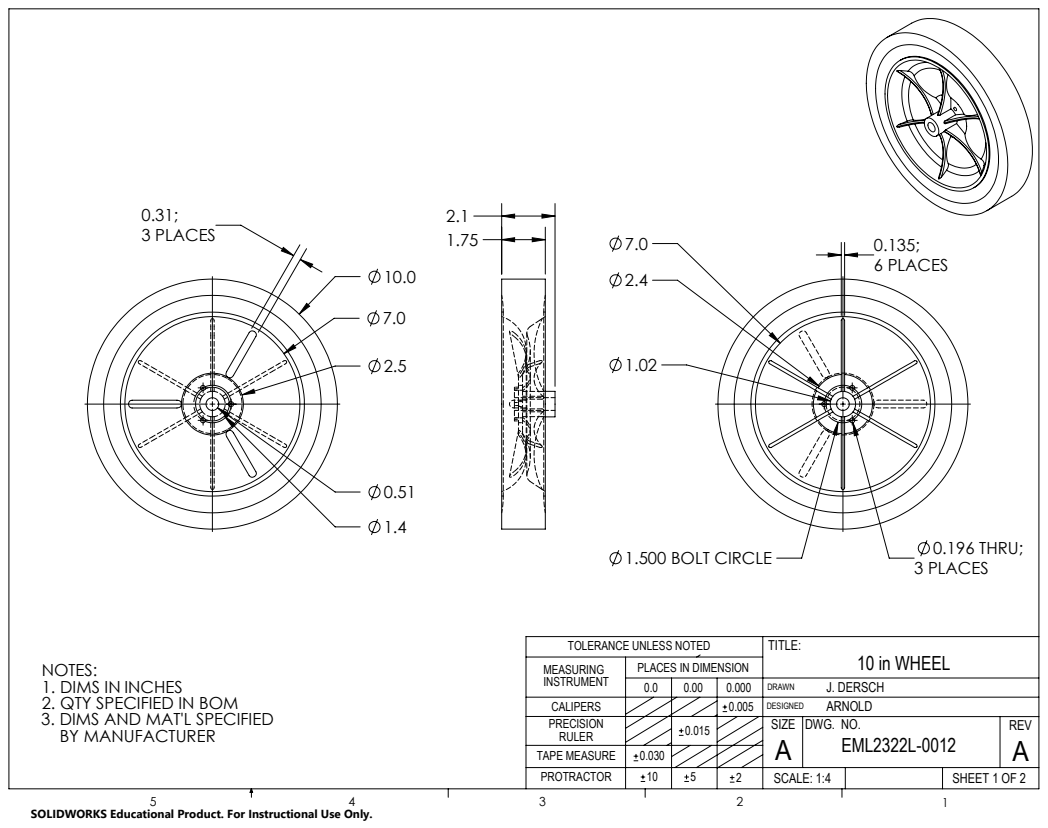
[picture p148: page 94]
0.135; 6 PLACES; 0.196 THRU;; 0.31; 3 PLACES; 10 in WHEEL; SHEET 1 OF 2; DWG. NO.; TITLE:; REV A; SIZE; EML2322L-0012; DRAWN; DESIGNED; J. DERSCH ARNOLD; PROTRACTOR; TAPE MEASURE; PRECISION RULER; CALIPERS; TOLERANCE UNLESS NOTED MEASURING INSTRUMENT; SCALE: 1:4; INCHES

3 PLACES 1.500 BOLT CIRCLE

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

PLACES IN DIMENSION

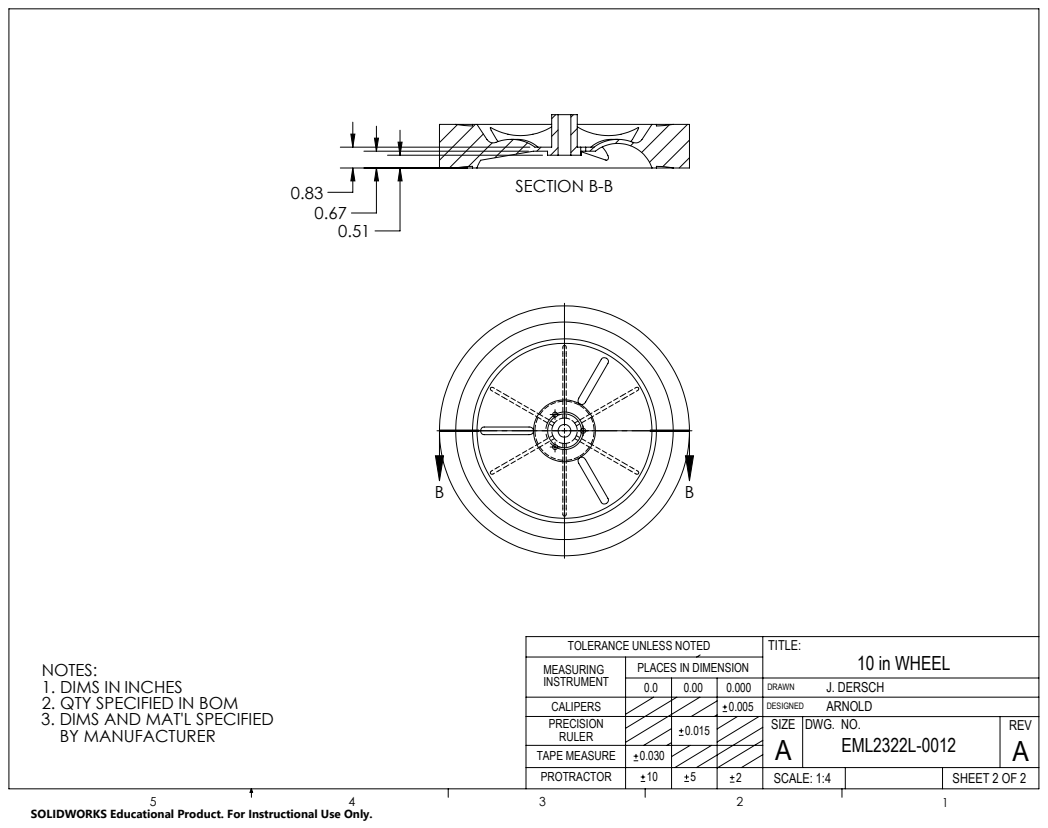
[picture p149: page 95]
SECTION B-B; 10 in WHEEL; SHEET 2 OF 2; DWG. NO.; TITLE:; REV A; SIZE; EML2322L-0012; DRAWN; DESIGNED; J. DERSCH ARNOLD; PROTRACTOR; TAPE MEASURE; PRECISION RULER; CALIPERS; TOLERANCE UNLESS NOTED MEASURING INSTRUMENT; SCALE: 1:4; INCHES

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

PLACES IN DIMENSION
