markyen001/DR4/Drawings for PRINT/MERGED 12-30.pdf

0.257 THRU;; CSINK; 5 PLACES; 0.51 THRU;; M6X1.0 8.6mm; 4 PLACES; 2.790 BOLT CIRCLE; 5.000 BOLT CIRCLE; SHEET 1 OF 1; TAPE MEASURE; TOLERANCE UNLESS NOTED; SCALE: 1:3

TITLE:
4.5 RPM GLOBE GEAR MOTOR
J. DERSCH
GLOBE
DWG. NO.

PLACES IN DIMENSION

NOTES:
1. DIMS IN
2. QTY SPECIFIED IN BOM
3. DIMS AND MAT'L SPECIFIED
BY MANUFACTURER

SOLIDWORKS Educational Product. For Instructional Use Only.

SHEET 1 OF 5; TOLERANCE UNLESS NOTED; SCALE: 1:4; DIMS IN INCHES 2. QTY: 1

TITLE:
PLATFORM WITH BOX/HOPPER/BUCKET
NAN LIN
DWG. NO.
SIZE

PLACES IN DIMENSION

SCALE: 1:4; DIMS IN INCHES 2. QTY: 1

TITLE:
PLATFORM WITH BOX/HOPPER/BUCKET
NAN LIN
DWG. NO.
SIZE

TOLERANCE UNLESS NOTED
DIMENSION
TYPE
LOCATIONAL

PLACES IN DIMENSION

SCALE: 1:4; DIMS IN INCHES 2. QTY: 1

TITLE:
PLATFORM WITH BOX/HOPPER/BUCKET
NAN LIN
DWG. NO.
SIZE

TOLERANCE UNLESS NOTED
DIMENSION
TYPE
LOCATIONAL

PLACES IN DIMENSION

SCALE: 2:7; DIMS IN INCHES 2. QTY: 1

TITLE:
PLATFORM WITH BOX/HOPPER/BUCKET
NAN LIN
DWG. NO.
SIZE

TOLERANCE UNLESS NOTED
DIMENSION
TYPE
LOCATIONAL

PLACES IN DIMENSION

SCALE: 2:9; DIMS IN INCHES 2. QTY: 1

ITEM NO. | PART NUMBER | DESCRIPTION | STRETCH/ QTY.
A14 | EML2322L-A-014 | HOPPER/BUCKET ASSEMBLY | 1
A15 | EML2322L-A-015 | PLATFORM WITH CONTROL BOX ASSEMBLY | 1

TITLE:
PLATFORM WITH BOX/HOPPER/BUCKET
NAN LIN
DWG. NO.
SIZE

TOLERANCE UNLESS NOTED
DIMENSION
TYPE
LOCATIONAL

PLACES IN DIMENSION

SCALE: 2:7

NOTES:
DIMS IN INCHES
2. QTY: 1
HOPPER/BUCKET ASSEMBLY
MARK YEN
DWG. NO.
SIZE

TOLERANCE UNLESS NOTED
DIMENSION
TYPE
LOCATIONAL

PLACES IN DIMENSION

SCALE: 2:7

NOTES:
DIMS IN INCHES
2. QTY: 1
HOPPER/BUCKET ASSEMBLY
MARK YEN
DWG. NO.
SIZE

TOLERANCE UNLESS NOTED
DIMENSION
TYPE
LOCATIONAL

PLACES IN DIMENSION

SCALE: 1:2

NOTES:
DIMS IN INCHES
2. QTY: 1
HOPPER/BUCKET ASSEMBLY
MARK YEN
DWG. NO.
SIZE

TOLERANCE UNLESS NOTED
DIMENSION
TYPE
LOCATIONAL

PLACES IN DIMENSION

SCALE: 4:17

ITEM NO. | PART NUMBER | DESCRIPTION | BUCKET STRETCH/ QTY.

6 | EML2322L-0006 | 1/4-20 T-NUT | 2
27 | EML2322L-0027 | 1/4-20 x 1.0 in FLAT HEAD SCREW | 2
A5 | EML2322L-A-005 | BUCKET MANIPULATOR TOTAL ASSEMBLY | 1
A13 | EML2322L-A-013 | HOPPER ASSEMBLY | 1

NOTES:
DIMS IN INCHES
2. QTY: 1
HOPPER/BUCKET ASSEMBLY
MARK YEN
DWG. NO.
SIZE

TOLERANCE UNLESS NOTED
DIMENSION
TYPE
LOCATIONAL

PLACES IN DIMENSION

SCALE: 1:2; DIMS IN INCHES 2. QTY: 1

TITLE:
BUCKET MANIPULATOR TOTAL ASSEMBLY
MARK YEN
DWG. NO.
SIZE

TOLERANCE UNLESS NOTED
DIMENSION
TYPE
LOCATIONAL

PLACES IN DIMENSION

SCALE: 1:2; DIMS IN INCHES 2. QTY: 1

TITLE:
BUCKET MANIPULATOR TOTAL ASSEMBLY
MARK YEN
DWG. NO.
SIZE

TOLERANCE UNLESS NOTED
DIMENSION
TYPE
LOCATIONAL

PLACES IN DIMENSION

SCALE: 1:2; DIMS IN INCHES 2. QTY: 1

TITLE:
BUCKET MANIPULATOR TOTAL ASSEMBLY
MARK YEN
DWG. NO.
SIZE

TOLERANCE UNLESS NOTED
DIMENSION
TYPE
LOCATIONAL

PLACES IN DIMENSION

SCALE: 2:5; DIMS IN INCHES 2. QTY: 1

ITEM NO. | PART NUMBER | DESCRIPTION | STRETCH/ QTY.
6 | EML2322L-0006 | 1/4-20 T-NUT | 2
A4 | EML2322L-A-004 | BUCKET MANIPULATOR ASSEMBLY | 1
A8 | EML2322L-A-008 | GLOBE MOTOR BRACKET ASSEMBLY | 2
A12 | EML2322L-A-012 | 4.5 RPM GLOBE MOTOR ASSEMBLY | 1

TITLE:
BUCKET MANIPULATOR TOTAL ASSEMBLY
MARK YEN
DWG. NO.
SIZE

TOLERANCE UNLESS NOTED
DIMENSION
TYPE
LOCATIONAL

PLACES IN DIMENSION

SCALE: 5:8; DIMS IN INCHES 2. QTY: 1

TITLE:
BUCKET MANIPULATOR ASSEMBLY
NAN LIN
DWG. NO.
SIZE

TOLERANCE UNLESS NOTED
DIMENSION
TYPE
LOCATIONAL

PLACES IN DIMENSION

SCALE: 3:5; DIMS IN INCHES 2. QTY: 1

TITLE:
BUCKET MANIPULATOR ASSEMBLY
NAN LIN
DWG. NO.
SIZE

TOLERANCE UNLESS NOTED
DIMENSION
TYPE
LOCATIONAL

PLACES IN DIMENSION

SCALE: 1:2; DIMS IN INCHES 2. QTY: 1

TITLE:
BUCKET MANIPULATOR ASSEMBLY
NAN LIN
DWG. NO.
SIZE

TOLERANCE UNLESS NOTED
DIMENSION
TYPE
LOCATIONAL

PLACES IN DIMENSION

SCALE: 2:5; DIMS IN INCHES 2. QTY: 1

ITEM NO. | PART NUMBER | DESCRIPTION | QTY.
1 | EML2322L-0001 | 80/20 EXTRUSION - 7.0 in | 1
30 | EML2322L-0030 | 80/20 EXTRUSION - 8.5 in | 2
31 | EML2322L-0031 | 80/20 EXTRUSION - 6.0 in | 1
A10 | EML2322L-A-010 | 90-DEGREE BRACKET ASSEMBLY | 6
A11 | EML2322L-A-011 | STRAIGHT BRACKET ASSEMBLY | 2

TITLE:
BUCKET MANIPULATOR ASSEMBLY
NAN LIN
DWG. NO.
SIZE

TOLERANCE UNLESS NOTED
DIMENSION
TYPE
LOCATIONAL

PLACES IN DIMENSION

SCALE: 4:1

NOTES:
DIMS IN INCHES
2. QTY IN BOM

TITLE:
90-DEGREE BRACKET ASSEMBLY
MARK YEN
DWG. NO.
SIZE

TOLERANCE UNLESS NOTED
DIMENSION
TYPE
LOCATIONAL

PLACES IN DIMENSION

SCALE: 2:1

NOTES:
DIMS IN INCHES
2. QTY IN BOM

TITLE:
90-DEGREE BRACKET ASSEMBLY
MARK YEN
DWG. NO.
SIZE

TOLERANCE UNLESS NOTED
DIMENSION
TYPE
LOCATIONAL

PLACES IN DIMENSION

SCALE: 3:2

ITEM NO. | PART NUMBER | DESCRIPTION | QTY.
4 | EML2322L-0004 | 80/20 90 DEG ANGLE BRACKET | 1
5 | EML2322L-0005 | 1/4-20 x 1/2 in BUTTON HEAD CAP SCREW | 2
6 | EML2322L-0006 | 1/4-20 T-NUT | 2

NOTES:
DIMS IN INCHES
2. QTY IN BOM

TITLE:
90-DEGREE BRACKET ASSEMBLY
MARK YEN
DWG. NO.
SIZE

TOLERANCE UNLESS NOTED
DIMENSION
TYPE
LOCATIONAL

PLACES IN DIMENSION

SCALE: 3:1

NOTES:
DIMS IN INCHES
2. QTY IN BOM
STRAIGHT BRACKET ASSEMBLY
I. WIDJAJA
DWG. NO.
SIZE

TOLERANCE UNLESS NOTED
DIMENSION
TYPE
LOCATIONAL

PLACES IN DIMENSION

SCALE: 2:1

NOTES:
DIMS IN INCHES
2. QTY IN BOM
STRAIGHT BRACKET ASSEMBLY
I. WIDJAJA
DWG. NO.
SIZE

TOLERANCE UNLESS NOTED
DIMENSION
TYPE
LOCATIONAL

PLACES IN DIMENSION

SCALE: 2:1

ITEM NO. | PART NUMBER | DESCRIPTION | Both Parallel/Q TY.

5 | EML2322L-0005 | 1/4-20 x 1/2 in BUTTON HEAD CAP SCREW | 2
6 | EML2322L-0006 | 1/4-20 T-NUT | 2
7 | EML2322L-0007 | 80/20 STRAIGHT BRACKET | 1

NOTES:
DIMS IN INCHES
2. QTY IN BOM
STRAIGHT BRACKET ASSEMBLY
I. WIDJAJA
DWG. NO.
SIZE

TOLERANCE UNLESS NOTED
DIMENSION
TYPE
LOCATIONAL

PLACES IN DIMENSION

SCALE: 4:11

NOTES:
DIMS IN INCHES
2. QTY: 1
HOPPER ASSEMBLY
MARK YEN
DWG. NO.
SIZE

TOLERANCE UNLESS NOTED
DIMENSION
TYPE
LOCATIONAL

PLACES IN DIMENSION

SCALE: 1:4

NOTES:
DIMS IN INCHES
2. QTY: 1
HOPPER ASSEMBLY
MARK YEN
DWG. NO.
SIZE

TOLERANCE UNLESS NOTED
DIMENSION
TYPE
LOCATIONAL

PLACES IN DIMENSION

SCALE: 3:10

NOTES:
DIMS IN INCHES
2. QTY: 1
HOPPER ASSEMBLY
MARK YEN
DWG. NO.
SIZE

TOLERANCE UNLESS NOTED
DIMENSION
TYPE
LOCATIONAL

PLACES IN DIMENSION

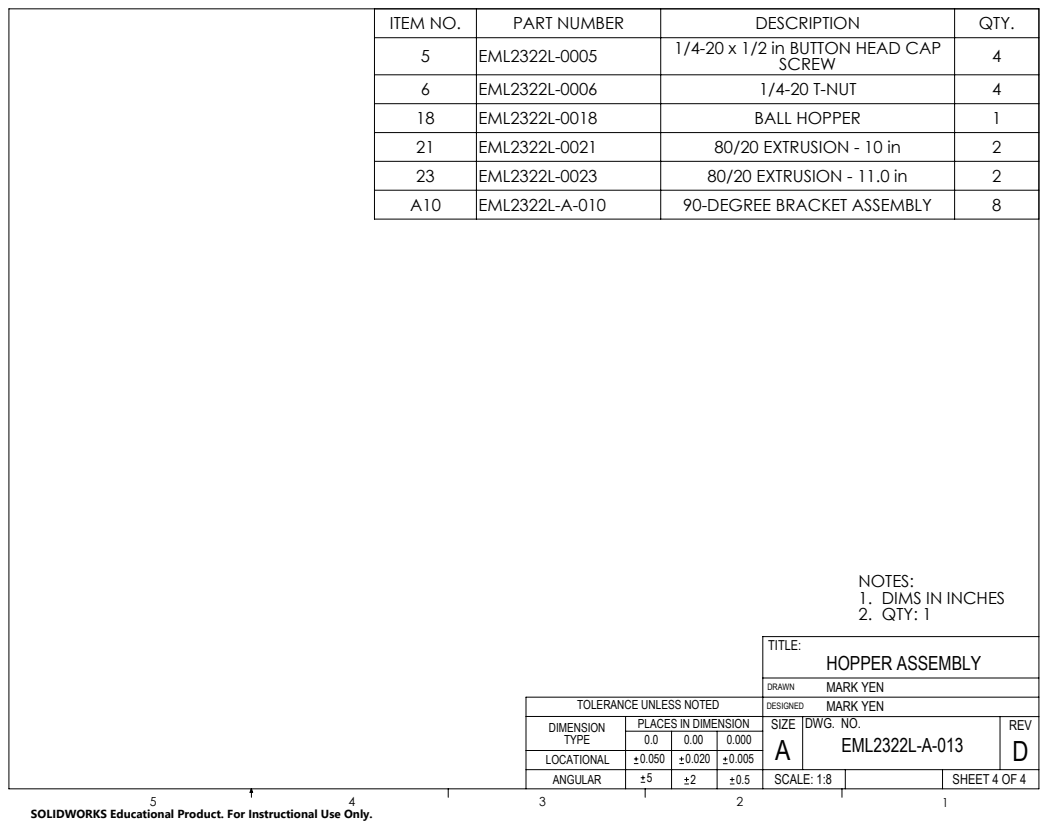
[picture p150: page 28]
SCALE: 1:8

ITEM NO. | PART NUMBER | DESCRIPTION | QTY.
5 | EML2322L-0005 | 1/4-20 x 1/2 in BUTTON HEAD CAP SCREW | 4
6 | EML2322L-0006 | 1/4-20 T-NUT | 4
18 | EML2322L-0018 | BALL HOPPER | 1
21 | EML2322L-0021 | 80/20 EXTRUSION - 10 in | 2
23 | EML2322L-0023 | 80/20 EXTRUSION - 11.0 in | 2
A10 | EML2322L-A-010 | 90-DEGREE BRACKET ASSEMBLY | 8

NOTES:
DIMS IN INCHES
2. QTY: 1
HOPPER ASSEMBLY
MARK YEN
DWG. NO.
SIZE

TOLERANCE UNLESS NOTED
DIMENSION
TYPE
LOCATIONAL

PLACES IN DIMENSION

BALL HOPPER; SHEET 1 OF 2; DWG. NO.; MARK YEN MARK YEN; SCALE: 1:4; FOLDED VIEW; DIMS IN INCHES MATL: 20 GAGE STEEL UNFINISHED SURFACES; QTY: 1; BREAK ALL EDGES

SINCE THE HOPPER WILL BE AT AN ANGLE
DURING ASSEMBLY, THE GROUP NUMBER
WILL BE WRITTEN AT AN ANGLE TO APPEAR
LEVEL DURING ASSEMBLY.

TOLERANCE UNLESS NOTED
OPERATION
MACHINING
SHEETMETAL
(SHEAR, BEND)
WELDING
ANGULAR DIMS

PLACES IN DIMENSION

0.257 THRU; 4 PLACES; BALL HOPPER; SHEET 2 OF 2; DWG. NO.; MARK YEN MARK YEN; SCALE: 1:5; UNFOLDED VIEW; DIMS IN INCHES; UNFINISHED SURFACES BREAK ALL EDGES; QTY: 1 MATL: 20 GAGE STEEL

TOLERANCE UNLESS NOTED
OPERATION
MACHINING
SHEETMETAL
(SHEAR, BEND)
WELDING
ANGULAR DIMS

PLACES IN DIMENSION

SCALE: 4:13

NOTES:
DIMS IN INCHES
2. QTY: 1
PLATFORM WITH CONTROL BOX
NAN LIN
DWG. NO.
SIZE

TOLERANCE UNLESS NOTED
DIMENSION
TYPE
LOCATIONAL

PLACES IN DIMENSION

SCALE: 1:3

NOTES:
DIMS IN INCHES
2. QTY: 1
PLATFORM WITH CONTROL BOX
NAN LIN
DWG. NO.
SIZE

TOLERANCE UNLESS NOTED
DIMENSION
TYPE
LOCATIONAL

PLACES IN DIMENSION

SCALE: 1:3

NOTES:
DIMS IN INCHES
2. QTY: 1
PLATFORM WITH CONTROL BOX
NAN LIN
DWG. NO.
SIZE

TOLERANCE UNLESS NOTED
DIMENSION
TYPE
LOCATIONAL

PLACES IN DIMENSION

SCALE: 5:14

NOTES:
DIMS IN INCHES
2. QTY: 1
PLATFORM WITH CONTROL BOX
NAN LIN
DWG. NO.
SIZE

TOLERANCE UNLESS NOTED
DIMENSION
TYPE
LOCATIONAL

PLACES IN DIMENSION

SCALE: 2:9

NOTES:
DIMS IN INCHES
2. QTY: 1
PLATFORM WITH CONTROL BOX
NAN LIN
DWG. NO.
SIZE

TOLERANCE UNLESS NOTED
DIMENSION
TYPE
LOCATIONAL

PLACES IN DIMENSION

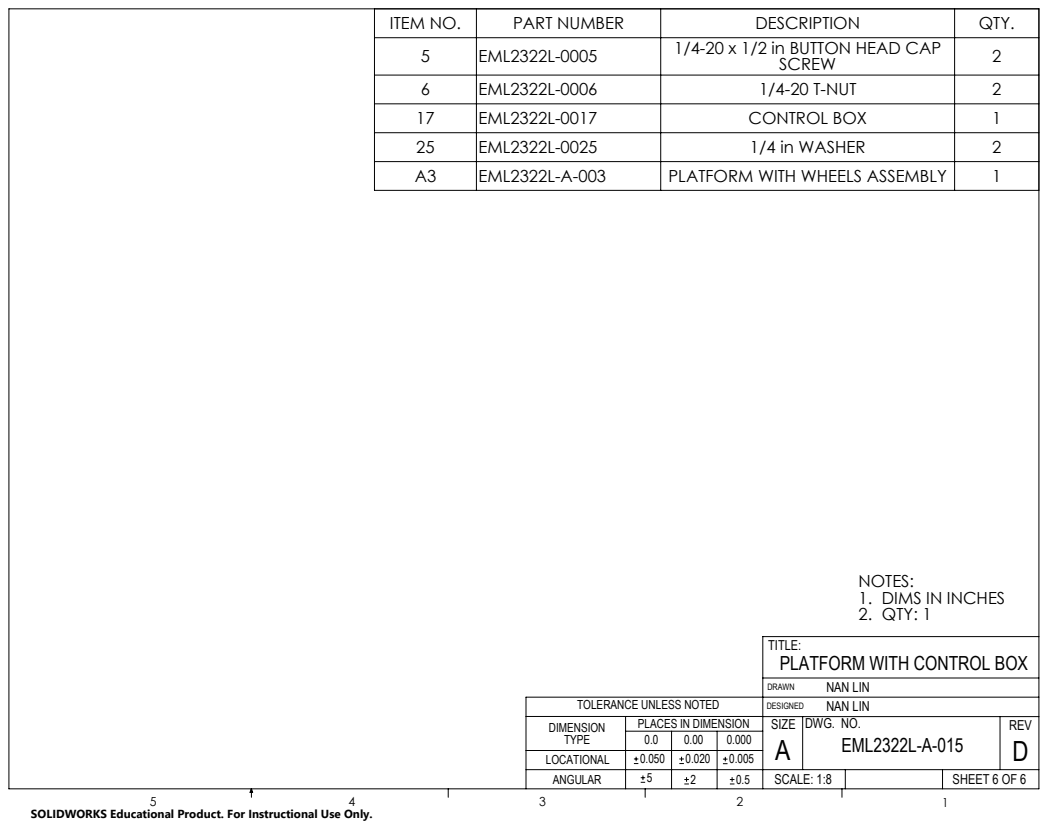
[picture p151: page 36]
SCALE: 1:8

ITEM NO. | PART NUMBER | DESCRIPTION | QTY.
5 | EML2322L-0005 | 1/4-20 x 1/2 in BUTTON HEAD CAP SCREW | 2
6 | EML2322L-0006 | 1/4-20 T-NUT | 2
17 | EML2322L-0017 | CONTROL BOX | 1
25 | EML2322L-0025 | 1/4 in WASHER | 2
A3 | EML2322L-A-003 | PLATFORM WITH WHEELS ASSEMBLY | 1

NOTES:
DIMS IN INCHES
2. QTY: 1
PLATFORM WITH CONTROL BOX
NAN LIN
DWG. NO.
SIZE

TOLERANCE UNLESS NOTED
DIMENSION
TYPE
LOCATIONAL

PLACES IN DIMENSION

0.328 THRU; 4 PLACES; SHEET 1 OF 1; TAPE MEASURE; TOLERANCE UNLESS NOTED; SCALE: 1:4

NOTES:
DIMS IN INCHES
QTY SPECIFIED IN BOM
3. DIM AND MAT'L SPECIFIED
BY MANUFACTURER
CONTROL BOX
KRISTIN BROOKER
VYNCKIER ENCLOSURES
DWG. NO.

PLACES IN DIMENSION

SCALE: 2:5; DIMS IN INCHES 2. QTY: 1

TITLE:
PLATFORM WITH WHEELS ASSEMBLY
NAN LIN
DWG. NO.
SIZE

TOLERANCE UNLESS NOTED
DIMENSION
TYPE
LOCATIONAL

PLACES IN DIMENSION

SCALE: 1:2; DIMS IN INCHES 2. QTY: 1

TITLE:
PLATFORM WITH WHEELS ASSEMBLY
NAN LIN
DWG. NO.
SIZE

TOLERANCE UNLESS NOTED
DIMENSION
TYPE
LOCATIONAL

PLACES IN DIMENSION

SCALE: 1:3; DIMS IN INCHES 2. QTY: 1

TITLE:
PLATFORM WITH WHEELS ASSEMBLY
NAN LIN
DWG. NO.
SIZE

TOLERANCE UNLESS NOTED
DIMENSION
TYPE
LOCATIONAL

PLACES IN DIMENSION

SCALE: 1:4; DIMS IN INCHES 2. QTY: 1

TITLE:
PLATFORM WITH WHEELS ASSEMBLY
NAN LIN
DWG. NO.
SIZE

TOLERANCE UNLESS NOTED
DIMENSION
TYPE
LOCATIONAL

PLACES IN DIMENSION

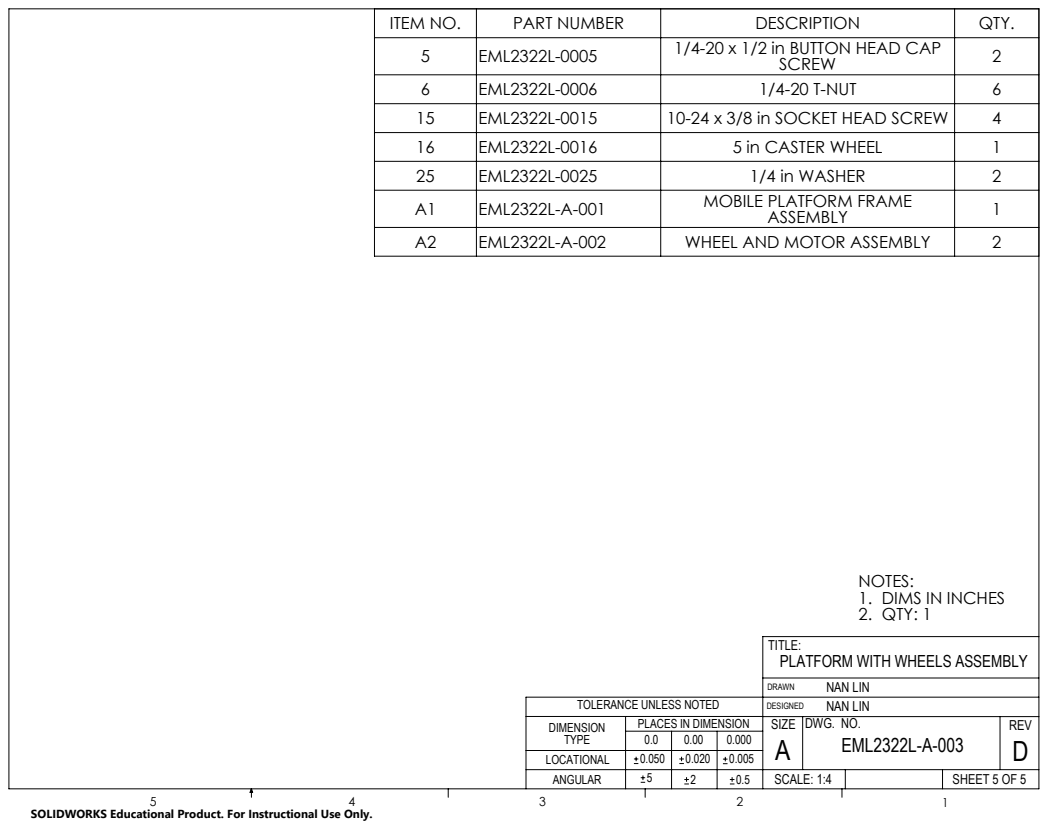
[picture p152: page 42]
SCALE: 1:4; DIMS IN INCHES 2. QTY: 1

ITEM NO. | PART NUMBER | DESCRIPTION | QTY.
5 | EML2322L-0005 | 1/4-20 x 1/2 in BUTTON HEAD CAP SCREW | 2
6 | EML2322L-0006 | 1/4-20 T-NUT | 6
15 | EML2322L-0015 | 10-24 x 3/8 in SOCKET HEAD SCREW | 4
16 | EML2322L-0016 | 5 in CASTER WHEEL | 1
25 | EML2322L-0025 | 1/4 in WASHER | 2
A1 | EML2322L-A-001 | MOBILE PLATFORM FRAME ASSEMBLY | 1
A2 | EML2322L-A-002 | WHEEL AND MOTOR ASSEMBLY | 2

TITLE:
PLATFORM WITH WHEELS ASSEMBLY
NAN LIN
DWG. NO.
SIZE

TOLERANCE UNLESS NOTED
DIMENSION
TYPE
LOCATIONAL

PLACES IN DIMENSION

SHEET 1 OF 1; TAPE MEASURE; TOLERANCE UNLESS NOTED; SCALE: 2:5

NOTES:
DIMS IN INCHES
QTY SPECIFIED IN BOM
3. DIM AND MAT'L SPECIFIED
BY MANUFACTURER
5 in CASTER WHEEL
MARK YEN
ARNOLD
DWG. NO.

PLACES IN DIMENSION

SCALE: 5:8; DIMS IN INCHES 2. QTY: 1

TITLE:
MOBILE PLATFORM FRAME ASSEMBLY
CATHERINE M. MARTINEZ
DWG. NO.
SIZE

TOLERANCE UNLESS NOTED
DIMENSION
TYPE
LOCATIONAL

PLACES IN DIMENSION

SCALE: 1:2; DIMS IN INCHES 2. QTY: 1

TITLE:
MOBILE PLATFORM FRAME ASSEMBLY
CATHERINE M. MARTINEZ
DWG. NO.
SIZE

TOLERANCE UNLESS NOTED
DIMENSION
TYPE
LOCATIONAL

PLACES IN DIMENSION

SCALE: 2:3; DIMS IN INCHES 2. QTY: 1

TITLE:
MOBILE PLATFORM FRAME ASSEMBLY
CATHERINE M. MARTINEZ
DWG. NO.
SIZE

TOLERANCE UNLESS NOTED
DIMENSION
TYPE
LOCATIONAL

PLACES IN DIMENSION

SCALE: 1:3; DIMS IN INCHES 2. QTY: 1

ITEM NO. | PART NUMBER | DESCRIPTION | QTY.
1 | EML2322L-0001 | 80/20 EXTRUSION - 7.0 in | 2
2 | EML2322L-0002 | 80/20 EXTRUSION - 12.5 in | 2
3 | EML2322L-0003 | 80/20 EXTRUSION - 3.0 in | 2
A10 | EML2322L-A-010 | 90-DEGREE BRACKET ASSEMBLY | 4
A11 | EML2322L-A-011 | STRAIGHT BRACKET ASSEMBLY | 8

TITLE:
MOBILE PLATFORM FRAME ASSEMBLY
CATHERINE M. MARTINEZ
DWG. NO.
SIZE

TOLERANCE UNLESS NOTED
DIMENSION
TYPE
LOCATIONAL

PLACES IN DIMENSION

SCALE: 2:3

NOTES:
DIMS IN INCHES
2. QTY: 2
WHEEL AND MOTOR ASSEMBLY
MARK YEN
DWG. NO.
SIZE

TOLERANCE UNLESS NOTED
DIMENSION
TYPE
LOCATIONAL

PLACES IN DIMENSION

DWG. NO.; MARK YEN MARK YEN; SCALE: 3:5; DIMS IN INCHES 2. QTY: 2

(6.8) WHEEL AND MOTOR ASSEMBLY

TOLERANCE UNLESS NOTED
DIMENSION
TYPE
LOCATIONAL

PLACES IN DIMENSION

SCALE: 7:11

NOTES:
DIMS IN INCHES
2. QTY: 2
WHEEL AND MOTOR ASSEMBLY
MARK YEN
DWG. NO.
SIZE

TOLERANCE UNLESS NOTED
DIMENSION
TYPE
LOCATIONAL

PLACES IN DIMENSION

SCALE: 1:3

ITEM NO. | PART NUMBER | DESCRIPTION | QTY.
8 | EML2322L-0008 | 44 RPM ENTSTORT RIGHT ANGLE MOTOR | 1
9 | EML2322L-0009 | ENTSTORT MOTOR MOUNT | 1
10 | EML2322L-0010 | M6 x 1 - 16 mm ENTSTORT SCREW | 3
11 | EML2322L-0011 | DRIVE WHEEL HUB | 1
12 | EML2322L-0012 | 10 in WHEEL | 1
13 | EML2322L-0013 | 10-24 x 1.25 in ROUND HEAD SCREW | 3
14 | EML2322L-0014 | M8 x 1.25 mm HEX NUT | 1

NOTES:
DIMS IN INCHES
2. QTY: 2
WHEEL AND MOTOR ASSEMBLY
MARK YEN
DWG. NO.
SIZE

TOLERANCE UNLESS NOTED
DIMENSION
TYPE
LOCATIONAL

PLACES IN DIMENSION

2.000 BOLT CIRCLE; M6 x 1.0 15mm; 3 Places; SHEET 1 OF 1; TAPE MEASURE; TOLERANCE UNLESS NOTED; SCALE: 1:2

NOTES:
1. DIMS IN
2. QTY SPECIFIED IN BOM
3. DIMS AND MAT'L SPECIFIED
BY MANUFACTURER

TITLE:
44 RPM ENTSTORT RIGHT ANGLE MOTOR
J. DERSCH
ENTSTORT
DWG. NO.

PLACES IN DIMENSION

0.266 THRU; 2 PLACES; 0.257 THRU; 3 PLACES; ( 2.000 BOLT CIRCLE); 0.5 THRU; SCALE: 1:1

NOTES:
1. QTY: 2
2. ALL DIMS IN INCHES
3. MATL: ALUMINUM
4. UNFINISHED SURFACES
UNLESS NOTED
5. BREAK ALL EDGES
TITLE:
ENTSTORT MOTOR MOUNT
MARK YEN
DWG. NO.

TOLERANCE UNLESS NOTED
OPERATION
MACHINING
CUT OFF (SAW,
BURN, SHEAR)
WELDING
ANGULAR DIMS

PLACES IN DIMENSION

0.157 THRU; 10-24 UNC THRU; 3 PLACES <120 APART>; 0.331 (8.4mm) THRU; 0.001 (10mm) 0.40 DEEP;; BORE OPP SIDE; 0.75 0.90 DEEP; 1.500 BOLT CIRCLE; SECTION A-A; FINISH TURN; SCALE: 3:2

NOTES:
1. QTY: 2
2. ALL DIMS IN INCHES
3. MATL: ALUMINUM
4. FINISH NOTED SURFACE(S)
5. BREAK ALL EDGES
TITLE:
DRIVE WHEEL HUB
MARK YEN
DWG. NO.

TOLERANCE UNLESS NOTED
OPERATION
MACHINING
CUT OFF (SAW,
BURN, SHEAR)
WELDING
ANGULAR DIMS

PLACES IN DIMENSION

6 PLACES; 0.196 THRU;; 3 PLACES; 10 in WHEEL; SHEET 1 OF 2; DWG. NO.; J. DERSCH; TAPE MEASURE; TOLERANCE UNLESS NOTED; SCALE: 1:4

3 PLACES 1.500 BOLT CIRCLE

NOTES:
1. DIMS IN
2. QTY SPECIFIED IN BOM
3. DIMS AND MAT'L SPECIFIED
BY MANUFACTURER

PLACES IN DIMENSION

SECTION B-B; 10 in WHEEL; SHEET 2 OF 2; DWG. NO.; J. DERSCH; TAPE MEASURE; TOLERANCE UNLESS NOTED; SCALE: 1:4

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

PLACES IN DIMENSION
