markyen001/DR4/Drawings for PRINT/11  BM Drawings GLOBE MOUNT.PDF

SHEET 16 OF 18; TOLERANCE UNLESS NOTED; SCALE: 1:2; DIMS IN INCHES 2. QTY: 2

TITLE:
GLOBE MOTOR BRACKET ASSEMBLY
ALLEN ZHOU
DWG. NO.
SIZE

PLACES IN DIMENSION

SOLIDWORKS Educational Product. For Instructional Use Only.

SCALE: 2:1; QTY: 2 2. DIMS IN INCHES

TITLE:
GLOBE MOTOR BRACKET ASSEMBLY
ALLEN ZHOU
DWG. NO.
SIZE

TOLERANCE UNLESS NOTED
DIMENSION
TYPE
LOCATIONAL

PLACES IN DIMENSION

SCALE: 1:2; DIMS IN INCHES 2. QTY: 2

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

TITLE:
GLOBE MOTOR BRACKET ASSEMBLY
ALLEN ZHOU
DWG. NO.
SIZE

TOLERANCE UNLESS NOTED
DIMENSION
TYPE
LOCATIONAL

PLACES IN DIMENSION
