markyen001/DR4/Drawings for PRINT/3  BM Drawings ARM CHANNEL.PDF

BALL MANIPULATOR CHANNEL; SHEET 5 OF 18; DWG. NO.; ALLEN ZHOU ALLEN ZHOU; SCALE: 1:2; FOLDED VIEW; QTY: 1 DIMS IN INCHES BREAK ALL EDGES; MATL: 20GA STEEL; UNFINISHED SURFACES

TOLERANCE UNLESS NOTED
OPERATION
MACHINING
SHEETMETAL
(SHEAR, BEND)
WELDING
ANGULAR DIMS

PLACES IN DIMENSION

SOLIDWORKS Educational Product. For Instructional Use Only.

0.266 THRU 2 PLACES; BALL MANIPULATOR CHANNEL; DWG. NO.; ALLEN ZHOU ALLEN ZHOU; SCALE: 1:2.5; UNFOLDED VIEW; QTY: 1; BREAK ALL EDGES; MATL: 20GA STEEL DIMS IN INCHES

FINISH NO SURFACE

TOLERANCE UNLESS NOTED
OPERATION
MACHINING
SHEETMETAL
(SHEAR, BEND)
WELDING

PLACES IN DIMENSION

BALL MANIPULATOR CHANNEL; DWG. NO.; ALLEN ZHOU ALLEN ZHOU; FOLDED VIEW; QTY: 1 DIMS IN INCHES BREAK ALL EDGES; MATL: 20GA STEEL; UNFINISHED SURFACES

TOLERANCE UNLESS NOTED
OPERATION
MACHINING
SHEETMETAL
(SHEAR, BEND)
WELDING

PLACES IN DIMENSION

0.266 THRU 2 PLACES; BALL MANIPULATOR CHANNEL; DWG. NO.; ALLEN ZHOU ALLEN ZHOU; UNFOLDED VIEW; QTY: 1; BREAK ALL EDGES; MATL: 20GA STEEL DIMS IN INCHES

FINISH NO SURFACE

TOLERANCE UNLESS NOTED
OPERATION
MACHINING
SHEETMETAL
(SHEAR, BEND)
WELDING

PLACES IN DIMENSION
