markyen001/DR4/Drawings for PRINT/8  linear actuator mount.PDF

10-24 UNC THRU;; 0.275 THRU; 2 PLACES; 2 PLACES; 0.251 THRU; 0.404 0.153; SHEET 1 OF 1; SCALE: 1:1

NOTES:
ALL DIMS IN INCHES
QTY SPECIFIED IN BOM
MAT'L: ALUMINUM

TOLERANCE UNLESS NOTED
OPERATION
MACHINING
CUT OFF (SAW,
BURN, SHEAR)
WELDING
ANGULAR DIMS

TITLE:
10-24 LINEAR ACTUATOR MOUNT
T. THORNTON
CONCENTRIC INTERNATIONAL
DWG. NO.

PLACES IN DIMENSION

SOLIDWORKS Educational Product. For Instructional Use Only.
