markyen001/DR4/Wiring Schematic/Wiring Schematic.PDF

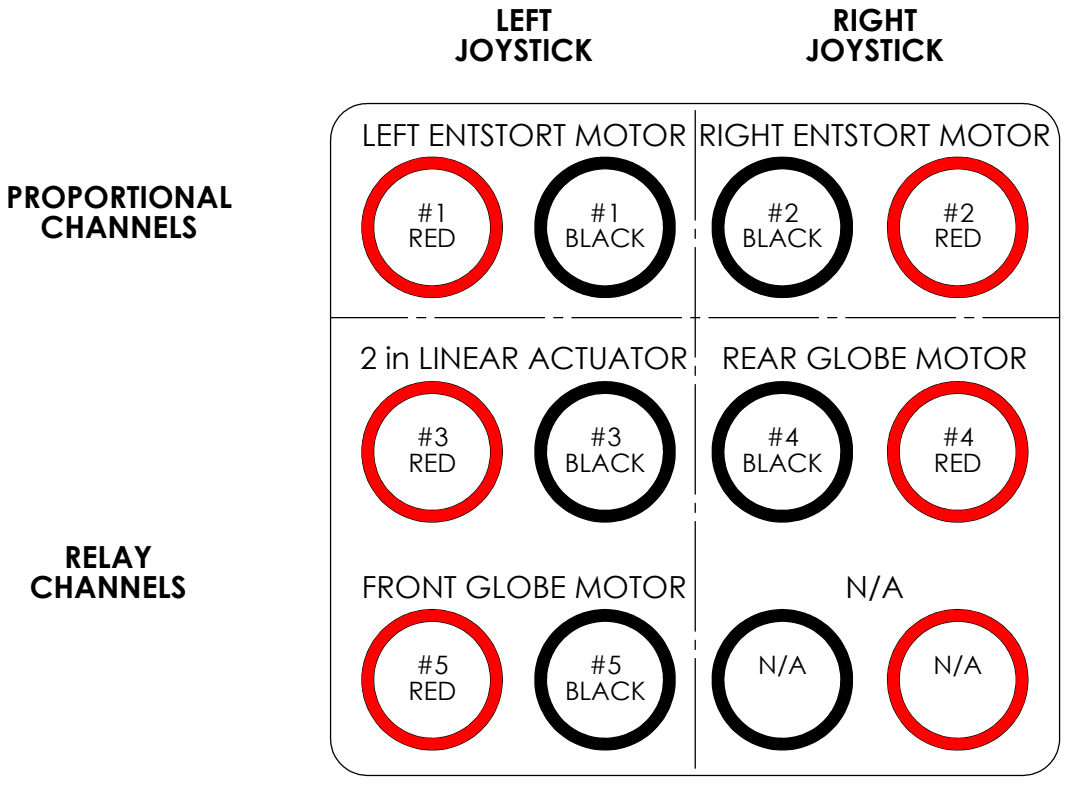
[picture p153: page 1]
2 in LINEAR ACTUATOR; REAR GLOBE MOTOR; FRONT GLOBE MOTOR; EML2322L Wiring schematic; SHEET 1 OF 1; DWG. NO.; MARK YEN ALLEN ZHOU; SCALE: N/A

LEFT ENTSTORT MOTOR RIGHT ENTSTORT MOTOR

SOLIDWORKS Educational Product. For Instructional Use Only.
