markyen001/DR4/Drawings Resulted from ECNs/ECN 16 - REV E - BALL HOPPER.PDF

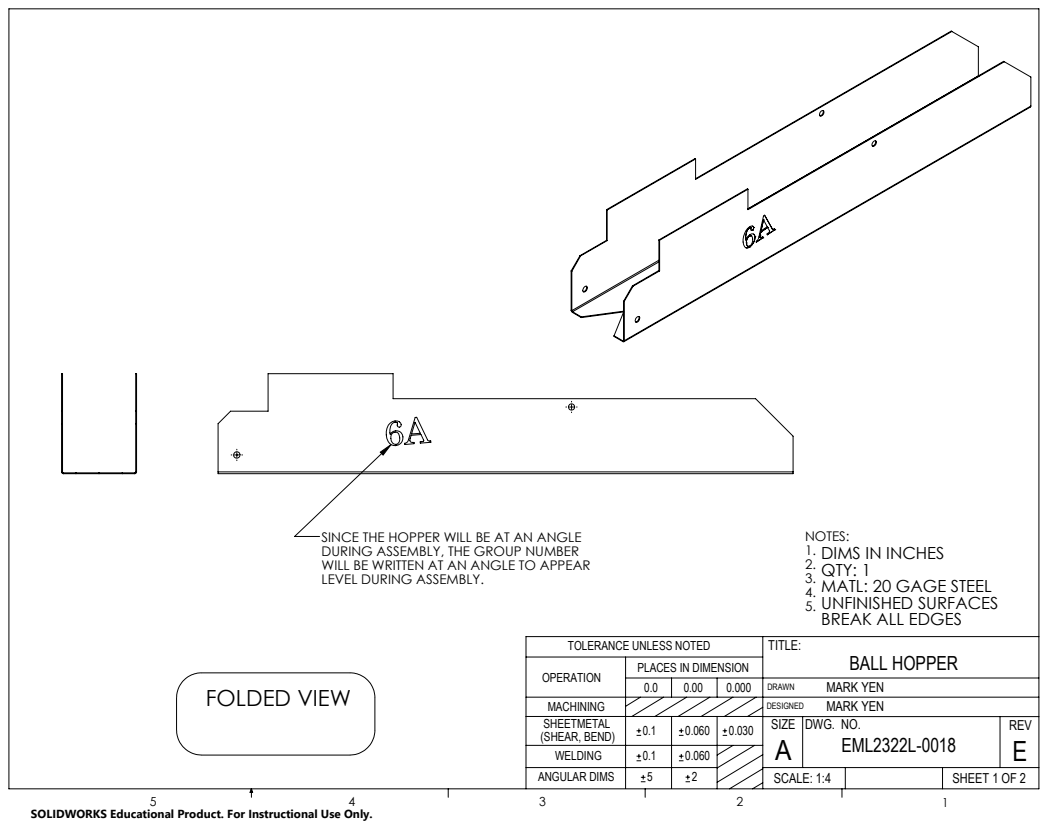
[picture p154: page 1]
BALL HOPPER; SHEET 1 OF 2; DWG. NO.; MARK YEN MARK YEN; SCALE: 1:4; FOLDED VIEW; DIMS IN INCHES MATL: 20 GAGE STEEL UNFINISHED SURFACES; QTY: 1; BREAK ALL EDGES

SINCE THE HOPPER WILL BE AT AN ANGLE
DURING ASSEMBLY, THE GROUP NUMBER
WILL BE WRITTEN AT AN ANGLE TO APPEAR
LEVEL DURING ASSEMBLY.

TOLERANCE UNLESS NOTED
OPERATION
MACHINING
SHEETMETAL
(SHEAR, BEND)
WELDING
ANGULAR DIMS

PLACES IN DIMENSION

SOLIDWORKS Educational Product. For Instructional Use Only.

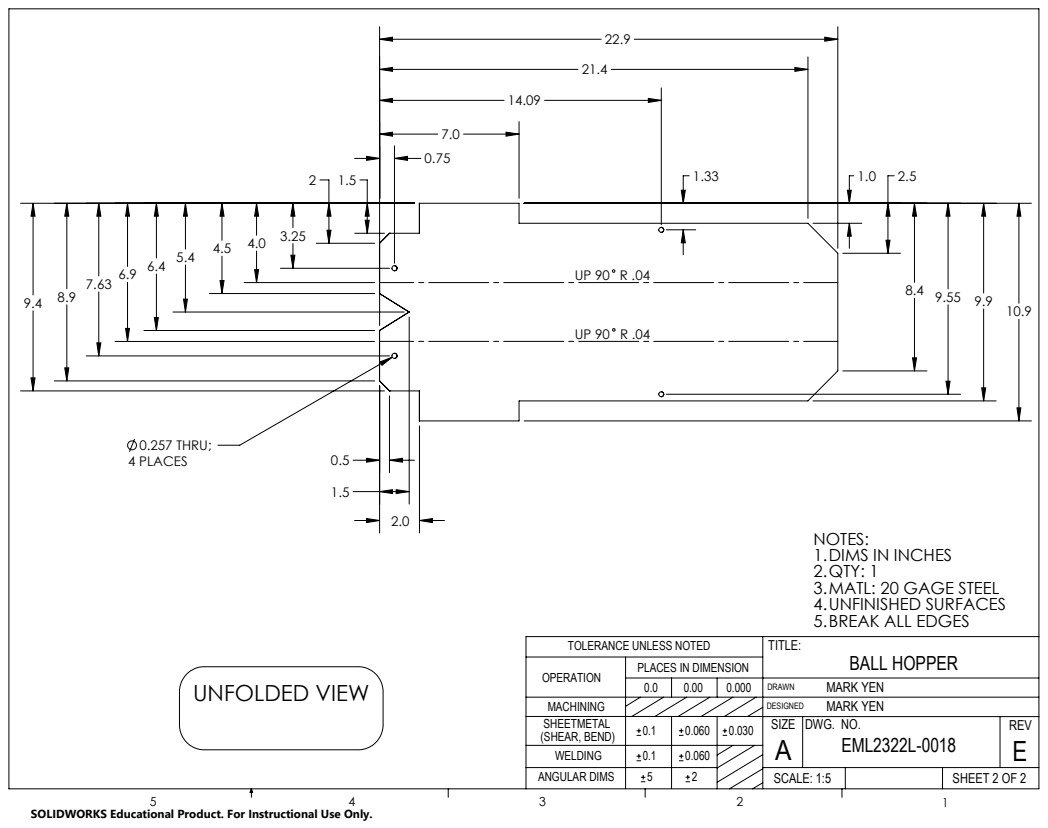
[picture p155: page 2]
0.257 THRU; 4 PLACES; BALL HOPPER; SHEET 2 OF 2; DWG. NO.; MARK YEN MARK YEN; SCALE: 1:5; UNFOLDED VIEW; DIMS IN INCHES; UNFINISHED SURFACES BREAK ALL EDGES; QTY: 1 MATL: 20 GAGE STEEL

TOLERANCE UNLESS NOTED
OPERATION
MACHINING
SHEETMETAL
(SHEAR, BEND)
WELDING
ANGULAR DIMS

PLACES IN DIMENSION

SOLIDWORKS Educational Product. For Instructional Use Only.
