markyen001/DR4/Drawings Resulted from ECNs/ECN 15 - REV E - ARM CHANNEL.PDF

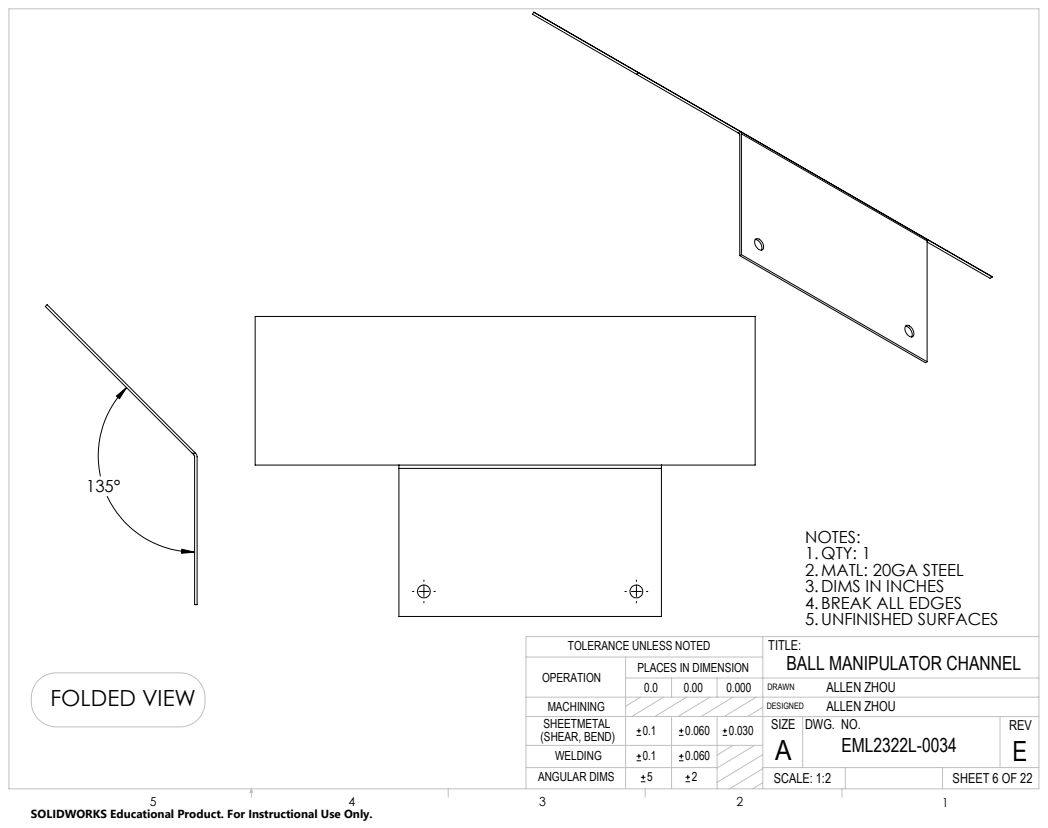
[picture p156: page 1]
BALL MANIPULATOR CHANNEL; SHEET 6 OF 22; DWG. NO.; ALLEN ZHOU ALLEN ZHOU; SCALE: 1:2; FOLDED VIEW; QTY: 1 DIMS IN INCHES BREAK ALL EDGES; MATL: 20GA STEEL; UNFINISHED SURFACES

TOLERANCE UNLESS NOTED
OPERATION
MACHINING
SHEETMETAL
(SHEAR, BEND)
WELDING
ANGULAR DIMS

PLACES IN DIMENSION

SOLIDWORKS Educational Product. For Instructional Use Only.

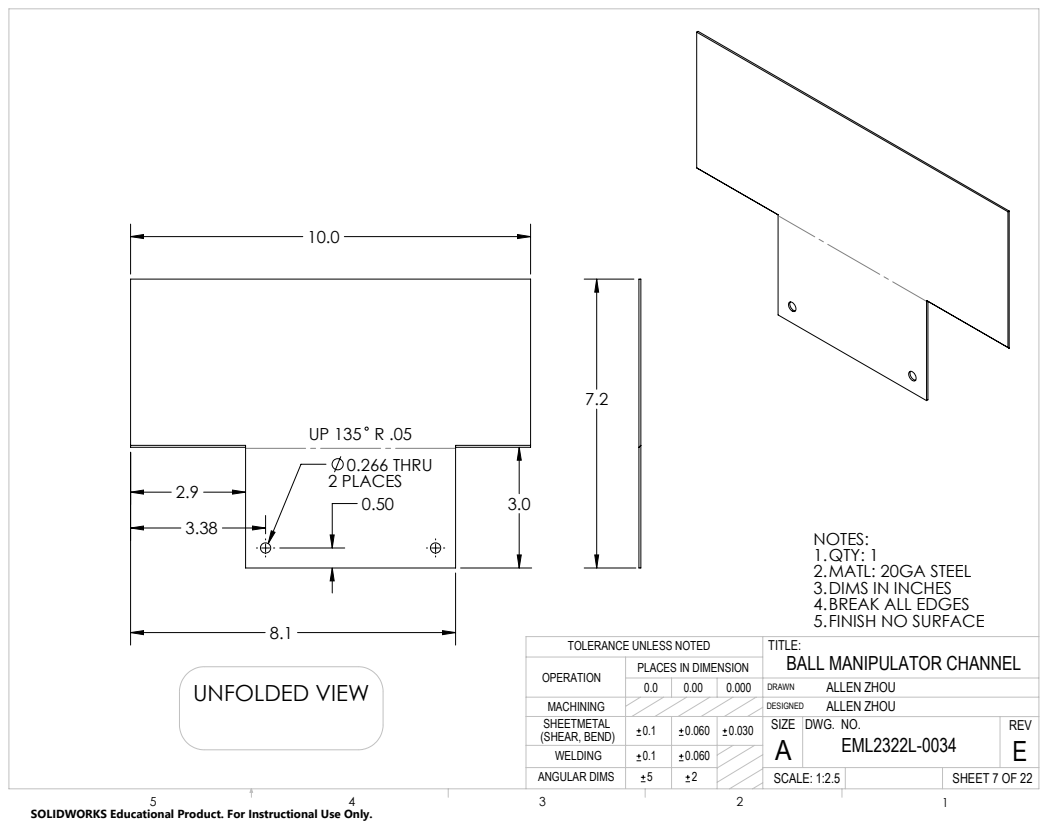
[picture p157: page 2]
0.266 THRU 2 PLACES; BALL MANIPULATOR CHANNEL; DWG. NO.; ALLEN ZHOU ALLEN ZHOU; SCALE: 1:2.5; UNFOLDED VIEW; QTY: 1; BREAK ALL EDGES; MATL: 20GA STEEL DIMS IN INCHES

FINISH NO SURFACE

TOLERANCE UNLESS NOTED
OPERATION
MACHINING
SHEETMETAL
(SHEAR, BEND)
WELDING

PLACES IN DIMENSION

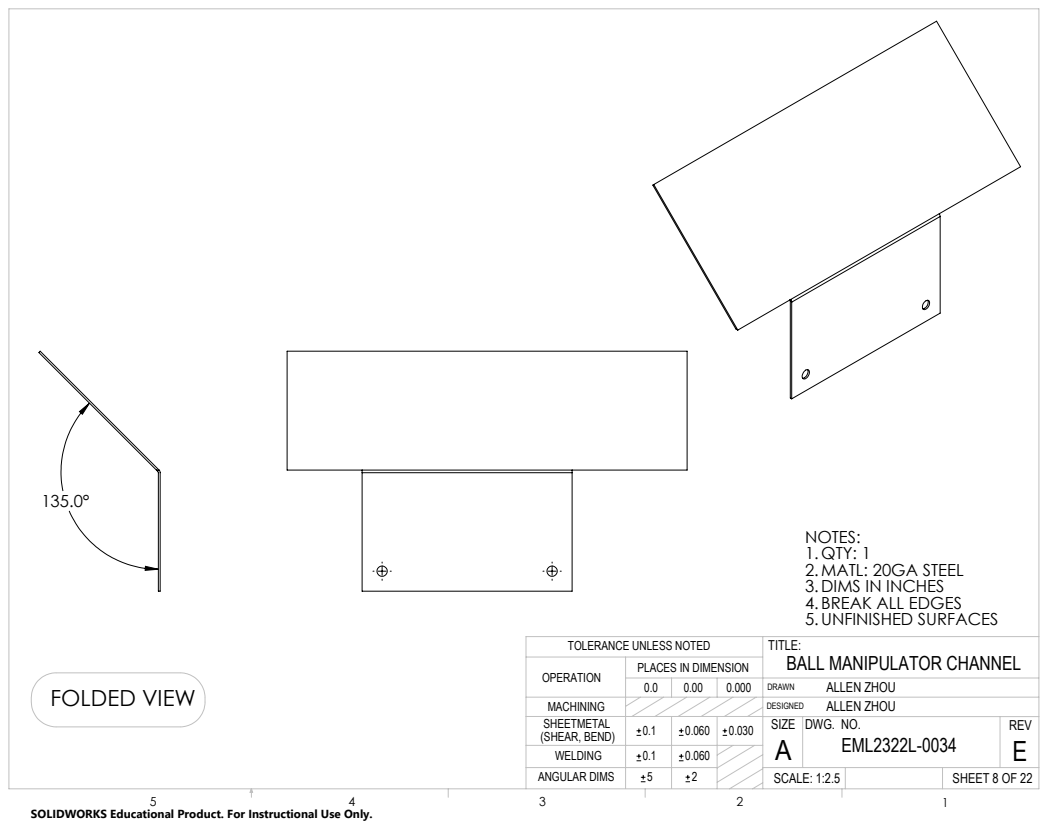
[picture p158: page 3]
BALL MANIPULATOR CHANNEL; DWG. NO.; ALLEN ZHOU ALLEN ZHOU; FOLDED VIEW; QTY: 1 DIMS IN INCHES BREAK ALL EDGES; MATL: 20GA STEEL; UNFINISHED SURFACES

TOLERANCE UNLESS NOTED
OPERATION
MACHINING
SHEETMETAL
(SHEAR, BEND)
WELDING

PLACES IN DIMENSION

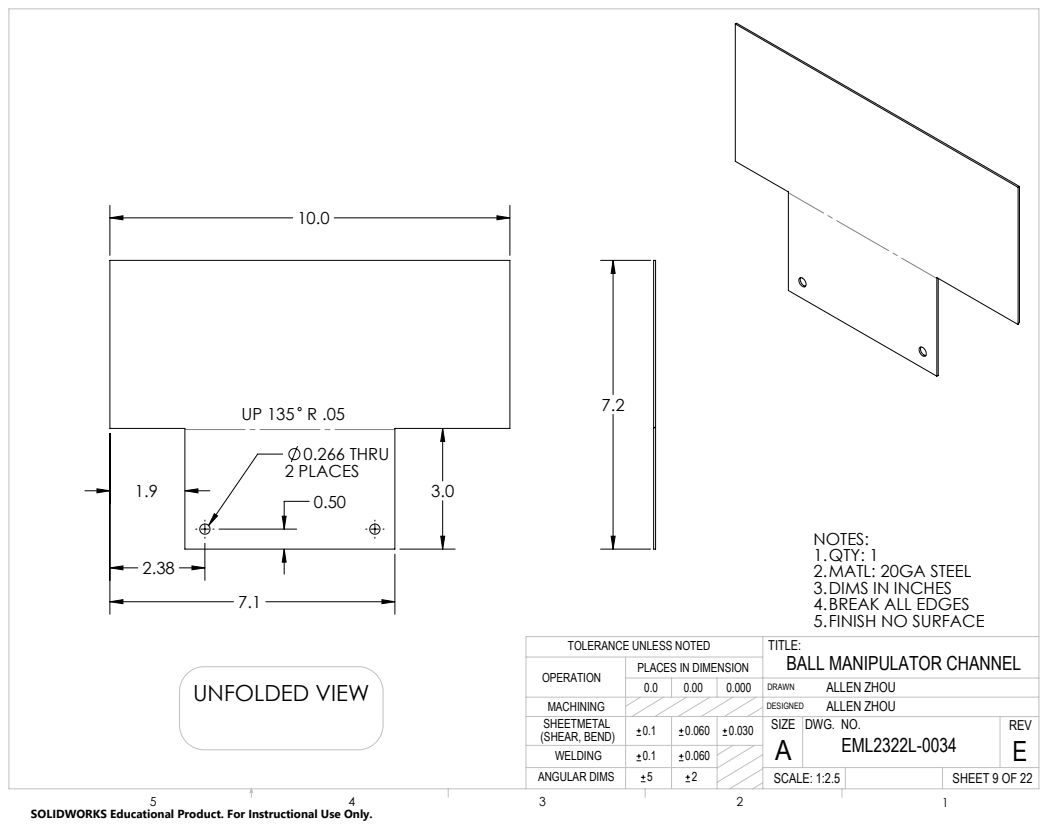
[picture p159: page 4]
0.266 THRU 2 PLACES; BALL MANIPULATOR CHANNEL; DWG. NO.; ALLEN ZHOU ALLEN ZHOU; UNFOLDED VIEW; QTY: 1; BREAK ALL EDGES; MATL: 20GA STEEL DIMS IN INCHES

FINISH NO SURFACE

TOLERANCE UNLESS NOTED
OPERATION
MACHINING
SHEETMETAL
(SHEAR, BEND)
WELDING

PLACES IN DIMENSION
