markyen001/DR4/Drawings Resulted from ECNs/ECN 10 - REV B - 4.5 in AL TUBE.PDF

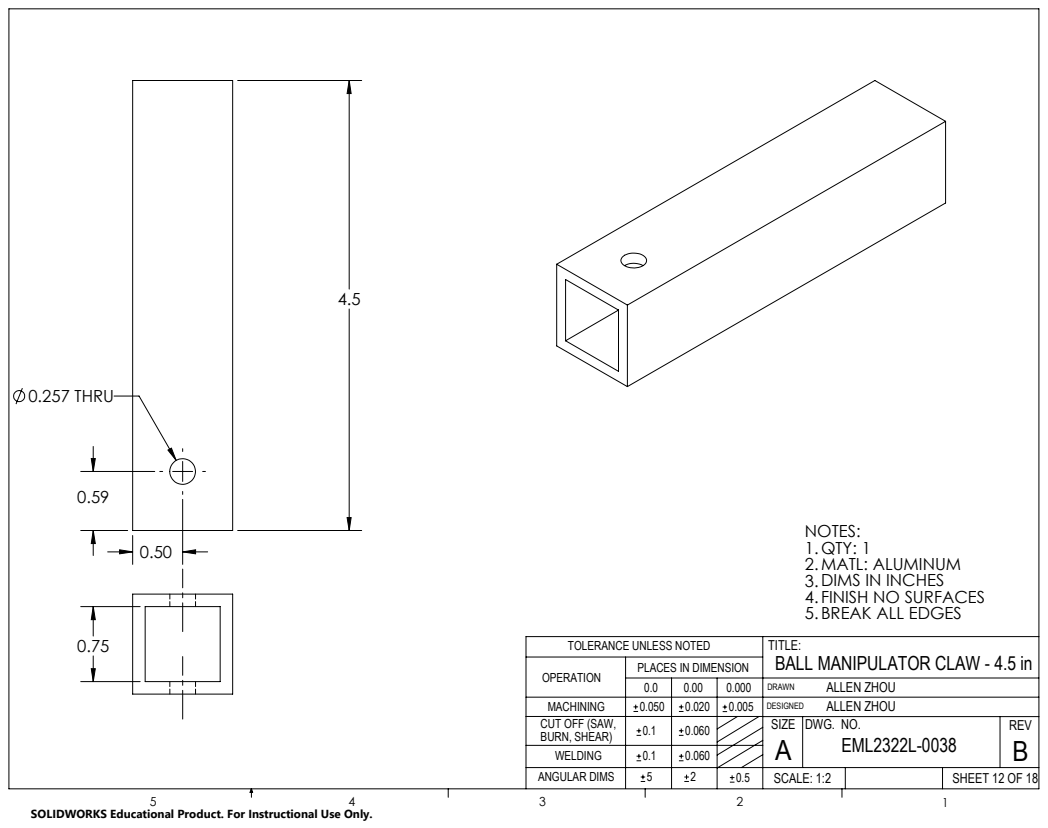
[picture p160: page 1]
0.257 THRU; SHEET 12 OF 18; SCALE: 1:2

NOTES:
QTY: 1
MATL: ALUMINUM
DIMS IN INCHES
FINISH NO SURFACES
BREAK ALL EDGES
TITLE:
BALL MANIPULATOR CLAW - 4.5 in
ALLEN ZHOU
DWG. NO.

TOLERANCE UNLESS NOTED
OPERATION
MACHINING
CUT OFF (SAW,
BURN, SHEAR)
WELDING
ANGULAR DIMS

PLACES IN DIMENSION

SOLIDWORKS Educational Product. For Instructional Use Only.
