markyen001/DR4/Drawings Resulted from ECNs/ECN 11 - REV B - 11-inch AL tube - no motor hole.PDF

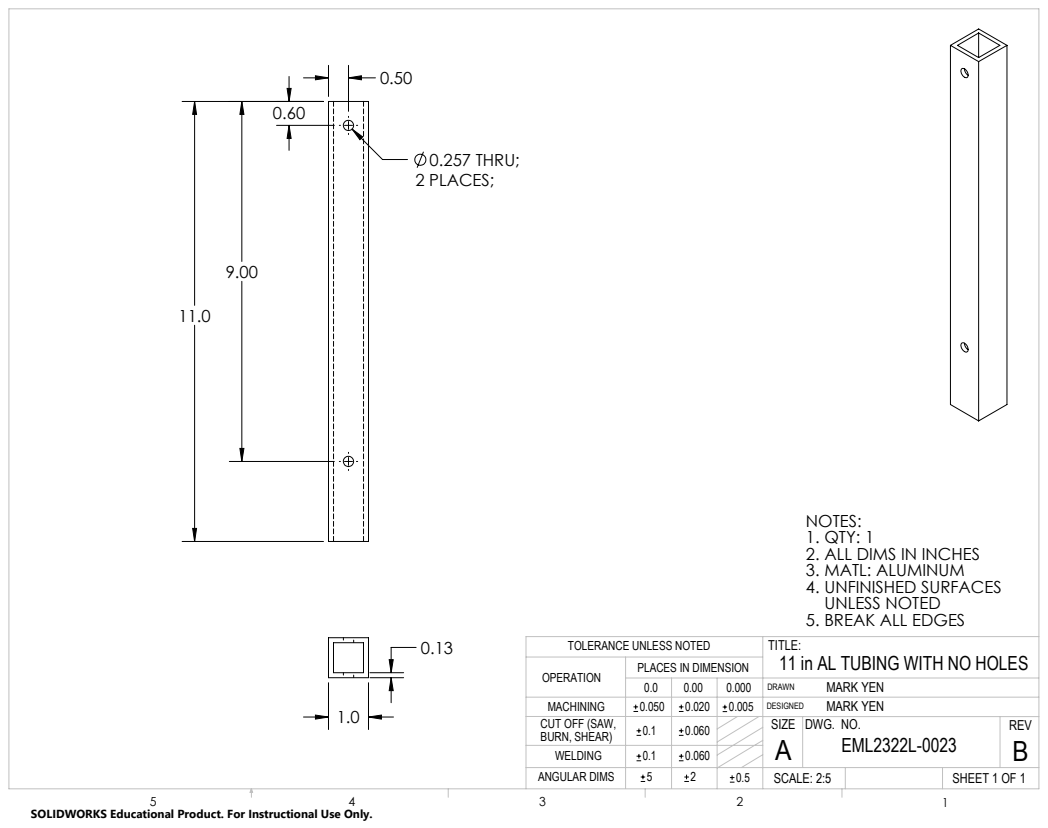
[picture p162: page 1]
0.257 THRU; 2 PLACES;; SHEET 1 OF 1; SCALE: 2:5

NOTES:
1. QTY: 1
2. ALL DIMS IN INCHES
3. MATL: ALUMINUM
4. UNFINISHED SURFACES
UNLESS NOTED
5. BREAK ALL EDGES
TITLE:
11 in AL TUBING WITH NO HOLES
MARK YEN
DWG. NO.

TOLERANCE UNLESS NOTED
OPERATION
MACHINING
CUT OFF (SAW,
BURN, SHEAR)
WELDING
ANGULAR DIMS

PLACES IN DIMENSION

SOLIDWORKS Educational Product. For Instructional Use Only.
