markyen001/DR4/Drawings Resulted from ECNs/ECN 1 - REV C - ARM CHANNEL.pdf

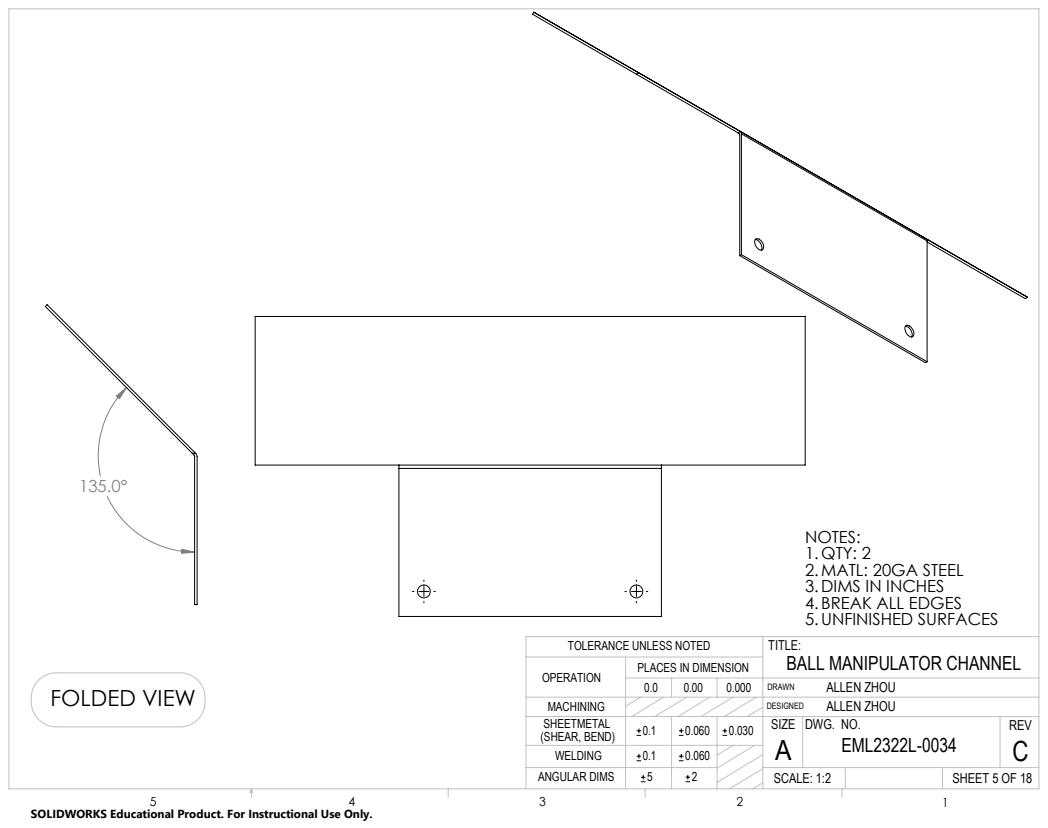
[picture p163: page 1]
BALL MANIPULATOR CHANNEL; SHEET 5 OF 18; DWG. NO.; ALLEN ZHOU ALLEN ZHOU; SCALE: 1:2; FOLDED VIEW; QTY: 2 DIMS IN INCHES BREAK ALL EDGES; MATL: 20GA STEEL; UNFINISHED SURFACES

TOLERANCE UNLESS NOTED
OPERATION
MACHINING
SHEETMETAL
(SHEAR, BEND)
WELDING
ANGULAR DIMS

PLACES IN DIMENSION

SOLIDWORKS Educational Product. For Instructional Use Only.

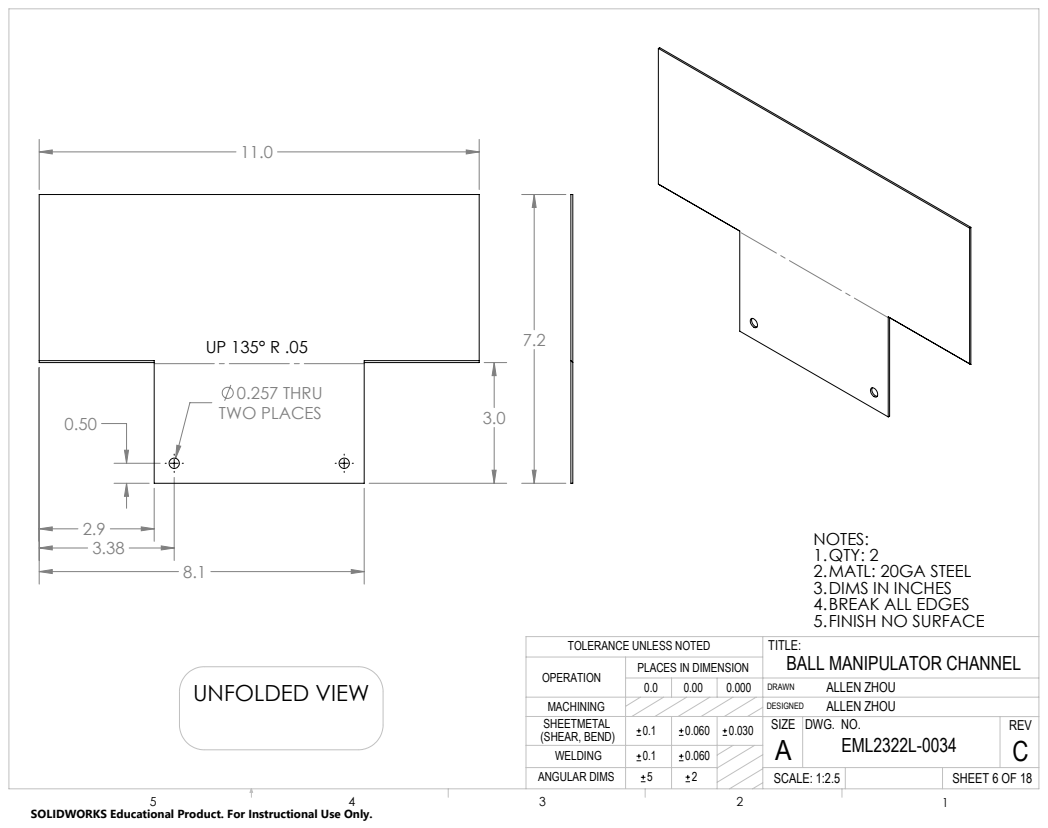
[picture p164: page 2]
0.257 THRU; TWO PLACES; BALL MANIPULATOR CHANNEL; SHEET 6 OF 18; DWG. NO.; ALLEN ZHOU ALLEN ZHOU; SCALE: 1:2.5; UNFOLDED VIEW; QTY: 2; BREAK ALL EDGES; MATL: 20GA STEEL DIMS IN INCHES

FINISH NO SURFACE

TOLERANCE UNLESS NOTED
OPERATION
MACHINING
SHEETMETAL
(SHEAR, BEND)
WELDING
ANGULAR DIMS

PLACES IN DIMENSION

SOLIDWORKS Educational Product. For Instructional Use Only.
