markyen001/DR4/Drawings Resulted from ECNs/ECN 5 - REV B - BALL HOPPER.PDF

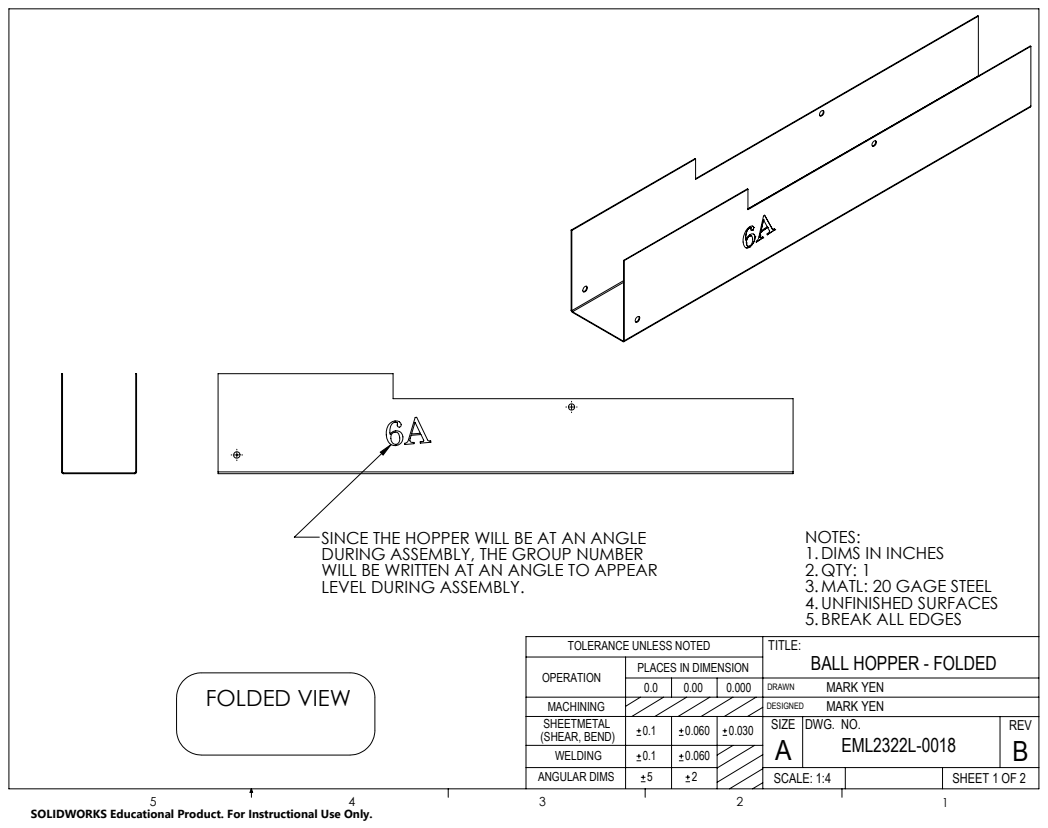
[picture p165: page 1]
BALL HOPPER - FOLDED; SHEET 1 OF 2; DWG. NO.; MARK YEN MARK YEN; SCALE: 1:4; FOLDED VIEW; DIMS IN INCHES MATL: 20 GAGE STEEL UNFINISHED SURFACES; QTY: 1

SINCE THE HOPPER WILL BE AT AN ANGLE
DURING ASSEMBLY, THE GROUP NUMBER
WILL BE WRITTEN AT AN ANGLE TO APPEAR
LEVEL DURING ASSEMBLY.

BREAK ALL EDGES

TOLERANCE UNLESS NOTED
OPERATION
MACHINING
SHEETMETAL
(SHEAR, BEND)
WELDING
ANGULAR DIMS

PLACES IN DIMENSION

SOLIDWORKS Educational Product. For Instructional Use Only.

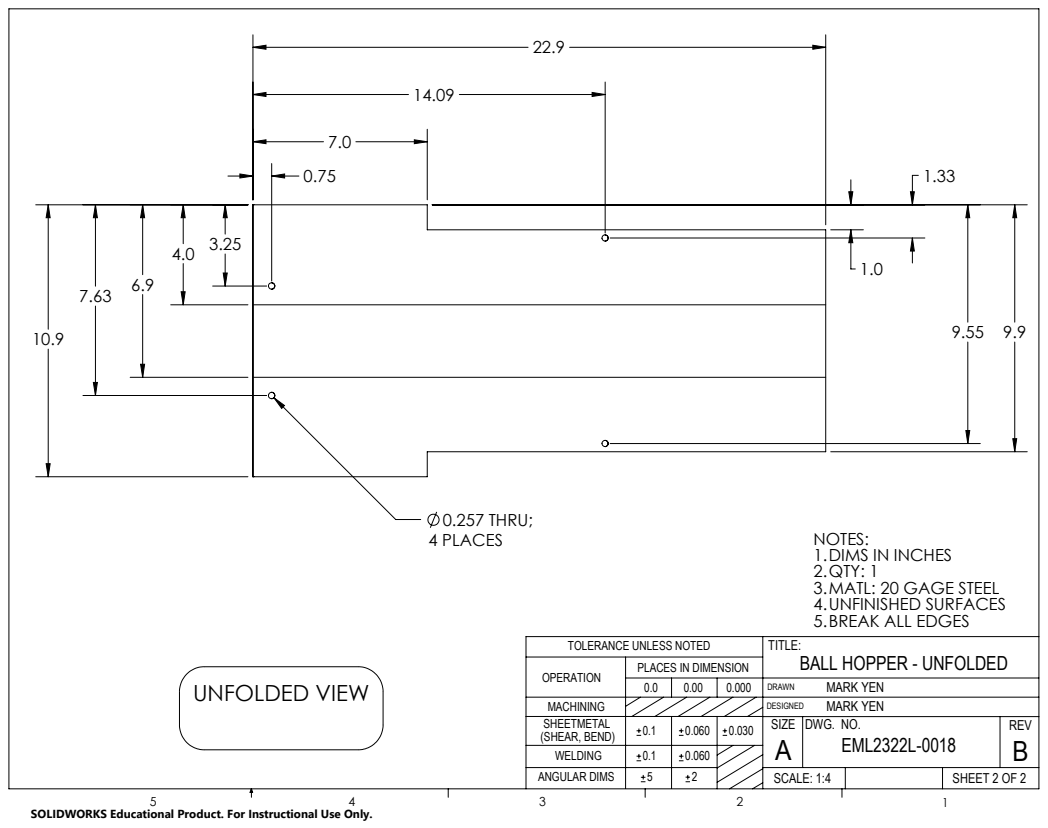
[picture p166: page 2]
0.257 THRU; 4 PLACES; SHEET 2 OF 2; SCALE: 1:4; UNFOLDED VIEW

NOTES:
DIMS IN INCHES
QTY: 1
MATL: 20 GAGE STEEL
UNFINISHED SURFACES
BREAK ALL EDGES
BALL HOPPER - UNFOLDED
MARK YEN
SIZE
DWG. NO.

TOLERANCE UNLESS NOTED
OPERATION
MACHINING
SHEETMETAL
(SHEAR, BEND)
WELDING
ANGULAR DIMS

PLACES IN DIMENSION

SOLIDWORKS Educational Product. For Instructional Use Only.
