markyen001/DR4/Drawings Resulted from ECNs/ECN 3 - REV A - BUCKET MOTOR HUB.PDF

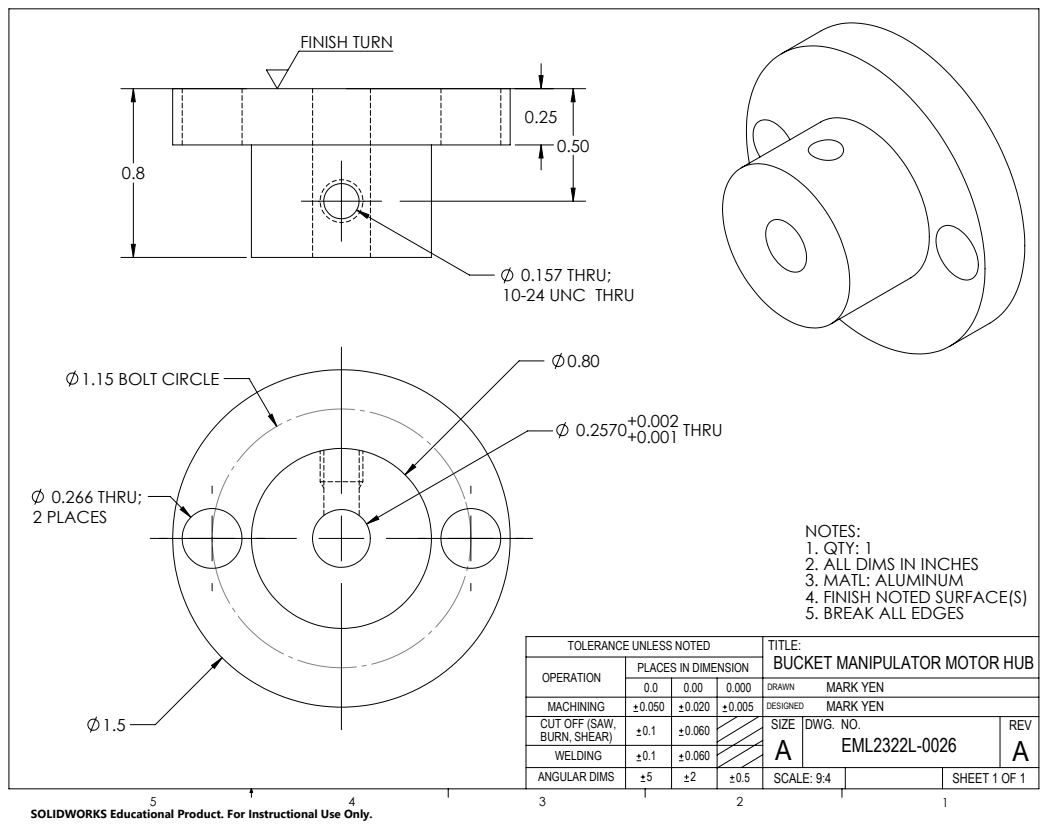
[picture p169: page 1]
0.001 THRU; 0.266 THRU; 2 PLACES; 1.15 BOLT CIRCLE; 0.157 THRU; 10-24 UNC THRU; FINISH TURN; SHEET 1 OF 1; SCALE: 9:4

NOTES:
1. QTY: 1
2. ALL DIMS IN INCHES
3. MATL: ALUMINUM
4. FINISH NOTED SURFACE(S)
5. BREAK ALL EDGES
TITLE:
BUCKET MANIPULATOR MOTOR HUB
MARK YEN
DWG. NO.

TOLERANCE UNLESS NOTED
OPERATION
MACHINING
CUT OFF (SAW,
BURN, SHEAR)
WELDING
ANGULAR DIMS

PLACES IN DIMENSION

SOLIDWORKS Educational Product. For Instructional Use Only.
