markyen001/DR4/Drawings Resulted from ECNs/ECN 3 - REV A - BUCKET MOTOR MOUNT.PDF

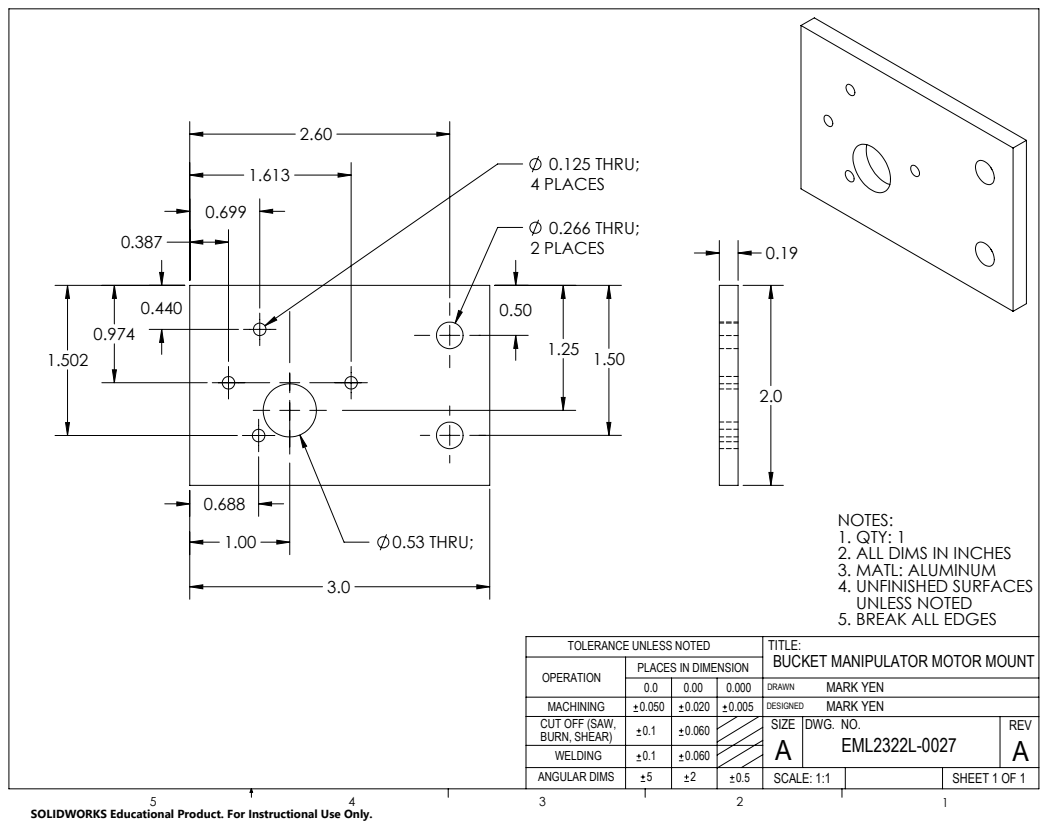
[picture p170: page 1]
0.125 THRU; 4 PLACES; 0.266 THRU; 2 PLACES; 0.53 THRU;; SHEET 1 OF 1; SCALE: 1:1

NOTES:
1. QTY: 1
2. ALL DIMS IN INCHES
3. MATL: ALUMINUM
4. UNFINISHED SURFACES
UNLESS NOTED
5. BREAK ALL EDGES
BUCKET MANIPULATOR MOTOR MOUNT
MARK YEN
DWG. NO.

TOLERANCE UNLESS NOTED
OPERATION
MACHINING
CUT OFF (SAW,
BURN, SHEAR)
WELDING
ANGULAR DIMS

PLACES IN DIMENSION

SOLIDWORKS Educational Product. For Instructional Use Only.
