markyen001/DR4/Drawings Resulted from ECNs/ECN 4 - REV A - SEI MOTOR.PDF

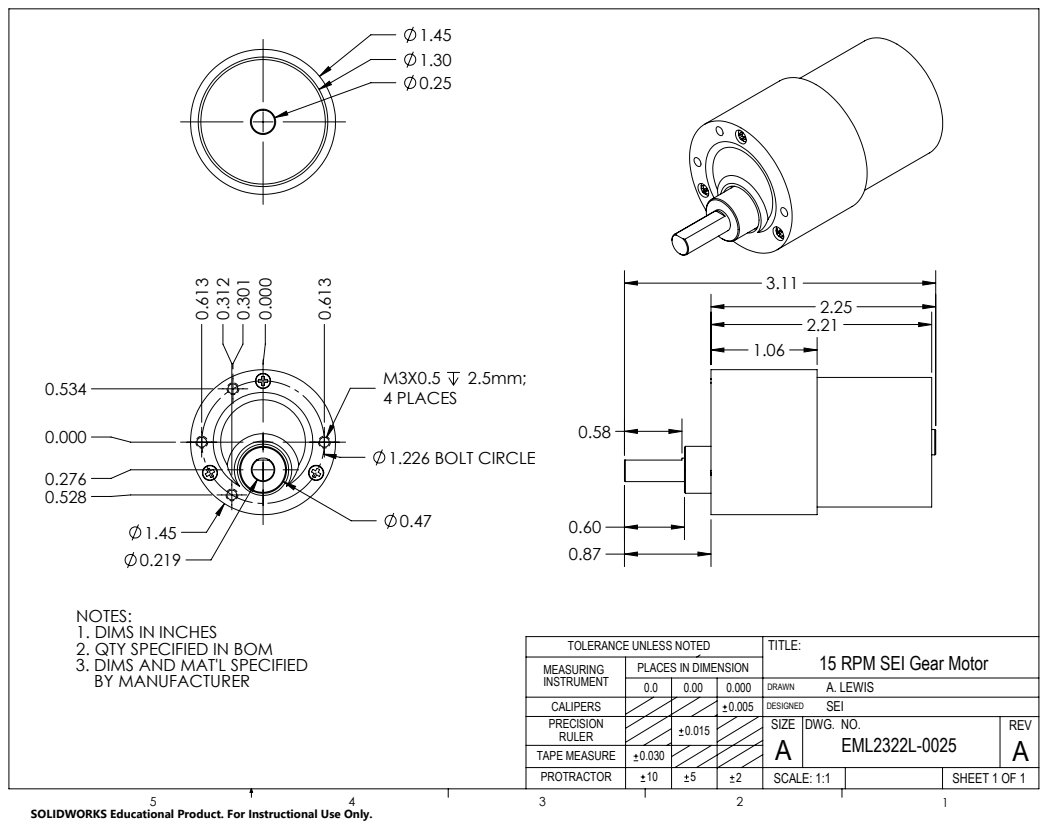
[picture p171: page 1]
M3X0.5 2.5mm; 4 PLACES; 1.226 BOLT CIRCLE; SHEET 1 OF 1; TAPE MEASURE; TOLERANCE UNLESS NOTED; SCALE: 1:1

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

TITLE:
15 RPM SEI Gear Motor
A. LEWIS
SEI
DWG. NO.

PLACES IN DIMENSION

SOLIDWORKS Educational Product. For Instructional Use Only.
