markyen001/DR4/Globe Motor Drawings/4.5 RPM Globe Gear Motor Specs.pdf

## 4.5 RPM Double Reduction Globe Motor

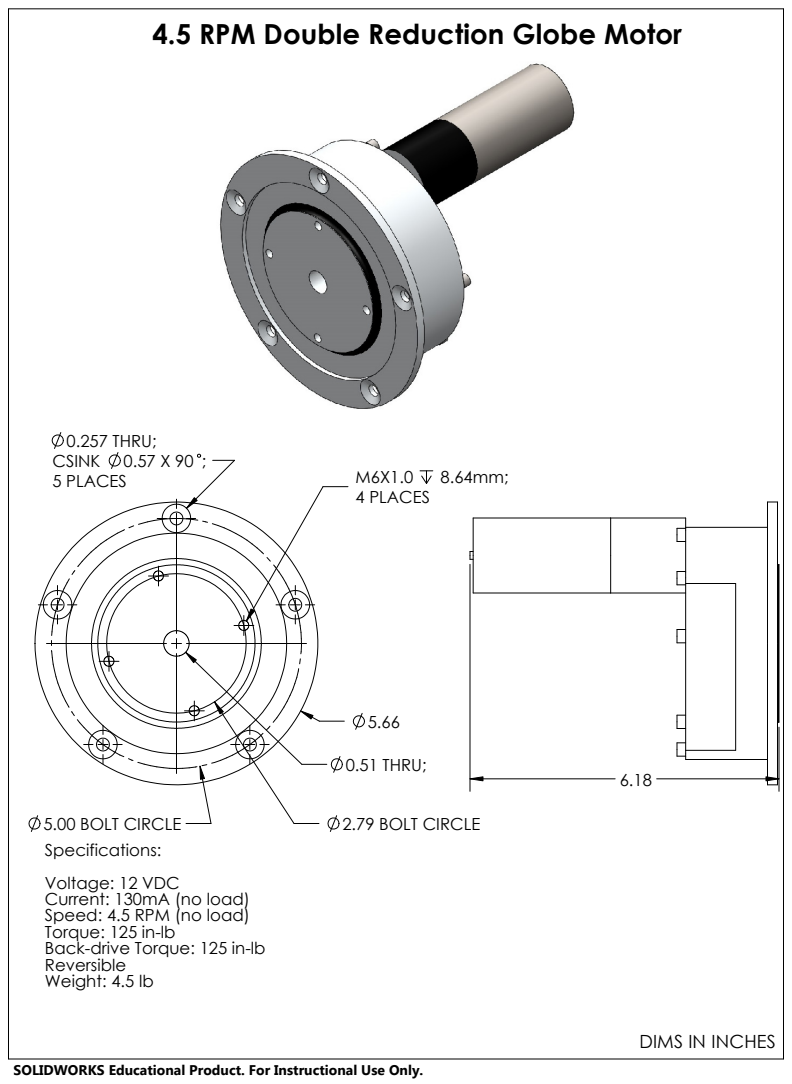
[picture p172: page 1]
5.00 BOLT CIRCLE; 2.79 BOLT CIRCLE; Specifications:; 5 PLACES; 0.51 THRU;; 0.257 THRU; CSINK; 4 PLACES

Voltage: 12 VDC
Current: 130mA (no load)
Speed: 4.5 RPM (no load)
Torque: 125 in-lb
Back-drive Torque: 125 in-lb
Reversible
Weight: 4.5 lb

DIMS IN INCHES

SOLIDWORKS Educational Product. For Instructional Use Only.
