markyen001/DR4/Drawings Resulted from ECNs/ECN 3 - REV B - 8020 EXTRUDE.PDF

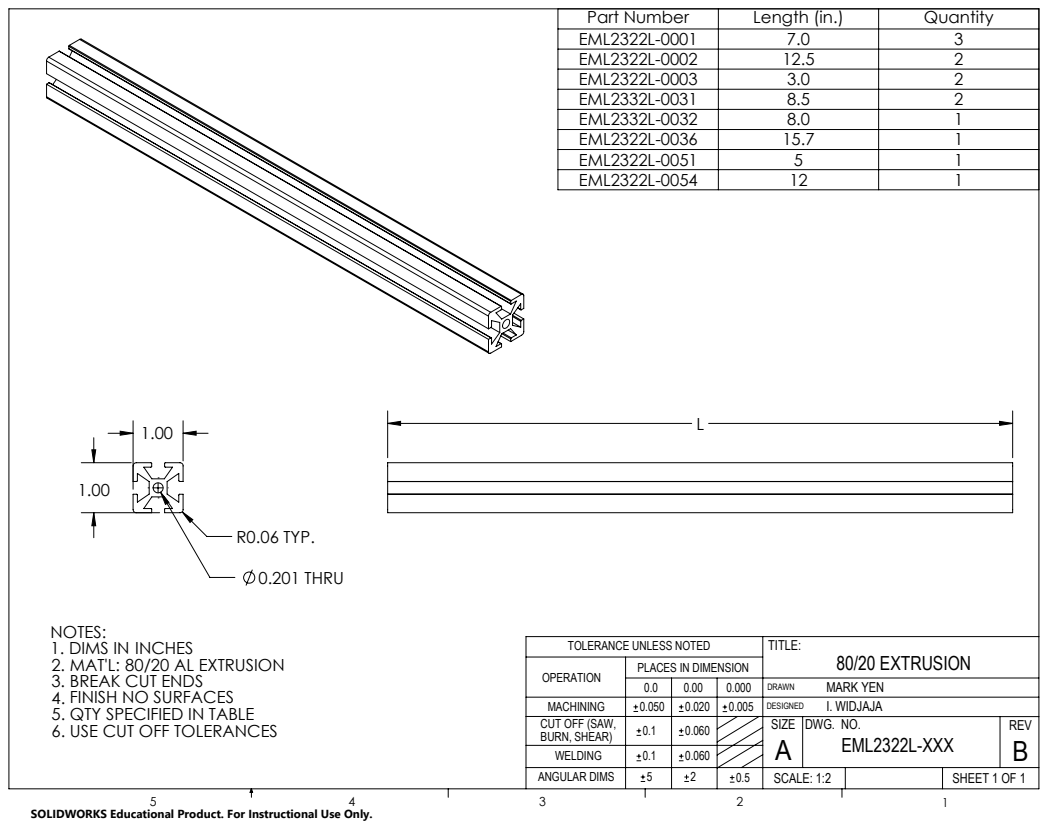
[picture p173: page 1]
R0.06 TYP.; 0.201 THRU; 80/20 EXTRUSION; SHEET 1 OF 1; DWG. NO.; MARK YEN I. WIDJAJA; SCALE: 1:2

Part Number | Length (in.) | Quantity
EML2322L-0001 | 7.0 | 3
EML2322L-0002 | 12.5 | 2
EML2322L-0003 | 3.0 | 2
EML2332L-0031 | 8.5 | 2
EML2332L-0032 | 8.0 | 1
EML2322L-0036 | 15.7 | 1
EML2322L-0051 | 5 | 1
EML2322L-0054 | 12 | 1

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

TOLERANCE UNLESS NOTED
OPERATION
MACHINING
CUT OFF (SAW,
BURN, SHEAR)
WELDING
ANGULAR DIMS

PLACES IN DIMENSION

SOLIDWORKS Educational Product. For Instructional Use Only.
