markyen001/DR4/Drawings Resulted from ECNs/ECN 3 - REV B - AL TUBE.PDF

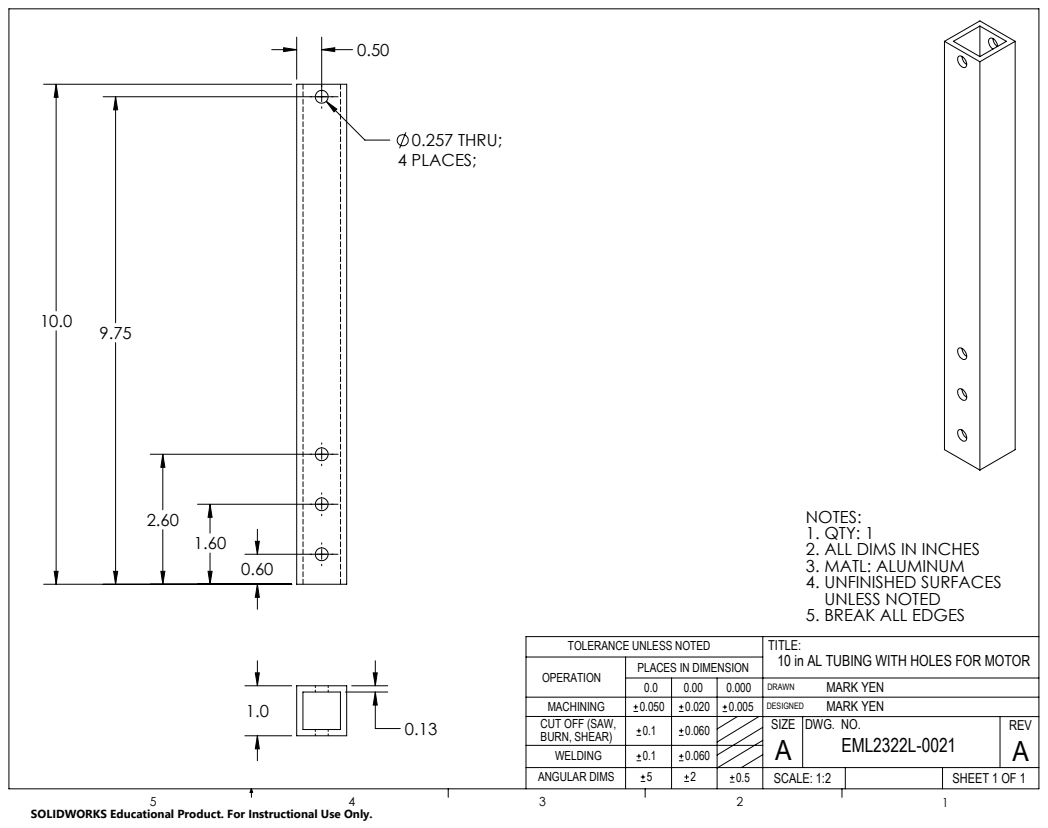
[picture p174: page 1]
0.257 THRU; 4 PLACES;; SHEET 1 OF 1; SCALE: 1:2

NOTES:
1. QTY: 1
2. ALL DIMS IN INCHES
3. MATL: ALUMINUM
4. UNFINISHED SURFACES
UNLESS NOTED
5. BREAK ALL EDGES
TITLE:
10 in AL TUBING WITH HOLES FOR MOTOR
MARK YEN
DWG. NO.

TOLERANCE UNLESS NOTED
OPERATION
MACHINING
CUT OFF (SAW,
BURN, SHEAR)
WELDING
ANGULAR DIMS

PLACES IN DIMENSION

SOLIDWORKS Educational Product. For Instructional Use Only.
