markyen001/DR4/Globe Motor Drawings/4.5 RPM Globe Gear Motor.pdf

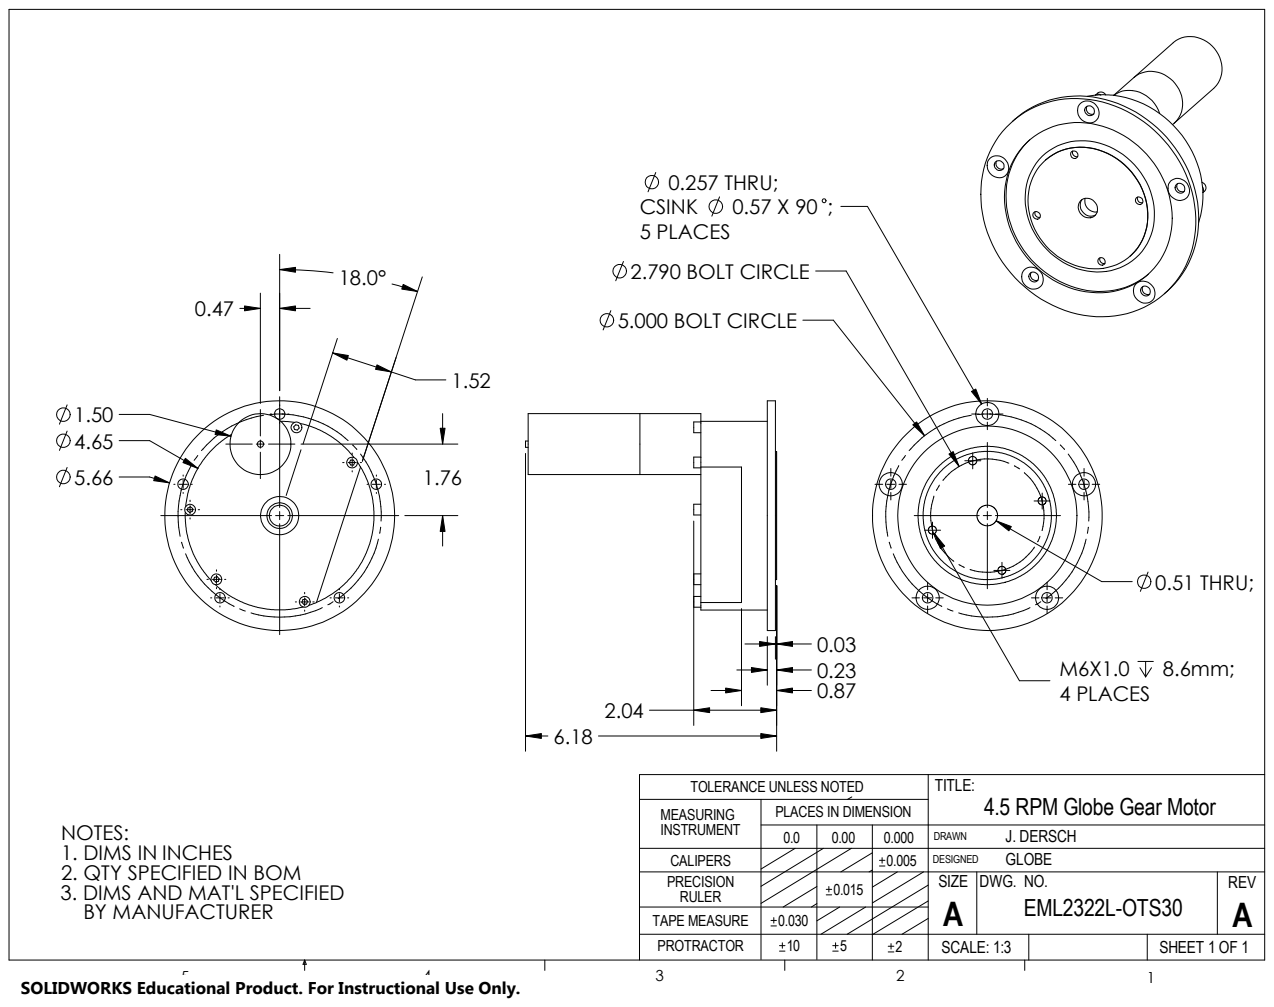
[picture p177: page 1]
2.790 BOLT CIRCLE; 5.000 BOLT CIRCLE; INCHES; 0.51 THRU;; 5 PLACES; 0.257 THRU; CSINK; 0.87 4 PLACES

TOLERANCE UNLESS NOTED | TITLE: 4.5 RPM Globe Gear Motor

MEASURING INSTRUMENT | PLACES IN DIMENSION

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

0.0 | 0.00 | 0.000 | DRAWN J. DERSCH

CALIPERS | | | 0.005 | GLOBE DESIGNED
PRECISION RULER | | 0.015 | | SIZE A EML2322L-OTS30 | DWG. NO. | REV A

TAPE MEASURE | 0.030

PROTRACTOR | 10 | 5 | 2 | SCALE: 1:3 | | SHEET 1 OF 1

SOLIDWORKS Educational Product. For Instructional Use Only.
