markyen001/DR4/Drawings for PRINT/7  LINEAR SLIDE.PDF

0.257 THRU; 4 PLACES; 80/20 LINEAR SLIDE; SHEET 1 OF 2; DWG. NO.; J. DERSCH 80/20 INC.; TAPE MEASURE; TOLERANCE UNLESS NOTED; SCALE: 1:1

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

PLACES IN DIMENSION

SOLIDWORKS Educational Product. For Instructional Use Only.

80/20 LINEAR SLIDE; SHEET 2 OF 2; DWG. NO.; J. DERSCH 80/20 INC.; TAPE MEASURE; TOLERANCE UNLESS NOTED; SCALE: 3:2

NOTES:
1. DIMS IN
2. QUANTITY:
3. DIMS AND MAT'L SPECIFIED
BY MANUFACTURER

PLACES IN DIMENSION

SOLIDWORKS Educational Product. For Instructional Use Only.
