markyen001/DR4/Part and Assembly Files/Drawing Templates/EML2322L OTS Part Drawing Template .pdf

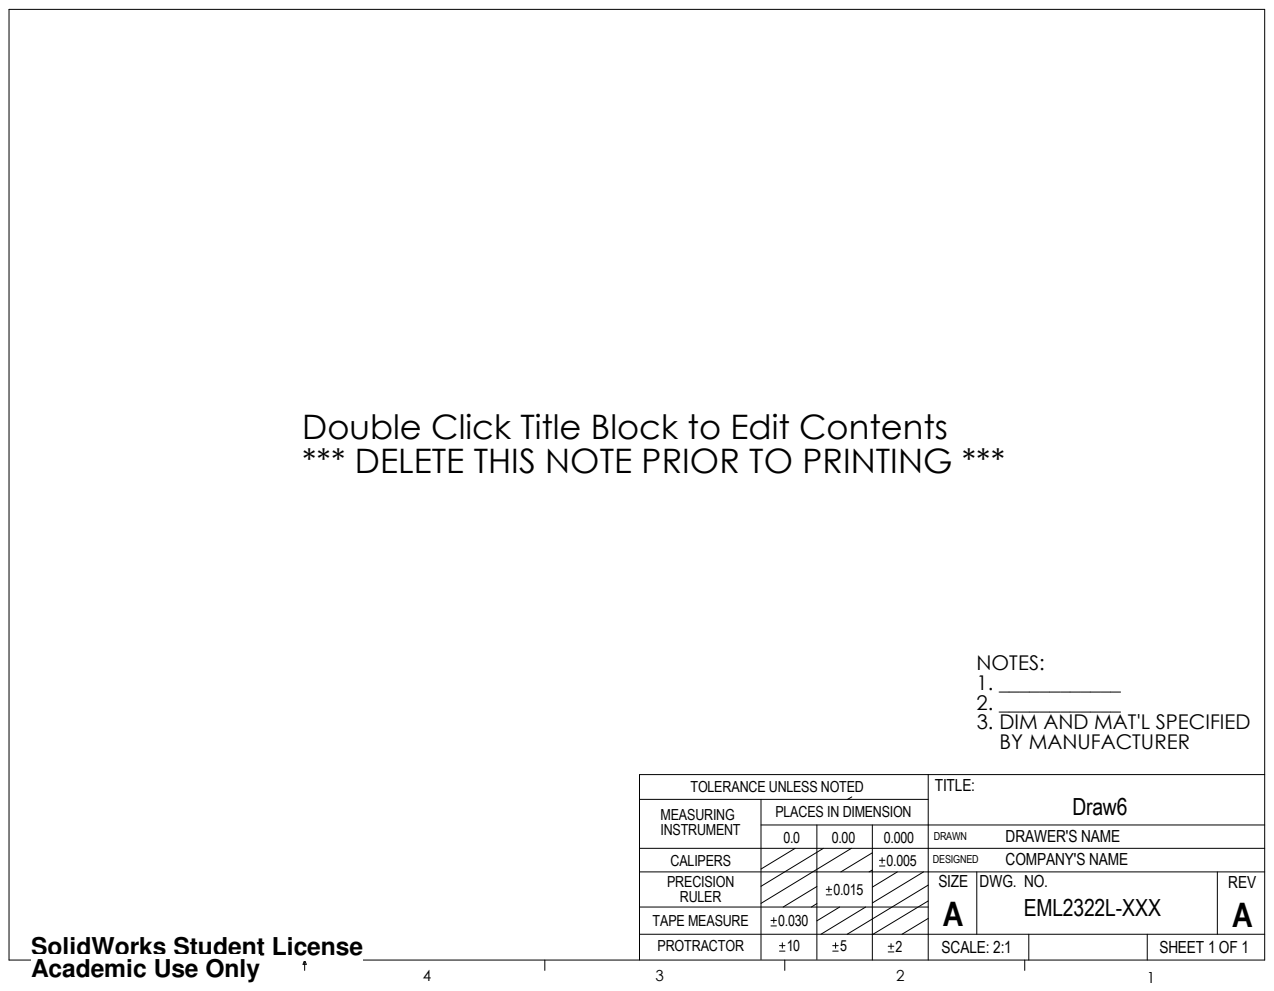
[picture p178: page 1]
BY MANUFACTURER; MEASURING; NOTES:

3. DIM AND MAT'L SPECIFIED ____________ Double Click Title Block to Edit Contents *** DELETE THIS NOTE PRIOR TO PRINTING ***

TOLERANCE UNLESS NOTED | TITLE: Draw6

INSTRUMENT | PLACES IN DIMENSION

0.0 | 0.00 | 0.000 | DRAWN DRAWER'S NAME

CALIPERS | | | 0.005 | COMPANY'S NAME DESIGNED
PRECISION RULER | | 0.015 | | SIZE A | DWG. NO. EML2322L-XXX | REV A

TAPE MEASURE | 0.030

SolidWorks Student License
Academic Use Only

PROTRACTOR | 10 | 5 | 2 | SCALE: 2:1 | | SHEET 1 OF 1
