markyen001/DR4/(commit log)

2018-10-13 Preparing files for dr4
    [0.25-20 Button Head Cap Screw (BHCS).SLDPRT, 0013 10-24 x 1.25 in PHILIPS HEAD SCREW.SLDPRT, 0019 BALL HOPPER.SLDDRW, 0019 BALL HOPPER.SLDPRT, 10 Inch Wheel.SLDPRT, 10-24 HEX NUT.SLDPRT, 10-24 Thread 0.25 Length Set Screw for Bucket Motor Shaft.SLDPRT, 10-24 Thread 0.5 Inch Length Screw for Motor Hub.SLDPRT]
2018-10-14 UPDATED 80/20 EXTRUSION - NOT COMPLETE
    [10-inch AL tube - with motor holes.SLDDRW, 10-inch AL tube - with motor holes.SLDPRT, 80-20 Extrusion 10 in.SLDPRT, 80-20 Extrusion DRAWING.SLDDRW, A013 HOPPER ASSEMBLY.SLDASM, Hopper and Bucket Manipulator Assembly.SLDASM, Template for Bill of Materials.SLDDRW]
2018-10-14 ECN3 COMPLETE - FOR NOW
    [80-20 Extrusion DRAWING.SLDDRW, BM Drawings.SLDDRW]
2018-10-14 80/20 DRAWING
    [30 IPM Spal Linear Actuator (2in).SLDPRT, 80-20 Extrusion DRAWING.SLDDRW, 80-20 Linear Slide.SLDPRT, 90272A540_ZINC-PLTD STL PAN HEAD PHILLIPS MACHINE SCREW.SLDPRT, BM 4.5in CLAW.SLDPRT, BM 5in CLAW.SLDPRT, BM 8020.SLDPRT, BM ARM CHANNEL GM SIDE.SLDPRT]
2018-10-14 DID LOTS OF WORK
    UPDATED FINAL ASSEMBLY AND ADDED CONFIGURATIONS TO GLOBE MOTOR ASSEMBLY
    [4.5 RPM Globe Gear Motor Face Hub.SLDPRT, A013 HOPPER ASSEMBLY.SLDASM, BM Claw SUBASM.SLDASM, BM MASTER ASM.SLDASM, FINAL TOTAL ASSEMBLY - ALL CONFIGURATIONS.SLDDRW, FINAL TOTAL ASSEMBLY - EXPLODE.SLDDRW, FINAL TOTAL ASSEMBLY - RETRACT.SLDDRW, FINAL TOTAL ASSEMBLY - STRETCH.SLDDRW]
2018-10-14 UPDATE
    updated the bucket manipulator assembly significantly. updated the rest of the assemblies as well. have not updated part numbers for existing parts.
    [15 RPM SEI Gear Motor.SLDDRW, 15 RPM SEI Gear Motor.SLDPRT, 90-DEGREE BRACKET ASSEMBLY.SLDASM, BM MASTER ASM.SLDASM, BUCKET GRABBER ASSEMBLY.SLDASM, BUCKET GRABBER EXTRUSIONS.SLDASM, Bucket Arm Hub.SLDDRW, Bucket Arm Hub.SLDPRT]
2018-10-14 redid template for BOM
    added 2 assemblies for the purposes of just creating a list. Will make calculations easier later.
    [10-24 HEX NUT.SLDPRT, 10-24 Thread 1.25 Length Socket Screw.SLDPRT, 10-24 thread 1.25 length flat head screw.SLDPRT, 4.5 RPM Globe Gear Motor Face Hub.SLDPRT, 4.5 RPM Globe Gear Motor.SLDPRT, 80-20 Extrusion - List.SLDASM, 80-20 Extrusion 5 inch (simplified).SLDPRT, 80-20 Extrusion DRAWING.SLDDRW]
2018-10-14 updated 80/20 drawings
    [80-20 Extrusion DRAWING.SLDDRW]
2018-10-15 updated drawings
    [80-20 Extrusion DRAWING.SLDDRW]
2018-10-15 COMPLETED ECN 2-4
    [4.5 RPM Globe Gear Motor Assembly.SLDASM, 4.5 RPM Globe Gear Motor Face Hub.SLDPRT, 4.5 RPM Globe Gear Motor Specs.SLDDRW, 4.5 RPM Globe Gear Motor.SLDDRW, 4.5 RPM Globe Gear Motor.SLDPRT, Template for Bill of Materials.SLDDRW, Wheel Hub.SLDDRW, Wheel Hub.SLDPRT]
2018-10-15 ECN 5 COMPLETE
    [0019 BALL HOPPER.SLDDRW, 0019 BALL HOPPER.SLDPRT, 4.5 RPM Globe Gear Motor.SLDDRW, GM ASM.SLDASM, Template for Bill of Materials.SLDDRW]
2018-10-15 all ecns complete
    [80-20 Extrusion - List.SLDASM, 80-20 Extrusion 10 in.SLDPRT, 80-20 Extrusion 12.5 inch (simplified).SLDPRT, 80-20 Extrusion 3 inch (simplified).SLDPRT, 80-20 Extrusion 5 inch (simplified).SLDPRT, 80-20 Extrusion 7 inch (simplified).SLDPRT, 80-20 Extrusion 8 inch (simplified).SLDPRT, 80-20 Extrusion 8.5 inch (simplified).SLDPRT]
2018-10-16 true scale file
    [0019 BALL HOPPER True Scale.SLDDRW, 0019 BALL HOPPER.SLDPRT]
2018-10-16 fixed ball hopper assembly
    [0019 BALL HOPPER.SLDPRT, A013 HOPPER ASSEMBLY.SLDASM, Hopper and Bucket Manipulator Assembly.SLDASM]
2018-10-18 updated ECN 2
    [Wheel Hub.SLDDRW]
2018-10-18 updated mobileplatform frame
    [MOBILE PLATFORM FRAME.SLDASM, MOBILE PLATFORM FRAME.SLDDRW]
2018-10-18 UPDATED MOBILE PLATFORM WITH WHEELS
    [Caster Wheel.SLDPRT, MOBILE PLATFORM FRAME.SLDASM, PLATFORM WITH WHEELS.SLDASM, PLATFORM WITH WHEELS.SLDDRW]
2018-10-18 UPDATED BUCKET GRABBER
    [BUCKET GRABBER ASSEMBLY.SLDASM, Corrected bucketgrabber 2.SLDDRW]
2018-10-18 UPDATED BUCKET GRABBER ASSEMBLY TOTAL
    [Bucket Manipulator Total Assembly.SLDASM, Bucket Manipulator Total Assembly.SLDDRW]
2018-10-18 UPDATED HOPPER AND GRABBER ASSEMBLY AND DRAWINGS
    [10-24 thread 1.25 length flat head screw.SLDPRT, HOPPER AND BUCKET ASSEMBLY.SLDDRW, Hopper and Bucket Manipulator Assembly.SLDASM]
2018-10-18 UPDATED PLATFORM WITH STUFF ASSEMBLY
    [Platform Wheels Box Hopper Bucket Assembly.SLDDRW]
2018-10-18 UPDATED EVERYTHING
    FINAL TOTAL ASSEMBLY
    [FINAL TOTAL ASSEMBLY - ALL CONFIGURATIONS.SLDDRW]
2018-10-25 UPDATE ECN 9
    [80-20 Extrusion - List.SLDASM, 80-20 Extrusion DRAWING.SLDDRW]
2018-10-25 UPDATE ECN 10
    [80-20 Extrusion - List.SLDASM, 80-20 Extrusion 4.5 inch.SLDPRT, 80-20 Extrusion DRAWING.SLDDRW]
2018-10-25 UPDATED ECN 11 AND 12
    [80-20 Extrusion - List.SLDASM, 80-20 Extrusion 11 in.SLDPRT, 80-20 Extrusion DRAWING.SLDDRW]
2018-10-25 reassembled claw assembly
    [30 IPM Spal Linear Actuator (2in).SLDPRT, A013 HOPPER ASSEMBLY.SLDASM, BM Claw SUBASM.SLDASM, BM MASTER ASM.SLDASM, Hopper and Bucket Manipulator Assembly.SLDASM]
2018-10-25 added new explode views to claw assembly
    [BM Claw SUBASM.SLDASM]
2018-10-25 UPDATED HOPPER AND TOTAL ASSEMBLY
    [30 IPM Spal Linear Actuator (2in).SLDPRT, 4.5 RPM Globe Gear Motor Face Hub.SLDPRT, 4.5 RPM Globe Gear Motor.SLDPRT, 80-20 Extrusion 11 in.SLDPRT, 90-DEGREE BRACKET ASSEMBLY.SLDASM, 90272A539_ZINC-PLTD STL PAN HEAD PHILLIPS MACHINE SCREW.SLDPRT, 90272A540_ZINC-PLTD STL PAN HEAD PHILLIPS MACHINE SCREW.SLDPRT, 91251A249_BLACK-OXIDE ALLOY STEEL SOCKET HEAD SCREW.SLDPRT]
2018-10-25 Added Drawings for ECNs 9 through 13
    [80-20 Extrusion - List.SLDASM, 80-20 Extrusion DRAWING.SLDDRW]
2018-10-25 UPDATED ECNS
    [0019 BALL HOPPER.SLDDRW, BM Drawings.SLDDRW]
2018-10-30 UPDATED GLOBE MOTOR SCREWS
    [0013 10-24 x 1.25 in PHILIPS HEAD SCREW.SLDPRT, 10-24 1 in FLAT HEAD SCREW.SLDPRT, 10-24 thread 1.25 length flat head screw.SLDPRT, 10-24 x 3-8 Socket Screw for Mount.SLDPRT, A014.SLDDRW, Hopper and Bucket Manipulator Assembly.SLDASM, Template for Bill of Materials.SLDDRW]
2018-10-30 UPDATED HOPPER ASSEMBLY
    [90-DEGREE BRACKET ASSEMBLY.SLDASM, A013 HOPPER ASSEMBLY.SLDASM, BUCKET GRABBER EXTRUSIONS.SLDASM, GM ASM.SLDASM, HOPPER AND BUCKET ASSEMBLY.SLDDRW, Hopper and Bucket Manipulator Assembly.SLDASM, STRAIGHT BRACKET ASSEMBLY.SLDASM, hopper assembly.SLDDRW]
2018-10-30 EDITED FINAL ASSEMBLY DRAWINGS
    [MOBILE PLATFORM EXTRUSIONS.SLDASM, Wheel and Motor Total Assembly.SLDASM]
2018-10-30 SMALL UPDATES
    [10-24 1 in FLAT HEAD SCREW.SLDPRT, HOPPER AND BUCKET ASSEMBLY.SLDDRW, Template for Bill of Materials.SLDDRW]
2018-10-30 Update Part and Assembly Files/Platform Wheels Box Hopper Bucket Assembly.SLDDRW
    [Platform Wheels Box Hopper Bucket Assembly.SLDDRW]
2018-10-30 Update Part and Assembly Files/Platform with Wheels and Control Box.SLDDRW
    [Platform with Wheels and Control Box.SLDDRW]
2018-11-01 ADJUSTED BUCKET GRABBER
    [80-20 Extrusion - List.SLDASM, 80-20 Extrusion 6 in.SLDPRT, 80-20 Extrusion 8 inch (simplified).SLDPRT, 80-20 Extrusion DRAWING.SLDDRW, BUCKET GRABBER ASSEMBLY.SLDASM, BUCKET GRABBER EXTRUSIONS.SLDASM, Bucket Manipulator Total Assembly.SLDASM, GM Mounting SUBASM.SLDASM]
2018-11-01 UPDATED BUCKET GRABBER AND CONFIGURATIONS
    [BM MASTER ASM.SLDASM, BUCKET GRABBER ASSEMBLY.SLDASM, BUCKET GRABBER EXTRUSIONS.SLDASM, Bucket Manipulator Total Assembly.SLDASM, GM ASM.SLDASM, Hopper and Bucket Manipulator Assembly.SLDASM]
2018-11-03 minor change
    [80-20 Extrusion DRAWING.SLDDRW]
2018-11-03 minor screw name changes
    [10-24 1 in FLAT HEAD SCREW.SLDPRT, BM MASTER ASM.SLDASM, Template for Bill of Materials.SLDDRW]
2018-11-03 MINOR NAME CHANGES
    [0.25-20 x 1 in FLAT HEAD SCREW.SLDPRT, 10-24 1 in FLAT HEAD SCREW.SLDPRT, 90-DEGREE BRACKET ASSEMBLY.SLDASM, A013 HOPPER ASSEMBLY.SLDASM, BM Claw SUBASM.SLDASM, BM Mounting SUBASM.SLDASM, BUCKET GRABBER ASSEMBLY.SLDASM, BUCKET GRABBER EXTRUSIONS.SLDASM]
2018-11-03 removed unneccessary files
    [10-24 Thread 0.25 Length Set Screw for Bucket Motor Shaft.SLDPRT, 10-24 thread 1.25 length flat head screw.SLDPRT, Template for Bill of Materials.SLDDRW]
2018-11-03 removed al tubing files
    [10-inch AL tube - no motor holes.SLDDRW, 10-inch AL tube - no motor holes.SLDPRT, 11-inch AL tube - no motor hole.SLDDRW, 11-inch AL tube - no motor hole.SLDPRT, 11-inch AL tube - with motor hole.SLDDRW, 11-inch AL tube - with motor hole.SLDPRT, Template for Bill of Materials.SLDDRW]
2018-11-03 small edits to caster wheel
    [Caster Wheel.SLDDRW]
2018-11-06 UPDATED ECN
    [80-20 Extrusion DRAWING.SLDDRW, Bucket Manipulator Total Assembly.SLDDRW]
2018-11-08 UPDATED BALL HOPPER
    [0019 BALL HOPPER.SLDDRW, 0019 BALL HOPPER.SLDPRT]
2018-11-09 UPDATED ASSEMBLIES RELATED TO BALL HOPPER
    [0019 BALL HOPPER.SLDDRW, A013 HOPPER ASSEMBLY.SLDASM, A014.SLDDRW, Hopper and Bucket Manipulator Assembly.SLDASM, Platform Wheels Box Hopper Bucket Assembly.SLDDRW, hopper assembly.SLDDRW]
2018-11-15 added wiring schematic
2018-11-15 did wiring plan
2018-11-22 minor changes to part name
    [80-20 Extrusion - List.SLDASM, 80-20 Extrusion 11 in.SLDPRT, 80-20 Extrusion DRAWING.SLDDRW, A013 HOPPER ASSEMBLY.SLDASM, Hopper and Bucket Manipulator Assembly.SLDASM, Template for Bill of Materials.SLDDRW]
2018-11-22 GETTING READY FOR PRINT
    [80-20 Extrusion - List.SLDASM]
2018-11-22 major changes to bucket grabber and mobile platform
    [80-20 Extrusion DRAWING.SLDDRW, 90-DEGREE BRACKET ASSEMBLY.SLDASM, BUCKET GRABBER ASSEMBLY.SLDASM, BUCKET GRABBER EXTRUSIONS.SLDASM, BUCKET GRABBER EXTRUSIONS.SLDDRW, BUCKET MANIPULATOR ASSEMBLY.SLDDRW, Bucket Manipulator Total Assembly.SLDASM, Hopper and Bucket Manipulator Assembly.SLDASM]
2018-11-23 ADDED 2 MORE DRAWINGS
    [80-20 Straight Degree Bracket Assy.SLDDRW, 90 degree both parallel.SLDDRW, Template for Bill of Materials.SLDDRW]
2018-11-23 added more drawings
    [BUCKET MANIPULATOR ASSEMBLY.SLDDRW, Bucket Manipulator Total Assembly.SLDDRW]
2018-11-23 MORE STUFF
    [Caster Wheel.SLDDRW, MOBILE PLATFORM FRAME ASSEMBLY.SLDDRW, Wheel and Motor Total Assembly.SLDDRW]
2018-11-23 MANY CHANGES
    [BM MASTER ASM.SLDASM, Bucket Manipulator Total Assembly.SLDASM, FINAL TOTAL ASSEMBLY - ALL CONFIGURATIONS.SLDDRW, GM ASM.SLDASM, Hopper and Bucket Manipulator Assembly.SLDASM, RUBBER PADS.SLDDRW, RUBBER PADS.SLDPRT, TITANIUM COUNTERWEIGHT.SLDDRW]
2018-11-24 MORE DRAWINGS
    [FINAL TOTAL ASSEMBLY - ALL CONFIGURATIONS.SLDDRW]
2018-11-24 BM Drawings Exported To PDF (PRINTED FOLDER)
2018-11-24 ADDED FINAL ASSEMBLY DRAWINGS
    [BM MASTER ASM.SLDASM, FINAL TOTAL ASSEMBLY - ALL CONFIGURATIONS.SLDDRW]
2018-11-24 added more documents
    [Assembly BOM.xls, Part BOM.xls, Template for Bill of Materials.SLDDRW]
2018-11-27 Final push
    [BM Drawings.SLDDRW]
